Quietmirror/github/README.md

# Quietmirror · Fenrir / MiniSE R3.3（r3_3）

**当前版本：R3.3，版本标识 `r3_3`。** 本版将上一轮 L2 研究成果按 R3 系列目录公开归档，包含共用机械版、H 分体 PAW3950 示意版和 D ATK A1 Pro 供体示意版。

**[R3.3 全部下载与说明](releases/Fenrir-MiniSE-R3.3/README.md)** · [设计与验证报告](reports/rebuild_r3_3/README.md) · [可编辑源码](cad/rebuild_r3_3/README.md) · [本版记录](HISTORY_R3_3.md)

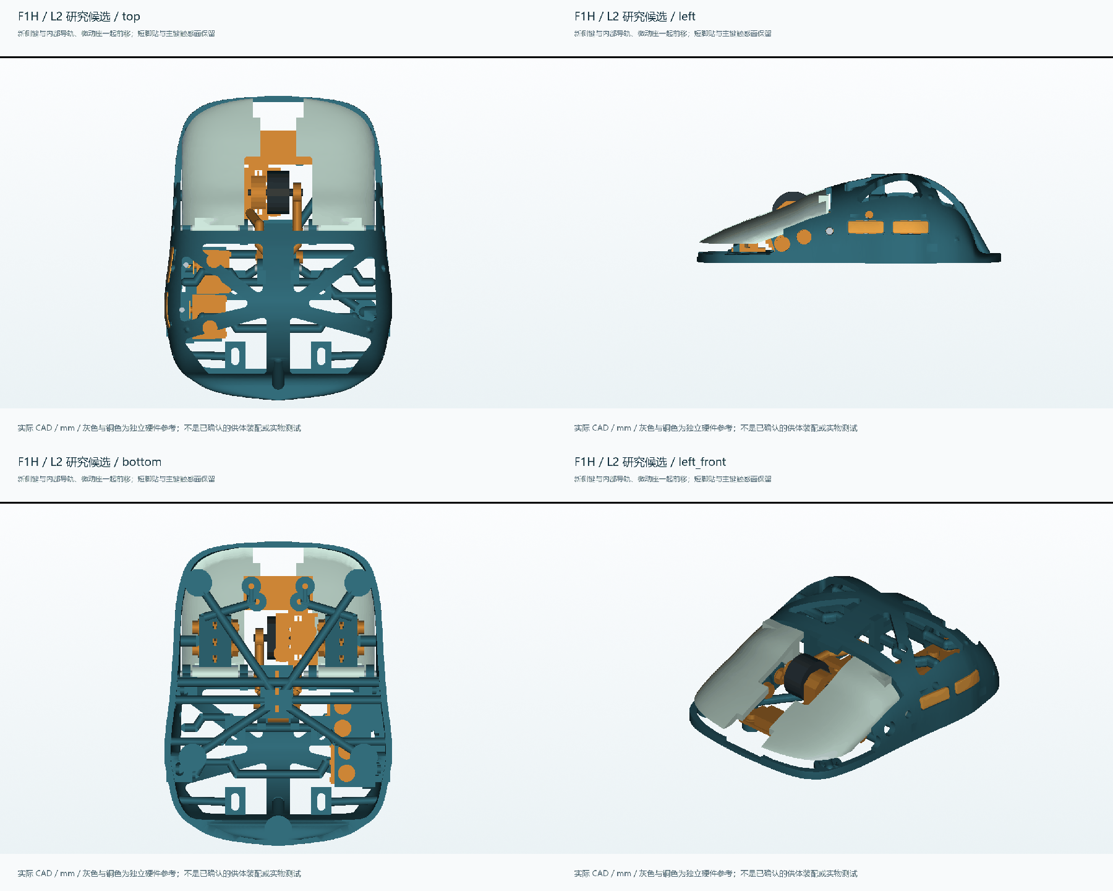
[picture p1: views/rebuild_r3_3/R3_3_FOUR_VIEWS.png]
R3.3 实际 CAD


| 内容 | 共用机械版 | H 示意版 | D 示意版 |
|---|---|---|---|
| 全部打印件 STL | [9 件 STL](releases/Fenrir-MiniSE-R3.3/R3_3_PRINT_STL.zip) | [11 件 STL](releases/Fenrir-MiniSE-R3.3/R3_3_H_EST_PRINT_STL.zip) | [11 件 STL](releases/Fenrir-MiniSE-R3.3/R3_3_D_EST_PRINT_STL.zip) |
| FreeCAD 装配 | [FCStd](releases/Fenrir-MiniSE-R3.3/FENRIR_MINISE_R3_3.FCStd) | [H FCStd](releases/Fenrir-MiniSE-R3.3/FENRIR_MINISE_R3_3_H_EST.FCStd) | [D FCStd](releases/Fenrir-MiniSE-R3.3/FENRIR_MINISE_R3_3_D_EST.FCStd) |
| STEP 零件 | [STEP](releases/Fenrir-MiniSE-R3.3/R3_3_STEP.zip) | [H STEP](releases/Fenrir-MiniSE-R3.3/R3_3_H_EST_STEP.zip) | [D STEP](releases/Fenrir-MiniSE-R3.3/R3_3_D_EST_STEP.zip) |
| 实际切片 3MF | [共用拼版](releases/Fenrir-MiniSE-R3.3/FENRIR_MINISE_R3_3_PLA_PRINT_PLATE.3mf) | [H 拼版](releases/Fenrir-MiniSE-R3.3/FENRIR_MINISE_R3_3_H_EST_PLA_PRINT_PLATE.3mf) | [D 拼版](releases/Fenrir-MiniSE-R3.3/FENRIR_MINISE_R3_3_D_EST_PLA_PRINT_PLATE.3mf) |

[两套转接件合板](releases/Fenrir-MiniSE-R3.3/R3_3_BOTH_ADAPTER_KITS_SINGLE_PLATE.3mf) · [源码 ZIP](releases/Fenrir-MiniSE-R3.3/R3_3_SOURCE.zip) · [验证报告 ZIP](releases/Fenrir-MiniSE-R3.3/R3_3_VALIDATION_REPORTS.zip) · [43 份研究历史和基准恢复包](releases/Quietmirror-L2-Research/history/README.md)

R3.3 沿用已生成的 L2 几何与检查结果，内部 F1H / L2_H_EST / L2_D_EST 编号保留用于追溯。**14.89 g 减重目标未达到，共用塑料理论质量 18.99951 g PA12；H 托架装入路径尚未通过；D 供体板型未知，估计测量板有 17 对干涉。** 真实点击、打印公差、板卡/镜头适配、无线 1K、宏、LOD、充电及续航未完成实测。完整边界见上方报告。

历史版本：[R3.2](README_R3_2.md) · [R3.1](README_R3_1.md) · [R3](README_R3.md) · [R2](README_R2.md) · [更早历史](HISTORY.md)。旧版本、原始 L2 报告与历史候选继续保留。

许可 [CERN-OHL-P-2.0](LICENSE)，保留[原署名](NOTICE.md)与[R3.2 署名](reports/rebuild_r3_2/NOTICE_R3_2.md)。
