Quietmirror/github/reports/V0.1_设计与验证报告.md

# Quietmirror 右手指握鼠标 V0.1 — 设计与验证

日期：2026-10-14。交付范围为可打印的一体式固定试握件及可编辑源文件；电子装配版尚未设计完成。所有图为真实 CAD/STL 或真实切片刀路的可视化。

## 试握假设与形态

用户提供的手部数据来自照片 AR 近似测量：腕到中指尖约230 mm，拇指尖到小指尖张开跨度约190 mm。后者不是掌宽或鼠标握宽。掌宽、指节长、自然握姿仍未知，没有补造数值，也未以手长驱动整体缩放。

| 项目 | V0.1 参数/实现 |
|---|---|
| 总长 × 最大外宽 × 高 | 90 × 62 × 31 mm，不含脚贴 |
| 有效夹持宽度 | 接触区中心目标约54 mm；两侧浅凹边缘更宽 |
| 左右主键 | 各24.4×40 mm连续浅凸面，球面R95；左顶31、右顶29.8 |
| 滚轮触感件 | Ø15×5.2，中心距前端15.5，顶点31；与骨架连接且固定 |
| 拇指区 | 长42×高19，中心距前端46、高13.6；浅凹R95 |
| 无名指/小指区 | 长46×高19，中心距前端46、高12.6；浅凹R110 |
| 两个侧键触感凸台 | 距前端33/47，高21.5，前后长10.5，中心距14 |
| 右侧防拖地托边 | 宽6、长34、厚2.8，外缘到X=31；圆角R1.2 |
| 后段 | 后部没有中央顶掌拱壳，最后约20 mm只保留最高约7.4 mm的低骨架 |
| 普通薄壁/边缘 | 法向壁厚1.8；接触外围加厚至2.4以容纳R1圆角 |
| 承力筋 | 三维筋Ø2.8；底框筋2.6宽×2.6高 |
| 接点局部加强 | 筋端埋入内侧小垫，局部总厚约3.9；不穿出主要指肚接触面 |
| 脚贴平台 | 5个Ø8.8，厚2.4，适配约Ø7–7.5圆点脚贴 |
| 传感器定位区 | 中心(0,-48)，14×18圆角开口及连续定位框；无假定安装孔 |

主键、侧键、滚轮、两侧面、五脚平台和所有骨架已经并成一个实体。主接触面没有减重开孔，开放区在接触面之间和下方。夹持面通过多根承力筋、内垫和连续底框传力；主键有三点支撑与侧向连接，滚轮有固定轴及成对支撑。

这是一体试握结构，固定支柱、轮轴和侧键连接不能作为后续真实开关或转轴机构直接使用。装配版需重新设计这些受力路径，同时保留足够刚度。

## 实际几何与网格检查

检查对象是最终保存后重新读取的 STEP/STL，不只检查建模内存对象。完整数值见 `validation.json`、`cad_metrics.json`。

| 检查 | 结果 |
|---|---|
| STEP / OpenCascade B-rep | 有效，1个实体 |
| STEP 外接尺寸 X/Y/Z | 62.000 / 90.000 / 31.000 mm |
| STL 连通分量 | 1 |
| STL 封闭/法向 | watertight=true，winding consistent=true |
| 自相交 | PyMeshLab 检测0个自相交面 |
| 边界边 / 非流形边 / 非流形顶点 | 0 / 0 / 0 |
| 网格孔洞 | 0；模型的设计开放窗口具有封闭的材料边界，不是网格破洞 |
| 网格面数 / 顶点数 | 179,008 / 89,462 |
| PrusaSlicer 读入尺寸 | X61.999168、Y89.999992、Z31.000000 mm |
| PrusaSlicer 流形 / 部件数 | yes / 1 |
| 主体CAD体积 | 14,704.307 mm³ = **14.704 cm³** |
| STL近似体积 | 14,694.744 mm³，与CAD相差约0.065% |
| 底部开放 | Z=0.2 mm截面，实体面积1007.26 mm²；相对XY外凸包4822.83 mm²，约**79.1%开放** |

STL 使用0.02 mm绝对弦差、0.15弧度角差细分；导出后只焊接约0.00001 mm尺度的数值重合点，移除重复/退化面，没有补网格孔、没有丢弃孤立部件、没有用自动修补掩盖断开结构。

**最薄壁核对：** 普通曲面区域由同心球面构成，设计法向厚度为1.8 mm。左右主键与两侧接触区共60点法向射线测量，最小1.7962、最大3.9090 mm；增加的厚度来自接点内垫等加强结构。最小值与网格细分误差相符。这是解析设计值加接触区抽样检查，**不是对任意圆角、交线和整个实体做连续全域最小厚度证明**。没有进行有限元或破坏载荷试验；正常夹持下的实际挠度仍应在首件记录。

**五脚共面核对：** 每个平台取中心与半径3.7 mm圆周上8点，共45个点，最终STL的安装面读数均为Z=0.000 mm。五个平台的CAD中心如下；底框也有Z=0底面，粘贴脚贴后由五个圆点抬高整件，不能把底框当成额外脚贴平台。

| 平台 | X | Y | 安装面 Z |
|---|---:|---:|---:|
| 1 左前 | -21 | -8 | 0 |
| 2 右前 | 21 | -8 | 0 |
| 3 左后侧 | -23 | -61 | 0 |
| 4 右后侧 | 25 | -63 | 0 |
| 5 尾部 | 0 | -85.6 | 0 |

打印翘曲、首层挤压和脚贴厚度误差不属于CAD共面检查；粘贴后需放平板检查是否摇晃。

## 参数与复现

长度、外宽、握宽、高度、左右键接触区、滚轮、两个侧键和传感器参考位置均由 `cad/parameters.json` 驱动；细节见 `cad/PARAMETERS.md`。参数Y为距前端正距离，导出后转成朝前为正的CAD坐标，避免左右手方向含混。

另做了一次邻近参数组合检查：长94、外宽64、高32、握宽56，同时移动主键、滚轮、侧键；得到有效单一实体及64×94×32外接尺寸。该检查未生成供打印的另一个版本，不代表所有参数组合都有效。当前交付默认值仍是90×62×31、握宽54。

## 打印与材料

打印姿态：**五脚贴安装面向下，100%比例，前端/左右方向不镜像。** 用PLA首轮试握，0.4 mm喷嘴、0.2 mm层高；4道周壁、20%填充、5层顶底。主要薄壁和细筋在该设置下基本由周壁/实心路径构成，降低填充百分比不会等比例减重。

支撑：从热床生成树状支撑，阈值45°，支撑顶部间距0.2 mm、XY间距0.35 mm、3层界面。支撑目标是两个主键底面、固定滚轮/轮轴、侧键凸台与托边下缘；4 mm外裙边帮助低框架贴床。实际支撑刀路见 `../views/09_slice_layers.png`。从大窗口去支撑时，保护本体Ø2.8承力筋，侧键/滚轮不掰动。

PrusaSlicer 2.9.6 的最终实际切片结果如下，PLA密度取1.24 g/cm³、线径1.75 mm；这些不是实物称重。

| 项目 | 估算 |
|---|---:|
| 模型本体刀路 | **18.528 g** |
| 支撑及支撑界面 | **13.476 g** |
| 裙边 | **0.265 g** |
| 切片器总耗材 | **32.27 g**，10.819 m，26.02 cm³ |
| 时间 | **4 h 11 min 19 s**（通用速度/机器约束下） |
| 几何体积×PLA密度 | 约18.23 g，用于与刀路估重交叉比较 |

刀路质量估算与几何体积×密度略有差异，受线宽、搭接和切片流量计算影响。总耗材包括支撑，不包含脚贴、胶、电子件或失败重打。耗时取决于真实打印机的加速度、限速和冷却。交付3MF附完整估算配置，并已在不外加载入INI的情况下重新切片核对；打印前仍应选择实际机型。

## 电子版前置条件

本轮已分别建立主板、传感器/镜头、滚轮/编码器、两侧键板、电池/插头、走线、USB-C、电源开关、天线等16个包络；除引用裸板外框外均为估计，全部位置待实测。主要冲突与后续尺寸表见 [电子包络与装配待测](电子包络与装配待测.md)。

PAW3950仅是传感器型号，不决定统一主板轮廓。2.4 GHz无线1000 Hz由主板、固件和匹配接收器共同实现。候选“ATK 蜻蜓 A1 Plus”的真实型号、传感器与板形尚未确认，没有替换成其他型号或假定其传感器为PAW3950。

首件完成后按 [试握反馈表](试握反馈表.md) 记录握宽、顶掌、手指拖地、滚轮/侧键触达和抬鼠稳定性。先修正握持几何，再获得真实电子尺寸并做装配版，之后逐轮减薄；本轮没有真实点击、回弹、传感器或无线功能验收。
