Quietmirror/github/reports/l2_revision/calculation_audit.md

# L2 基准与计算复核

当前读取 R3.2 的实际 STEP 和 STL，未把任务书数值当作新验证结果。

|零件|CAD 体积 mm³|PA12 理论 g|PLA 实心理论 g|
|---|---:|---:|---:|
|BODY|12801.728064|12.929745|15.874143|
|LEFT_KEY|1780.447791|1.798252|2.207755|
|RIGHT_KEY|1780.448016|1.798252|2.207756|
|SIDE_FRONT_KEY|167.916224|0.169595|0.208216|
|SIDE_FRONT_KEY_SWITCH_CLAMP|192.883541|0.194812|0.239176|
|SIDE_REAR_KEY|176.712184|0.178479|0.219123|
|SIDE_REAR_KEY_SWITCH_CLAMP|192.883541|0.194812|0.239176|
|WHEEL|823.761827|0.831999|1.021465|
|WHEEL_CARRIER|589.894911|0.595794|0.731470|

总计 18506.676100 mm³，PA12 假设密度 1.01 下 18.691743 g；PLA 假设密度 1.24 下 22.948278 g。均非含支撑的切片用量。
L2 目标需净减少 3764.102 mm³ / 3.801743 g (20.34%)。

七根理想圆柱梁毛体积 1544.045 mm³，未扣交叠，不是可删除净体积。

历史二维模拟缺少完整边界与网格定义，无法按任务书唯一复现。旧 6.6%/10.3% 刚度改善仅保留为待复核先导，不作 L2 强度证据。
原 CAD 孔轮廓已有 R0.85 圆角；按源多边形复算尖角联合面积 1301.271 mm²，二维 R0.85 内圆角后 1292.284 mm²。须与任务书的 1301.27 mm² 区别。

实际打印前还需公差小样、按键偏心/回弹、疲劳和真实硬件测量。
