Quietmirror/github/reports/l2_revision/FENRIR_SIDE_KEY_REDESIGN.md

# 顺形双侧键与内部机构

F1H使用F1低突出造型：接触面10.4×3.6mm、中心Y49/62、Z15.5、间隔2.6mm；母壳法向抽样最大突出约0.193mm。相对R3.2，面更低、更贴壳，长度稍增，前后位置各前移0.3mm；与任务书“细长低突出”路线一致。下方连续拇指面保留。F2E为10.4×4.0、约0.31mm突出、3°轮廓斜度的另一真实完整方案，保留研究文件。

微动、导轨、捕获销、夹条一起移动；不是单改键帽。导轨有效长度5.4mm，全行程最小啮合5.1mm，原参考约3.5mm。两键独立滑动0.60mm，接触轴线投影约0.58mm。实际开关自由高、预行程与过行程待测，0.02mm间隙不能作为普通FDM免调整承诺。

每键前/中/后1.5N有限元三网格，最弱位置刚度提高；部分旧后缘支点位置更硬，不能说每一位置均改善。约束为无摩擦双面导轨及刚性微动接触；真实偏心卡滞、回弹、磨耗需要实物。简化两导轨反力模型给摩擦/驱动力比例约2μe/L，取e约3.3mm、L5.1mm，μ0.1/0.2/0.3/0.4时约0.13/0.26/0.39/0.52；只是敏感性示意，μ未测且不覆盖毛刺/收缩/斜插。

两键直线X向装入各101位置通过。侧微动改从底部装入，前微动先、后微动后，然后后夹条先、前夹条后。完整18阶段有限采样通过。螺丝旋入、工具握柄和连续扫掠未完全证明；不能声称不存在任何真实装配冲突。
