Quietmirror/github/reports/l2_revision/HARDWARE_H_D_COMPATIBILITY.md

# H/D电子空间与功能边界

H首先实际试放从badjeff/paw3395-pcb读取外轮廓的15.45×28×1.6板包络，在原壳内失败，完整记录留在L2_H_REFERENCE_BOARD_BLOCKED。当前H改为**18×18×1.6自定义紧凑传感器板的设计需求**，这需要另做电路或找到已核实的板，不是宣称参考板已缩小适配、更不是已采购的半组装模块。RF/电池/天线/线束同样为估计。D仅提供可换载架与36×50×1.2空间测量板，绝不是实测ATK A1 Pro。

| 方案 | 未允许静态冲突数 | 底部直入支架采样通过 | 真实主板适配证明 |
|---|---|---|---|
| L2_H_EST | 0 | False | 否 |
| L2_D_EST | 17 | False | 否 |

完整干涉对与原生交叠体积在各版本static_checks.json，净空和支架路径在module_review.json。H当前最终姿态静态及按键有限运动采样通过；但从底部以及其余五个直线方向插入托架仍失败，须继续把支架拆为可连接小件或验证旋转装入路径。没有证明绝对无法装入，也没有伪称可装配。H天线净空内仍有约74.92mm³塑料托架和4.58mm³馈线；馈线本属必要天线连接，介质影响要按真实天线测试。D的17个未允许交叠全部涉及未知板测量块，其电池服务区也不通过。

旧通用耳的连接臂部分填回了名义槽孔，M2螺钉实放失败。新托架改为非永久的绝缘束带鞍座，不改动common壳；束带、PCB边缘固定和实际元件禁布区尚未验证。当前装配与3MF是研究示意，未知板不放行“已适配打印”。

PAW3950仅是传感器型号。400–6400DPI、2.4GHz1k、宏、LOD、五键、低延迟、无可选同步、充电和12h续航均需PCB/固件/接收器证据。保持原供电保护，不新加外部DPI或独立拨动开关；选定系统必须提供合适电源控制。

电池18×22×6是包络而非容量保证。按可用容量75%情景，300/400/500mAh要持续12h，平均电流上限18.75/25/31.25mA。最大功耗实测、截止电压、容量与温度均未知，不能宣称达标。光轴垂直鼠标垫；Z7.8镜头底、Z5.2脚贴面、0.5脚贴仅给出3.1mm示例光学间距，最终必须按真实镜头尺寸链调整。
