Quietmirror/github/cad/l2_revision/MASTER_SPEC.md

# Quietmirror R3.2 → L2 均衡轻量化版｜Codex 完整工程任务书

**制定日期：2026-10-16（合并本日下午 12:00 后全部讨论、计算、方案与后续约束）**  
**使用对象：已经构建 Quietmirror R3.2 的原 Codex 工作区 / GPT-6 Astra 或 GPT-6.1 Sol**  
**项目仓库：** https://github.com/Quietmirror/github  
**基准提交（截至本次重新读取）：** `f1b1090931d717117287ea2b79c2e14ddc234937`，`main`，R3.2  
**本文件定位：可直接执行的工程规格书 + 全部已知原始数据 + 复核协议，不是已完成的 R4 CAD 或三维有限元认证。**

> **给执行 Codex 的首要指令：** 继续当前本地工作区的项目，不要重新建项目。读取 Git 状态并同步/检查最新版本，保护所有尚未提交修改；如果本地版本已经领先于 R3.2，优先以最新可复现版本施工，同时保留对 R3.2 的独立对照。先独立审计本文件的所有计算、假设和参考资料，再建立/修改真实可编辑 CAD，进行第一次测试与独立第二次复核，修复后冻结通用壳体。随后分别构建 **H：半组装 PAW3950** 与 **D：ATK A1 Pro 供体** 两套内部模块，导出各角度外观、内部剖面/爆炸图、可打开的完整三维装配，以及每套**全部 PLA 塑料件一次打印**的真实 3MF/切片。不得将尚未取得的硬件尺寸与 2D 模拟当作实物适配或 3D FEM 已通过。

---

## 0. 最终统一决策（覆盖此前相互冲突的建议）

| 决策项 | 本次最终要求 | 性质 |
|---|---|---|
| 主要目标 | **L2 均衡版：全部塑料件约 14.89g（假设 PA12 密度 1.01g/cm³）** | 设计目标，不是已经实现 |
| 原版基准 | R3.2 共 9 个打印件、18.692g PA12 理论质量 | 仓库 CAD 体积推导 |
| 主要优先级 | **适配与安全 > 结构可靠 > 实际可打印/可装配 > 减重 > 视觉细节**；侧键自然性为必须改进的体验要求 | 设计规则 |
| 结构路线 | **Fenrir Pro 双侧键设计语言 + Puppy v3Air 开放骨架轻量化 + Quietmirror 现有原创外形**；吸收 Finalmouse、Zaunkoenig、WLmouse 的工程理念 | 参考方向，不复制商业 CAD |
| 顶部孔阵 | 先验证 **P1 原六孔等开孔面积圆角化**，再用真实三维 FEM 尝试混合拓扑与按受力路径扩孔 | 优先候选，不是最终结论 |
| 主体厚度 | 原 1.8mm 标称优先保留；只按 3D 验证结果决定局部 1.7mm 或更薄区 | 不得全壳统一削薄 |
| 按键厚度 | 主键原名义 2.0mm；局部研究 1.2–1.6mm + 合理筋，不保证 FDM 可行 | 要按扭转/偏心按压和疲劳验证 |
| 侧键 | Fenrir 风格上侧壁、细长、低突出、双独立按键；**外观与内部微动/导轨/安装座联合修改** | 强制修改 |
| 电子 H | PAW3950 传感器 + 独立 RF/控制板/按键与电池等半组装结构 | 估计尺寸待实测 |
| 电子 D | 用户指定 **ATK A1 Pro** 供体专用支架与原板装配 | **型号未核实，不可将 A1 Plus/A9 Plus/X1 Pro 当成 A1 Pro** |
| 通用性 | 两种电子路线尽量共用**通过二次验证的主壳、主键及侧键外形**，仅内部可拆卸适配件不同 | 以实际不干涉为前提 |
| 打印 | 每个电子版本的全部塑料件分别能在**一次 PLA 打印任务、一个平台、彼此分离**完成；若平台够大，再提供两套转接件合版 | 必须真实切片验证 |
| 整体模型 | 每版 `.FCStd` + 保留零件身份的完整装配 `.step`（可另给 `.glb`）；独立 STL/STEP、3MF | 禁止活动件整体布尔融合 |
| 参考中的 18g | Puppy v3Air 视频标题“轻至18g”，是否含电池/接收器/具体配置未知 | 不作为已核实的对标实测值 |
| 未来整机质量 | 若仅**假设**非塑料 10g，L2 整机约 24.89g；实际需按 H/D 分别列电子 BOM | 目标情景，不是成品重量 |
| 软件功能 | 2.4GHz 1kHz、宏、可设置 LOD；不添加用户不需要的 Motion Sync/其他可选同步；默认不增加鼠标外部 DPI 按钮，也不无故添加电源拨动开关 | PCB/固件可用性须另证；不得破坏电池保护/充电安全 |
| 保存历史 | 创建新分支/新版本，不覆盖 R3.2 及之前版本，不强推 main | 强制 |

**不要以 L1/L3 取代 L2。** L1（约16.49g）只是风险较低的备用候选；L3（约12.59g）是激进研究上限，只有在 L2 完成后有明显可行性才延展。不能为了接近 18g 整机或 14.89g 塑料的数字虚构强度与硬件适配。

---

## 1. 真实来源、可追溯状态及参考对象

### 1.1 Quietmirror 基准源

- 仓库首页：https://github.com/Quietmirror/github
- R3.2 报告：https://github.com/Quietmirror/github/blob/main/reports/rebuild_r3_2/README.md
- R3.2 参数：https://github.com/Quietmirror/github/blob/main/cad/rebuild_r3_2/parameters.json
- R3.2 设计元数据：https://github.com/Quietmirror/github/blob/main/reports/rebuild_r3_2/design_metadata.json
- R3.2 体积/壁厚审计：https://github.com/Quietmirror/github/blob/main/reports/rebuild_r3_2/thickness_volume_audit.json
- R3.2 原始切片：https://github.com/Quietmirror/github/blob/main/reports/rebuild_r3_2/slice_summary.json
- R3.2 构建复现环境：https://github.com/Quietmirror/github/blob/main/cad/rebuild_r3_2/ENVIRONMENT.md
- R3.2 四视图：https://github.com/Quietmirror/github/blob/main/views/rebuild_r3_2/R3_2_FOUR_VIEWS.png
- R3.1 → R3.2 侧键前后图：https://github.com/Quietmirror/github/blob/main/views/rebuild_r3_2/R3_2_SIDE_COMPARISON.png
- R3 原版硬件兼容性边界：https://github.com/Quietmirror/github/blob/main/reports/rebuild_r3/COMPATIBILITY.md
- R3.2 STL：https://github.com/Quietmirror/github/blob/main/releases/Fenrir-MiniSE-R3.2/R3_2_PRINT_STL.zip
- R3.2 STEP：https://github.com/Quietmirror/github/blob/main/releases/Fenrir-MiniSE-R3.2/R3_2_STEP.zip
- R3.2 FreeCAD：https://github.com/Quietmirror/github/blob/main/releases/Fenrir-MiniSE-R3.2/FENRIR_MINISE_R3_2.FCStd

上面“原版数据”是 **2026-10-16 R3.2 公开仓库中读取的值**。执行时必须校验本地构建值，而不是认为网页永远停留在此 SHA。强制记录当次 `git rev-parse HEAD`。

### 1.2 其他厂商/开源项目借鉴 —— 正确的分工

| 参考项目 | 可靠已知点 | Quietmirror 借鉴 | 不允许的误用 |
|---|---|---|---|
| **G-Wolves Fenrir Pro 8K** | 官方约 18.9g 整机、81.7×61.2×28.3mm、5键、PAW3955、最高8kHz | **首要外形参考：细长低突出双侧键、靠上排列、下方完整拇指夹持面；低前键与开放式受力框架** | 不虚构 Fenrir 原厂 CAD、内部微动坐标、外壳确切树脂牌号；不强行复制 8K 电子要求 |
| **Puppy v3Air** | 用户给的视频标题“轻至 18g 指握套件开源”；真实重量配置和内部组件尚待核验 | **首要减重参考：只保留指握/传力必要表面、开放支架、模块化触点、简化板件固定** | 不能把 v3Air、Puppy v3 与 Puppy V4 混为同一型号；不杜撰尺寸和材料 |
| **Puppy V4** | 公开发布的模块化指握思路 | 可更换拇指/小指接触区、不重新打印主壳也能试握 | 具体质量、主板、开源完整性未完整核实 |
| **Zaunkoenig M3K** | 极简指握、碳纤壳/专用 PCB，约24g有线配置，具体以官方页面核对 | **减电子板尺寸、减少冗余支架** | 有线产品不可直接作为无线整机重量基准 |
| **Finalmouse UltralightX** | 大面积开孔与复合材料/承力框架，型号间有侧壁不同方案 | **上壳局部开孔、夹持侧壁连续、非均匀加强** | 量产复合材料强度不能等同于普通 3D 打印 PA12 |
| **WLmouse Beast X Mini** | 镁合金大开孔轻量结构 | **大开窗 + 连续边框 + 局部加强的布局思想** | 镁合金不能直接代替 FDM/SLS 尼龙参数 |
| **Razer Viper Mini SE** | 长主键和低前键视觉语言 | **保持主键延伸、滚轮周围结构简洁** | 非主板兼容证明；R3.2 不是原厂 Mini SE CAD |

核对/参考链接：
- Fenrir Pro 官方：https://shop.g-wolves.com/products/g-wolves-fenrir-pro-8k-wireless-mouse
- Puppy v3Air 用户指定视频：https://www.bilibili.com/video/BV1BJd1BaExM/
- Puppy V4 视频：https://www.bilibili.com/video/BV1Nhj96zE24
- Puppy v3 模型：https://makerworld.com.cn/zh/models/2312877 （**不是 v3Air 文件已确认可替换**）
- Puppy v3 微动小板：https://oshwhub.com/zhuaobo/lei-bai-wei-dong-xiao-ban （**不是证明 v3Air 必然使用该板**）
- Zaunkoenig：https://zaunkoenig.co/
- Finalmouse：https://finalmouse.com/
- WLmouse：https://www.wlmouse.com/
- ATK 官方：https://www.atk.store/collections/mice

**关于相似度**：旧版 R3.2 与 Fenrir Pro 的长宽高接近度，在一个自定义“长宽高平均相对误差”公式下约 **91.8%**，**不是** 3D 造型或知识产权意义上的相似率；新的形态需有可靠参考图/许可数据才可比较侧视/俯视轮廓 IoU、归一化表面距离等，且应保留原创几何。

---

## 2. R3.2 精确质量/体积基准 —— 所有后续计算的出发点

### 2.1 尺寸、机械、状态

| 项目 | R3.2 值 | 重要限定 |
|---|---:|---|
| 长度 | 88.236mm | 原厂 Fenrir 81.7mm 经项目独立调整，并非原厂 CAD |
| 宽度 | 66.096mm | 最大外宽 |
| BODY 外包 Zmin / Zmax | 5.0 / 30.564mm | BODY 净高度约25.564mm，不要把 Zmax 当作底面起算高度 |
| 相对脚贴**粘贴面**最高点 | 25.364mm | 粘贴面 Z=5.2 |
| 主壳标称 skin | 1.8mm | 仅标称，不是所有位置真正局部壁厚 |
| 左右主键标称 skin | 2.0mm | 不可只按顶面厚度推主键刚度 |
| 脚贴平台 | 5个 × Ø8mm，厚1.6mm | 平台粘贴面共面 Z=5.2 |
| 示例脚贴厚度 | 0.5mm | 示例鼠标垫平面 Z=4.7；最小离地约0.299mm，**只是现有估计模型** |
| 估计镜头最低 Z | 7.8mm | 例子得到镜头距垫面 3.1mm，**不是经过真实 PAW3950 光学验证的可用工作距离** |
| 9件原始 PLA 切片 | 37.69g，4h54m57s | 包含支撑/裙边，PrusaSlicer2.9.6通用配置，不是塑料 CAD 实体质量 |
| R3.2 CAD 仿真 | 98实体/包络，4753对有限静态检查、各5键41位置、滚轮72组合等 | 不等于真实零件可靠、可注塑或稳定 1kHz |

### 2.1.1 现有壁厚审计中容易误判的数值

仓库 R3.2 壁厚审计不是全面实体最小壁厚认证；它通过外表面法向射线/局部弦长采样得到特定统计。原报告的示例数据包括：

| 部件 | 抽样5百分位 | 抽样中位数 | 最短抽样弦长 | 注意 |
|---|---:|---:|---:|---|
| BODY | 约1.542mm | 约2.240mm | 约0.013mm | 极小弦长常出现在曲率/边缘转接，**不代表确有0.013mm连续承力墙** |
| LEFT_KEY | 约1.463mm | 约1.815mm | 约0.759mm | 孔边与边缘小样本，不等于整体按键只有该厚度 |
| RIGHT_KEY | 约1.474mm | 约1.809mm | 约0.724mm | 同上 |

Codex 在动薄壁之前必须在真实 BRep 上完成局部真实壁厚分析、最小筋宽扫描与可打印路径检查；不能因为标称主壳 1.8mm，就假设所有位置都是 1.8mm；也不能把射线抽样最短距离直接当成结构失败。 

### 2.2 九个打印件逐件精确体积与 PA12 理论质量

密度假设：`rho_PA12 = 1.01 g/cm³`；`mass_g = volume_mm3 / 1000 * 1.01`。

| 独立打印件 | CAD 体积 mm³ | PA12 理论质量 g |
|---|---:|---:|
| BODY | 12,801.7281 | 12.9297 |
| LEFT_KEY | 1,780.4478 | 1.7983 |
| RIGHT_KEY | 1,780.4480 | 1.7983 |
| SIDE_FRONT_KEY | 167.9162 | 0.1696 |
| SIDE_FRONT_KEY_SWITCH_CLAMP | 192.8835 | 0.1948 |
| SIDE_REAR_KEY | 176.7122 | 0.1785 |
| SIDE_REAR_KEY_SWITCH_CLAMP | 192.8835 | 0.1948 |
| WHEEL | 823.7618 | 0.8320 |
| WHEEL_CARRIER | 589.8949 | 0.5958 |
| **总计** | **18,506.6761** | **18.6917** |

- 左右主键合计约 **3.597g**，是 BODY 之外第二大减重来源。
- 滚轮 + 载架约 **1.428g**。
- 两个侧键 + 两夹条约 **0.738g**。
- **两个夹条 + 滚轮载架单独为 975.662 mm³、约 0.985g**，不要将它们再计入 BODY 安装座的质量。
- BODY = 外表面 + 中央支撑 + 部分一体式安装结构的混合 BRep，不允许直接称“主壳表皮 12.93g”。

### 2.3 三档质量预算（**只以 L2 为主目标**）

| 方案 | PA12 塑料件目标 | 相对R3.2减重 | 精确等效应净削体积 | 质量下降 |
|---|---:|---:|---:|---:|
| R3.2 基准 | 18.6917g | — | — | — |
| L1 保守备用 | 16.49g | 2.2017g | 2179.94mm³ | 11.78% |
| **L2 均衡主目标** | **14.89g** | **3.8017g** | **3764.10mm³** | **20.34%** |
| L3 激进备选 | 12.59g | 6.1017g | 6041.33mm³ | 32.64% |

`V_L2 = 14.89 / 1.01 * 1000 = 14,742.574 mm³`。

**10g非塑料部件只是展示用占位假设**：R3.2约28.69g整机、L2约24.89g整机、L3约22.59g整机。必须给 H/D 两套电子分别实测或依据真实 BOM 列出主板、传感器、电池、USB、微动、编码器、螺丝、钢轴、脚贴与接收器（若接收器不在鼠标内，不能计入鼠标整机重量）。不能把“整机25g左右”写成已经验证。

### 2.4 L2 预算怎么分——先作为工程目标，不是已发现可删除体积

五个**互不重叠**的优化工作包：

| 工作包 | 相对R3.2目标减重 | 对应PA12净移除体积（约） | 改进策略 |
|---|---:|---:|---|
| A. BODY 外壳/顶壳、夹持侧壁、孔阵 | -1.00g | 990mm³ | 孔阵形态、非承力表面轻量化、保留连续夹持面 |
| B. BODY 中央骨架/横梁/斜撑 | -1.15g | 1,139mm³ | 减重复骨架、优化受力路径和梁截面 |
| C. BODY 内安装座 + 独立安装结构 | -0.55g | 545mm³ | 精简微动座/滚轮载架/PCB固定耳、模块化复用 |
| D. 两个独立主键 | -0.70g | 693mm³ | 主键背面减料、局部筋、保持铰链和按压手感 |
| E. 滚轮、侧键及其他剩余部件 | -0.40g | 396mm³ | 非高载荷冗余体积；不能削弱轮轴和侧键可靠性 |
| **总预算** | **-3.80g** | **约3,762mm³** | 只是预先分配；精确主目标为3,764.10mm³ |

**存在类别交叉风险**：例如滚轮载架属于“安装”而非“滚轮运动件”；真实最终质量账本必须按照下一节的互斥 BRep 分区，消除目标工作包与最终统计类别之间的重叠。若某项无法完成，允许从其他项补足，但不得虚构减重空间。L2 必须遵循刚度/应力/装配要求；不达标时以更重但可靠的模型交付，并解释原因。

### 2.5 材料替代的辅助质量对比（不能替代结构优化）

同一 R3.2 18.506676cm³ 的等实体几何理论换算：

| 材料 | 假设成品密度 g/cm³ | 当前R3.2理论塑料质量 | 注意 |
|---|---:|---:|---|
| PA12 SLS/MJF参考 | 1.01 | 18.69g | 主对照 |
| PA11 SLS参考 | 1.03 | 19.06g | 通常更有韧性，材料参数依品牌工艺 |
| PA12S MJF参考 | 0.98 | 18.14g | 须核实实际供应商材料密度与性能 |
| PP SLS/MJF参考 | 0.89 | 16.47g | 更轻但通常刚性较低，可能需要补厚 |
| PLA实体参考 | 1.24 | 22.95g | 不等于有空腔/填充/支撑的实际 FDM 耗材 |

候选还可研究 PA11-CF 与 LW-PLA；PA11-CF 并不保证同体积更轻，且连接筋、纤维方向和天线附近存在风险；LW-PLA 发泡可能牺牲薄壁和微动座可靠性。最终功能壳优先 PA12 / PA11，**PLA FDM 用于一板功能试装**。颜色优先黑白灰，避免无意义涂层重量。材料价格/可用性必须以具体供应商重新询价，不能引用过去的最低单价当当前订单最终价。

---

## 3. 顶部六孔：原始 CAD 数据、先导模拟和可靠性等级

### 3.1 六个原孔的全部主要坐标与切除体积

**Y 越小越靠前；X轴左右意义以实际 CAD 坐标核实；单位 mm。** 以下 XY 顶点为仓库 metadata 中报告的开孔投影顶点：

| 名称 | XY 多边形顶点 | 仓库记录的布尔去除量 mm³ |
|---|---|---:|
| ROOT_TRI_L | (-4.536,42.984), (-24.516,42.984), (-4.536,58.104) | 289.342 |
| ROOT_TRI_R | (4.536,42.984), (24.516,42.984), (4.536,58.104) | 292.126 |
| SHOULDER_TRI_L | (-27.864,45.360), (-7.344,60.696), (-28.512,65.664) | 476.223 |
| SHOULDER_TRI_R | (27.864,45.360), (7.344,60.696), (28.512,65.664) | 540.192 |
| REAR_TRAP_L | (-3.348,63.936), (-27.756,70.740), (-20.304,80.568), (-3.348,80.568) | 795.726 |
| REAR_TRAP_R | (3.348,63.936), (27.756,70.740), (20.304,80.568), (3.348,80.568) | 813.954 |
| **数值求和** | — | **3,207.563mm³** |

**重要：** 3,207.563mm³ 是源报告各切除操作记录值之和，不直接等于六孔的净减重，也不代表顶部真正实体区域总质量（存在开孔与其他移除空间交叠、曲率和布尔先后影响）。必须在真实 BRep 进行基准与无孔实体的布尔差重新计算。

### 3.2 历史二维有限元代理模型——可供交叉检查，不能直接充当3D强度结论

先前研究的输入：矩形代理面板 **62×41mm = 2542mm²**；真实六孔投影联合面积约 **1301.27mm²**；余下平面面积 **1240.73mm²**；假设统一厚度 **1.8mm**；`E=1700 N/mm²`、`ν=0.37`、`ρ=1.01g/cm³`，约 `0.5mm` 二维 CST 三角单元。研究区质量：

`m = A * t * rho / 1000 = 1240.73 * 1.8 * 1.01 / 1000 ≈ 2.25565g`。

此 **2.256g 只是研究面板的二维面积×厚度，不是曲面顶部真实 CAD 体积或 12.93g BODY 的细分重量**。

求解方法：平面应力 `D=E/(1-ν²)*[[1,ν,0],[ν,1,0],[0,0,(1-ν)/2]]`；常应变三角形刚度 `K_e=t*A*(Bᵀ D B)`，整体 `Ku=f`，在加载边规定方向平均位移下 `k=F/|u_mean|`。分别模拟一个前/后缘约束加载和侧缘约束加载，每种用总载荷1N。**这些简化边界条件不代表真实双侧相向拇指夹紧、顶部竖向弯曲或实际安装点约束**。

| 先导方案 | 孔数 | 后缘代理刚度 N/mm | 相对原版 | 侧缘代理刚度 N/mm | 相对原版 | 面板质量 g | 真实中央预留兼容性 |
|---|---:|---:|---:|---:|---:|---:|---|
| P0 原六孔 | 6 | 67.1588 | 100% | 129.1477 | 100% | 2.25565 | 已有几何基准 |
| **P1 等面积六孔圆角化** | 6 | **71.5698** | **106.57%** | **142.4690** | **110.31%** | 2.25565 | 最有希望继续三维验证 |
| 12孔规则蜂巢 | 12 | 74.9434 | 111.59% | 314.1020 | 243.21% | 约2.256 | 侵占中央潜在保护带、孔筋较细，**不可直接采用** |
| 6个等面积圆孔 | 6 | 100.2442 | 149.27% | 346.3293 | 268.16% | 约2.256 | 侵占中央潜在保护带，**不可直接采用** |
| 纵向圆角槽组 | 代理输出与说明存在“8槽/6孔”不一致，须复核 | 89.2880 | 132.95% | 279.2720 | 216.24% | 约2.256 | 侵占中央潜在保护带、需重建可行布局 |
| 12孔圆角蜂巢 | 12 | 74.9002 | 111.53% | 314.0761 | 243.19% | 约2.256 | 同样存在中央保护带冲突 |

P0/P1 P99 von Mises 应力代理比较：

| 工况 | P0 P99 MPa | P1 P99 MPa | 变化 |
|---|---:|---:|---:|
| 后缘载荷 | 0.35535 | 0.33796 | 约 -4.9% |
| 侧缘载荷 | 0.27820 | 0.25529 | 约 -8.2% |

P1 的两个面内刚度分别上升 **约6.6% / 10.3%**；**同开孔面积、同厚度，本身几乎不减重**。模型中孔型刚度排名若与真实三维结果不一致，优先采用新的可靠三维复算并分析原因。

#### 3.2.1 局部 1.7mm 敏感性测试

P1 后基于“双工况低应力、距孔边>1.5mm、距板缘>2.25mm、避开中央保护带”等条件筛选约 **16.36% 代理板网格**，从 1.8 降至 1.7mm：

- 后缘代理刚度 `71.2006 N/mm`（仍较 P0 高约6.0%）。
- 侧缘代理刚度 `141.4576 N/mm`（仍较 P0 高约9.5%）。
- 代理质量 `2.25565 → 2.23507 g`，**净减约0.02058g**。

这只是局部二维研究，**不足以解释 L2 所需的3.80g 减重**。不要将“局部1.7mm 已经验证可打印”作为结论。

#### 3.2.2 历史“直接扩大原孔”粗筛（保留以防重复失败，不作正式定案）

| 线性扩孔 | 历史估计PA12减重 | 原代理后缘刚度保留 | 侧缘刚度保留 |
|---|---:|---:|---:|
| +3% | 约0.14g | 约66% | 约80% |
| +6% | 约0.29g | 约50% | 约64% |
| +10% | 约0.50g | 约31% | 约43% |

这些旧数值的具体重叠/留筋边界没有作为最终可复核 3D CAD 结论保存。**Codex 必须独立复算；若无法复现，撤回这些数字而不是包装成真实仿真。** 策略含义是不要简单把六孔全部放大来碰重量目标。

### 3.2.3 以前生成过的先导图（非正式 CAD，单个 MD 已包含理解它们所需的数值）

之前的分析产生过 `Quietmirror_R3_2_Hole_Patterns.png`（六孔孔型对比）、`Quietmirror_R3_2_daily_use_optimization.png`（P0/P1/局部厚度二维模拟）、`Quietmirror_R3_2_PLA_180mm_plate_concept.png`（原九件180×180mm矩形占位草图）以及 `quietmirror_panel_study.json`（先导结果）。这些文件如果在当前 Codex 工作区可获得，可以用于对照；**若只复制本 MD，不必依赖这些图也应能够从上文坐标、方法和数值重新创建。** 文件名不代表图中方案已经完成 BRep、3D FEM、打印机实测或 A1 Pro 适配。最终必须使用新的 CAD 渲染覆盖旧概念图。

### 3.3 顶部真实 CAD 候选集合（必须做等体积与等刚度两组）

| 代号 | 真实 CAD 候选 | 优先级 | 几何约束 |
|---|---|---|---|
| P0 | 原三角 + 梯形六孔 | 基准 | 不修改 |
| **P1** | **六孔圆角过渡，R1.0 / R1.3 / R1.5mm 候选** | **首选** | 孔投影等面积或材料等体积、保留关键净筋宽 |
| P2 | 顺受力路径的三角网格 | 研究 | 不伤微动座与主键铰链 |
| P3 | 局部蜂巢，仅非承力/非安装区 | 研究 | 保持中央禁切区及清粉路径 |
| P4 | 大圆角孔或局部短槽组合 | 研究 | 不占用 PCB/天线净空，不产生断筋 |
| P5 | 定向椭圆槽 | 研究 | 注意不同方向刚度与外壳曲率 |
| P6 | 六孔圆角 + 非均匀加强筋/拓扑混合 | **重点次选** | 三维受力路径驱动，不为追逐网孔密度而牺牲安装区域 |

对每种方案：**真实 CAD** → 检查孔洞/薄筋尺寸 → 固定材料体积对比刚度（等质量）→ 固定必要刚度与承载条件优化减重（等强度/等刚度）→ 实物打印可制造性检查。禁止只输出二维示意图。

---

## 4. 正常鼠标使用受力、壁厚、截面与疲劳分析

### 4.1 正常工况起始值（可编辑假设，需真实工程复核）

| 工况编号 | 使用场景 | 初始载荷假设 | 真实施加载荷要求 |
|---|---|---:|---|
| LC1 | 左/右主键单独点击 | 1.5N 每键 | 实际手指触点、键帽全行程及铰链反力 |
| LC2 | 前/后侧键点击 | 1.5N 每键 | 对每键前端、中部、后端分别施力，沿真实手指方向 |
| LC3 | 正常双侧夹持 | 总相向力4N | 真实拇指/无名指或小指接触片，必须是相向力 |
| LC4 | 上背部/上壳压按 | 5N | 一定大小的接触斑块，非单顶点力 |
| LC5 | 手持移动/局部扭转 | 2N + 对应非对称力矩 | 建立抓握、抬起与脚贴接触几种可能状态 |
| LC6 | 滚轮滚动/中键按压 | 从对应点击、轴向载荷另定 | 轮轴、编码器、微动座和载架共同参与 |
| LC7 | 取放/拆装 | 按部件装配需要定 | 螺丝柱、捕获销、PCB支架与电池托拆装局部压力 |
| LC8 | 偶发误压/挤压 | 15N | **单独**做余量研究，非正常日常点击 |

- 所有数值是**前期工程占位假设，不是已测量人类手指力标准**。Codex 应搜索可靠试验或合理建模资料，不能推测为厂商推荐额定值。
- 每组做 `0.5× / 1.0× / 1.5×` 灵敏度；必要时评估 2× 日常峰值。使用不同材料批次与工艺方向的变动分析。
- 约束必须模拟真实抓握点、脚贴、塑料—PCB—钢轴连接、微动安装及接触条件，不能仅把模型某整条边固定而称为日常鼠标测试。

### 4.2 局部梁弯曲示范——完整计算过程

假设简支局部桥梁（**不是从实际 R3.2 抽取的真实梁**）：

- 跨度 `L = 18 mm`，宽 `b = 3 mm`，中心垂直载荷 `F = 3N`，PA12 示意弹性模量 `E=1700MPa`。
- 矩形截面惯性矩 `I = b t³ / 12`。
- 最大弯曲应力 `sigma_max = 3 F L / (2 b t²)`。
- 中点挠度 `delta_mid = F L³ / (4 E b t³)`。
- 同宽同长质量 `m ∝ t`，弯曲刚度 `EI ∝ t³`。

| 厚度t mm | 最大应力 MPa | 中点挠度 mm | 相对1.8mm截面质量 | 相对1.8mm刚度 |
|---|---:|---:|---:|---:|
| 1.5 | 12.000 | 0.2541 | 83.3% | 57.9% |
| 1.6 | 10.547 | 0.2094 | 88.9% | 70.2% |
| 1.7 | 9.343 | 0.1746 | 94.4% | 84.2% |
| **1.8** | **8.333** | **0.1471** | **100%** | **100%** |
| 2.0 | 6.750 | 0.1072 | 111.1% | 137.2% |

`1.8→1.6mm` 的等面积减重仅 **11.1%**，该示意模型应力上升 **约26.6%**、挠度上升 **约42.4%**。因此：**禁止把完整 BODY 统一削薄为1.5/1.6mm**，尤其不可削弱主键转轴、侧键导轨/捕获销、微动座和螺柱周边。

另一个简单的质量估值公式：`Delta_m_g = area_mm2 * thickness_removed_mm * rho_g_cm3 / 1000`。
- 额外真正切除 `500mm² × 1.8mm` 的有效壳面，理论省 **0.909g PA12**，但前提是该壳面真实存在且净体积全被删除。
- `1000mm²` 壳面 `1.8→1.4mm`，理论省 **0.404g PA12**，但不能据此宣称刚度通过。
- 圆截面梁 `d2.6→2.4mm`，面积比 `(2.4/2.6)²≈0.852`，质量约省 **14.8%**；同梁惯性矩比 `(2.4/2.6)^4≈0.726`，弯曲刚度约损失 **27.4%**。

### 4.3 需要搜索的局部壁厚范围（不是审批尺寸）

| 几何区 | 当前/参考 | 新候选范围 | 使用条件 |
|---|---|---|---|
| 主体名义皮厚 | 1.8mm | 默认保留1.8，低应力局部先试1.7；极低应力非结构面可研究1.1–1.4 | 必须经 3D FEM、制造公差、变形和实物验证；FDM版通常单独保持更厚 |
| 指握夹持侧壁 | 1.8mm 标称 | 1.4–1.7mm 仅作候选 | 拇指/右侧夹紧承力，保留连续面、不盲开孔 |
| 开窗边框/筋 | 源CAD提取 | 1.5–2.0mm起始探索 | 结合筋高/截面方向/圆角，不能只看平面宽度 |
| 受力连接节点 | 源CAD提取 | 1.8–2.2mm局部增厚候选 | 允许局部增重换总体更轻，避免尖角应力集中 |
| 主键非承力背部 | 顶皮标称2.0mm | 1.2–1.6mm局部开孔/筋候选 | 重点优化主键约3.60g，检查边缘按压扭转/手感/回弹 |
| 侧键、微动/轴/螺柱座 | 源CAD提取 | 按真实界面与工艺最小尺寸确定 | 不得强行套用1.1/1.4mm或损坏捕获销 |

没有可靠材料许用应力/安全系数或网格收敛时，不宣布减薄已安全。对独立悬臂、卡扣和螺纹柱还需装拆及疲劳/磨损实验，普通线弹性 FEM 不等于循环寿命证明。

### 4.4 真正的3D FEA验收

优先调用现有 FreeCAD FEM / CalculiX / Gmsh / CadQuery 参数构造/适合的 3D 求解工具：

1. 按实际零件/材质与真实接触、约束、载荷点建模；刚度计算 `k = F/δ` 记录观察点定义。
2. 模型至少包含 BODY、与受力相关的主键、侧键、轮轴及**真实有载荷贡献的**支撑/装配件。PCB 被视为承力件时，需要实测板厚/FR-4参数/固定边界/焊点承载，否则不能拿 PCB 当无限刚性梁。
3. 所有候选使用一致的网格策略、材料参数、约束、载荷和接触设置。
4. 关键部位执行不少于 3 级网格细化或报告数值收敛区间；局部约束点高应力不可靠时，报告网格依赖和P95/P99趋势及危险位置。
5. 报告整体质量、各关键观察点位移、等效刚度、峰值/95/99百分位应力、连接孔边缘与卡扣热点、最大薄筋尺寸及破坏/屈曲疑点；对打印各向异性、温湿度、材料公差做敏感性研究。
6. **L2选型门槛**：日常主要工况下刚度目标原则上不劣于可复现R3.2；关键局部应力与变形没有新不可接受热点；所有电子/机械装配和可打印性门槛通过。若无法满足，不能为了数字私自接受不可靠设计。
7. 缺少可用 3D FEM 求解器必须标记 `3D_FEM_BLOCKED`，做梁/壳代理计算及可复现待测脚本，**绝不输出虚假 3D FEM 云图或“已验证安全”**。

---

## 5. 中央骨架、安装结构与准确分区：L2 的主要减重区域

### 5.1 当前骨架精确已知的设计特征

**三根横梁：**

| 中心位置Y,Z | 直径 | 报告跨距 |
|---|---:|---:|
| (54,23) | Ø2.4mm | 54.0903mm |
| (67.5,23) | Ø2.4mm | 51.9717mm |
| (40.8,6.6) | Ø2.6mm | 58.3053mm |

**四根斜撑：**

- `(-23.22,12,6.5) → (0,46,6.5)`, Ø2.6mm
- `(23.22,12,6.5) → (0,46,6.5)`, Ø2.6mm
- `(-24.84,62.64,6.5) → (0,46,6.5)`, Ø2.6mm
- `(24.84,62.64,6.5) → (0,46,6.5)`, Ø2.6mm

按无交叠圆柱的理想公式 `V = Σ π d² L /4`，七根梁毛体积此前估算约 **1544 mm³**，约 **1.56g PA12 毛质量**。**此值尚未扣除与 BODY 外壳、节点及互相之间的交叠，不得作为 B 类净质量，更不可以直接全数删除。** 由源码提取精确实体和布尔归属后重新计算。

**已有四个 PCB 估计固定耳：** `(+/-27.331,43,9.5)`、`(+/-28.604,66,9.5)`；M2 槽宽约2.4mm、长4mm。它们仅是通用安装耳，非供体实际孔位。

### 5.2 骨架候选 B0–B4

- **B0**：原三横梁、四斜撑，保持全部节点。
- **B1**：局部圆截面变径，慎用：质量按 `d²` 降低，但抗弯按 `d⁴` 降低。
- **B2**：定向椭圆/矩形/腹板截面，把更多材料布置在实际主要弯曲方向；同时复核另一方向抗扭/弯曲损失。
- **B3**：三角桁架与壳体边框融合，避免重复承力路径。
- **B4**：按真实3D载荷非均匀混合骨架，减少中央冗余，保留必要节点圆角和 PCB 安装缓冲。

历史截面对照（理想单梁，需二次复算）：Ø2.6mm圆梁为质量/双向刚度100%；Ø2.4圆梁质量约85%、双向弯曲刚度约73%；1.8×2.8mm竖放矩形梁质量约95%、竖向弯曲刚度约147%、横向约61%；1.6×2.8mm竖放质量约84%、竖向约130%、横向约43%。**不是整体鼠标刚度结果**，不能四根梁全换立放矩形而不考虑另一个方向。

### 5.3 安装结构候选

重新检查左右微动座、两个侧键微动与导轨、两枚侧键夹条、主滚轮载架/编码器座、USB口安装板、四个PCB固定耳、传感器板/镜头框、电池托/保护区、天线净空、钢轴/捕获销/螺丝柱。

- 保留微动承压表面、钢轴孔、导轨耐磨面、捕获销端壁、PCB螺钉承压面。
- 不为省 0.1g 牺牲安全可靠，不能靠胶水把电池不可拆地粘在柔性壳体上。
- 审计能否采用**不同电子方案共用的安装基座 + 可拆卸小转接件**，而不是两套重叠大底架。
- 滚轮载架 CAD体积 `589.895 mm³`，约0.596g；两个侧夹条各 `192.884 mm³`，约0.195g；三件独立约0.985g。即使三件净减20%，理论只有约0.197g，不是 L2 3.8g 主来源。
- 考虑让 PCB 适度参与整体约束，但前提是有真实板卡机械性能、孔位、板弯曲/焊点/元件避让、螺丝预紧和可维护性；否则只当安装对象，不视为已验证承力板。

### 5.4 **严格互斥**的质量统计体系（解决今天多次讨论的分类）

对 BODY 内 fused 几何通过 BRep 构造历史、布尔分割或区域功能归属，实现三个互不重叠集合：

- `A_BODY_SKIN`: BODY 顶部、侧壁、周边外壳非专用安装体。
- `B_BODY_SKELETON`: BODY 横梁、斜撑、三角节点及主要结构筋。
- `C_BODY_MOUNTS`: BODY 一体式微动座、固定耳、螺丝柱、接口固定实体。

必须 `A_BODY_SKIN + B_BODY_SKELETON + C_BODY_MOUNTS = 12801.7281mm³`（容差说明明确）；对于优化版，三者也必须合计等于该版实际 BODY体积。不能有交叠或体积凭空缺失。

其余分件另计：
- `C_SEPARATE_MOUNTS`: 两个侧夹条 + WHEEL_CARRIER + 未来真实可打印内部安装件；R3.2基准=**975.662mm³**。
- `D_MOVING_OTHER`: LEFT_KEY、RIGHT_KEY、SIDE_FRONT_KEY、SIDE_REAR_KEY、WHEEL；R3.2基准为其他件剩余体积。

于是整套打印件 `A+B+C_BODY+C_SEPARATE+D = 18506.6761mm³`；报告总类别 **A、B、C（合并 C_BODY+C_SEPARATE）、D**；所有类别报告体积、PA12理论质量、PLA理论实体质量和净减重；电子/电池/螺钉则另列非塑料 BOM。这样既满足“外壳、中央骨架、安装结构分别衡量”，又不重复计算滚轮载架和侧键夹条。

---

## 6. Fenrir Pro 风格双侧键：必须与此次轻量化同时完成

### 6.1 R3.2 旧侧键实际状态

| 项目 | R3.1旧版 | R3.2当前版 |
|---|---:|---:|
| 前侧键触感中心 Y | 50.0 | **49.3mm** |
| 后侧键触感中心 Y | 65.0 | **62.3mm** |
| 触感面长度 | 10.0 | **9.4mm** |
| 触感面高度 | 5.0 | **4.6mm** |
| 两键中心距 | 15.0 | **13.0mm** |
| 可见间隙 | 5.0 | **3.6mm** |
| 触感面外侧 X 向偏置 | — | **+0.45mm** 相对母壳 |
| 名义滑动行程 | 0.60 | **0.60mm** |
| 原内部微动中心Y | 前50/后65 | **仍前50/后65** |
| 标称开口间隙 | — | 0.30mm |

历史 R3.2 通过有限几何装配模拟，但**后侧键必须先Y -0.30mm偏移插入、再回到设计位置、最后装捕获销**，说明结构较敏感；真实打印回弹、偏心卡滞和使用寿命均未验证。

### 6.2 明确的设计目标

以 Fenrir Pro **上侧壁、细长、紧凑、低突出度、与侧壳上缘趋势协调**的侧键为主要视觉参考：

1. 保持侧键下方**连续拇指夹持面**，抬手、夹紧和快速甩动不轻易误触。
2. 外触感面沿**局部曲面法线**拟合原壳，突出度初步探索 0–0.35mm；不要只测全局 X 向偏置。
3. 两键适当倾斜、轻微曲率变化、圆角轮廓，在侧视、俯视、斜视都自然融入外壳。
4. 两个按键依然为**独立运动的五键系统中的两颗侧键**，绝不能为了“视觉统一”把两键做成相连不可按或相互驱动。
5. 设计**F1 Fenrir Flush**（外观接近齐平）及**F2 Fenrir Ergonomic**（在相同工业设计语言下改善自然触达、防误触），必要时研究视觉一体、内部独立的连续双键操作区。
6. 不再将 R3.2 微动中心Y50/65视为锁死。允许一起改变微动位置/朝向、短传力臂、滑舌、导轨、止挡、捕获销、局部加强筋/开窗、侧键 PCB 安装。
7. 仔细核对触感面相对于微动的偏心力矩，前端、中段、后端按压是否卡滞、侧键行程/空隙/过压及回弹；不能用 0.02–0.03mm 的名义触点间隙宣称普通 FDM 可直接制造。
8. 不复制 Fenrir Pro 未公开的原厂微动几何或商业 CAD，仅从公开图片学习外部设计语言。

F1/F2 各输出完整键帽+微动+导向的可编辑三维结构，并以外观/防误触/真实按压/可打印/安装空间/重量择优。**侧键不能只修改一张效果图而不更新导轨和内部安装座。**

### 6.3 左右主键、滚轮与 MiniSE 风格约束

- 保留长主键延伸、滚轮后方相对自然的主键过渡、低前键/低背指握设计；不要回退到主键明显过短的历史版本。
- 允许对主键底面大面积非承力实心料重新开窗、作不等厚和筋，前提是两键端部偏心点击、轴孔、铰链与微动触发稳定性均通过。
- 滚轮保持滚动与中键点击两项独立功能，保留编码器/轴/微动安装路径，不能为了减重做只有外观不能滚动的假轮子。
- 五个脚贴座、光学通道、USB/电池可拆装仍需正常保留。

---

## 7. 两套内部电子内容组件：共用壳与可替换转接件

**实施顺序是先执行第一轮CAD优化与独立第二轮校验，再冻结通用壳体，最后开展两套内部适配。** 切勿为适配一个未经测量的主板提前削弱已验证的骨架。

### 7.1 H：HALF_ASSEMBLED_PAW3950（半组装分体方案）

以原历史仓库“估计包络”初始化，但**所有尺寸都是机械空间假设，不代表市场上已有按此尺寸销售的完整模块**：

| 子组件 | R3仓库初始估计/预留（mm） | 必须实测/验证 |
|---|---|---|
| PAW3950 传感器板 | 18×18×1.2 | PCB真实长宽厚、孔位、元件凸起、引脚 |
| RF/MCU 控制板 | 18×18×1.2 | 实际无线方案、USB/电源线路、接收器兼容 |
| 传感器封装参考 | 8×8×2.4 | 选定具体 PixArt 料号资料 |
| 传感器镜头参考 | 12×14×4 | 镜头型号、光学工作距离与 Z 基准 |
| 传感器空间 | 中心约(0,66,9.7)，盒18×18×9 | 真实传感器板需重新定位 |
| 电池 | 18×22×6 | 实际容量/质量/保护电路/线束方向 |
| 电池服务净空 | 19×23×7 | 并非 LiPo 安全膨胀认证，不能挤压 |
| 电池插头 | 5×6×3 | 类型、极性、拆装可达 |
| 侧键板 | 1×30×4 | 按真实微动更换孔/焊盘与接线 |
| 编码器参考板 | ≤12.2×15.1×1.2 | 实物轴高/六角尺寸/脚距/供电 |
| USB-C 参考板 | 20×10×1 | 充电管理、安装孔/线缆、插拔力 |
| 无线天线 PCB | 8×4×0.8 | 真实布局、馈电、天线匹配 |
| 天线局部净空 | 12×8×5 | 受金属、PCB、电池影响需 RF 测试 |
| 历史电源拨动开关占位 | 8×4×3 | 用户当前不要求单独外部开关；不可破坏电池保护或供体系统电源控制 |

软件功能：**2.4GHz 1kHz**（不要求8k）、左右键/中键/两侧键、宏、LOD设置、低延迟、可有线充电/连接；尽量关闭/不采用不需要的 Motion Sync 或其他可选同步策略；不要求独立物理 DPI 切换键。注意 PAW3950 只是传感器，**不自动提供无线接收器/宏/充电/固件**。必须给具体供应商/PCB/固件依据，不得“模型放得进”就写“1k功能验证通过”。

参考开源硬件：
- PAW3395/3950 模块：https://github.com/badjeff/paw3395-pcb
- PAW3950 ZMK 驱动：https://github.com/badjeff/zmk-paw3950-driver （含非完全开源二进制驱动依赖风险）
- ESB无线 ZMK：https://github.com/badjeff/zmk-feature-split-esb
- Olliebella指握参考：https://github.com/badjeff/olliebella （其基础版键数不一定满足双侧键要求，不可视为即插即用方案）

务必独立验证传感器+镜头到鼠标垫的真实**机械工作距离**。对于 R3.2 实际基准：示例脚贴0.5mm、粘贴面Z5.2，鼠标垫在Z4.7，估计镜头底Z7.8，距离3.1mm仅是初始示例，不能直接判断可正常寻迹。镜头/板高度需按实际推荐的传感器基准重做。

### 7.2 D：ATK_A1_PRO_DONOR（供体模块方案）

**重要阻塞：用户提出“a1pro”；旧仓库只有 `ATK A1 Plus` 的不可装入估计矩形板诊断，不能无提示换成 A1 Pro，也不能替换成 A9 Plus、X1 Pro、R1 Pro。**

先确定：产品官方完整型号/购买页面或鼠标底部铭牌、板卡拆解照片、PCB 尺寸、固定孔、传感器中心、真实镜头高度、左右/侧键和编码器位置、USB/电池/天线位置。若信息不足：

- 生成 `ATK_A1_PRO_UNVERIFIED.json` 占位和待实测清单；设计共用底座上**参数化可替换的供体支架和定位槽**，不能拿未经测量的 PCB 装上去声称适配成功。
- 明确标记 `DONOR_ID_UNVERIFIED`、`PCB_GEOMETRY_UNVERIFIED`、`FIT_NOT_CERTIFIED`；缺少真实尺寸时不放行打印为“已适配 A1 Pro”。
- 如供体含独有的光学微动、固定侧键板或 USB 接口，不能擅自删掉器件，也不能未经授权切断 PCB、取消电池保护、剪断天线或破坏可逆性。
- 真正供体若比可用空间大，输出干涉体积/受限位置/代价清单，优先维护共用外壳的受力路径；不能虚报适配。

### 7.3 H/D 结构共享策略

- 共用：经过第二次复核的 `COMMON_SHELL`、主键/外形、Fenrir 双侧键基本造型、五个脚贴平台、必要承力框架。
- 可换：传感器/无线板支架、供体PCB托、微动高度转换件、侧键电路适配、USB座、编码器/电池/天线固定件。
- 共用结构不要求两个模块所有板位都相同；**若极端情况下供体实测真实外廓无法与通用壳兼容，明确报告并请求是否允许独立外壳分叉**，不得悄悄牺牲安全与力学结论。
- 两版电子装配分别列 **每个打印件与每个购买件的 BOM**（体积、理论重、实测重状态、是否可逆拆卸、供应商型号、固定件和公差）。
- 不要默认把裸PCB作为有充分刚度的全局支撑梁；除非有实际板材数据、焊点/固定孔可靠性和验证结果。

---

## 8. 单次 PLA 打印 + 整体三维装配的强制交付

### 8.1 具体要求

**“一次打印”定义：一个打印机工作台、一次切片/一次打印 G-code，所有需打印的塑料零件各自独立摆放（可以放旁边），打印后无需切开工作机构，能够按照说明组装。** 不等于把整只鼠标所有活动零件融合成一个不可运动的 STL。

分别需要：

1. `HALF_ASSEMBLED_PAW3950_ALL_PARTS_SINGLE_PLATE.3mf`：共用零件 + H 专用转接件，**真正切片**。
2. `ATK_A1_PRO_ALL_PARTS_SINGLE_PLATE.3mf`：共用零件 + D 适配件，**真正切片**；缺供体实测时清楚标注“只是占位/样机拼版”。
3. `BOTH_ADAPTER_KITS_SINGLE_PLATE.3mf`（**仅当真实床面允许**）：共用零件 + H/D 两套转接件同板，分别独立打印。
4. 所有零件独立 STEP、STL，每个模型带明确部件名、装配方向/材料标识、必要的支撑清理区域。
5. `FULL_ASSEMBLY_H.FCStd`、`FULL_ASSEMBLY_D.FCStd`，以及各自完整 `.step`（组件保留，不熔合）；可选单一 `.glb` 或可视化 `.3mf` 用于旋转查看。

**平台关键事实：** R3.2 原版仓库 PrusaSlicer 排布的最大 X 坐标约206.84mm、Y约142.84mm，并未证明原来的排布适用于180×180mm。今天做过另一张“180×180mm 重新拼版占位草图”，它不是可打印的 G-code，也没包含两套新支架。Codex 需用最新 STL 实测包围盒+支撑/裙边后，针对真正的打印机平台重新自动排布。

如果学校机器是 Dremel 3D45 或其他 Prusa/Bambu 设备，应使用实际确认的设备型号、有效床面、喷嘴、材料/温度、风扇、支撑生成方式。**不得把180×180草图当作实际设备已通过验收。** 若平台容不下单套所有件，则必须报告事实、尝试合理旋转/排布/支持策略，在不偷偷缩放模型的前提下提出需要多大打印床，不能虚称“一板通过”。

### 8.2 FDM PLA 切片基础

- 先沿用历史 `0.4mm 喷嘴 / 0.2mm 层高 / 4道外壁 / 20%填充 / 适当支撑` 作为**可更改基线**，绝不是对每个细小零件的唯一正确配置。
- 各零件寻找兼顾强度与支撑量的方向；主壳及弯曲筋的打印方向对层间强度影响必须记录。
- 检查首层、薄壁刀路、滑舌、轴孔、螺丝孔、微动接触面、滚轮六角孔是否真实产生合理挤出路径。
- 明确算出 **净塑料件 PLA 质量、支撑质量、裙边/边框质量、总耗材、单次时长和各层清空空间**。PA12 理论质量不等于 PLA G-code 用量。
- 记录每个 `.3mf` 对应切片器版本/打印机/材料配置，并保存可复现结果；允许可选生成 `gcode`，但只有选定/核对实际打印机后才能认为可直接上机。
- 小样优先试打印：侧键行程/导轨间隙、轴孔、微动座、薄筋、五个脚贴平面，若某一打印工艺不满足公差，必须设计调整公差或修孔说明。

### 8.3 CAD 图像与工程装配展示

对 H、D 两个方案分别从实际 CAD 渲染以下图：

- **六面正交视图**：前、后、上、下、左、右。
- **四个斜轴测角度**：左前、右前、左后、右后。
- **拆去顶壳内部图**：传感器/镜头、PCB、主/侧微动、编码器、USB、电池、天线和线束；用颜色图例区分区域，但不代表实际打印颜色。
- **重要剖面**：Fenrir侧键及微动/导轨剖视；主键轴/触点；滚轮载架；传感器至脚贴/鼠标垫光路高度；电池容纳与维护取出路径。
- **爆炸图与编号 BOM**：零件装配顺序、紧固件/钢轴/电子件位置、必要的修孔/后处理说明。
- **对比图**：R3.2 vs L2 顶视/左右侧视/底视，P0–P6孔型同尺度对比，F1/F2侧键对比，B0–B4骨架对比，首次与二次核验后的 CAD 差异。
- **打印工作台布局图**：H 单版、D 单版、如可行两套合版，图上注明实际打印平台、支撑区边界和每件标签。

**图必须来自真实 CAD 文件，而不是 AI 概念图。** D 型号缺少真实主板时，图中应醒目标注 `PCB PLACEHOLDER / DIMENSIONS UNVERIFIED`，不得展示为“已验证原装 PCB 安装”。

---

## 9. 具体执行顺序：必须二次核对数据真实性后才继续建模

### Gate 0：工作区与基准保护

1. 读取 `git status`、最新提交、当前历史构建脚本、版本目录、真实打印文件；保存/隔离本地脏修改，创建 feature 分支。
2. 复现 R3.2 并比较 BRep/STL/STEP、九件体积、主壳外包尺寸、脚贴点、原有按键机构与切片信息；生成 `BASELINE_R3_2_AUDIT.md/json`。
3. 记录所有材料常数和载荷的可靠来源，区分 **CAD精确值、按密度推导、2D代理结果、工程目标、公开厂商声称、实测、未核实**。

### Gate 1：先行数据审计（不要直接接受本文件的模拟结论）

1. **独立重算**九件质量之和、L2目标体积、工作包预算、六孔布尔净移除量、2D孔投影面积和局部面板质量。
2. 重新实现或独立校核二维代理；复算 P0/P1 的两个载荷刚度、P99 应力、P1局部1.7mm变化。说明网格离散、边界条件、实体/二维模型差异。
3. 原则上用第二套独立脚本/方法交叉验证；如果与旧值不一致，调查网格离散、圆角“等面积”的实施方式、薄壁裁剪误差、重复扣料等并修正。
4. 对之前标称“提高6.6%/10.3%”作出证据等级结论：如果只能复现2D，报告“2D代理改善”，不得宣称 3D 成品改善。
5. 核实 Fenrir/Puppy/Finalmouse/M3K/WLmouse 公共资料真实性、称重口径、材料；不能将厂家标称重量等同于本鼠标可达到的整机重量。

### Gate 2：多个 CAD 真实候选与 L2 结构优化

1. 将 A/B/C/D 结构严格分区并建立体积账本。
2. 在固定主体关键尺寸与电子禁切区的条件下，建立 P0–P6孔型、B0–B4骨架、局部厚度区与左右主键背面方案。
3. 对每一种候选进行**等体积刚度比较**和**满足刚度/强度约束时减重比较**；不要一开始同时全组合爆炸，而是先筛选单变量，再组合优势候选。
4. 同时生成 Fenrir F1/F2 **含真实内部机构** 的两个侧键候选，联合验证新的母壳镂空与微动座。
5. 对重量接近14.89g的候选进行真实3D FEM/可打印/安装验证；选 Pareto 最优（轻、强、可用、可维护）。
6. 目标没有可靠达到时给出最接近且过门槛的实际版本，保留失败候选与其真实原因。

### Gate 3：独立二次工程审核、修正与冻结

**这是用户明确要求的第二次审计，必须区别于第一次测试。**

- 使用不同分析脚本/不同验证方法，再计算体积、相交/接触、网格封闭、自相交、BRep有效性、薄筋最小尺寸、孔边局部强度。
- 侧键分别检测前/中/后偏心按压力、按键沿真实微动轴线的动作位置和过行程；滚轮转动与中键、左右键完整运动范围；真实可行装入/拆卸路径，特别检查 R3.2旧后侧键需 Y-0.30mm 偏置的机械问题是否改善。
- 进行真实3D刚度/位移/应力第二轮校核，网格收敛与约束变动灵敏度，检查 0.5×、1.0×、1.5× 工况。
- 检查脚贴 Z=5.2/Ø8mm、底面最低 Z、裸壳是否触垫、USB开口、镜头/传感器估计光路、电池和天线禁切区。
- 审核最终材料和打印方向的薄壁风险、卡扣/螺柱/轴孔可靠性与疲劳试验需求；所有 FEM 不足以替代打样。
- 审核所有关于性能、相似度、重量的语句；没有实测的数据一律标记假设/目标。
- 若复核失败必须**修改真实 CAD、重新构建、重新检查、重新出图**，不能只改文档声明“已修复”。
- 只有所有**可测的关键门槛**通过后才记录 `COMMON_SHELL_REVIEWED`（附 commit/SHA/完整报告）。不能把待实测电子接口写成该门槛已通过的内容。

### Gate 4：冻结通用外壳后的两种内部模块

- H 分体PAW3950：真实或参数化布局传感器板、RF控制板、USB、双侧键微动/主键、编码器、天线、电池/保护与线束；完整装配/布线/拆装；供体不存在时用明确标注的估计占位并列实物待测。
- D ATK A1 Pro：先核实完整型号和板型；有实测才锁定孔位/接口并发布 fit-verified。无实测就提供可替换支架、占位演示、`missing_dimensions.md`/`donor_template.json` 和干涉矩阵，不得声称已适配。
- 对两种内部模块都重新跑安装与电子包络干涉。若必须改变 common shell 的载荷路径，撤销冻结状态，返回 Gate 2/3 重审。

### Gate 5：打印、全角度视图、BOM、交付

- H 一板全部塑料件、D 一板全部塑料件，若可行两组专用配件合一板；真实切片/支撑/净距/零件打印顺序；不缩尺。
- 导出完整可编辑工程、装配 STEP、逐件 STEP/STL、3MF、全部指定视图、内部结构图、剖面/爆炸图、装配顺序与可复现运行命令。
- 完整对比 R3.2 vs L2 common vs H/D 最终塑料总质量 + 非塑料估计质量 + 实测状态，不混淆树脂和 PLA 材料质量，不混淆鼠标内件和独立接收器。
- 保留 R3.2 不覆盖，提交独立分支/本地提交；未经授权不强推 main、不删除历史参考文件/署名。

---

## 10. 预期文件目录（可按现有仓库习惯调整，但功能必须完整）

```text
releases/Quietmirror-L2-<revision>/
  COMMON_SHELL_REVIEWED.FCStd
  FULL_ASSEMBLY_H.FCStd
  FULL_ASSEMBLY_D.FCStd
  FULL_ASSEMBLY_H.step
  FULL_ASSEMBLY_D.step
  ALL_PARTS_H_STL.zip
  ALL_PARTS_D_STL.zip
  ALL_PARTS_H_STEP.zip
  ALL_PARTS_D_STEP.zip
  HALF_ASSEMBLED_PAW3950_ALL_PARTS_SINGLE_PLATE.3mf
  ATK_A1_PRO_ALL_PARTS_SINGLE_PLATE.3mf
  BOTH_ADAPTER_KITS_SINGLE_PLATE.3mf   # 仅实际切片通过时
cad/l2_<revision>/
  parameters.json
  build.py
  topology_candidates/
  side_key_candidates/
  donor_h.json
  donor_a1pro.json                     # 缺尺寸须带UNVERIFIED标记
  cad_partition.py
  fem/
  print_layout/
reports/l2_<revision>/
  BASELINE_R3_2_AUDIT.md
  ORIGINAL_CALCULATION_SECOND_REVIEW.md
  MATERIALS_AND_LOAD_CASES.md
  A_B_C_D_VOLUME_BUDGET.csv
  TOPOLOGY_WALL_THICKNESS_STUDY.md
  FEM_CONVERGENCE_AND_FAILURES.md
  FENRIR_SIDE_KEY_REDESIGN.md
  SECOND_PASS_REVIEW.md
  HARDWARE_H_D_COMPATIBILITY.md
  DONOR_A1PRO_MISSING_MEASUREMENTS.md
  PRINT_SLICING_VALIDATION.md
  BOM_AND_ASSEMBLY_INSTRUCTIONS.md
  FINAL_COMPARISON_R3_2_L2_H_D.md
views/l2_<revision>/
  R3_2_VS_L2_TOP_LEFT_BOTTOM.png
  P0_P1_P2_P3_P4_P5_P6.png
  FENRIR_SIDEKEY_F1_F2_INTERNAL_SECTION.png
  SKELETON_B0_B1_B2_B3_B4.png
  A_B_C_D_EXPLAINED.png
  H_six_orthographic_and_four_isometric/
  D_six_orthographic_and_four_isometric/
  H_INTERNAL_SECTION_EXPLODED.png
  D_INTERNAL_SECTION_EXPLODED_UNVERIFIED_IF_NEEDED.png
  H_SINGLE_PLATE_LAYOUT.png
  D_SINGLE_PLATE_LAYOUT.png
```

**完整装配 `.step` 必须包含独立标识的活动零件、PCB占位、微动、传感器、电池、金属件；不能通过把所有东西融合成一个静止多边形网格来蒙混。** 供体缺少实物几何时，完整装配仅能作为明确标记的机械演示/占位装配，不能冒充已发布的可制造电子配件。

---

## 11. 最终结果必须输出的表格和验收问答

### 11.1 质量/强度对照模板

| 版本 | A壳体 g | B骨架 g | C安装 g | D活动打印件 g | PA12总塑料 g | 相比R3.2净减 g | 关键工况位移/刚度 | 状态 |
|---|---:|---:|---:|---:|---:|---:|---|---|
| R3.2 精确审计 | 待互斥分割 | 待互斥分割 | 待互斥分割 | 待按定义归属 | **18.6917** | 0 | 必须重跑 | CAD基准 |
| P1等面积圆角版 | 实际CAD | 实际CAD | 实际CAD | 实际CAD | 实际CAD | 实际CAD | 3D测试值 | 候选 |
| 最优L2 common shell | 实际CAD | 实际CAD | 实际CAD | 实际CAD | **目标≈14.89** | 目标≈3.80 | 3D测试值 | 审查后方能冻结 |
| H PAW3950含转接件 | 实际CAD | 实际CAD | 实际CAD | 实际CAD | 实际CAD | 净改动 | 重新检查 | 实测/未验证分开 |
| D A1 Pro含转接件 | 实际CAD | 实际CAD | 实际CAD | 实际CAD | 实际CAD | 净改动 | 重新检查 | 供体尺寸待核验 |

另列每件非塑料 BOM：板、镜头、电芯、微动、编码器、接收器（若外置标注）、电池连接线、充电口、螺丝、钢轴、脚贴、实际重量/估计范围/来源；分别计算两种变体整机重量范围。

### 11.2 验收的强制问题

1. 当前 R3.2 九件体积与18.6917g基准能否独立复现？版本 SHA 是多少？
2. 本文 2D 刚度改善6.6%/10.3%能否复现？如果不同，具体误差来自哪里？不能算作3D刚度。
3. 哪一种**真实可制造**孔型在等质量下最强？在约束下最轻？
4. A 外壳、B中央骨架、C安装、D其他打印件分别多少 mm³/g，净减多少？加总是否严格闭合？
5. 哪些区域最终允许小于1.8mm？是否分别通过实际FEM和PLA刀路/尼龙制造公差？
6. R3.2主键约3.60g能优化多少？边缘点击、行程与回弹是否受影响？
7. Fenrir风格两侧键外观是否自然、拇指夹持面是否完整、偏心按压是否不卡滞、装入路径是否简化？
8. H PAW3950半组装各板的真实尺寸是否找到？镜头工作高度、充电、无线1k、宏和LOD哪些只是目标？
9. D ATK A1 Pro 的**确切供体型号**是否核实？若没有，哪些数字不能宣称通过？
10. 二次独立审查发现了什么问题？实际修复了什么CAD几何？哪些失败或未验证残留？
11. H 和 D 每套全部塑料件是否**真正**在一个 PLA G-code/3MF平台通过切片？平台尺寸、支撑、耗材、用时是多少？两套配件合板是否可行？
12. 交付的 FCStd、STEP、STL、3MF 能否打开，按键是否保留独立活动件？全部工程图是否直接来源于该CAD？
13. 最终 L2 是否达到约14.89g塑料件？若没达到，真实可信、满足强度的最优重量是多少？
14. 说明实际整机重量计算方法以及为何不能把竞品标称18.9g当本机实测目标。

### 11.3 禁止的“伪完成”

- 只输出好看的图片，不改可编辑 CAD。
- 用以前 R3.2 的静态通过报告替代新几何的重复测试。
- 把二维平面代理刚度当作完整3D实际鼠标强度。
- 把原始切除操作体积求和直接当作净减重。
- 把BODY全部当作外壳表皮，或把骨架/安装座质量重复计入。
- 在没有实测 PCB 时把 A1 Plus / A9 Plus / X1 Pro 改名为 A1 Pro 并声称兼容。
- 为通过碰撞检查，隐藏真实元件、缩小电子占位或删除必要微动。
- 为减重，破坏电池保护、天线、镜头光路、滚轮、侧键或可拆卸性。
- 用平台概念排布图冒充已实际切片的 PLA 单板。
- 为强行达到14.89g 而无视结构强度、FDM薄壁路径或相互干涉。
- 擅自覆盖旧版本、无保护地重写 main 或掩盖失败记录。

---

## 12. 一键给 Codex 的最终行动摘要（本文件正文就是完整要求）

**现在立即执行，而不仅是回复计划：**

1. 在现有项目中确认代码/模型版本、保留旧版、读取并复现 R3.2。
2. 独立复核本文件全部计算和证据等级，把有误或不可靠的历史先导结果剔除。
3. 按日常鼠标载荷分别优化原顶部六孔、变壁厚、中央骨架、BODY内安装座、左右主键和其他分件；以 **L2约14.89g PA12塑料件**为研究目标而非强制假结果。
4. 将侧键**真正改为 Fenrir Pro 风格**，参考 Puppy v3Air 的开放骨架和模块化理念，同时参考 Finalmouse、Zaunkoenig、WLmouse，避免复制任何未公开原厂 CAD。
5. 完成真实CAD候选、有限元/简化模型和制造可行性测试；对选定综合最优版执行**独立二次核对并实际修复 CAD**，完成通用壳体审查。
6. 在已审核壳体上分别建造 **H PAW3950 半组装** 与 **D ATK A1 Pro 供体** 两套内部电子安装结构；缺供体数据要清晰标记，不准虚报真实兼容。
7. 为 H 和 D 分别生成**全部PLA打印零件一次性同板、彼此独立排列**的真实 `.3mf` 和切片报告；平台容积允许时再提供两组转接件的合版。
8. 两个版本分别生成带完整零件身份的**整体 `.FCStd`、STEP 装配模型**、逐件STL/STEP、所有六面/斜角/内部/剖面/爆炸图、实际可核对的 BOM 和装配步骤。
9. 输出 R3.2→L2 的质量、刚度、实际错误修复、两套电子装配进展、PLA拼版和所有未解决阻塞项；创建新版本/分支，保留整个历史，不未经确认强推 main。

**验收标准：真实减重、真实受力路径、自然可操作的 Fenrir 双侧键、两套明确区分且不伪造兼容的内部配件、完整装配模型、经过实际切片的单板 PLA 可打印工程。**
