Quietmirror/github/reports/rebuild_r2/DESIGN.md

# R2 设计思路与后续接口

本轮从分享记录中的 `rebuild/fenrir-minise-r1` 未验收快照继续。它是一次新的 Fenrir 参考重建，不是把旧 V0.9 改名。旧版本完整保留；本轮不沿用旧模型的通过结果。

## 外形与结构

独立 BSpline 母面按名义 81.7 × 61.2 × 28.3 mm 的比例放大 8%，主壳目标长宽高为 88.236 × 66.096 × 30.564 mm。此尺寸来自分享记录的布局选择，不是从近似 AR 手部数据推导的最优人体尺寸。模型没有使用原厂 CAD、受限扫描或商标装饰。

MiniSE 方向体现在实心独立主键、中央滚轮通道、后部大尺度三角/梯形窗口。上下曲面同源，侧面保留连续接触带。外围窗口、左右主键和五脚位置按中线组织；侧键和内部编码器/开关/连接器安装是有意不对称，不能将完整硬件装配宣称为严格轴对称。

主键宽度参数为 23.8 mm；当前实体经边界与轮槽裁切后的实际横向包络为 22.700 mm，完整纵向包络为 40.465 mm（包含后端铰链）。参数值和裁切后的实体尺寸不能混用，详见 `cad_metrics.json`。本轮继承的是新 R1 的按键分区，不再以旧 V0.9 的 23 × 27 mm 键面作为锁定接口。

五个 Ø8 mm 平台底面均为 Z=0。整段 Z=0–5 mm 除五脚允许圆柱外不放打印材料。Z>5 mm 的横筋、斜筋和局部中键座组成连续受力路线，没有新增低位底板。内部斜筋是实际侧载计算暴露过软问题后补入的结构；它们按编码器引脚的下压轨迹绕行，不能在以后的减重中随意删除。

## 与早期 R1 相比

| 问题 | 本轮处理 |
|---|---|
| 主键/托架/微动包络互穿 | 按 D2F 真正的偏置作动点重排，主微动倾斜安装并下移，键背加局部作动凸台 |
| 固定支座与滚轮组相撞 | 重新搭建载架、轮轴、编码器座、中键微动座和真实引脚通道 |
| 侧微动能放在最终位置却难以装入 | 固定下座 + 可拆上压条，定义有顺序的分步装入路径 |
| 侧键捕获销周边过薄 | 扩大舌部和导框，销孔端部保留约 1.6 mm 材料；背面止挡凸台限定名义行程 |
| 主键缺口后方 0.6 mm 残片 | 缺口延伸穿过键尾，去掉残片，不改变主键外侧最大宽度 |
| 前侧框架形成刀刃薄边 | 去掉主键开口前段的上部残边，保留低位前框 |
| USB / 传感器槽被后续布尔合并回填 | 调整接口位置并在最终合并后再次切通真实孔槽 |
| 仅有合法 STEP、STL 缝边不明确 | STEP 重导入后按绝对 0.025 mm 弦差网格化，单独检查 STL；不补洞、不丢弃离散实体 |
| 仅静态位置验证 | 增加带硬件的点击、滚轮、USB 插入和分步安装检查；给出离散证据的边界 |

## 壁厚如何解释

普通母壳名义壁厚 1.8 mm，主键采用 2.0 mm 的竖向内移表面，主要圆筋直径约 2.4–3.2 mm，脚柱直径 5.2 mm。圆曲面竖向厚度并不等于所有位置的法向厚度。孔边、圆角、止挡、小轴和交界处也不适用“整件最薄 1.8 mm”的说法。

`thickness_volume_audit.json` 对每个实际 STL 使用固定种子的面积采样、向内法线射线及相对表面法向筛选，保留最短样本的位置。它包含边缘渐薄和小接口，不是全局最小壁厚证明。小六角 1.67 mm、钢轴承孔附近和轮架连接仍需优先试印。强度计算只覆盖 BODY 主壳，不会自动证明全部活动件、螺钉承压、PLA 六角或层间疲劳通过。

## 电子版的边界

分享记录将本轮电子板适配放在机械样机之后。因此新 R2 提供五枚微动、编码器、USB-C 参考、四个通用 M2 长槽支耳和传感器/光路量规；没有伪造 ATK A1 Plus PCB、PAW3950 主板、电池或 RF 的实测数据。旧 V0.9 的 ATK 与自主板两个估计场景继续保留在历史目录，不能直接继承为 R2 装配。

| 后续需测 | 要取得的数据 / 原因 |
|---|---|
| 用户称为 ATK 蜻蜓 A1 Plus 的供体 | 确切型号、传感器版本、PCB 外轮廓/厚度、正反面高度、定位孔与原接收器；不能预设它就是 PAW3950 |
| PAW3950 半组装方案 | 实际板型、传感器/镜头基准、固件和匹配接收器；传感器名称不规定板子尺寸 |
| 传感器/镜头 | 板到镜头、镜头到鼠标垫的完整尺寸链，工作高度与真实 LOD 范围；当前 18 × 18 × 9 mm 只是预留量规 |
| 滚轮/编码器与微动 | 供货图、端子形态、板安装方式、实际 PT/OP/OT 和轮轴配合 |
| 电池/插头/走线 | 电芯实际外形、保护板、膨胀/装配余量、插头插拔方向、线径与弯曲半径；还没有建已验证的电池架 |
| USB-C/电源开关 | 实际连接器、充电板孔位、螺钉头/压持结构、开关行程与拨钮位置；当前开口不代表充电电路已实现 |
| 天线净空 | 主板厂商要求的无金属区域、方向、接地/电池距离，以及握持后的实际 RF 测试 |

光轴应垂直鼠标垫。平台底面为 CAD 的 Z=0；如果贴上厚度 t 的脚贴，镜头对鼠标垫的实际高度会多出 t，还必须加入板、镜头及安装件的基准偏移，按真实镜头规格确定，不能照一个通用数字固定。

400–6400 DPI、2.4 GHz / 1000 Hz、宏、LOD、五键与滚轮、低延迟、无可选 Sync 增强、开关、充电和至少 12 h 满性能续航仍是电子版目标。无线 1 kHz 依赖主板、固件和匹配接收器。电池容量应按实测满性能平均电流与可用容量比例计算：`容量 mAh ≥ 平均电流 mA × 12 h / 可用比例`；没有电流测量就不宣布续航达标。

## 外部建模软件

推荐继续用 FreeCAD 做实测硬件的装配约束和局部细化。本轮已经实际生成并重开核对 `.FCStd`。它保存命名实体和硬件参考，可编辑 BRep；参数化历史在 Python/JSON 源码里，不是假称导入 STEP 后自动恢复草图特征树或已求解的装配关节。

现在所有新工程、工具、缓存和求解证据保存在 `D:\Projects\Quietmirror`。无需在游戏过程中前置 FreeCAD GUI；本轮生成、渲染、切片和求解均使用后台程序及受限线程。
