Quietmirror/github/reports/v09/ELECTRONICS.md

# V0.9 电子配置、检查与待完成接口

两种方案仍是估计包络，未取得供体 PCB 实测数据，不是假定 ATK A1 Plus 使用 PAW3950。

## 与机械试按配置的区别

电子场景明确省略 5 个 TRAY、5 个 RETAINER、1 个 DETENT_LEAF，共 11 个试验夹具。留下9个塑料外形/活动件、5个示例开关位置和13个电子实体包络。省略件完整列在 layout.json；完整20件机械套件仍保留。**最终PCB/开关固定、轮轴与编码器耦合、中键下压兼容接口均待设计，电子场景没有可用的最终安装结构。**

## 本轮布局调整

滚轮轴由Z15.5降到13.0 mm；ATK估计主板的轮体让位改为贯穿厚度的概念切口，这不是实测供体轮廓。真实供体没有相应避让时必须换布局或板型，不能据此切割已装配主板。电池20×24×6 mm尺寸不变，中心D55前移至D53.5避开降矮的后壳。ATK主板估计36×50×1.2 mm尺寸不变，中心Z降至5.4 mm，并调整传感器/镜头示意高度；不意味着供体可以任意移动元件或切板。传感器光学尺寸链尚未成立。编码器4×6×7 mm包络降至X=-10.9、D=14、Z=9.5 mm，轮轴耦合未完成；侧键板移至X=-20、D=61.5、Z=10.3 mm。自制板方案保留分板概念。电源拨杆从示意壳体让位孔伸出，二者没有实体体积重叠。

## ATK_A1_PLUS

静态实体相交：0；电子实体对保留机械件的静态和8个非零行程位置检查通过（阈值0.01 mm³）。这只说明本组估计包络的排布，不保证实际零件能装入。

天线预留区与电子实体的相交：未发现超过阈值的相交。预留区不能替代真实天线厂商净空要求或射频测试。

其他净空是用途包络：电池维护区包含电池和插头，USB插头区包含接口；ATK光学区目前也包含估计主板与传感器的一部分，不能据此认定光路已畅通。线束盒未布真实导线、未求弯曲半径或拆装轨迹。

[布局检查](ATK_A1_PLUS_layout.json) · [六类参考净空](ATK_A1_PLUS_clearances.json)

## PAW3950_CUSTOM

静态实体相交：0；电子实体对保留机械件的静态和8个非零行程位置检查通过（阈值0.01 mm³）。这只说明本组估计包络的排布，不保证实际零件能装入。

天线预留区与电子实体的相交：未发现超过阈值的相交。预留区不能替代真实天线厂商净空要求或射频测试。

其他净空是用途包络：电池维护区包含电池和插头，USB插头区包含接口；光学区包含镜头包络，但仍未完成真实镜头到鼠标垫的尺寸链。线束盒未布真实导线、未求弯曲半径或拆装轨迹。

[布局检查](PAW3950_CUSTOM_layout.json) · [六类参考净空](PAW3950_CUSTOM_clearances.json)

## 包络与功能目标

主板、传感器和镜头、编码器、侧键板、电池和插头、USB-C、充电区、电源开关分别建模。六个独立净空块覆盖电池拆装、天线、光路、USB 插头与左右线束走廊，保存在各自 CLEARANCES STEP。线束走廊只是预留空间，不是布线结果；与端点部件相交需要结合用途解释。主键和侧键的活动空间另用实际活动 CAD 检查。

| 功能 | 目标 / 当前状态 |
|---|---|
| 分辨率 | 400–6400 DPI；待主板与固件实现和实测 |
| 可选同步增强 | 不使用 MotionSync 等可选 Sync 跟踪增强；必要的 USB/无线通信时序不在此排除范围 |
| 无线报告率 | 2.4 GHz、1000 Hz；需主板、固件、匹配接收器共同实现 |
| 宏、LOD、五键和滚轮 | 作为电子验收目标保留；机械模型没有实现宏、LOD 或 HID 输入 |
| 低延迟 | 待端到端测试，不能根据 1 kHz 或传感器名称直接给出延迟数值 |
| 供电与充电 | 保留底部开关口和前部充电孔；充电保护、电池温升和实际充电电流未验证 |
| 满性能持续运行 | 目标至少 12 h；未做续航测试 |

PAW3950 只是传感器型号，不代表统一主板外形、孔位或 1 kHz 无线能力。ATK 方案没有被替换为 F1、A9、Z1 等其他型号，也没有被假定使用 PAW3950。

## 续航仍是预算，不是结果

暂用 500 mAh 容量目标、75% 可用容量系数和 30 mA 连续工作电流预算：500×0.75÷30 = **12.5 h**。要达到 12 h，平均电流应不超过 **31.25 mA**；如果达到 40 mA，同一电池只有 **9.375 h**，至少约 **640 mAh** 才满足相同预算。

本版继续保留电池空间目标 **20×24×6 mm**。**没有确认此包络内可以买到合适的 500 mAh 电池**；容量与外形是两项待验证条件。真实电池放不下、连续电流过高、保护板/插头额外占位时，需要改布局或壳体，不能继续声称满足 12 h。

## 电子装配前必须量到的数据

1. 供体完整型号和 PCB 正反面尺寸、厚度、孔坐标、元件最高点；确认传感器版本。
2. 传感器中心、安装面、镜头型号及其光学参考面；从鼠标垫、脚贴、五脚平台、底筋、镜头到 PCB 的完整 Z 尺寸链。
3. 主键/侧键/中键开关外形、自由高度、触发与释放行程、极限行程；不能把本轮轻触开关参数沿用于供体微动。
4. 编码器高度、轴孔或插槽形状、轴长、固定耳和电气引脚；重新设计轮轴与中键动作配合。
5. 电池实物容量与外形、保护板、插头、引线弯曲和拆装空间；连续工作电流与充电温升。
6. USB-C 接口和线缆插头尺寸、电源开关拨杆、天线位置及厂商净空要求。
7. 宏、LOD、DPI、1 kHz 和接收器配对的固件能力与实际延迟、续航测试。

传感器轴线仍垂直鼠标垫。镜头的示意高度没有完成真实尺寸链；本版不能据此确定传感器光学工作高度。
