Quietmirror/github/L2_START_HERE.md

# Quietmirror 新版 L2 研究工程

本轮遵循新的R3.2→L2任务书。**14.89g未达到，当前共用塑料18.99951g；H/D装配仍有明确限制。**

- [下载入口与各文件用途](releases/Quietmirror-L2-Research/README.md)
- [全部实际文件](releases/Quietmirror-L2-Research)
- [最终尺寸/质量/切片对比](reports/l2_revision/FINAL_COMPARISON_R3_2_L2_H_D.md)
- [二次工程审核](reports/l2_revision/SECOND_PASS_REVIEW.md)
- [实际 CAD 质量分区图](views/l2_revision/studies/A_B_C_D_EXPLAINED.png)
- [H/D空间、冲突及功能边界](reports/l2_revision/HARDWARE_H_D_COMPATIBILITY.md)
- [完整建模源码与复现](cad/l2_revision/README.md)
- [历史CAD索引](releases/Quietmirror-L2-Research/history/INDEX.json)

H为需定制紧凑板的示意：97实体静态及有限运动无未允许干涉，托架直线装入仍失败。D的A1 Pro板型未知，红色测量块存在17对冲突。当前不是已适配供体或可直接生产整机。

实际四视图

原研究成果现以 [R3.3 / r3_3](releases/Fenrir-MiniSE-R3.3/README.md) 发布到 main；R3.2及此前版本、原始研究分支继续保留。
