Quietmirror/github/references/GWOLVES_REFERENCE.md

# 游狼视觉参考记录

日期：2026-10-14。用户要求在V0.1基础上更接近游狼、不要过分镂空。本轮按G-Wolves HSK / HTR短机身方向设计V0.2；没有指定必须复刻的型号。

## 实际查看的来源

1. [G-Wolves官方商店HTR Pro产品页](https://shop.g-wolves.com/products/g-wolves-htr-pro-8k-wireless-mouse)：型号与产品结构说明。
2. [G-Wolves亚太区总代HTR Pro产品页](https://www.g-wolves.cn/products/g-wolves-htr-pro-8k-wireless-mouse)：实际下载并查看草莓红上方产品图，[原图链接](https://www.g-wolves.cn/cdn/shop/files/001-01_9aa35495-c3e4-4f28-bfa6-588d3773a395.png?v=1730722825)。
3. [亚太区总代HSK Pro产品页](https://www.g-wolves.cn/products/g-wolves-hsk-pro-8k)：实际下载并查看黑色HSK Pro上方产品图，[原图链接](https://www.g-wolves.cn/cdn/shop/files/02.webp?v=1770684586)。
4. [亚太区总代尺寸对比页](https://www.g-wolves.cn/pages/mouse-comparison)：列HSK Pro v2.0约73.7×56×29 mm、HTR Pro约91×57×33 mm。仅用于理解尺度差异，不是本项目的人体工学验证。

未取得或打开HSK / HTR原厂CAD，没有逆向商业固件。照片不能证明内部板型、螺孔、镜头高度或供体兼容。

## 采用的方向

- 紧凑短机身，把前部双主键、中央滚轮与后部收束成完整鼠标轮廓。
- 主键占前段大面积接触区；侧壁连续、便于夹持；尾部缩短并逐渐降低。
- 以HSK的紧凑感、HTR的连续轮廓作为视觉方向，用独立曲线构建模型。

## 主动改变的部分

- 参考产品有蜂窝孔，本项目根据用户偏好省略；顶部仅保留滚轮开口和窄主键边界缝，底部集中留空。
- 保持90×62×31 mm试握假设，中部夹持约54 mm，不直接照搬商业尺寸。
- 增加右手使用的两个左侧固定侧键凸台，以及右侧低位无名指/小指托边。
- 使用重新设计的五个圆形脚贴平台，不从图片推算安装孔或脚贴厚度。
- 普通壁厚1.8 mm，以0.4 mm喷嘴FDM首轮试握为目标，不照搬商业工艺和整机重量。

## 权利说明

G-Wolves / 游狼及产品名归各权利人。商业产品图仅在本机参考缓存查看，通过链接指向来源，不放入本项目CERN-OHL-P许可范围。仓库V0.2视图来自本项目实际STL，可按本项目许可使用。

本项目与G-Wolves无关联，不表示其背书；未复制商业模型数据、装饰标志或蜂窝布局。
