Quietmirror/github/reports/试握反馈表.md

# V0.1 试握反馈

打印日期：____　耗材/层高：____　打印机：____　去支撑后重量：____ g

五脚贴直径/实测厚度：____ / ____ mm　实际长×宽×高：____ × ____ × ____ mm

先轻修毛刺、确认五脚同厚且不摇晃，再以自然握姿试用。固定滚轮和按键只用于触达，不要用力掰动或以它们评价真实点击力。

| 项目 | 操作 | 记录 | 对应下一轮参数 |
|---|---|---|---|
| 握宽 | 自然夹持，轻微前后推拉，不刻意张大手 | 偏窄/合适/偏宽；拇指和无名指压点；期望增减__mm | grip_width，侧凹曲率/高度 |
| 顶掌 | 小范围前后推移，再做大幅回拉 | 后段是否碰掌；发生位置和握姿；是否被迫改变手腕 | length、后部站位；必要时降低后段 |
| 拖地 | 无名指/小指自然放置，沿垫缓慢滑动 | 哪根手指、何处碰垫；托边是否有压迫感 | right_contact、托边宽/高 |
| 左右主键触达 | 食指/中指自然落下，移到常用点击点 | 接触点距前缘__mm；面是否过高/过宽；左右高度差是否舒服 | 两个key的x/y/宽/长/height_offset |
| 滚轮触达 | 不改变夹持点，尝试把指肚放到固定轮顶 | 前后位置是否够到；是否要抬手或扭指；是否偏高 | wheel的y、直径、height_offset |
| 两个侧键触达 | 保持拇指夹持，分别触碰前后凸台 | 哪个难够到；是否误碰；高度/前后改量__mm | side_buttons的y/z/length |
| 抬鼠稳定性 | 在垫上方轻抬5–10 mm并放下，重复几次 | 前后俯仰、旋转、滑脱；是否需要明显加大夹力 | 两侧接触位置/凹度、重心（装配版） |
| 局部舒适 | 短时间试握后记录集中压点 | 哪处硌手/边缘明显；是否是毛刺或几何造成 | 接触曲面/圆角；先排除打印缺陷 |
| 刚度 | 只用正常夹持力，不做破坏测试 | 侧壁、主键平台是否明显晃动；哪条筋变形 | 保留或调整承力筋/内垫，之后再逐轮减薄 |

补拍：自然握姿俯视、拇指侧、无名指侧各一张，镜头尽量正对该面，旁放尺子；无需用照片推算伪精确指节长度。若需要更贴合，下一轮再量实际握宽、掌宽、指节长度及自然点击点，优先用试握件反馈修正单一变量。

本轮评价不了：真实点击力度/回弹、滚轮阻尼/中键手感、真实电子件重心、传感器性能、无线1000 Hz稳定性。它们属于装配版验证。
