Quietmirror/github/reports/l2_revision/BASELINE_R3_2_AUDIT.md

# R3.2 独立基准审计

基准提交 `f1b1090931d717117287ea2b79c2e14ddc234937`；保留整个历史，工作位于 `codex/l2-balanced`。当前工程在 D 盘，依赖和计算缓存也在 D 盘。

实际读取九件 STEP 与 STL；采用 OCP 自适应原生体积积分容差 1e-7。原始总实体 18506.6760995 mm³，按 PA12 1.01 g/cm³ 得 18.69174286 g；按 PLA 1.24 得 22.94827836 g，后者不含切片支撑。默认 OCC 对裁剪 NURBS 的简化 Volume 会偏大，不能用于本项目 BODY 的质量计算。详见 `baseline_audit.json` 与 `calculation_audit.md`。

五个脚贴平台 Ø8、厚1.6、粘贴面 Z5.2；壳体最低约 Z5.0。示例0.5脚贴使鼠标垫为 Z4.7，约0.299离地；估计镜头最低 Z7.8，3.1光学距离只是尺寸链示例。

真实孔型有 R0.85 圆角；尖角多边形面积1301.271 mm² 与圆角后约1292.284 mm²不同。七根理想梁的1544.045 mm³是未扣交叠毛体积，不能当净骨架质量或全删预算。
