Quietmirror/github/reports/l2_revision/FINAL_COMPARISON_R3_2_L2_H_D.md

# R3.2至本轮L2研究交付

**14.89g目标未达到。** 选择F1H的九件共用塑料为18.99951g（PA12假设1.01），比R3.2增加0.30777g，超目标4.10951g。必要横梁加强与侧键机构修正占用了减重空间；所有减薄候选的收益与失败如实保留。不能称为成功减重20%或25g整机。

F1H是本轮完整几何检查、主要工况基本保持及低突出侧键的研究候选，不是数学全局最轻解，也不代表所有二次夹具、实际材料、硬件和疲劳完全通过。H/D再加实际可拆支架，质量另列，不能把共用19g当含适配件总重。

| 方案 | 件数 | PA12理论g | 净PLA g | 支撑g | 边框g | 总PLA g | 估时 |
|---|---|---|---|---|---|---|---|
| F1H | 9 | 18.99951 | 23.69 | 13.70 | 0.61 | 37.99 | 4h 57m 55s |
| L2_H_EST | 11 | 19.74929 | 24.65 | 15.25 | 0.65 | 40.55 | 5h 17m 32s |
| L2_D_EST | 11 | 19.49544 | 24.32 | 14.26 | 0.65 | 39.24 | 5h 7m 29s |
| L2_BOTH_EST | 13 | 20.24522 | 25.28 | 15.84 | 0.70 | 41.82 | 5h 27m 56s |

实际交付：参数化Python、历史候选差异包、独立STL/STEP、具名完整STEP与FreeCAD原生文档、真正切片3MF、实际CAD渲染、BOM、装入路径及数值审计。FreeCAD是具名可编辑BRep组件，随附参数化源码；不是伪称原生草图历史或已求解运动副。原R3.2及main保持。

建议继续使用FreeCAD/CadQuery/Gmsh/CalculiX完成实测板型导入、装配约束和局部修正；本轮已经实际调用这些外部工具。缺的关键是板卡实物、打印公差和功能测试，换一个建模软件不会自动补齐它们。
