Quietmirror/github/reports/l2_revision/ORIGINAL_CALCULATION_SECOND_REVIEW.md

# 原始计算二次复核

L2目标14.89g相对18.69174286g需要净移除3764.101842mm³，即20.34%。工作包预算只是目标分配，并非已找到的可删材料。

原二维6.6%/10.3%改进无法唯一复现：缺少精确边界、载荷分配、圆角及网格实现。新的独立 Gmsh/CST 面板62×41、三个网格0.75/0.5/0.35完成，P0/P1末档后缘刚度504.196/518.586、侧缘271.566/282.609 N/mm，新定义下约+2.85%/+4.07%，最后网格变化小于1%。这些是面内代理，不是鼠标整体刚度。见 `conforming_2d_proxy.json`。

三维采用实际 STEP 体网格C3D10。曾发现顶部选面误选内部横梁顶面，已改为只在解析母壳外表面0.15mm范围内加载，全部当前对比重新计算；97/45等早期数值不可和当前120左右的结果混用。独立积分复核曾发现 CalculiX 积分点排列差异，已修正为L1/L2/L3/L4顺序，重新校核力、力矩与应变能。失败记录保留，不把修正后的检查伪称为第二个硬件试验。

互斥体积分类使用同一内腔分类法同时重做R32/F1H；避免与外壳母曲面重合的布尔交导致无效分区。未经容差复核的 ShapeFix 被拒绝；没有修补或改变交付 BODY 来凑质量。
