Quietmirror/github/reports/l2_revision/SECOND_PASS_REVIEW.md

# 独立第二轮审核

状态：**COMMON_SHELL_REVIEWED_FOR_LAYOUT_RESEARCH**。只冻结本次几何用于估计布局和原型交付；`full_master_spec_acceptance=false`。14.89g目标没有达到，实际材料/硬件/疲劳验证仍缺失，因此不发布“全面通过”“可直接生产”结论。

九个打印件各为一个有效原生实体；交付STL封闭、统一方向、单连通、零自交。72零件2556静态对零未允许干涉；仅明确的螺纹啮合区允许局部相交。五个运动机构各41位置，滚轮转动与中键72组合；18装入阶段；五脚原生共面；FreeCAD72个具名BRep保存重开通过。

主要BODY工况比较与三档收敛通过；主键、侧键、滚轮、载架均另作三维夹具筛选。未测试实际接触非线性、摩擦、层间方向和疲劳。次要夹具结果如下，下降项保留为开放问题：

| 次要工况 | R32 k | F1H k | 比值 |
|---|---|---|---|
| LC4_sensitivity_anchor_swap | 120.42231 | 121.57804 | 1.00960 |
| LC4_sensitivity_low_poisson | 119.69908 | 120.74655 | 1.00875 |
| LC5_rear_corner_lift_2N_rigid_grip_fixture | 82.62404 | 79.94117 | 0.96753 |
| LC7_one_PCB_ear_service_2N | 79.18159 | 76.96975 | 0.97207 |

F1H体积分类闭合误差-0.18557mm³，R32为-0.00907mm³，容差0.25mm³；整件独立积分是质量权威值，未把积分差记为减重。外皮/骨架/安装分区不是商业原厂结构解析。每个脚贴圆盘的共面与实体包含关系另以原生布尔验证；最小弦长只作抽样风险提示。
