Quietmirror/github/reports/l2_revision/TOPOLOGY_WALL_THICKNESS_STUDY.md

# 实际孔型、骨架、壁厚与主键研究

真实单变量候选P1 R1.0/1.3/1.5、P2三角网格、P3蜂巢、P4圆角槽、P5椭圆、P6混合圆角均留存源码和几何。P1维持圆角后投影面积，曲面体积并不完全相同；不能称严格等质量。P3受限于保护带不能保持等面积且有240个自交面，拒绝。P4原生实体可求解但输出STL不闭合，拒绝打印。P5/P6夹持或顶部刚度下降。P6是非均匀几何候选，不冒称已经完成自动拓扑优化。

B1圆梁变细仅省约0.067g且夹持变弱；B2定向椭圆的体网格两次因重合面失败，无强度通过；B3桁架两种路径产生分离实体，保留失败支撑模型，不能悄悄删除小块；B4混合加强更重。C1耳角削料仅省0.04960g，网格和夹持筛选不通过；S17局部侧壁1.7mm仅省0.01538g且两项刚度下降。无全壳统一减薄。

主键K16/K14/K12每对分别省0.21139/0.31794/0.42491g；三个网格与四处偏心按压都显示刚度损失。K14R加深背筋只改善前端，其他方向仍较弱。选择保留原主键。原滚轮和载架保留，三档独立有限元完成；末档刚度分别132.687和5.268N/mm，夹具含刚性参考接触，未测滚动阻力。

F1H组合P1 R1.3、前移低突出侧键、绕开工具的对称横梁、局部横梁竖向加强及0.817mm³螺栓尖端避空。它是本轮完整检查的较保守组合，并非全设计空间的最轻解。侧键以外维持对称视觉，功能机构保留左右差异。底部与五脚基准保留。

下表均为同一修正外皮载荷定义；单档候选只作筛选：

| 候选 | 最细网格mm | 上背N/mm | 夹持N/mm |
|---|---|---|---|
| B1 | 2.4 | 121.091 | 511.189 |
| B4 | 2.4 | 123.264 | 528.965 |
| C1 | 2.4 | 121.078 | 504.620 |
| F1E | 1.8 | 113.449 | 538.283 |
| F1G | 1.8 | 120.412 | 549.223 |
| F1H | 1.8 | 121.578 | 551.268 |
| P1_R10 | 2.4 | 121.492 | 526.350 |
| P1_R13 | 2.4 | 122.054 | 518.716 |
| P1_R15 | 2.4 | 121.519 | 516.349 |
| P2 | 2.4 | 124.058 | 515.505 |
| P4 | 2.4 | 123.513 | 520.078 |
| P5 | 2.4 | 117.551 | 503.697 |
| P6 | 2.4 | 121.470 | 506.551 |
| R32 | 1.8 | 120.422 | 515.982 |
| S17 | 2.4 | 120.038 | 510.075 |

壁厚采用原生BRep线段交和法向弦长抽样，详见F1H/geometry_second_review.json。最短边缘弦长不能直接解释成连续薄墙。保留1.8mm主体标称、主键2mm、实际圆梁/加强节点；这不是全表面最小厚度证明。实际刀路核对局部零件与五脚支撑，未完成每条孔边逐层手工测量，不能声称所有细小配合可直接FDM到尺寸。
