Quietmirror/github/reports/rebuild_r2/FEM_REPORT.md

# R2 实际有限元计算记录

本报告由实际 Gmsh 网格和 CalculiX 求解生成。它验证给定边界条件下的线弹性响应；没有把估算公式当成模型求解，也不把计算称为实物强度认证。

- BODY STEP SHA256：`1ab20963dbc05caa215cd35b05348cfc8dfb6b30d8821812fb484bccb251f5bc`
- 单位：mm、N、MPa。直边二次四面体 C3D10（曲面由边界三角形逼近）；PLA 假设 E=1500 / 2300 MPa，ν=0.35。
- 五脚底面只固定 Z；前左脚一个节点固定 X/Y、前右脚一个节点固定 Y，共三个面内刚体约束。
- 载荷按选定曲面面积进行二次三角形形函数积分，归一化到指定总力；报告实际面积、合力和载荷位置。
- RF 输出是节点总外力；计算反力时已扣除约束节点上可能存在的外加集中力。

## 解析梁验证

40×4×4 mm 固支悬臂梁，E=1500 MPa、ν=0.35；独立求解端面均布 1 N 横向剪力和 10 N 轴向拉力。轴向解析式 FL/EA；横弯采用 FL³/(3EI) 加 FL/((5/6)GA) 剪切项。

| 网格 (mm) | 工况 | 解析位移 (mm) | 计算端面位移 (mm) | 误差 |
|---:|---|---:|---:|---:|
| 2 | cantilever_bending | 0.672067 | 0.663201 | 1.32% |
| 2 | axial_tension | 0.0166667 | 0.0165834 | 0.50% |
| 1.25 | cantilever_bending | 0.672067 | 0.66454 | 1.12% |
| 1.25 | axial_tension | 0.0166667 | 0.0165895 | 0.46% |

解析梁验收：**True**；细网格解析误差及两档位移变化均要求 <5%。

## 主壳结果

| 网格 | E (MPa) | 工况 | 节点/单元 | 最大位移 mm | 最大 von Mises MPa | 积分点 P95 MPa | 平衡相对误差 | 脚点需拉住 |
|---:|---:|---|---|---:|---:|---:|---:|---|
| 2.4 | 1500 | palm_down_20N | 144544/73908 | 0.939243 | 57.7796 | 1.49525 | 5.94e-09 | False |
| 2.4 | 1500 | left_main_root_down_5N | 144544/73908 | 0.348857 | 13.2262 | 0.720091 | 3.54e-08 | True |
| 2.4 | 1500 | side_1_switch_fence_inward_5N | 144544/73908 | 0.216227 | 14.8766 | 0.659832 | 3.32e-08 | True |
| 2.4 | 1500 | side_2_switch_fence_inward_5N | 144544/73908 | 0.236719 | 17.5815 | 0.771776 | 2.86e-08 | True |
| 2.4 | 2300 | palm_down_20N | 144544/73908 | 0.61255 | 57.7796 | 1.49525 | 5.93e-09 | False |
| 2.4 | 2300 | left_main_root_down_5N | 144544/73908 | 0.227515 | 13.2262 | 0.720091 | 3.54e-08 | True |
| 2.4 | 2300 | side_1_switch_fence_inward_5N | 144544/73908 | 0.141018 | 14.8766 | 0.659832 | 3.32e-08 | True |
| 2.4 | 2300 | side_2_switch_fence_inward_5N | 144544/73908 | 0.154382 | 17.5815 | 0.771776 | 2.86e-08 | True |
| 2 | 1500 | palm_down_20N | 205011/108941 | 0.977083 | 57.1272 | 1.50598 | 5.67e-09 | False |
| 2 | 1500 | left_main_root_down_5N | 205011/108941 | 0.351772 | 15.5479 | 0.723447 | 3.19e-08 | True |
| 2 | 1500 | side_1_switch_fence_inward_5N | 205011/108941 | 0.216689 | 15.0062 | 0.657106 | 2.89e-08 | True |
| 2 | 1500 | side_2_switch_fence_inward_5N | 205011/108941 | 0.233783 | 17.9479 | 0.768495 | 1.8e-07 | True |
| 2 | 2300 | palm_down_20N | 205011/108941 | 0.637228 | 57.1272 | 1.50598 | 5.67e-09 | False |
| 2 | 2300 | left_main_root_down_5N | 205011/108941 | 0.229417 | 15.5479 | 0.723447 | 3.19e-08 | True |
| 2 | 2300 | side_1_switch_fence_inward_5N | 205011/108941 | 0.141319 | 15.0062 | 0.657106 | 2.69e-08 | True |
| 2 | 2300 | side_2_switch_fence_inward_5N | 205011/108941 | 0.152467 | 17.9479 | 0.768495 | 1.8e-07 | True |
| 1.6 | 1500 | palm_down_20N | 307759/169033 | 0.965703 | 61.2868 | 1.5068 | 1.05e-08 | False |
| 1.6 | 1500 | left_main_root_down_5N | 307759/169033 | 0.356952 | 17.0814 | 0.731009 | 1.71e-08 | True |
| 1.6 | 1500 | side_1_switch_fence_inward_5N | 307759/169033 | 0.216385 | 15.1497 | 0.657055 | 2.29e-09 | True |
| 1.6 | 1500 | side_2_switch_fence_inward_5N | 307759/169033 | 0.233698 | 18.0827 | 0.766195 | 5.98e-08 | True |
| 1.6 | 2300 | palm_down_20N | 307759/169033 | 0.629806 | 61.2868 | 1.5068 | 1.05e-08 | False |
| 1.6 | 2300 | left_main_root_down_5N | 307759/169033 | 0.232795 | 17.0814 | 0.731009 | 1.71e-08 | True |
| 1.6 | 2300 | side_1_switch_fence_inward_5N | 307759/169033 | 0.14112 | 15.1497 | 0.657055 | 2.29e-09 | True |
| 1.6 | 2300 | side_2_switch_fence_inward_5N | 307759/169033 | 0.152412 | 18.0827 | 0.766195 | 5.98e-08 | True |
| 1.6 | 1500 | side_1_with_5N_palm_preload（补充） | 307759/169033 | 0.288621 | 15.1536 | 0.702535 | 1.27e-07 | False |
| 1.6 | 1500 | side_1_held_pinch_with_5N_palm（补充） | 307759/169033 | 0.19263 | 14.0296 | 0.482701 | 1.37e-09 | True |
| 1.6 | 1500 | side_2_with_5N_palm_preload（补充） | 307759/169033 | 0.304411 | 18.0869 | 0.805369 | 5.76e-09 | True |
| 1.6 | 1500 | side_2_held_pinch_with_5N_palm（补充） | 307759/169033 | 0.221788 | 14.4787 | 0.476126 | 1.32e-08 | True |

合力与力矩平衡验收：**True**。
三档网格及最终两档收敛验收：**True**（至少三档，位移变化 <5%，积分点 P95 应力变化 <5%）。
全局峰值应力的最终两档变化 <5%：**False**；此项单独报告，不能用 P95 掩盖未收敛峰值。

| 工况 / E | 网格变化 (mm) | 位移变化 | P95 应力变化 | 峰值应力变化 |
|---|---|---:|---:|---:|
| palm_down_20N / 1500 | 2.4→2 | 3.87% | 0.71% | 1.14% |
| left_main_root_down_5N / 1500 | 2.4→2 | 0.83% | 0.46% | 14.93% |
| side_1_switch_fence_inward_5N / 1500 | 2.4→2 | 0.21% | 0.41% | 0.86% |
| side_2_switch_fence_inward_5N / 1500 | 2.4→2 | 1.26% | 0.43% | 2.04% |
| palm_down_20N / 2300 | 2.4→2 | 3.87% | 0.71% | 1.14% |
| left_main_root_down_5N / 2300 | 2.4→2 | 0.83% | 0.46% | 14.93% |
| side_1_switch_fence_inward_5N / 2300 | 2.4→2 | 0.21% | 0.41% | 0.86% |
| side_2_switch_fence_inward_5N / 2300 | 2.4→2 | 1.26% | 0.43% | 2.04% |
| palm_down_20N / 1500 | 2→1.6 | 1.18% | 0.05% | 6.79% |
| left_main_root_down_5N / 1500 | 2→1.6 | 1.45% | 1.03% | 8.98% |
| side_1_switch_fence_inward_5N / 1500 | 2→1.6 | 0.14% | 0.01% | 0.95% |
| side_2_switch_fence_inward_5N / 1500 | 2→1.6 | 0.04% | 0.30% | 0.75% |
| palm_down_20N / 2300 | 2→1.6 | 1.18% | 0.05% | 6.79% |
| left_main_root_down_5N / 2300 | 2→1.6 | 1.45% | 1.03% | 8.98% |
| side_1_switch_fence_inward_5N / 2300 | 2→1.6 | 0.14% | 0.01% | 0.95% |
| side_2_switch_fence_inward_5N / 2300 | 2→1.6 | 0.04% | 0.30% | 0.75% |

## 载荷位置及脚点反力

以下是最终细网格、E=1500 MPa。负 Z 反力表示该脚需要拉住；正值为桌面向上支承。补充工况另外明确给定 5 N 掌压；手持工况再在右侧真实握持面施加相反 5 N 夹持力。附加预载及夹持是定义的试验条件，不是从模型推得的实际人手力量。

| 工况 | 脚1 Fz N | 脚2 Fz N | 脚3 Fz N | 脚4 Fz N | 脚5 Fz N |
|---|---:|---:|---:|---:|---:|
| palm_down_20N | 1.1272 | 0.83806 | 8.6428 | 8.644 | 0.74797 |
| left_main_root_down_5N | 0.31326 | 1.4173 | 1.1905 | 3.479 | -1.4 |
| side_1_switch_fence_inward_5N | 0.0070146 | -0.18941 | 0.48128 | -0.20884 | -0.090038 |
| side_2_switch_fence_inward_5N | 0.18519 | -0.33873 | 0.20662 | -0.049704 | -0.0033841 |
| side_1_with_5N_palm_preload | 0.28882 | 0.020103 | 2.642 | 1.9522 | 0.096956 |
| side_1_held_pinch_with_5N_palm | 0.28577 | 0.060315 | 2.1846 | 2.5241 | -0.054786 |
| side_2_with_5N_palm_preload | 0.467 | -0.12921 | 2.3673 | 2.1113 | 0.18361 |
| side_2_held_pinch_with_5N_palm | 0.20049 | 0.096746 | 2.2955 | 2.5051 | -0.097878 |

| 基本载荷 | 实际加载曲面面积 mm² | 面积中心 XYZ mm |
|---|---:|---|
| palm_down_20N | 860.44 | -0.758, 59.04, 27.59 |
| left_main_root_down_5N | 101.05 | 15.01, 38.8, 20.65 |
| side_1_switch_fence_inward_5N | 21.702 | 17.01, 51.37, 13.03 |
| side_2_switch_fence_inward_5N | 21.702 | 17.73, 66.37, 13.02 |

## 接触、强度与解释边界

所有脚面 Z 约束采用双向支承。某脚反力为负表示该脚必须被拉住才能保持该计算姿态；真实未粘接鼠标会出现脚点离地和支承重分配。因此负反力工况只代表被支承夹具托住的壳体测试，不能声称自然放在桌上仍五脚接触。侧载的水平反力经两个最小定位点闭合，实际桌面摩擦分布未建模。

最大应力与峰值位置保存在 JSON。约束边缘、载荷边缘和理想尖角可产生局部应力奇异性；P95 只用作网格收敛诊断，不能替代峰值强度验收。没有提供实际打印方向、层间强度、材料批次、螺钉承压或蠕变/疲劳允许值，因此不能由 E 值假设推导出打印成品的安全系数。

本次只分析 BODY 主壳。主键根部 5 N 是传递到固定根座区域的等效载荷；两个侧载分别施加到真实开关背挡板的内壁，以检查悬吊开关座及其连接。没有在该模型中加入转轴/开关接触、主键弹性或所有螺钉预紧。那些部件仍需独立公差、运动、安装及实物验证。

每档网格及每次求解的输入、求解器日志、DAT/FRD 和数组均保存在 D 盘支持目录；摘要绑定 STEP、网格、求解输入和 DAT 哈希。

## 软件说明

- [Gmsh 官方手册](https://gmsh.info/doc/texinfo/gmsh.html)
- [CalculiX 官方手册](https://www.dhondt.de/ccx_2.22.pdf)
- [CalculiX NODE PRINT / RF 说明](https://feacluster.com/CalculiX/ccx_2.18/doc/ccx/node307.html)
