Quietmirror/github/references/V0.9_REFERENCE_NOTES.md

# V0.9 实际参考与边界

本轮阅读并实际查看了以下官方产品图（2026-10-15）。只借鉴造型处理，没有复制商业产品的 CAD、商标或图片进发布包。

| 参考 | 实际查看 | 本轮采用 |
|---|---|---|
| [Razer Viper V3 Pro](https://cn.razerzone.com/gaming-mice/razer-viper-v3-pro) | [官方侧视图](https://assets2.razerzone.com/images/pnx.assets/474a68bae599387eb85e884c484e9ce3/angle_1.webp) | 主键是前端外壳的一部分，键尾与背壳衔接，前缘释放而不把整个键帽抬高 |
| [Razer Viper V4 Pro](https://www.razer.com/gaming-mice/razer-viper-v4-pro) | [官方斜视与底视图](https://assets2.razerzone.com/images/pnx.assets/eb5fbd749917af6235780a1bdba7bdac/razer-viper-v4-pro-pointers-760.webp) | 连续母曲面上的分件缝、前端键区与侧壁共同构成外轮廓；不借用其电子技术 |
| [Razer Viper Mini Signature Edition](https://www.razer.com/gaming-mice/razer-viper-mini-signature-edition) | [官方侧斜视图](https://assets2.razerzone.com/images/pnx.assets/5d3ca584c6fc5b521ff215071336973a/razer-viper-mini-signature-edition-1300x600-top-2.webp) | 三角开口、斜向承力分格、连续握持侧面；本项目中的 minise 按此产品理解 |

本模型为原创 CadQuery 几何：主键通过母壳差集分割，三角网格由本项目控制点重新生成。商品图不提供本设计的尺寸、FDM 强度或手感证据。镁合金商品的细筋不能原样当成塑料打印件的安全下限。

本轮继续使用项目既有的 Fenrir 方向细长双侧键、原五脚底框、可动试按机构。早期实际查看的 olliebella、Kotinos、paw3395-pcb 和 Fenrir 源文件记录、作者及许可证继续保留在 references 和 NOTICE.md。本轮没有声称重新测量供体，也没有沿用 HSK Pro 或参考 PCB 孔位。

“所有三角镂空”的执行范围为外观上壳新增/改造的减重孔。按此前保留底部的要求，底部承力核心与五脚保持 V0.8；低处侧壁随新母曲面重建；滚轮安装口、按键接缝、USB-C、开关和传感器孔为功能开口，不改成三角形。三角尖角使用小圆角，仍只有三条主要直边。
