Quietmirror/github/reports/v06/slicer_model_info.txt

[quietmirror_fingertip_V0.6_FIT.stl]
size_x = 61.968830
size_y = 90.312477
size_z = 27.999525
min_x = -30.984415
min_y = -90.312477
min_z = 0.000000
max_x = 30.984415
max_y = 0.000000
max_z = 27.999525
number_of_facets = 121690
manifold = yes
number_of_parts =  1
volume = 17002.310547
