Quietmirror/github/reports/v05/DESIGN.md

# V0.5 设计思路、孔形和证据

## 设计目标

用户要求孔间平面筋更窄，孔大小大致保留、数量增加，各孔随外壳裁形、筋宽更均匀，并保持布局对称。本版保留 Fenrir 方向的 V0.4 上壳轮廓、主键与滚轮位置、侧键接口及 Z≤6 mm 冻结底部，只修改后壳开孔。

“对称”按主壳、主键和孔阵的左右镜像实现；先前要求的右手拇指键、右托边继续保留。它们使完整 FIT 实体有功能性不对称，本项目不把整件冒称为全镜像设计。若需要所有附件也镜像，应另开底部版本，因为右托边属于冻结区域。

## 为什么采用 3—4—3 和不同孔形

旧版 6 个等形孔之间存在较宽的实面，简单等比放大孔容易先碰到肩部或尾部。本版采用三个交错分区：前排 3、中排 4、后排 3。中央孔较完整，中排最外两个孔顺着肩部拉长，尾部两个外侧孔斜收，顶部外侧孔为侧键座留出边缘空间。单孔面积 80.679–99.283 mm²，对比原来 85.342；平均增大约 5.5%，没有靠把孔缩成密集小蜂窝增加数量。

步骤：对镜像的种子点做 Voronoi 半平面分区；裁入沿肩部和尾部设置的边界；每个分区向内退让 1.1 mm；生成真实 R1.0 CAD 圆弧；右侧孔成形后精确镜像到左侧；最后沿 Z 切穿上壳。孔角圆弧降低尖角，三向交汇节点自然较宽。外围边框承担夹持与侧键传力，保留比孔间筋更宽的余量。

孔阵边界由可编辑的六个右侧站位定义，前端位于距前 48 mm，尾端 79.5 mm，经过内缩后孔口约在距前 49.1–78.4 mm。它是为本版外壳和侧键避让设置的设计边界，不是用照片反推的精确模具尺寸。

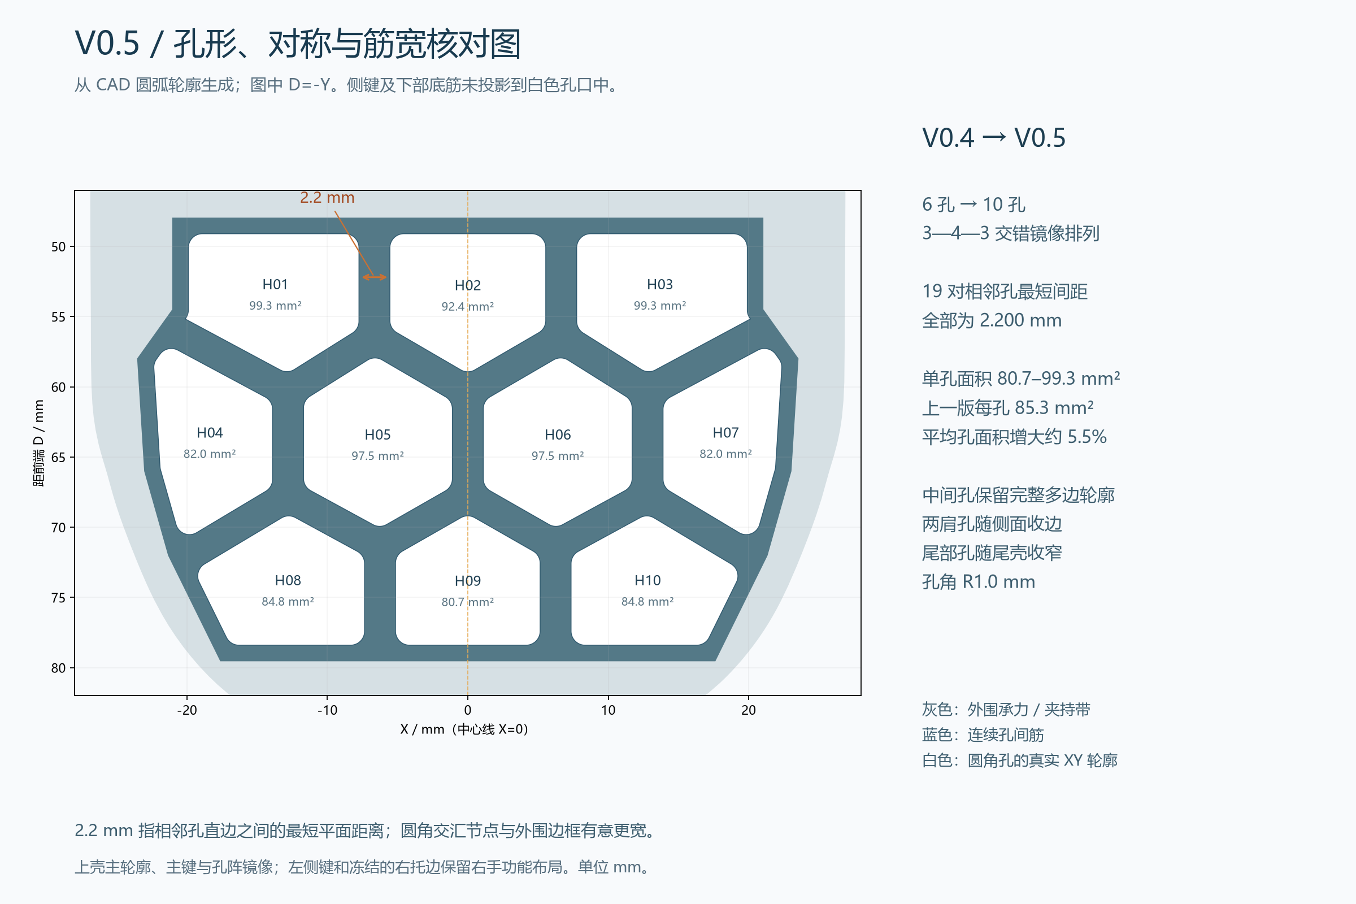
[picture p23: views/v05/14_vent_layout.png]
CAD 孔形与筋宽


| 孔编号 | 种子 X,D /mm | 圆角孔外接宽×长 /mm | XY 面积 /mm² |
|---|---|---|---:|
| H01 | -13.3, 53 | 12.378×9.823 | 99.283 |
| H02 | 0, 53 | 11.100×9.832 | 92.368 |
| H03 | 13.3, 53 | 12.378×9.823 | 99.283 |
| H04 | -19.2, 64 | 8.457×13.253 | 82.046 |
| H05 | -6.4, 64 | 10.600×11.992 | 97.490 |
| H06 | 6.4, 64 | 10.600×11.992 | 97.490 |
| H07 | 19.2, 64 | 8.457×13.253 | 82.046 |
| H08 | -12.5, 75.2 | 11.882×9.206 | 84.825 |
| H09 | 0, 75.2 | 10.300×9.210 | 80.679 |
| H10 | 12.5, 75.2 | 11.882×9.206 | 84.825 |

编号从前排左到右、再向后。D 是距前端正距离，实际模型 Y=-D。宽长是实际圆角轮廓包围框，不是统一标称圆直径。所有原始轮廓点和邻接关系见 [vent_layout.json](vent_layout.json)。

## 筋宽与对称怎么核对

19 对真正相邻的分区逐对计算圆角孔轮廓间距离，范围 2.200000–2.200000 mm。V0.4 旧报告的 3.0 mm 是尖角基形最小距；重新测量实际圆角切刀后最小为 3.400 mm。新版本的 2.2 mm 使用实际圆角轮廓，避免混用口径。

孔阵与镜像的平面差面积 1.461e-13 mm²，属于数值误差。保存后上壳 STEP 转网格，5,000 点镜像后的最近曲面距离最大 0.02008 mm，99分位 0.01057 mm；这是有限网格采样，不是解析曲面重合定理。10 孔共 837 条内部垂直射线均穿过上壳孔口，未检测到未切穿点。

开孔与两个侧键加固座相交体积为 0，最近距离约 8.339 /0.889 mm。该距离是切刀到座体的空间距离，不能当作该处壁厚或强度；常规壳厚和孔间细筋厚度另行采样。

## 几何、最薄特征与底部

| 检查 | 保存后实际结果 |
|---|---|
| FIT 外接尺寸 XYZ /mm | 61.987465×90.002465×28.002514 |
| FIT STEP | 有效，单实体；体积 17778.074 mm³ |
| FIT STL | 111,548 面；封闭、单连通、法线一致、自相交 0；体积 17696.431 mm³ |
| CAD /网格体积差 | 0.4592%；保留测量差异 |
| 常规壳面法向厚度 | 869 点，最小 1.69541，中位 1.87938 mm |
| 孔间细筋法向厚度 | 57 点，最小 1.73379，中位 1.89687 mm |
| 两组中小于 1.6 mm 的样本 | 0 |
| 局部固定小桥 | FIT 侧键固定桥名义 1.2 mm，保持原版；不是活铰链 |
| 侧键内限位边 | 名义厚 1.6 mm；键面边缘 R1.1 |
| 五脚平面 | 45 个检查点均为 Z=0，平台 Ø8.8 mm |
| SHELL 和两个键帽 | 各自 CAD 单实体有效、STL 单连通封闭、自相交 0 |

常规壁厚采样避开开孔边缘；另在 19 条孔间共享边界的 1/4、1/2、3/4 处检查 57 个法向弦厚度，专门覆盖细筋。两者都是有限点采样，不能声称连续全局最薄处全部大于 1.6 mm；边缘圆角和原有 1.2 mm 固定桥单列。没有做有限元、疲劳、跌落、实物夹持或扭转试验。

底部继续直接取 V0.3 STEP 的 Z≤6 mm 完整区域，包含五脚、外围与斜筋、传感器框、右托边、滚轮根部及下壳带。冻结区域检查：**FIT：旧减新 0.000000 / 新减旧 0.000000 mm³；SHELL：旧减新 0.000000 / 新减旧 0.000000 mm³**。Z=6 上下 0.01 mm，39 个站位外边变化最大 0.002267 mm。既有 0.6 mm 高过渡边及其顶部小台阶保留。

STL 线性偏差设置 0.02 mm、角度 0.15 rad。仅焊接近重复顶点和清除退化/重复面，没有补洞或丢弃组件来通过验证。所有验证针对导出的文件。[几何原始数据](validation.json) · [底部原始数据](bottom_preservation.json) · [孔与细筋原始数据](vent_verification.json)

## 侧键与电子空间

沿用窗口 12×6.6 mm、键面 10.8×5.4、限位边 13.2×6.2×1.6；前/后侧键中心距前 33/47，Z16.5/18.8。独立件与壳体静态相交为 0，最近间隙约 0.300 /0.217 mm。两条从底部送入、内向外就位的离散路径分别 48/57 个采样位置，相交为 0；没有连续扫掠或实物装配验收。FIT 把两键固定成同一个实体。

开孔变化不解决电子尺寸缺失。16 个估计包络重新与新壳求交，仍需实测“ATK 蜻蜓 A1 Plus”的供体身份、PCB、镜头、滚轮/编码器、侧键板、电池/插头、USB-C、电源开关与天线规范。主键和滚轮固定占位不能当作可动机构。[电子尺寸和干涉](ELECTRONICS.md) · [侧键路径](side_button_insertion.json)

## 切片与试握

同一最终 V0.5 配置重切 V0.4 与 V0.5，本体估重 23.345 →22.190 g，减重 1.155 g /4.95%。本轮初始树状支撑报告了分支生成警告，因此交付配置改为贴合支撑（snug）；最终 FIT、SHELL、键帽和 3MF 重切片日志未再出现该警告。

本体 22.190 g，支撑 15.198 g，裙边 0.173 g，总 37.56 g /4h 12m 7s。3MF 单独重切为 37.57 g /4h 12m 3s，保留实际差异。[打印说明](../../slicing/V0.5_PRINTING.md) · [同配置对比](comparison_slice.json)

重点试握：握宽、顶掌、无名指/小指拖地、滚轮/侧键触达、抬鼠稳定性；本轮另观察细筋是否发软、扭转、硌指和孔口去支撑是否容易。减薄后刚度必须由实物反馈验证。[反馈表](FIT_FEEDBACK.md)

## 版本和来源

本轮改动的几何参数只有 ventilation；version /notes 为记录字段。V0.1–V0.4 专用文件保持原内容，V0.4 README 归档，原 V0.4 切片结果不覆盖。原创代码和几何采用 CERN-OHL-P-2.0，沿用 [开源审阅记录](../../references/REFERENCE_REVIEW.md)、[Fenrir 图片参考说明](../../references/FENRIR_REFERENCE.md) 与 [NOTICE](../../NOTICE.md)。
