Quietmirror/github/reports/v04/DESIGN.md

# V0.4 设计思路与验证

## 1. 目标与保留项

用户要求“参照fenrir-wireless-mouse改进模型，底部不变，并把所有历史版本一并上传”。本轮以 [Fenrir Pro / Asym 的六张实际查看图片](../../references/FENRIR_REFERENCE.md) 为视觉依据，调整上部轮廓。保留主要指肚接触面、平顺侧面、右侧低托边和独立侧键原型；没有对商用品按比例描摹或假设其结构能用同样厚度FDM打印。

前端降低让主键成为向后缓升的触面，壳背最高位置后移约14 mm。保留90 mm底部长度，因此不能同时照搬Fenrir 75/81.7 mm的整机长度。后壳采用更少但更大的六边窗口；孔间、外围和主键后端仍有连续传力材料。主键与侧握区不布密孔。

前/后侧键纵向仍为距前33/47 mm，但中心高度分别从19.2改到16.5/18.8，以避开降低后的上壳内侧。键帽尺寸不变。滚轮顶从31降到25，轮轴与上部斜撑也重新布置；轮架根部保留。

## 2. 底部如何保证不变

源：`exports/v03/quietmirror_fingertip_V0.3_SHELL.step`。冻结整个 **Z≤6 mm** 区域，包含五脚、外围底筋、四条斜筋、传感器框、右托边、轮架根部和下壳带。V0.4仅在冻结平面上方增加0.6 mm过渡边并连接新上壳。底部并非重画的近似件。

对最终保存STEP分别截取同一区域，做旧减新、新减旧、交集体积和范围核对：

- FIT：旧减新 0.000000 / 新减旧 0.000000 mm³；SHELL：旧减新 0.000000 / 新减旧 0.000000 mm³。
- 接口Z=6上下0.01 mm处，39个纵向站位外边变化最大0.002267 mm；这不是整个曲面的光顺连续性证明。
- 过渡边顶Z=6.6附近保留小台阶，来自底部冻结与上壳略收窄的取舍；试握须检查是否硌指，轻修毛刺不应磨五脚面。
- 五个平台Ø8.8，中心与周边8点共45点均在Z0。贴上脚贴后需检查首层误差和脚贴厚度，数字共面不替代实物共面。

详细机器记录：[bottom_preservation.json](bottom_preservation.json)。底视图能穿过孔看到上壳变化，因而整张底视图不是逐像素相同；冻结部分的实体几何才是比较对象。

## 3. CAD、网格和壁厚

CadQuery源码及JSON均可编辑；STEP是有效B-rep，STL为0.02 mm线性偏差、0.15 rad角度设置导出的毫米网格。焊接容差0.000001 mm，移除退化/重复三角面；没有补洞、丢弃零散实体或通过切片器自动修复掩盖问题。

| 检查 | 结果 |
|---|---|
| FIT尺寸，XYZ | 61.987465 × 90.002465 × 28.002483 mm |
| FIT三角面 | 112,162 |
| FIT/SHELL/两个键帽 | 每件STEP有效、一个实体；STL封闭、一个连通分量、法线一致、自相交0 |
| CAD体积 | 18.653928 cm³，积分容差参数1e-9 |
| STL体积 | 18.577487 cm³ |
| 两种体积差异 | 0.4098%，保留实际差异 |
| 常规壳面壁厚 | 523点；最小1.71710，中位1.88055 mm |
| 小于1.6 mm的常规壳面样本 | 0 |
| 独立侧键内限位边 | 名义1.6 mm |
| FIT侧键固定小桥 | **局部1.2 mm**，仅固定触感位置 |
| 孔间平面筋距 | 3.000 mm；曲面上实际路径更长，不等于任意方向截面强度 |

壁厚采样沿原始外表面法线，避开底部、端缘、开孔、主键窄缝及侧键过渡附近。边缘附近的斜向短弦不当作法向壁厚。它是有限采样，不是连续全表面最小壁厚证明。没有做有限元、跌落、疲劳或真实夹持刚度测试。

原始记录：[validation.json](validation.json)、[cad_metrics.json](cad_metrics.json)、[切片器尺寸](slicer_model_info.txt)。

## 4. 侧键部件与装入路径

窗口12×6.6；键面10.8×5.4；导向段8.6×3.8；内限位边13.2×6.2×1.6。前/后键与壳体的静态最小间隙分别0.30000/0.21742 mm，布尔相交体积为0。打印误差会改变实际间隙；不得凭这个结果保证直接装入无需修整。

从底部中前开口送入，留在内部空间，先前后定位，再抬至侧键窗口高度，最后向外就位。建议路径按≤1.5 mm间隔做CAD离散相交检查，包含另一键已就位的情况。检查通过也不等于连续扫掠、手指工具可达或实物装配验收。[路径原始结果](side_button_insertion.json)

SHELL+独立键帽是接口原型，内侧可移除胶带临时防掉。没有设计真实弹簧、开关行程、预压或回弹。FIT版仍是一个实体，全部触感部位固定。

## 5. 打印和材料

使用PrusaSlicer 2.9.6实际切片。0.4 mm喷嘴 /0.2 mm层高 /4周壁 /20% gyroid /5层顶底。脚面朝下，仅热床有机支撑，4 mm裙边。FIT本体23.345 g，支撑14.934 g，裙边0.173 g，总计38.45 g，4h 50m 41s。比V0.3本体减少2.241 g（8.8%）。

3MF内嵌完整估算配置，导出后不另加载INI重新切片，关键设置16项一致。重量差-0.02 g、时间差46秒，保留实际差异。[打印说明](../../slicing/V0.4_PRINTING.md)、[刀路图](../../views/v04/09_slice_layers.png)、[3MF核对](3mf_roundtrip.json)

## 6. 试握与下一轮

优先比较握宽、低前端是否自然、壳背是否顶掌、右手指是否拖地、降低后的滚轮/侧键触达，以及抬鼠稳定性。[反馈表](FIT_FEEDBACK.md)

主板、镜头、编码器、侧键板、电池/插头、线束、USB-C、电源开关和天线均有独立估计包络。低前端增加了对主键开关和编码器布局的限制。当前无装配孔、镜头止口或真实光学高度，候选供体“ATK 蜻蜓 A1 Plus”的实际型号和PAW3950身份未确认。[具体干涉与待测尺寸](ELECTRONICS.md)

## 7. 历史版本

V0.1、V0.2、V0.3的模型、版本专用源码、参数、切片报告和图未被覆盖；V0.3原README另存为README_V0.3.md。共享帮助脚本只增加0.4入口，保留旧版本入口。[全部版本与整包下载](../../HISTORY.md)
