Quietmirror/github/reports/v02/DESIGN.md

# V0.2 设计思路与验证报告

日期：2026-10-14。状态：已生成STL、STEP和可编辑源码，完成软件几何检查和真实切片；尚未打印、试握或装电子件。

## 1. 这一轮解决的问题

V0.1采用独立接触片与外露支柱，适合检查手指落点，却不像完整鼠标。用户进一步提出“更接近游狼，不要过分镂空”。因此V0.2把主要结构改为连续薄壳，保留五脚、传感器定位区和可独立调整的接触区，优先让试握时的侧面、顶面和尾部都接近完整产品。

视觉参考选HSK / HTR短机身方向，来源与实际查看的产品图见[参考记录](../../references/GWOLVES_REFERENCE.md)。两款参考都存在蜂窝孔，本项目没有复制这些孔，而是把大窗口留在底部。模型也不是G-Wolves原厂CAD、扫描数据或某个供体的兼容外壳。

## 2. 外形如何形成

横截面采用超椭圆的上半部，经10个前后站位样条放样。与普通椭圆相比，顶部更平展，食指和中指有较完整的接触区域；侧面连续下落，夹持时不直接接触细杆。由外曲面向内偏移1.8 mm得到常规壁厚，避免把内外截面简单缩小导致斜面变薄。

前部有两个独立设置x/y/宽/长的主键区域，0.65 mm窄缝只用于识别边界。每侧保留5 mm宽的未切断桥，主键无法正常运动。曲面本身保持连续，主要指肚接触区没有孔阵。窄缝出口可能需要去毛刺；不能以这件模型测试主键行程或点击力。

中部腰线浅收，距前端46 mm、Z=13 mm的横向实测宽度约54.043 mm。相邻40/52 mm截面分别约55.641/54.654 mm，因此“54 mm握宽”对应特定夹持位置，不代表整个鼠标都等宽。拇指凸台位于左侧，右側低位托边为无名指、小指提供防拖地参考。主体XZ截面未做大角度倾斜，右手属性集中于触达件、托边及五脚的不对称布局。

后段从主要接触区向低尾部逐渐下降。与V0.1开放尾架相比，新版后部存在真实壳面，所以顶掌风险必须重新试握，不能从“短尾”直接推导舒适。90 mm长度、62 mm外宽、31 mm高度都是试验起点。

## 3. 承力、留空与五脚

夹持载荷由两侧连续壳面分散到低位周向框架，再传向前、中后、尾部五脚。底筋2.6×2.6 mm，斜筋和固定滚轮支撑Ø2.8 mm。滚轮轴有两侧落地支撑与连接顶壳的短筋，避免滚轮试触达只靠一根悬臂。

五个脚贴平台直径8.8 mm、厚2.4 mm，适配Ø7–7.5 mm圆点脚贴，粘贴面均为Z=0。平台间通过连续筋条连成实体。壳体下缘Z=1，低位底筋下缘Z=0.6，实际支承基准由五脚决定。脚贴本身另贴，不包含在导出几何里。

在Z=1.2 mm水平截面，材料面积1339.68 mm²、投影凸包5025.64 mm²，留空比例约73.34%。这是指定截面的面积比，并非整机体积减重率，也不是看穿顶部的面积。底面视图能看到上方壳面属于正常现象。

传感器区域保留14×18 mm开口及周边框、四向斜筋。该开口只给后续定位与空间检查使用，不包含真实镜头卡扣、光学止口或安装孔。

## 4. 原始验证数据

| 检查 | 结果 |
|---|---|
| CAD单位/坐标 | mm；X右、Y前、Z上，鼻端Y=0 |
| 保存STEP的实体数/有效性 | 1个，OpenCascade判定有效 |
| STEP外接尺寸，X/Y/Z | 61.989 × 90.000 × 31.000 mm |
| STEP实体体积 | 20556.808 mm³ = 20.557 cm³ |
| STL尺寸，X/Y/Z | 61.984 × 90.000 × 31.000 mm |
| STL体积 | 20582.777 mm³，三角化近似与CAD相差约0.13% |
| STL三角面/顶点 | 95,936 / 47,922 |
| 连通实体/封闭/法线一致 | 1 / 是 / 是 |
| 自相交面 | 0，PyMeshLab检测 |
| 边界边/非流形边/非流形点/网格孔洞 | 全部0 |
| 五脚共面 | 5脚×9点=45点，粘贴区采样Z全为0 |
| 常规曲面壁厚采样 | 867点，最小1.77474 mm，中位1.80249 mm |
| 切片器导入 | manifold=yes，parts=1，尺寸无单位放大 |

完整数据见[validation.json](validation.json)、[CAD记录](cad_metrics.json)、[切片器导入原文](slicer_model_info.txt)。网格导出仅合并0.00001 mm级重复顶点并去除25个退化面；没有补洞、删除连通块或靠网格修复掩盖断裂。

壁厚检查使用原始曲面局部法向发射射线。端缘、Z<5区域、距离窄缝2.4 mm以内及侧键圆角过渡被排除，因为射线会从边缘提前出界，此时弦长不是壳壁法向厚度。该检查支持普通面约1.8 mm，**不构成连续全局最薄壁证明**。底筋、侧键圆角、固定桥等由生成尺寸控制，仍需在实物中检查欠挤出、层间结合与毛刺。

## 5. 重量与打印取舍

V0.1本体切片约18.528 g，V0.2约25.851 g，增加7.323 g（约39.5%）。新增连续外壳提高了触感连续性和承力覆盖；这不是以克数为唯一目标的终版。后续应先确定舒适位置，再有针对性地减薄内部低应力区。

PrusaSlicer2.9.6、PLA密度1.24 g/cm³、1.75 mm丝材、0.4 mm喷嘴、0.2 mm层高、4道周壁、20%gyroid、5层顶底。树状支撑仅热床、45°阈值，Z接触距离0.2、XY距离0.35、3层支撑界面，4 mm外裙边。

- STL+INI实际切片：本体25.851 g，支撑18.383 g，裙边0.173 g，总量44.41 g，14.889 m丝材，155层，5小时18分06秒。
- 最终3MF直接重切片：44.63 g，5小时20分19秒，16项关键设置一致。差0.22 g / 133秒，保留独立估算，不宣称刀路逐字节相同。
- 已提供实际刀路截面图；没有向任何打印机发送G-code。自己的机型、耗材温度和速度需在切片器确认。

五脚朝下打印，保护手指接触面；内顶壳、滚轮/轴、侧键和托边下方需要支撑。底部大窗口提供拆支撑入口，但尚未实物确认拆除难度。若单一耗材支撑难拆，优先调整支撑界面或使用可溶支撑；不要为了拆除而剪断承力筋。前部壳边、窄缝出口轻修毛刺；主接触面不做大幅磨削。

## 6. 当前局限与下一轮

低尾部与估计电池包络产生567.55 mm³相交；主板后部、编码器、侧键板等也需要重新布局，详见[电子报告](ELECTRONICS.md)。这不阻止试握件打印，但阻止把当前模型当作装配外壳。

手部数据只有AR估计手长230、张开跨度190；未将跨度当成掌宽，未使用Kotinos作者的指节尺寸。下一轮依据试握反馈分别调整握宽、侧壁腰线、尾高、指托、滚轮和两个侧键位置，一次优先改变一个主要变量。反馈表见[FIT_FEEDBACK.md](FIT_FEEDBACK.md)。

参数化不等于任意参数组合都能生成有效实体。邻近组合检查结果和实际失败也记录在[参数检查](parameter_smoke_check.json)；调整后必须重新检查布尔实体、网格和切片，不能沿用本报告数字。
