Quietmirror/github/reports/v02/slicer_model_info.txt

[quietmirror_fingertip_V0.2.stl]
size_x = 61.984272
size_y = 90.000000
size_z = 31.000000
min_x = -30.984272
min_y = -90.000000
min_z = 0.000000
max_x = 31.000000
max_y = 0.000000
max_z = 31.000000
number_of_facets = 95936
manifold = yes
number_of_parts =  1
volume = 20582.800781
