Quietmirror/github/references/V0.8_REFERENCE_NOTES.md

# V0.8 实际查看与采用的结构

本轮读取了已有的 `FENRIR_REFERENCE.md`，并实际查看先前保存的官方 Fenrir Pro/Asymmetric 产品图：`.reference/v04/fenrir_pro_1.png`、`.reference/v04/fenrir_asym_1.png`；同时访问了 [G-Wolves Fenrir Pro 官方页面](https://shop.g-wolves.com/products/g-wolves-fenrir-pro-8k-wireless-mouse)。原图只在本地作为造型参考，不作为开源项目素材重新授权或分发。

采用的是细长双侧键贴随侧壳、外端圆润、中央分隔清楚、外凸量小的外形方向。V0.8 的尺寸不是从照片反推的产品实测值；本项目独立生成组合带和曲面差集，没有复制商业 CAD。

主键恢复项目 V0.6 的 23 mm 宽度，保留 V0.7 的 27 mm 短长度，改用独立的连续放样触感面。框架前沿退开，避免框住键帽前端。后壳 12 个对称孔沿用项目 V0.6 的参数化孔形，前部开孔按恢复宽度后的可用面积重新生成。

既有开源调查、实际读过的 CAD/STL/SCAD 路径与署名见 [原参考记录](REFERENCE_REVIEW.md)、[Fenrir 参考记录](FENRIR_REFERENCE.md) 和 [NOTICE](../NOTICE.md)。所有旧版本保留。本轮原创修改继续采用仓库 CERN-OHL-P-2.0 许可证。
