Quietmirror/github/references/V0.7_REFERENCE_NOTES.md

# V0.7 参考与来源边界

本轮参考图实际查看日期：2026-10-15。原始人体尺寸仍为近似值；没有新增掌宽、指节长度或真实握姿测量。

| 资料 | 本轮实际查看 | 采用内容 | 未采用、未证实内容 |
|---|---|---|---|
| [Razer Viper V3 Pro 中文官网](https://cn.razerzone.com/gaming-mice/razer-viper-v3-pro) | 产品说明与[官方侧视图 angle_1.webp](https://assets2.razerzone.com/images/pnx.assets/474a68bae599387eb85e884c484e9ce3/angle_1.webp) | 两个相邻、细长、端部收窄的侧键轮廓，接近同一高度，适度凸起以便拇指辨认 | 没有从照片反推精确尺寸；没有复用商业 CAD 或开关结构；参考其侧键外形不代表采用 Razer Sync 或电子方案 |
| [ALPS SKHHAKA010](https://tech.alpsalpine.com/e/products/detail/SKHHAKA010/) | 厂家公开产品页：6×6×5 mm、0.25 mm 行程、0.98 N 操作力 | 机械试按套件的开关空间示例；打印托架、导向、挡片为原创 | 没有选定最终鼠标主板 BOM；没有证明此轻触开关等同于游戏鼠标主键手感；没有使用需要账户的厂家 CAD |
| [Omron D2F 官方资料](https://omronfs.omron.com/en_US/ecb/products/pdf/en-d2f.pdf) | 下载并查看第 4 页柱塞开关尺寸图 | 用于比较传统鼠标微动的机械接口 | 未纳入本版默认托架；不可将 D2F 装进 6×6×5 mm 的轻触开关托架 |
| [FreeCAD Assembly 官方文档](https://github.com/FreeCAD/FreeCAD-documentation/blob/main/wiki/Assembly_Workbench.md) | 内置装配工作台、固定/滑动/转动关节说明 | 推荐后续以真实零件建立装配关系、调整轴线和行程 | 本轮未运行 FreeCAD GUI、没有生成或验证 FreeCAD 装配求解结果 |

`v3p` 本轮按 **Viper V3 Pro / 毒蝰 V3 专业版**理解。侧键尺寸和位置属于本项目针对短指握外壳的设计选择，不是雷蛇侧键的实测复制。

本轮直接阅读和复用本仓库 `build_v06.py`、`build_v05.py`、`build_v03.py`、`vent_layout_v06.py`、`electronics_v06.py` 以及对应参数、验证和渲染工具。底部直接取自已发布的 V0.6 SHELL STEP；外形放样沿用 V0.6 的毫米参数。

olliebella、Kotinos、paw3395-pcb 与 Fenrir 的早期查看记录、来源、署名和许可证继续保留在历史版本及本目录原有资料中。本轮没有宣称重新验证这些上游 CAD 的每个尺寸；也没有将 Kotinos 的 HSK Pro 孔位或 PAW3395 板直接当作 PAW3950 装配尺寸。

雷蛇及开关厂家的参考照片/PDF没有作为本仓库开源资产重新分发。仓库预览是本项目实际 STL 渲染。新 CadQuery 几何、参数与机械结构沿用仓库的 CERN-OHL-P-2.0 许可，既有许可证和署名保持不变。
