Quietmirror/github/reports/v06/FIT_FEEDBACK.md

# V0.6 试握记录

手部数据仍是230 mm腕到中指尖、190 mm张开跨度的照片近似值；不是掌宽。先记录打印机、材料、方向、缩放、去支撑与脚贴厚度。

| 项目 | 记录 |
|---|---|
| 有效握宽 | 夹持点距前端位置、偏宽/偏窄、拇指及无名指压力点 |
| 顶掌 | 静止/移动/抬鼠时尾部是否碰掌；是否希望缩短或降低 |
| 手指拖地 | 取消托边后，无名指/小指是否拖垫，哪个位置最明显 |
| 滚轮触达 | 中指/食指滚动是否需改变握姿；本版轴降低1.2 mm后的感觉 |
| 双侧键 | 前后键触达、误碰、需移动拇指的距离 |
| 抬鼠稳定 | 低速、快速转向和反复抬鼠是否打滑；是否夹得更用力 |
| 窄筋与边缘 | 是否压手、毛刺、明显弹性或裂纹；去支撑是否困难 |
| 充电口/开关 | 插头胶壳触达、底部操作空间；示意接口不能代替实测插拔 |

本轮主键/侧键/滚轮固定，不评价真实点击力度、回弹和编码器手感。发现裂纹或强烈局部压痛后停止用力试握，记录照片与位置再改模型。没有以 AR 近似值伪造掌宽或指节数据。
