Quietmirror/github/reports/v05/ELECTRONICS.md

# V0.5 电子参考包络、干涉与待测尺寸

本轮完成外形试握模型和独立侧键接口原型。目标为PAW3950、2.4 GHz无线1000 Hz、五按键与滚轮。候选供体仍按用户称呼记作“ATK 蜻蜓 A1 Plus”，具体型号、传感器版本、PCB轮廓和孔位未确认；自主主板也没有定版。

PAW3950只说明传感器型号，不规定主板尺寸。无线1K由主板、固件和匹配接收器共同实现。本轮没有验证射频、固件、接收器配对或供体传感器。没有设置估计螺孔、镜头止口或卡扣。

## 1. 分开的16个参考包络

单位mm。X向右，Y向前，Z向上；前端Y=0，后端Y=-90，脚贴粘贴基面Z=0。每个包络是轴对齐的长方体，位置全部为估计。

只有badjeff/paw3395-pcb裸板外框来自源文件：KiCad为15.45×28，README为15.5×28、厚1.6；这里使用15.5×28×1.6参考框。它不是完整无线主板，也不是用户供体实测值。其余尺寸均为预留假设。

| # | 包络 | XYZ尺寸 | XYZ中心 | 依据 |
|---|---|---|---|---|
| 01 | 主板及元件 | 38 × 46 × 6 | 2, -49, 13 | 估计包络 |
| 02 | 参考传感器裸板 | 15.5 × 28 × 1.6 | 0, -48, 7.5 | 参考裸板外形；摆放估计 |
| 03 | 传感器封装 | 12 × 12 × 4 | 0, -48, 5.5 | 估计包络 |
| 04 | 镜头 | 12 × 14 × 3.2 | 0, -48, 2.6 | 估计包络 |
| 05 | 滚轮旋转范围 | 6.4 × 16.4 × 16.4 | 0, -17, 17.5 | 估计包络 |
| 06 | 编码器 | 5 × 12 × 12 | -8, -17, 15 | 估计包络 |
| 07 | 中键机构 | 6 × 6 × 6 | 7, -17, 12.5 | 估计包络 |
| 08 | 左主键开关 | 6 × 13 × 7 | -16, -22, 23 | 估计包络 |
| 09 | 右主键开关 | 6 × 13 × 7 | 16, -22, 22 | 估计包络 |
| 10 | 两侧键板 | 3 × 27 × 9 | -22.5, -40, 19 | 估计包络 |
| 11 | 电池 | 24 × 18 × 6 | 2, -63, 22 | 估计包络 |
| 12 | 电池插头 | 8 × 6 × 4 | 14, -61, 19 | 估计包络 |
| 13 | 线束通道 | 4 × 34 × 5 | -15, -43, 18 | 估计包络 |
| 14 | USB-C及插头 | 12 × 16 × 6 | 0, -5, 8 | 估计包络 |
| 15 | 电源开关 | 8 × 5 × 5 | 10, -68, 6 | 估计包络 |
| 16 | 天线净空 | 18 × 15 × 12 | 4, -76, 16 | 估计包络 |

[包络STEP](../../exports/v05/electronic_envelopes_V0.5_ESTIMATES.step) · [内部斜视](../../views/v05/06_envelopes.png) · [带尺寸的俯视/侧视布局](../../views/v05/08_envelope_layout.png)

## 2. 与当前打印件的实际几何相交

以下数字是用估计包络与CAD部件做布尔交集得到的体积，不能当作实测器件的碰撞量。无相交也不证明已获得安装、公差或拆装空间。

| 包络 | 当前相交部位 / mm³ |
|---|---|
| 主板及元件 | final_shell_without_side_caps：18.644 |
| 参考传感器裸板 | 该简化包络未检测到壳/筋相交 |
| 传感器封装 | 该简化包络未检测到壳/筋相交 |
| 镜头 | 该简化包络未检测到壳/筋相交 |
| 滚轮旋转范围 | final_shell_without_side_caps：906.682 |
| 编码器 | final_shell_without_side_caps：177.516 |
| 中键机构 | final_shell_without_side_caps：31.323 |
| 左主键开关 | final_shell_without_side_caps：112.539 |
| 右主键开关 | final_shell_without_side_caps：140.731 |
| 两侧键板 | final_shell_without_side_caps：236.251；fixed_side_cap_1：96.778；fixed_side_cap_2：96.778；fit_only_cap_tack_1：3.840；fit_only_cap_tack_2：1.200；fit_only_cap_tack_3：1.200；fit_only_cap_tack_4：3.840 |
| 电池 | final_shell_without_side_caps：153.686 |
| 电池插头 | 该简化包络未检测到壳/筋相交 |
| 线束通道 | 该简化包络未检测到壳/筋相交 |
| USB-C及插头 | final_shell_without_side_caps：130.137 |
| 电源开关 | 该简化包络未检测到壳/筋相交 |
| 天线净空 | final_shell_without_side_caps：170.357 |

必须处理的布局问题：

1. **电池**：当前放在后部较高的位置，明显穿入下降的尾壳。需要换薄电池、向前/向下移动、改变主板布局，或局部增加壳高；后者可能重新造成顶掌。建议先实测电池、保护板、导线焊点和胶垫总尺寸，再评估放在前中部、主板上方的方案，当前没有批准该方案为可装。
2. **主板后端**：估计38×46×6框需按本版报告核对；简化包络无相交不证明板上器件可装。需缩短板型、前移或降低；板上最高器件应单独分层建模，不能只用PCB板厚。
3. **编码器、中键和主键**：现有固定滚轮支撑与轮轴属于试握占位。装配版删除占位件，按真实编码器、轴位、中键机构、开关顶高重建支座；不能把固定件相交简单误判成电子件永远装不进。
4. **侧键板**：估计板框与侧壳、导向台或键帽限位边相交。需要更薄或更靠内的板型、独立支座与真实按键行程空间，当前独立键帽也不是开关机构；装配版要按实际板位重新设计键帽受力点、行程、回弹及限位。
5. **USB-C**：当前鼻部封闭，相交属预期。实际端口和插头插入余量确认后开孔并补边框；本轮没有假开一个装配孔。
6. **天线**：红框是保守的预留区域，穿过塑料壳并不等价于射频失败；真实天线需按PCB/模块规范检查附近铜、金属、电池与介质影响。当前电池、主板和该框存在重叠，不能认为RF净空已落实。

## 3. 包络之间的相交

| 包络A | 包络B | AABB重叠体积 mm³ |
|---|---|---|
| 主板及元件 | 线束通道 | 68.000 |
| 主板及元件 | 天线净空 | 378.000 |
| 参考传感器裸板 | 传感器封装 | 115.200 |
| 传感器封装 | 镜头 | 100.800 |
| 滚轮旋转范围 | USB-C及插头 | 45.696 |
| 编码器 | USB-C及插头 | 2.000 |
| 左主键开关 | 线束通道 | 10.000 |
| 电池 | 电池插头 | 48.000 |
| 电池 | 天线净空 | 189.000 |

传感器、镜头和参考裸板框可能因定义包含基座或封装区域而重叠；这些粗框不是精细实体，必须用真实尺寸替换再判断。电池、线束、插头与天线的冲突则提示当前布局需要重排。

## 4. 光学高度尺寸链

传感器轴线沿Z，必须垂直鼠标垫。设五个塑料脚贴粘贴面为Z=0，脚贴及胶层压缩后的总厚度为`t_skate`，则垫面为Z=`-t_skate`。

```text
z_optical_datum = h_PCB_bottom - d_PCB_to_optical_datum
H_datum_to_pad  = h_PCB_bottom - d_PCB_to_optical_datum + t_skate
```

`h_PCB_bottom`是PCB下基准相对粘贴面的高度，`d_PCB_to_optical_datum`按真实镜头/主板组合确认。光学基准不是随便取镜头最低角点；目标高度、公差和垂直度应使用真实镜头/传感器资料或实测供体尺寸链。olliebella中约2.4±0.2 mm是其项目尺寸，不能直接套作PAW3950统一要求。

## 5. 装配版必须补测

| 部位 | 需要的实测信息 |
|---|---|
| 供体身份 | 底部标签/准确商品型号、PCB丝印、传感器标记、主板正反面 |
| 主板 | 外轮廓、厚度、上下最高器件、每个孔中心坐标/孔径、定位基准、接口方向 |
| 传感器与镜头 | 型号、真实光轴位置、镜头止口/卡位、PCB至镜头光学基准高度、供体垫面尺寸链 |
| 主键 | 开关外形、柱塞顶高、行程、预压、受力点和螺柱避让 |
| 滚轮/编码器/中键 | 轮径/宽、轴长/直径、编码器高/厚/轴位、中键机构位移及旋转间隙 |
| 侧键板 | 板形/厚度、两开关中心、开关高与行程、排线出口、可拆装方向 |
| 电池与插头 | 电芯+保护板尺寸、胶垫、线束弯曲半径、插头规格/极性/拔插余量 |
| USB-C | 端口壳尺寸、PCB偏移、插头外壳插入空间及壳边厚度 |
| 电源开关 | 本体、拨杆行程、可触达位置、安装和操作余量 |
| 天线 | 主板/模块参考净空、天线方向、周边铜/金属限制、匹配接收器 |
| 五脚与打印 | 脚贴实际压缩厚度、打印XY/Z偏差、五脚贴上后的实际共面 |

半组装自主板也需要上述机械、射频和固件数据。确认后再设计拆分上下壳、螺柱/卡扣、电池固定、线束应力释放、可动按键和可拆装路径，并检查变形与装配顺序。
