Quietmirror/github/reports/v03/DESIGN.md

# V0.3 设计思路与验证报告

状态：已生成STL、STEP、3MF、源码和参数，完成几何检查及PrusaSlicer切片；尚未实物打印、试握、装配电子件或测量强度。单位mm。最新文件入口见[项目首页](../../README.md)。

## 1. 本轮需求如何落到几何

### 侧面更平顺

V0.2在中部明显内收，后部再外鼓，容易把手指限制在一个特定腰点。V0.3将距前端约30–60的左右半宽改为接近平直的控制段，用PCHIP插值辅助构造放样，减少宽度来回变化，保留前部过渡和短低尾部。它仍是有圆滑横截面的鼠标壳，未将接触面改成生硬锐角方盒。

在Z13、距前端32–60每2 mm采样，V0.2宽度范围差4.879 mm，V0.3为0.963 mm。距前端46的夹持外跨从54.043变为53.606 mm。该数字只描述几何，不证明更适合用户；首轮应检查平侧面是否更易移动手指，以及抬鼠时是否需要过度用力。

最大外宽仍约62，前端较宽、夹持带约54，保持初版试握假设。右侧低位托边和无名指、小指支撑保留。没有用230 mm手长放大整壳；190 mm张开跨度没有被当作掌宽。

### 预留侧键并交付独立部件

两个窗口中心距前端33 /47，高度Z19.2，窗口12.0 ×6.6、圆角R1.7。键面10.8 ×5.4、接触边R1.1；单边间隙0.6。内导向台与壳体相连，键帽内侧有13.2 ×6.2 ×1.6限位边，沿前后方向大于窗口，防止向外脱出。导向段8.6 ×3.8。

默认静态最小壳—键间隙：前键0.30、后键0.20；最近位置不一定在窗口平直边，因此不能只用0.6名义边隙代表全局间隙。两键最近间距0.80。三个实体相互无体积相交。

保留两种用途：

- **FIT**：同样外形的键帽通过内侧四处短连接固定到壳体，整件单一实体，直接测试侧键触达。
- **SHELL + 两键帽**：去掉固定连接和键帽，仅保留窗口和导向台，三个单件分别打印，测试拆分接口。

还没有微动开关、回弹机构、预压或受力柱。限位边轴向0.3间隙不是开关行程；不能凭它推导点击力。临时固定可使用内侧可移除胶带，不将摩擦或胶带模拟成真正回弹。

### 镂空集中在后壳

按键和主要指肚接触面继续保持连续。距前端54、66、78布置4+4+2个圆角六边孔；每孔由宽9、构造长度9的六边形生成，顶点角度每60°，轮廓内角R0.9。构造长度不是开口最终外接高：竖向尖角坐标乘sin60°，并有圆角收缩，具体轮廓以CAD为准。

未倒圆六边轮廓之间的最短平面距离为3.0，实际倒圆会增大部分局部距离。外围壳圈、左右中段夹持带、主键连接桥、轮架和底筋保留。镂空只切壳皮，再与内部结构组合，所以从孔里看到筋条是保留的传力结构。

孔阵取Finalmouse规则孔列的方向；Mini SE用于“完整前键和侧握区、后部多边形骨架”的分区参考。没有照搬镁合金大窗口比例或商品薄壁数值。[实际查看资料](../../references/FINALMOUSE_MINISE_REFERENCE.md)

## 2. 壳体构造与承力

新的平顺轮廓直接调用CAD内核厚壳偏置时，曾静默返回近似实心体。该结果未采用。最终用外壳放样减去独立内腔放样，内截面按曲面纵向斜率补偿，并在1.8目标壁厚上留0.08计算余量；这是数值近似法向偏置，必须检查导出网格的真实壁厚。

尾部内腔止于距前端81，末端低尾根加实。这样避免内腔与底筋相切生成细碎薄片，也保留后脚承力连接。五个脚贴平台Ø8.8、厚2.4，粘贴面统一Z0；底框宽/高2.6，斜筋和轮架直径2.8，右侧托边名义厚2.8。轮和主键仍固定。

夹持力通过连续侧壁、侧壁到底框的连接、周框和五脚传递。轮架有下部斜撑和上部连接，后孔不切断这些支架。没有做有限元分析或实物扭转测试，不能把承力路径设计称为强度已验证。

## 3. 最终实体和网格检查

| 检查 | 结果 |
|---|---|
| FIT实际STEP尺寸XYZ | 61.98858 ×90.00000 ×31.00000 |
| FIT实际STL尺寸XYZ | 61.98746 ×90.00000 ×31.00000 |
| FIT CAD体积，高精度积分容差1e-7 | 20,422.160 mm³ |
| FIT STL体积 | 20,409.338 mm³；与CAD差0.063% |
| SHELL CAD体积 | 19,497.049 mm³ |
| 每个键帽CAD体积 | 457.754 mm³ |
| FIT网格 | 109,408面、54,632点 |
| 四个单件STEP | 全部有效、各1实体 |
| 四个单件STL | 全部封闭、法线一致、各1连通部分、自相交0 |
| FIT非流形/边界 | 非流形边0、非流形点0、边界边0 |
| 五脚共面 | 5 ×9=45个射线样本，首个底面交点全部Z0 |
| 底部开放率 | Z1.2截面相对XY凸包约71.276%；不是整个壳的表面积开孔率 |

CAD默认快速积分对这一类复杂放样的体积曾与网格差较大，最终统一使用`Volume(tol=1e-7)`复核。切片重量使用实际STL刀路计算，不由CAD体积简单换算替代。

STL仅进行了1e-6 mm量级坐标合并、去除退化/重复三角形，没有补洞，也没有丢弃不连通碎片。`isValid()`单独不能证明可打印，因此另做网格和切片检查。[完整原始数据](validation.json) · [CAD参数和接口](cad_metrics.json)

## 4. 壁厚、边缘和侧键装入

在原外表面按面积定种子采样，再沿局部法向穿过实际最终STL。排除端缘、Z低于5、主键/滚轮/孔边2.4 mm范围和侧键过渡，以避免把边缘擦过的短弦当作普通壳壁厚度。

- 有效常规壳壁样本620个；最小1.657，中位1.879，最大4.881（局部结构重叠）；没有样本低于1.6。
- 独立键帽限位边名义厚1.6；导向段最小名义高3.8；接触面边R1.1。
- FIT专用固定连接为1.2 ×1.6 ×4的短块。**1.2 mm是本轮明确存在的较薄局部尺寸**，约3条0.4喷嘴路径宽；这些连接固定键帽，不能反复当可动按钮压弯。
- 六边孔内角R0.9；普通接触面连续光顺。前缘、主键窄缝和孔口没有全部做R1–2的三维滚边，需去支撑后轻修毛刺。

采样结果不能当作全表面连续最薄壁证明，也不能证明层间强度。首印检查侧键小连接、尾根、孔边、轮架、侧壁—底框连接的缺料和裂纹。

侧键建议由开放底部中前部送入，先进入内腔，再移动到各自前后位置，在离侧壁更远的位置抬高到窗口高度，最后向外推入。贴着侧壁直接向上抬会撞到导向台，不能硬推。源码记录了一条名义装入路径，两键分别48 /57个CAD位置样本，均与壳体及已就位的另一个键无体积相交；相邻样本位移不超过1.5 mm。[路径数据](side_button_insertion.json)

这是离散位置验证，不是连续扫掠体检查；未包含打印误差、支撑残留或电子元件。实际装配如果发涩，先去毛刺和检查窗口，勿强压。

## 5. 减重和切片结果

本轮同形未开孔壳与开孔壳的高精度体积差为1,182.549 mm³，约1.183 cm³；按PLA密度1.24折算1.47 g。这是孔阵移除量，不能直接从V0.2总重量扣除：侧键接口、尾根和曲面构造同时变化。

PrusaSlicer2.9.6：0.4喷嘴、0.2层高、4周壁、20% gyroid、5顶底层、PLA1.24、有机支撑仅从热床、4 mm裙边。FIT本体25.586 g，支撑16.116 g，裙边0.173 g，切片器总量41.87 g，预计5h13m20s。相同主要设置的V0.2本体25.851 g，本轮减少0.265 g。

SHELL本体24.415 g、含支撑40.65 g；键帽各本体0.579 g、总量0.91 g。分开打印三件的总耗材估算42.47 g（时间约5h25m01s，为三个独立任务相加，不是同盘任务的准确估计）。

最终3MF重切片未加载外部INI，16个关键配置一致；得到41.83 g /5h13m07s，和STL+INI差-0.04 g /-13s。小差异如实保留，不称逐字节一致。[详细打印朝向、支撑和复现命令](../../slicing/V0.3_PRINTING.md)

## 6. 电子装配仍需哪些决策

目标仍为PAW3950、2.4 GHz无线1000 Hz、五按键与滚轮。候选“ATK 蜻蜓 A1 Plus”的准确型号、传感器版本及PCB未确认。三个开源参考的原生PCB孔位均没有被当成供体孔位；PAW3950没有统一主板尺寸。

当前估计侧键板与加强导向台和键帽内侧结构明显相交。独立键帽解决了拆分接口，并未解决电子件安装：要确认板型、开关方向、柱塞顶高、受力点、行程和回弹，再减少内侧体积或调整侧键板。电池估计框与尾壳相交约375 mm³，仍需要更薄、更低或更靠前的布局；不能因后壳开了孔就认为电池可装。

主板、传感器/镜头、轮/编码器、侧键板、电池/插头、线束、USB-C、电源开关和天线共16个独立参考框继续保留。光轴沿Z垂直鼠标垫，真实光学高度必须建立PCB、镜头光学基准、塑料粘贴面和脚贴压缩厚度尺寸链。完整清单和每项相交结果见[ELECTRONICS.md](ELECTRONICS.md)。

## 7. 下一轮以实物反馈推进

先打印FIT，评价平侧面是否舒适、是否顶掌、手指是否拖地、侧键/滚轮触达、抬鼠稳定性、孔边是否接触手指。需要单独评估键帽形状和装入时，再打印SHELL与两个键帽。按[反馈表](FIT_FEEDBACK.md)一次只调整一两项参数，不同时改握宽、侧键高度和壳高，以免无法判断改动效果。
