Quietmirror/github/views/02_top.png

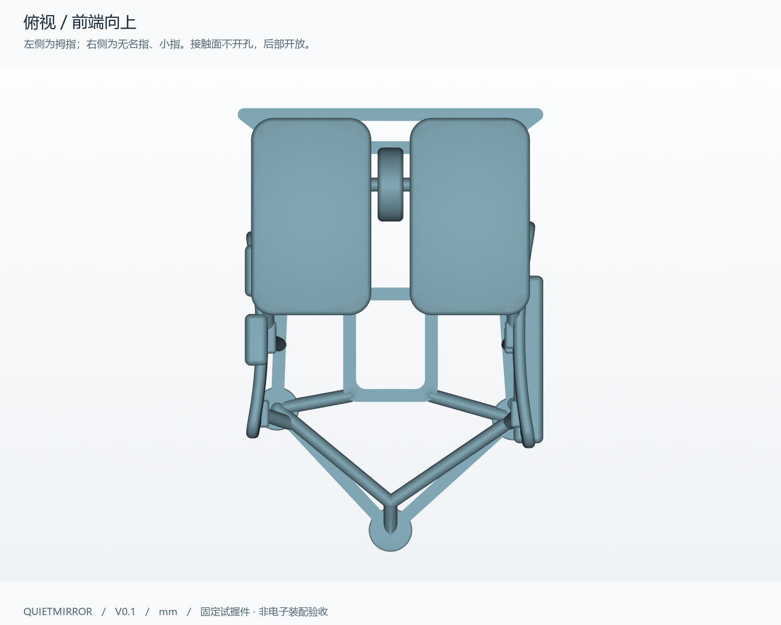
views/02_top.png
