Quietmirror/github/views/03_left_side.png

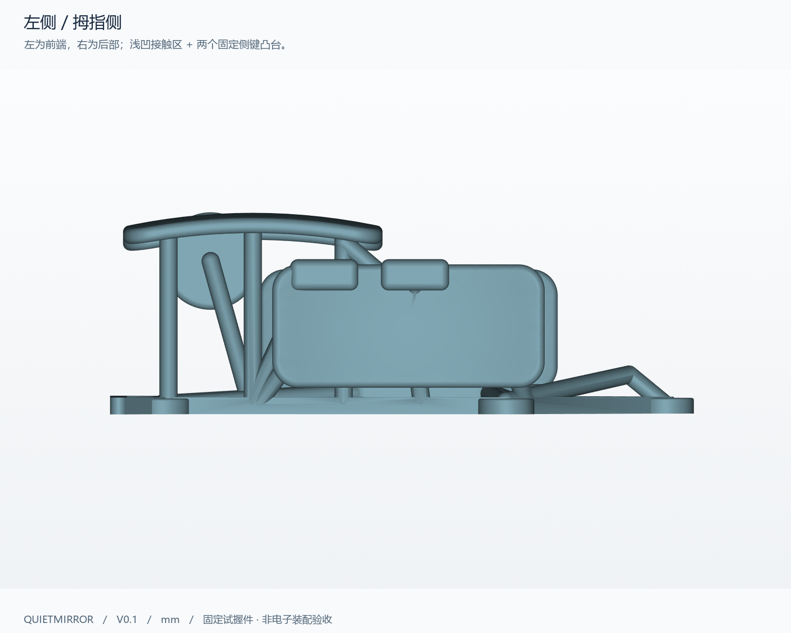
views/03_left_side.png
