Quietmirror/github/views/05_right_side.png

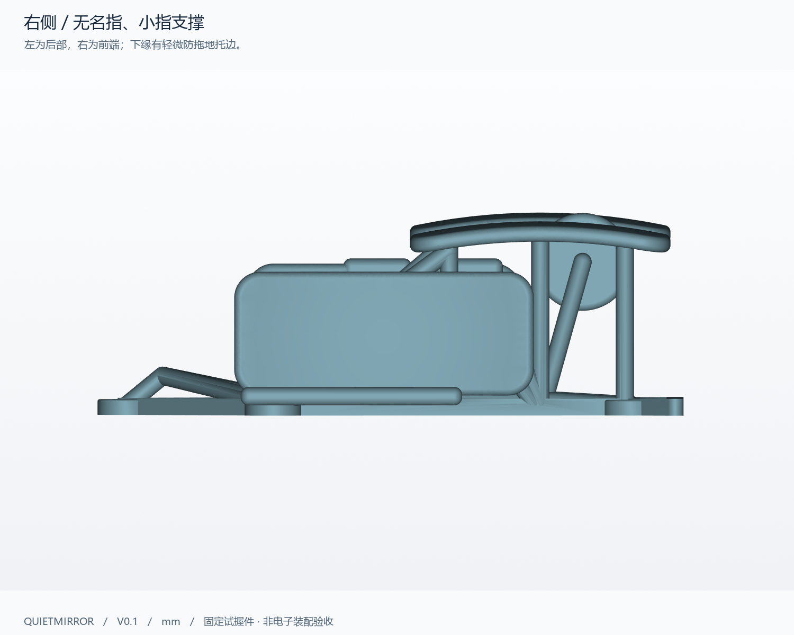
views/05_right_side.png
