Quietmirror/github/views/06_envelopes.png

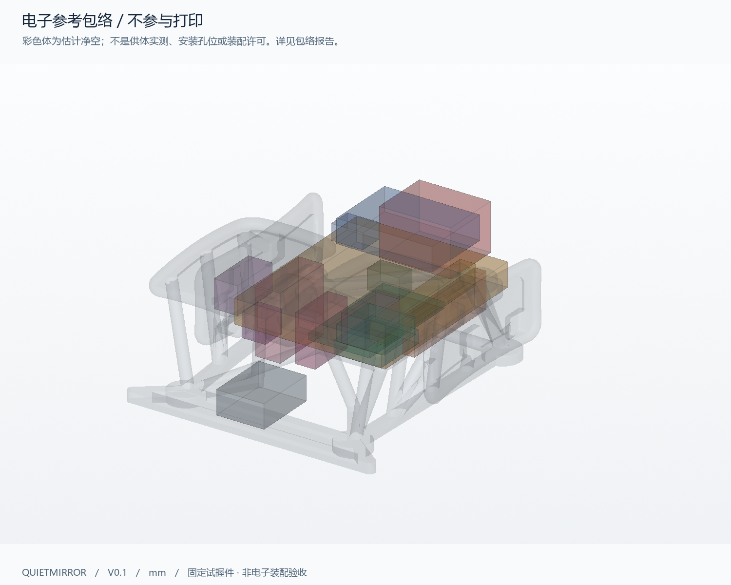
views/06_envelopes.png
