Quietmirror/github/views/07_dimensions.png

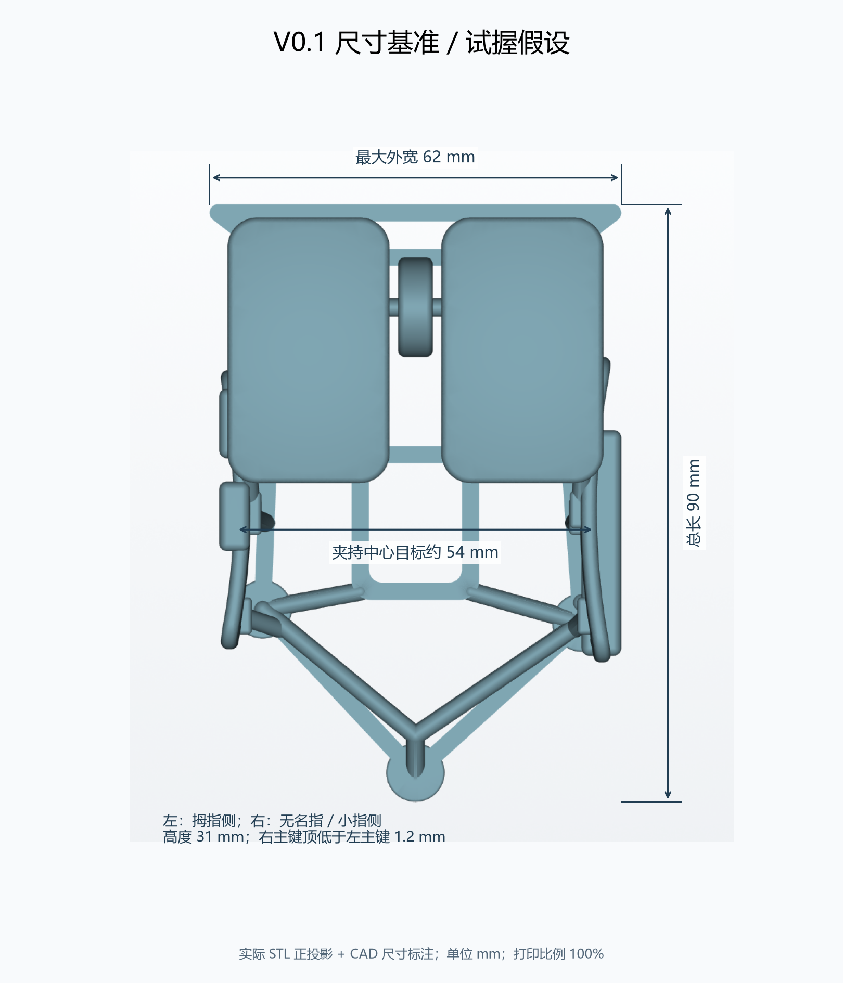
views/07_dimensions.png
