Quietmirror/github/views/08_envelope_layout.png

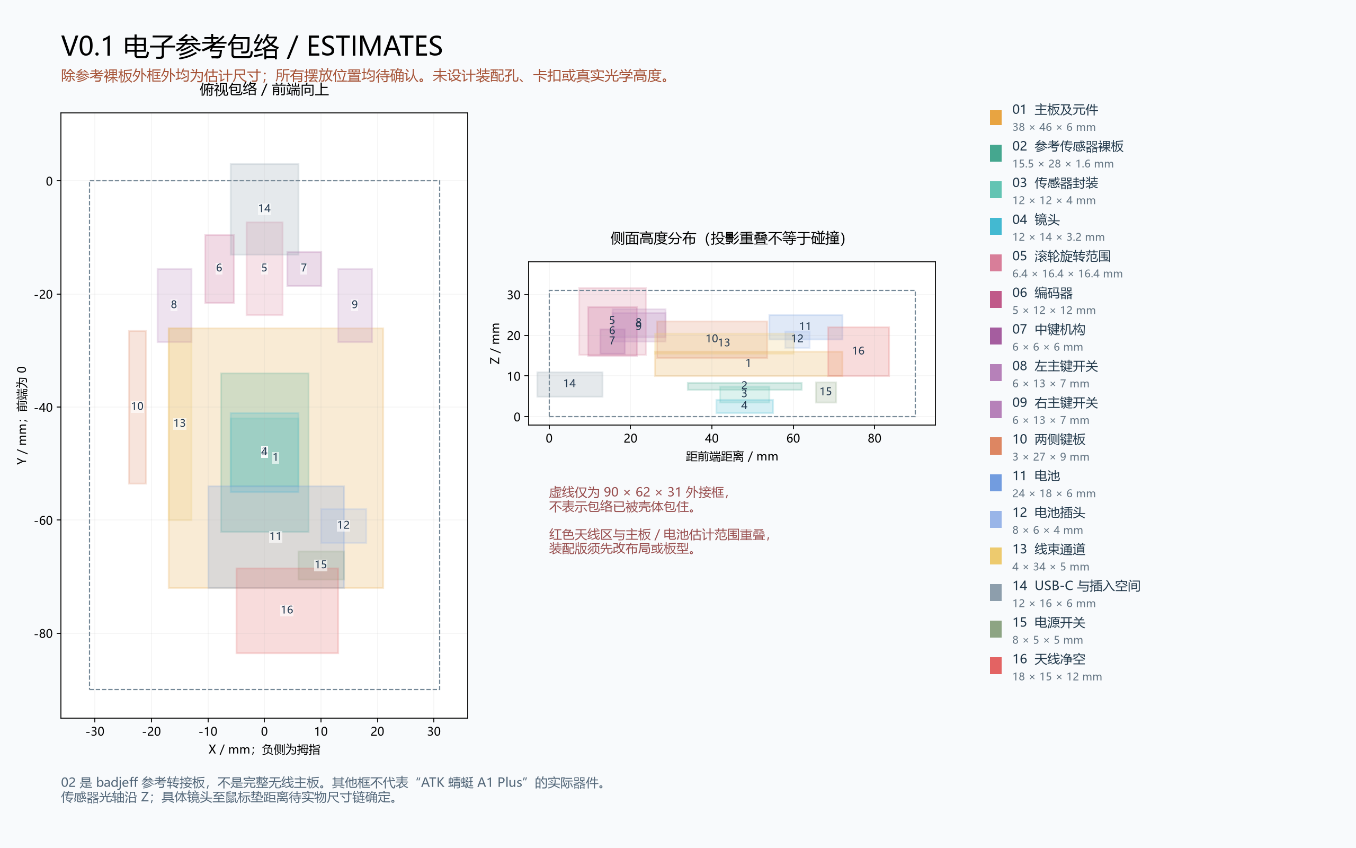
views/08_envelope_layout.png
