Quietmirror/github/views/09_slice_layers.png

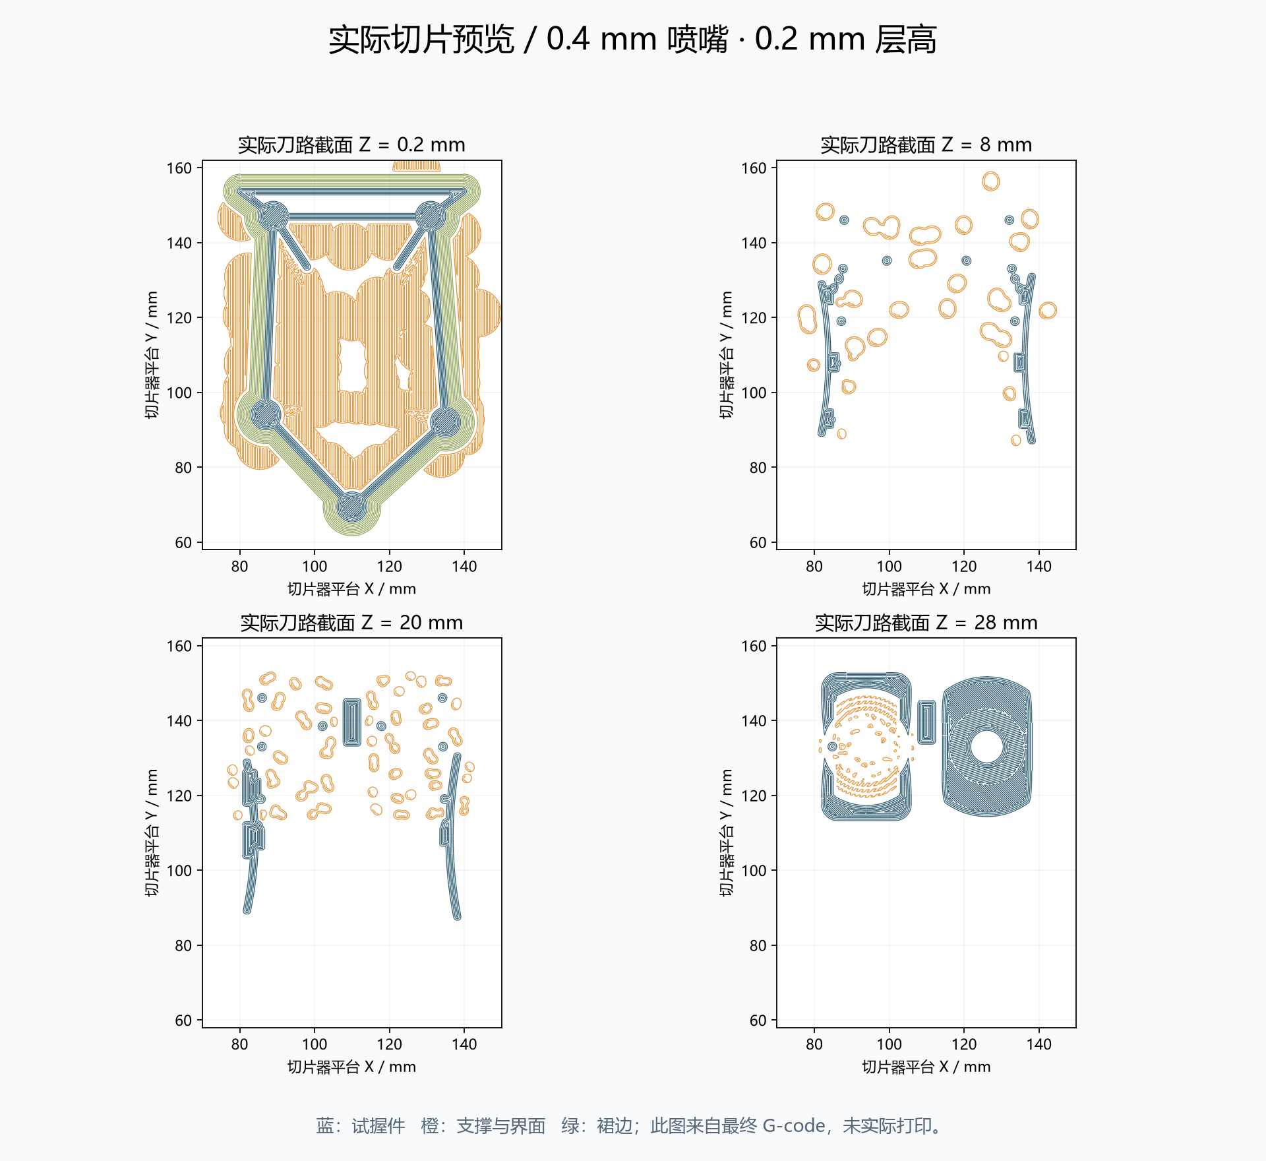
views/09_slice_layers.png
