Quietmirror/github/views/l2_revision/F1H/LC4_stress.png

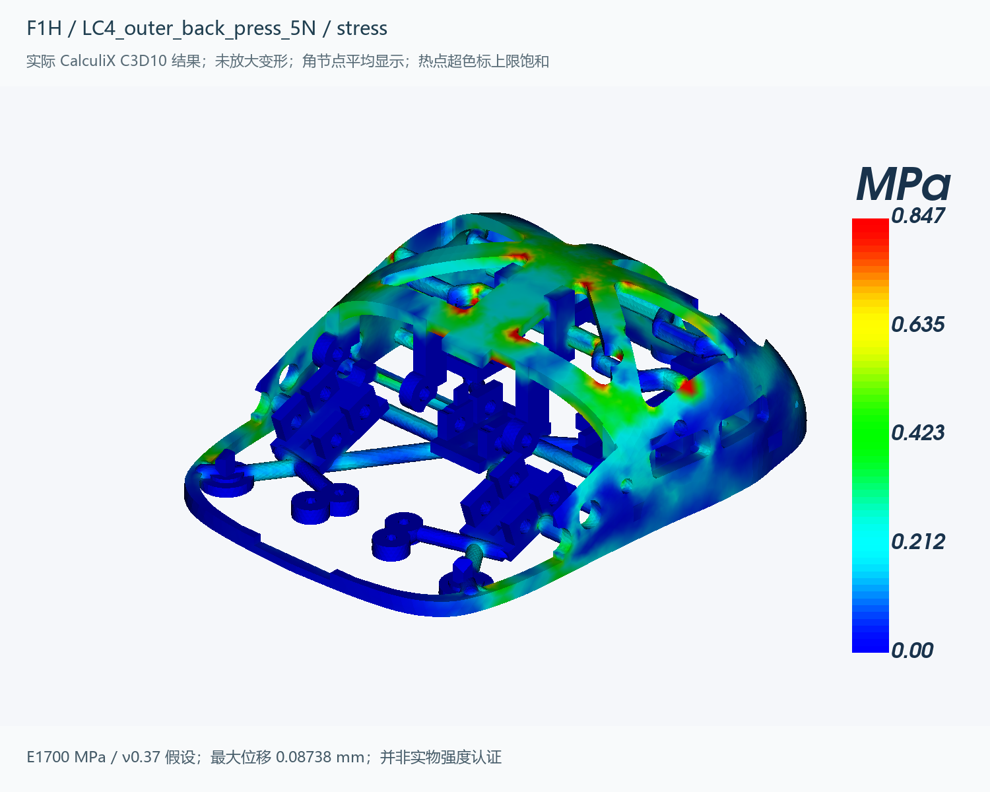
views/l2_revision/F1H/LC4_stress.png
