Quietmirror/github/views/l2_revision/F1H/side_detail.png

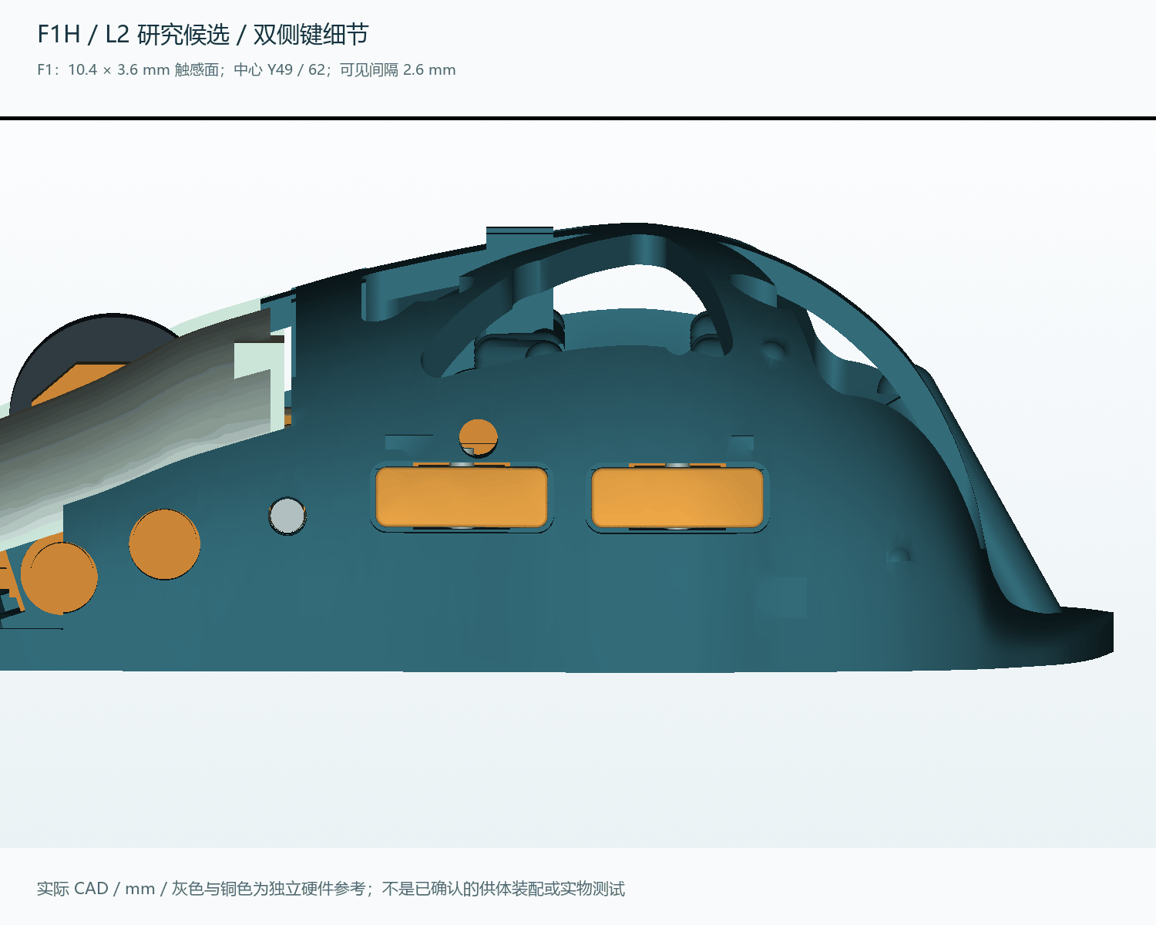
views/l2_revision/F1H/side_detail.png
