Quietmirror/github/views/l2_revision/L2_D_EST/FOUR_VIEWS.png

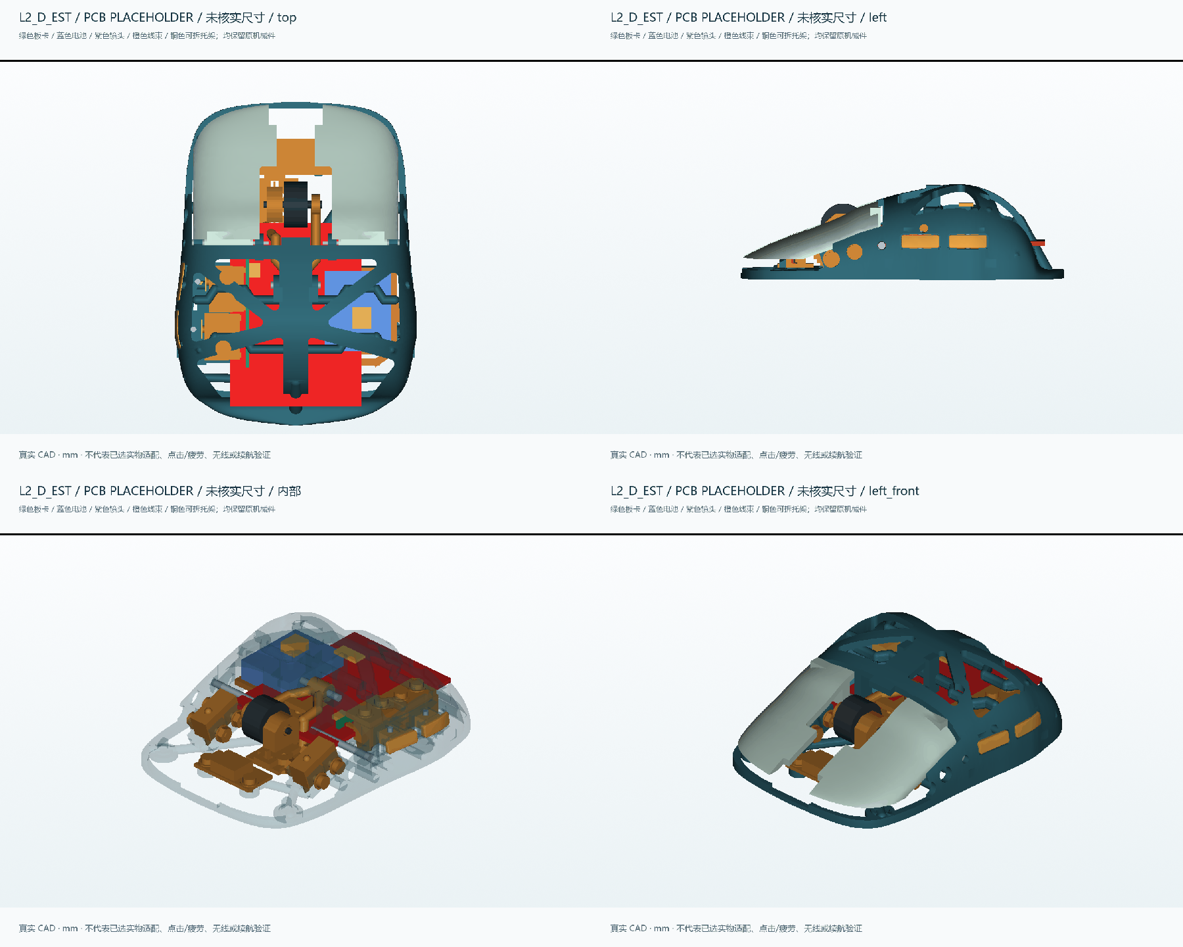
views/l2_revision/L2_D_EST/FOUR_VIEWS.png
