Quietmirror/github/views/l2_revision/L2_D_EST/internal.png

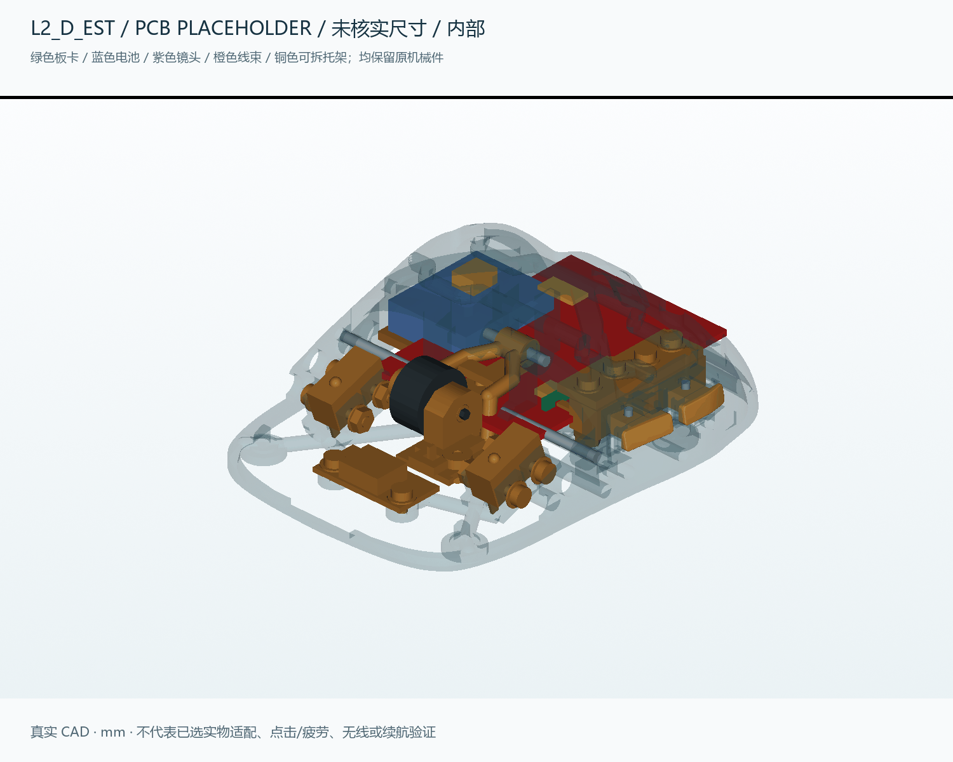
views/l2_revision/L2_D_EST/internal.png
