Quietmirror/github/views/l2_revision/studies/A_B_C_D_EXPLAINED.png

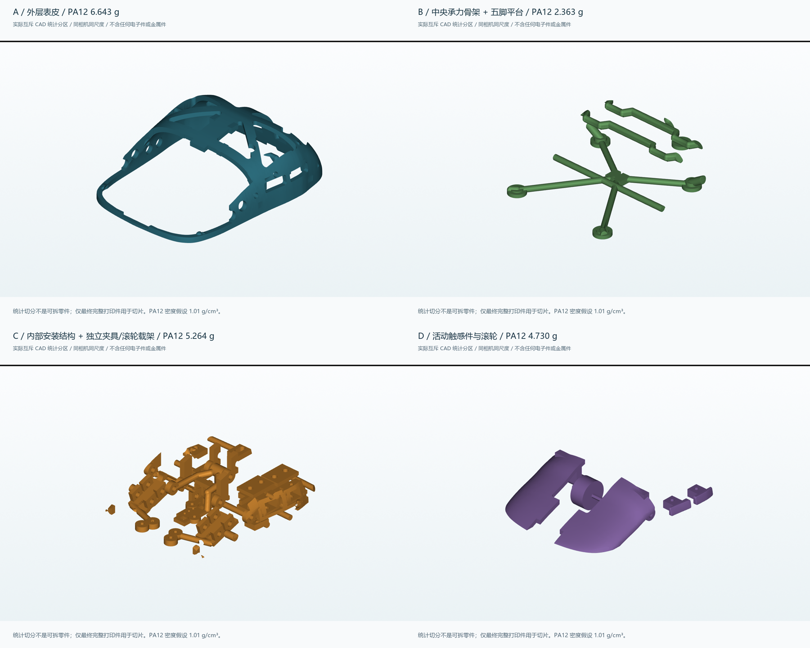
views/l2_revision/studies/A_B_C_D_EXPLAINED.png
