Quietmirror/github/views/l2_revision/studies/B0_B1_B2_B3_B4.png

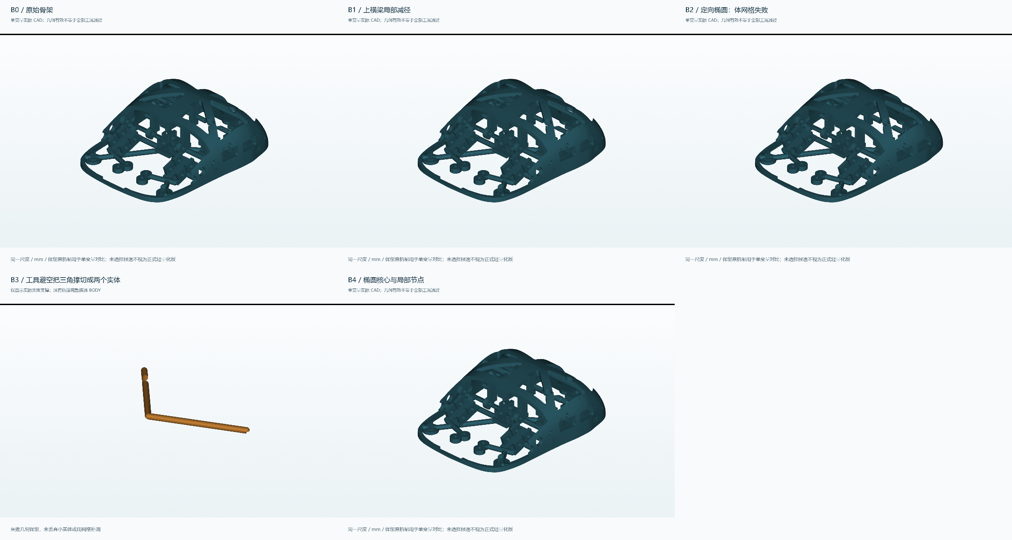
views/l2_revision/studies/B0_B1_B2_B3_B4.png
