Quietmirror/github/views/l2_revision/studies/F1_F2_INTERNAL_COMPARISON.png

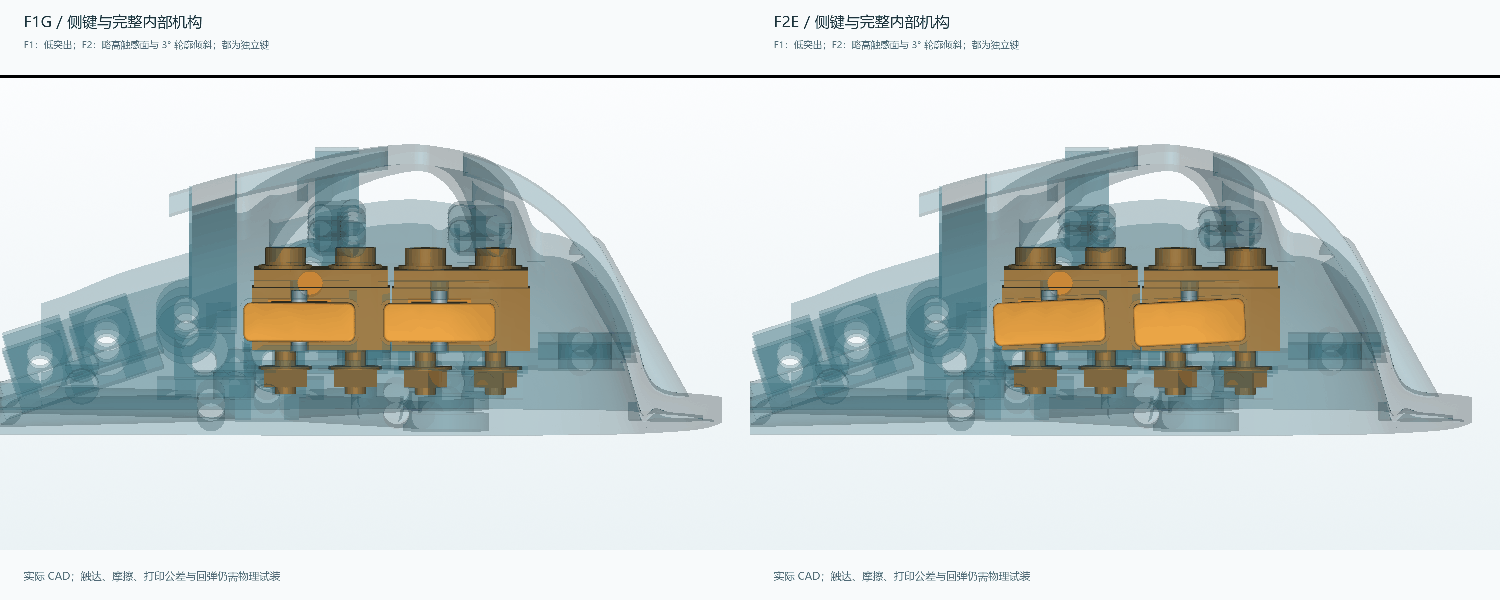
views/l2_revision/studies/F1_F2_INTERNAL_COMPARISON.png
