Quietmirror/github/views/l2_revision/studies/P0_P1_P2_P3_P4_P5_P6.png

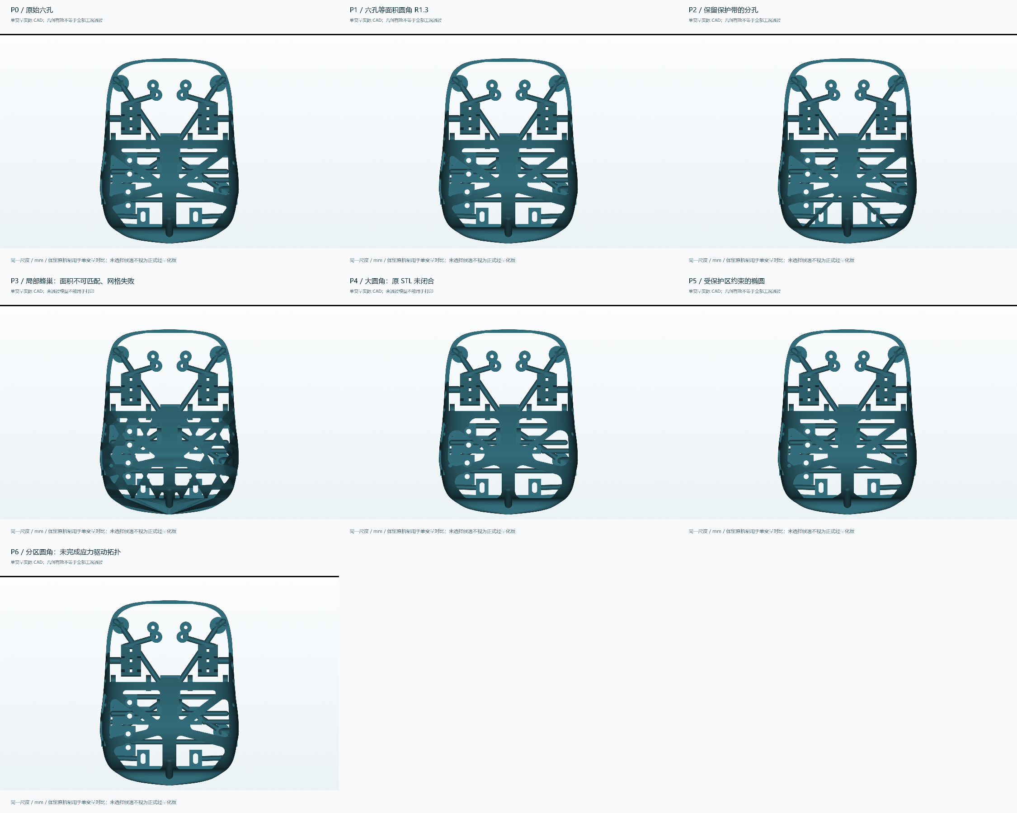
views/l2_revision/studies/P0_P1_P2_P3_P4_P5_P6.png
