Quietmirror/github/views/rebuild_r3_2/01_overview.png

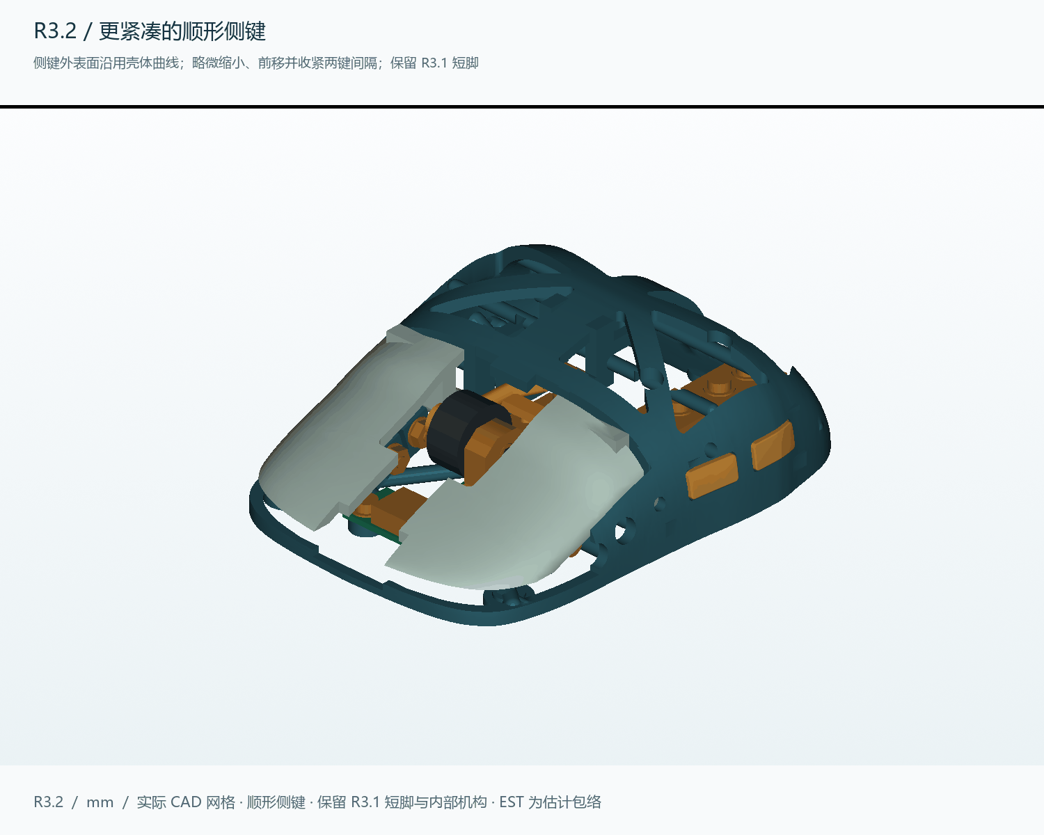
views/rebuild_r3_2/01_overview.png
