Quietmirror/github/views/v09/02_top.png

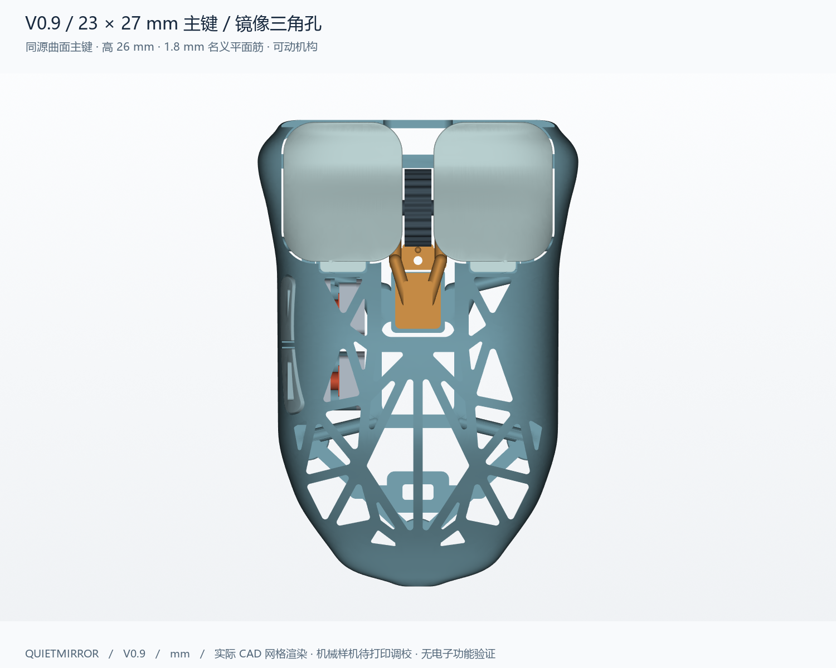
views/v09/02_top.png
