Quietmirror/github/views/v09/06_front.png

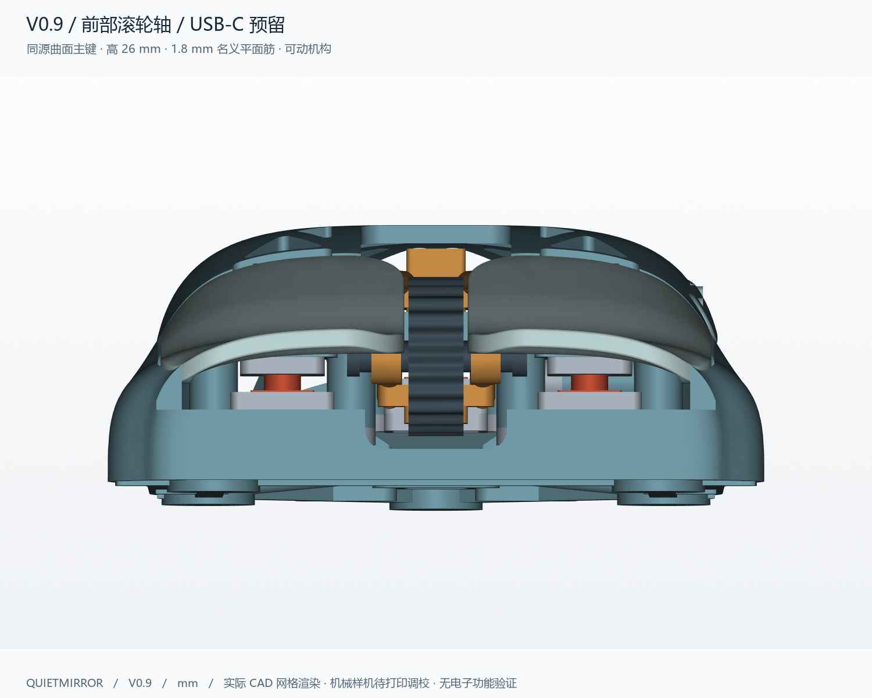
views/v09/06_front.png
