Quietmirror/github/views/v09/07_exploded.png

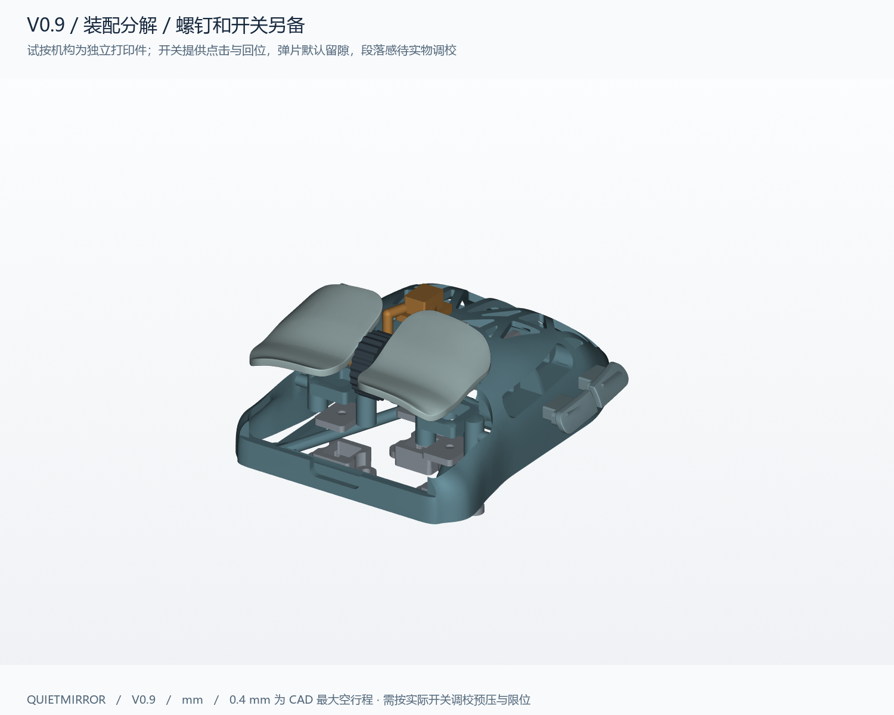
views/v09/07_exploded.png
