Quietmirror/github/views/v09/08_internal.png

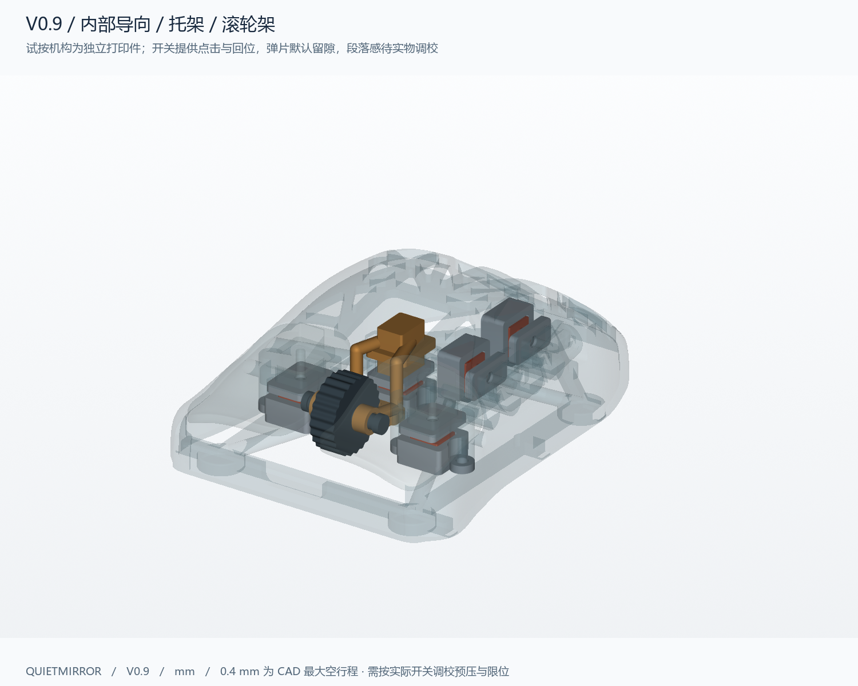
views/v09/08_internal.png
