Quietmirror/github/views/v09/10_isometric.png

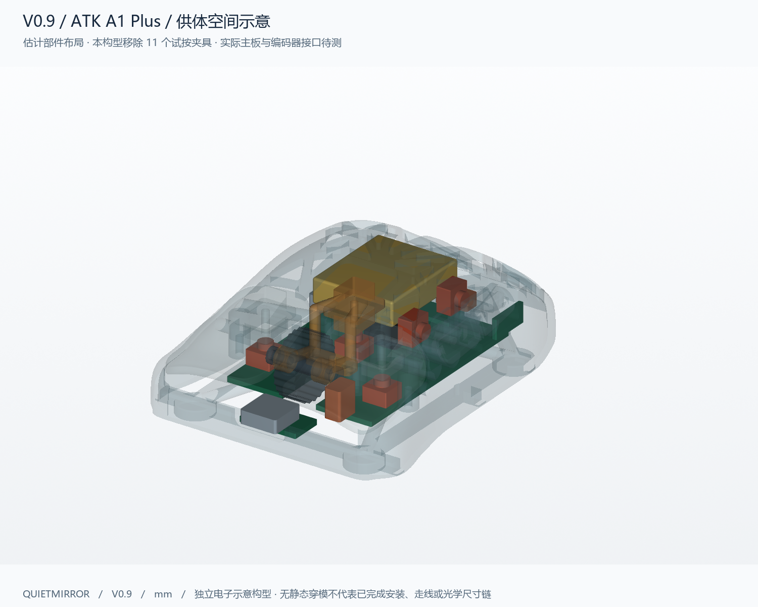
views/v09/10_isometric.png
