Quietmirror/github/views/v09/10_top.png

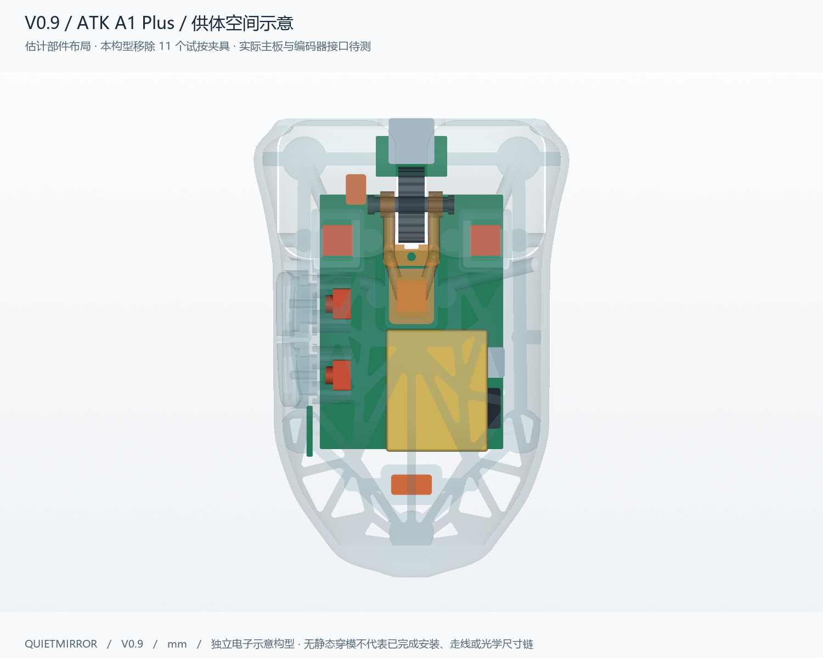
views/v09/10_top.png
