Quietmirror/github/reports/l2_revision/F1H/BOM.csv

id | name | quantity | printable | CAD_mm3 | PA12_theory_g | measured_mass_g | supplier_identity | evidence
1 | BODY | 1 | True | 13210.394857094087 | 13.342498805665029 | UNMEASURED | REFERENCE_GEOMETRY_ONLY | No purchased assembly or electrical test
2 | LEFT_KEY | 1 | True | 1780.447791178631 | 1.7982522690904172 | UNMEASURED | REFERENCE_GEOMETRY_ONLY | No purchased assembly or electrical test
3 | RIGHT_KEY | 1 | True | 1780.4480159352977 | 1.7982524960946507 | UNMEASURED | REFERENCE_GEOMETRY_ONLY | No purchased assembly or electrical test
4 | SIDE_FRONT_KEY | 1 | True | 152.4384043123658 | 0.15396278835548946 | UNMEASURED | REFERENCE_GEOMETRY_ONLY | No purchased assembly or electrical test
5 | SIDE_FRONT_KEY_SWITCH_CLAMP | 1 | True | 164.0835410522589 | 0.16572437646278151 | UNMEASURED | REFERENCE_GEOMETRY_ONLY | No purchased assembly or electrical test
6 | SIDE_REAR_KEY | 1 | True | 145.84646688108242 | 0.14730493154989324 | UNMEASURED | REFERENCE_GEOMETRY_ONLY | No purchased assembly or electrical test
7 | SIDE_REAR_KEY_SWITCH_CLAMP | 1 | True | 164.0835410522589 | 0.16572437646278151 | UNMEASURED | REFERENCE_GEOMETRY_ONLY | No purchased assembly or electrical test
8 | WHEEL | 1 | True | 823.761826507103 | 0.8319994447721741 | UNMEASURED | REFERENCE_GEOMETRY_ONLY | No purchased assembly or electrical test
9 | WHEEL_CARRIER | 1 | True | 589.8949111950266 | 0.5957938603069769 | UNMEASURED | REFERENCE_GEOMETRY_ONLY | No purchased assembly or electrical test
10 | LEFT_KEY_STEEL_PIN | 1 | False |  |  | UNMEASURED | REFERENCE_GEOMETRY_ONLY | No purchased assembly or electrical test
11 | LEFT_KEY_M2_SWITCH_1_BOLT | 1 | False |  |  | UNMEASURED | REFERENCE_GEOMETRY_ONLY | No purchased assembly or electrical test
12 | LEFT_KEY_M2_SWITCH_1_WASHER_NUT | 1 | False |  |  | UNMEASURED | REFERENCE_GEOMETRY_ONLY | No purchased assembly or electrical test
13 | LEFT_KEY_M2_SWITCH_1_WASHER_HEAD | 1 | False |  |  | UNMEASURED | REFERENCE_GEOMETRY_ONLY | No purchased assembly or electrical test
14 | LEFT_KEY_M2_SWITCH_1_NUT | 1 | False |  |  | UNMEASURED | REFERENCE_GEOMETRY_ONLY | No purchased assembly or electrical test
15 | LEFT_KEY_M2_SWITCH_2_BOLT | 1 | False |  |  | UNMEASURED | REFERENCE_GEOMETRY_ONLY | No purchased assembly or electrical test
16 | LEFT_KEY_M2_SWITCH_2_WASHER_NUT | 1 | False |  |  | UNMEASURED | REFERENCE_GEOMETRY_ONLY | No purchased assembly or electrical test
17 | LEFT_KEY_M2_SWITCH_2_WASHER_HEAD | 1 | False |  |  | UNMEASURED | REFERENCE_GEOMETRY_ONLY | No purchased assembly or electrical test
18 | LEFT_KEY_M2_SWITCH_2_NUT | 1 | False |  |  | UNMEASURED | REFERENCE_GEOMETRY_ONLY | No purchased assembly or electrical test
19 | SWITCH_LEFT | 1 | False |  |  | UNMEASURED | REFERENCE_GEOMETRY_ONLY | No purchased assembly or electrical test
20 | RIGHT_KEY_STEEL_PIN | 1 | False |  |  | UNMEASURED | REFERENCE_GEOMETRY_ONLY | No purchased assembly or electrical test
21 | RIGHT_KEY_M2_SWITCH_1_BOLT | 1 | False |  |  | UNMEASURED | REFERENCE_GEOMETRY_ONLY | No purchased assembly or electrical test
22 | RIGHT_KEY_M2_SWITCH_1_WASHER_NUT | 1 | False |  |  | UNMEASURED | REFERENCE_GEOMETRY_ONLY | No purchased assembly or electrical test
23 | RIGHT_KEY_M2_SWITCH_1_WASHER_HEAD | 1 | False |  |  | UNMEASURED | REFERENCE_GEOMETRY_ONLY | No purchased assembly or electrical test
24 | RIGHT_KEY_M2_SWITCH_1_NUT | 1 | False |  |  | UNMEASURED | REFERENCE_GEOMETRY_ONLY | No purchased assembly or electrical test
25 | RIGHT_KEY_M2_SWITCH_2_BOLT | 1 | False |  |  | UNMEASURED | REFERENCE_GEOMETRY_ONLY | No purchased assembly or electrical test
26 | RIGHT_KEY_M2_SWITCH_2_WASHER_NUT | 1 | False |  |  | UNMEASURED | REFERENCE_GEOMETRY_ONLY | No purchased assembly or electrical test
27 | RIGHT_KEY_M2_SWITCH_2_WASHER_HEAD | 1 | False |  |  | UNMEASURED | REFERENCE_GEOMETRY_ONLY | No purchased assembly or electrical test
28 | RIGHT_KEY_M2_SWITCH_2_NUT | 1 | False |  |  | UNMEASURED | REFERENCE_GEOMETRY_ONLY | No purchased assembly or electrical test
29 | SWITCH_RIGHT | 1 | False |  |  | UNMEASURED | REFERENCE_GEOMETRY_ONLY | No purchased assembly or electrical test
30 | SIDE_FRONT_KEY_CAPTURE_PIN | 1 | False |  |  | UNMEASURED | REFERENCE_GEOMETRY_ONLY | No purchased assembly or electrical test
31 | SIDE_FRONT_KEY_M2_SWITCH_1_BOLT | 1 | False |  |  | UNMEASURED | REFERENCE_GEOMETRY_ONLY | No purchased assembly or electrical test
32 | SIDE_FRONT_KEY_M2_SWITCH_1_WASHER_NUT | 1 | False |  |  | UNMEASURED | REFERENCE_GEOMETRY_ONLY | No purchased assembly or electrical test
33 | SIDE_FRONT_KEY_M2_SWITCH_1_WASHER_HEAD | 1 | False |  |  | UNMEASURED | REFERENCE_GEOMETRY_ONLY | No purchased assembly or electrical test
34 | SIDE_FRONT_KEY_M2_SWITCH_1_NUT | 1 | False |  |  | UNMEASURED | REFERENCE_GEOMETRY_ONLY | No purchased assembly or electrical test
35 | SIDE_FRONT_KEY_M2_SWITCH_2_BOLT | 1 | False |  |  | UNMEASURED | REFERENCE_GEOMETRY_ONLY | No purchased assembly or electrical test
36 | SIDE_FRONT_KEY_M2_SWITCH_2_WASHER_NUT | 1 | False |  |  | UNMEASURED | REFERENCE_GEOMETRY_ONLY | No purchased assembly or electrical test
37 | SIDE_FRONT_KEY_M2_SWITCH_2_WASHER_HEAD | 1 | False |  |  | UNMEASURED | REFERENCE_GEOMETRY_ONLY | No purchased assembly or electrical test
38 | SIDE_FRONT_KEY_M2_SWITCH_2_NUT | 1 | False |  |  | UNMEASURED | REFERENCE_GEOMETRY_ONLY | No purchased assembly or electrical test
39 | SWITCH_SIDE_FRONT | 1 | False |  |  | UNMEASURED | REFERENCE_GEOMETRY_ONLY | No purchased assembly or electrical test
40 | SIDE_REAR_KEY_CAPTURE_PIN | 1 | False |  |  | UNMEASURED | REFERENCE_GEOMETRY_ONLY | No purchased assembly or electrical test
41 | SIDE_REAR_KEY_M2_SWITCH_1_BOLT | 1 | False |  |  | UNMEASURED | REFERENCE_GEOMETRY_ONLY | No purchased assembly or electrical test
42 | SIDE_REAR_KEY_M2_SWITCH_1_WASHER_NUT | 1 | False |  |  | UNMEASURED | REFERENCE_GEOMETRY_ONLY | No purchased assembly or electrical test
43 | SIDE_REAR_KEY_M2_SWITCH_1_WASHER_HEAD | 1 | False |  |  | UNMEASURED | REFERENCE_GEOMETRY_ONLY | No purchased assembly or electrical test
44 | SIDE_REAR_KEY_M2_SWITCH_1_NUT | 1 | False |  |  | UNMEASURED | REFERENCE_GEOMETRY_ONLY | No purchased assembly or electrical test
45 | SIDE_REAR_KEY_M2_SWITCH_2_BOLT | 1 | False |  |  | UNMEASURED | REFERENCE_GEOMETRY_ONLY | No purchased assembly or electrical test
46 | SIDE_REAR_KEY_M2_SWITCH_2_WASHER_NUT | 1 | False |  |  | UNMEASURED | REFERENCE_GEOMETRY_ONLY | No purchased assembly or electrical test
47 | SIDE_REAR_KEY_M2_SWITCH_2_WASHER_HEAD | 1 | False |  |  | UNMEASURED | REFERENCE_GEOMETRY_ONLY | No purchased assembly or electrical test
48 | SIDE_REAR_KEY_M2_SWITCH_2_NUT | 1 | False |  |  | UNMEASURED | REFERENCE_GEOMETRY_ONLY | No purchased assembly or electrical test
49 | SWITCH_SIDE_REAR | 1 | False |  |  | UNMEASURED | REFERENCE_GEOMETRY_ONLY | No purchased assembly or electrical test
50 | ENCODER_EC10E_HOUSING | 1 | False |  |  | UNMEASURED | REFERENCE_GEOMETRY_ONLY | No purchased assembly or electrical test
51 | ENCODER_EC10E_ROTOR | 1 | False |  |  | UNMEASURED | REFERENCE_GEOMETRY_ONLY | No purchased assembly or electrical test
52 | WHEEL_CARRIER_STEEL_PIN | 1 | False |  |  | UNMEASURED | REFERENCE_GEOMETRY_ONLY | No purchased assembly or electrical test
53 | SWITCH_MIDDLE | 1 | False |  |  | UNMEASURED | REFERENCE_GEOMETRY_ONLY | No purchased assembly or electrical test
54 | WHEEL_M2_SWITCH_1_BOLT | 1 | False |  |  | UNMEASURED | REFERENCE_GEOMETRY_ONLY | No purchased assembly or electrical test
55 | WHEEL_M2_SWITCH_1_WASHER_NUT | 1 | False |  |  | UNMEASURED | REFERENCE_GEOMETRY_ONLY | No purchased assembly or electrical test
56 | WHEEL_M2_SWITCH_1_WASHER_HEAD | 1 | False |  |  | UNMEASURED | REFERENCE_GEOMETRY_ONLY | No purchased assembly or electrical test
57 | WHEEL_M2_SWITCH_1_NUT | 1 | False |  |  | UNMEASURED | REFERENCE_GEOMETRY_ONLY | No purchased assembly or electrical test
58 | WHEEL_M2_SWITCH_2_BOLT | 1 | False |  |  | UNMEASURED | REFERENCE_GEOMETRY_ONLY | No purchased assembly or electrical test
59 | WHEEL_M2_SWITCH_2_WASHER_NUT | 1 | False |  |  | UNMEASURED | REFERENCE_GEOMETRY_ONLY | No purchased assembly or electrical test
60 | WHEEL_M2_SWITCH_2_WASHER_HEAD | 1 | False |  |  | UNMEASURED | REFERENCE_GEOMETRY_ONLY | No purchased assembly or electrical test
61 | WHEEL_M2_SWITCH_2_NUT | 1 | False |  |  | UNMEASURED | REFERENCE_GEOMETRY_ONLY | No purchased assembly or electrical test
62 | USB_C_REFERENCE | 1 | False |  |  | UNMEASURED | REFERENCE_GEOMETRY_ONLY | No purchased assembly or electrical test
63 | USB_ADAPTER_PCB_REFERENCE | 1 | False |  |  | UNMEASURED | REFERENCE_GEOMETRY_ONLY | No purchased assembly or electrical test
64 | USB_M2x3_L | 1 | False |  |  | UNMEASURED | REFERENCE_GEOMETRY_ONLY | No purchased assembly or electrical test
65 | USB_WASHER_L | 1 | False |  |  | UNMEASURED | REFERENCE_GEOMETRY_ONLY | No purchased assembly or electrical test
66 | USB_M2x3_R | 1 | False |  |  | UNMEASURED | REFERENCE_GEOMETRY_ONLY | No purchased assembly or electrical test
67 | USB_WASHER_R | 1 | False |  |  | UNMEASURED | REFERENCE_GEOMETRY_ONLY | No purchased assembly or electrical test
68 | ENCODER_M2x3_FRONT | 1 | False |  |  | UNMEASURED | REFERENCE_GEOMETRY_ONLY | No purchased assembly or electrical test
69 | ENCODER_WASHER_FRONT | 1 | False |  |  | UNMEASURED | REFERENCE_GEOMETRY_ONLY | No purchased assembly or electrical test
70 | ENCODER_M2x3_REAR | 1 | False |  |  | UNMEASURED | REFERENCE_GEOMETRY_ONLY | No purchased assembly or electrical test
71 | ENCODER_WASHER_REAR | 1 | False |  |  | UNMEASURED | REFERENCE_GEOMETRY_ONLY | No purchased assembly or electrical test
72 | ENCODER_ADAPTER_PCB_EST | 1 | False |  |  | UNMEASURED | UNSELECTED | No purchased assembly or electrical test
