Quietmirror/github/reports/l2_revision/BOM_AND_ASSEMBLY_INSTRUCTIONS.md

# BOM与装配顺序

各版本BOM.csv按实际装配组件编号，qty=1代表文件中的一个实体；不把估计电子盒当作已采购物料。所有购买件质量为UNMEASURED，供体及电池容量未确定，无法给真实整机克重。理论塑料质量不包含螺钉、钢轴、开关、板卡、电池、脚贴；接收器不装在鼠标里，不计鼠标质量。

1. 先打印公差小样；清支撑、去毛刺，测五脚共面与轴/螺丝孔，不能磨穿承力筋。
2. 从开放底部按路径先装前侧微动，再后侧微动；后夹条先于前夹条，随后螺钉/垫片/螺母。不得采用旧版从前端穿过横梁的路径。
3. 装左右主微动、USB参考座；两侧键从外侧直入后装捕获销。实测按钮自由高，调整触点与止挡，确保释放和最大行程，不把厂家PT+OT直接当安全总行程。
4. 组装滚轮、编码器参考板、载架、钢轴与中键机构；检验旋转和点击分别独立。最后装左右主键与铰链轴。
5. 电子转接件仅按module_review的可达路径装入；载架与PCB的真实固定方式未测时不能宣称功能装配完成。H/D示意中的支架先试装，存在冲突的D测量板不要强塞。
6. 电池使用可拆束带和绝缘缓冲，避免挤压/螺钉尖端/导线拉扯；天线按实物RF要求留空；校验极性、保护及充电后才通电。没有通过实际电气测试。

试握记录：有效夹持宽度、顶掌、无名指/小指拖地、滚轮与侧键触达、误触、抬鼠稳定性、前/中/后偏心按压卡滞和回弹。实际500/1000次初期循环后再测间隙；这只是建议的验证步骤，不是已有寿命数据。
