Quietmirror/github/reports/l2_revision/MATERIALS_AND_LOAD_CASES.md

# 材料、载荷与适用范围

PA12 rho1.01 g/cm³、E1700 MPa、ν0.37都是本轮统一比较假设；不是已测打印件。PLA切片rho1.24独立计算。EOS不同工艺材料数据不能自动覆盖学校机器、层间方向、温湿度、疲劳或蠕变。

LC1左右主键各1.5N，中心/内缘/外缘/前端四个面斑；钢轴径向支承和微动接触岛为明确简化夹具。LC2两侧键各1.5N，前/中/后三处，导向面与接触岛支承，不求解摩擦与开合接触。LC3两侧外皮相向各2N，合力和合矩为零，3-2-1仅去刚体模态，不把鼠标固定在桌上。LC4上背外皮5N，五脚竖向支承并检查负反力。LC5后角向上2N、两个刚性手指接触区，是局部扭转夹具。LC6载架两轴承及编码器区域共1.5N，独立滚轮轴端参考支承。LC7真实PCB耳维护下压力2N；没有用FR4当无限刚性梁。

线弹性范围内0.5/1/1.5倍载荷的位移与应力严格线性缩放、刚度不变；R32 LC4已经实际重跑三档以检查实现。所有其他工况的倍载结果是方程推导，不能标为另一次求解。LC8 15N可由LC4乘3作线弹性情景，不代表误压损伤/屈曲/接触已计算。E1200/1700/2200的同质敏感性已在R32实跑，选定模型按k比例E、位移反比E估算；ν0.30与锚点交换另行实跑。打印各向异性、温湿度和寿命缺少试样参数，保持未验证。

梁基准完成两档，弯曲误差约1.12%、轴向约0.463%；见FEM_BEAM_BENCHMARK.md。许用应力和安全系数没有被虚构；有限元结果不是产品安全或疲劳认证。
