Quietmirror/github/reports/l2_revision/A_B_C_D_VOLUME_BUDGET.csv

variant | category | volume_mm3 | PA12_g | PLA_solid_g
R32 | A_BODY_SKIN | 6544.125149390715 | 6.609566400884622 | 8.114715185244487
R32 | B_BODY_SKELETON | 2047.8101048686492 | 2.068288205917336 | 2.539284530037125
R32 | C_BODY_MOUNTS | 4209.783739761356 | 4.2518815771589695 | 5.2201318373040815
R32 | C_SEPARATE_MOUNTS | 975.6619932995445 | 0.98541861323254 | 1.2098208716914352
R32 | D_MOVING_OTHER | 4729.28604242605 | 4.776578902850311 | 5.864314692608302
F1H | A_BODY_SKIN | 6577.543074631123 | 6.643318505377435 | 8.156153412542592
F1H | B_BODY_SKELETON | 2339.188742790642 | 2.362580630218549 | 2.9005940410603963
F1H | C_BODY_MOUNTS | 4293.477468125329 | 4.336412242806583 | 5.323912060475409
F1H | C_SEPARATE_MOUNTS | 918.0619932995444 | 0.9272426132325399 | 1.138396871691435
F1H | D_MOVING_OTHER | 4682.94250481448 | 4.7297719298626255 | 5.806848705969956
