Quietmirror/github/releases/Quietmirror-L2-Research/FULL_ASSEMBLY_D.FCStd

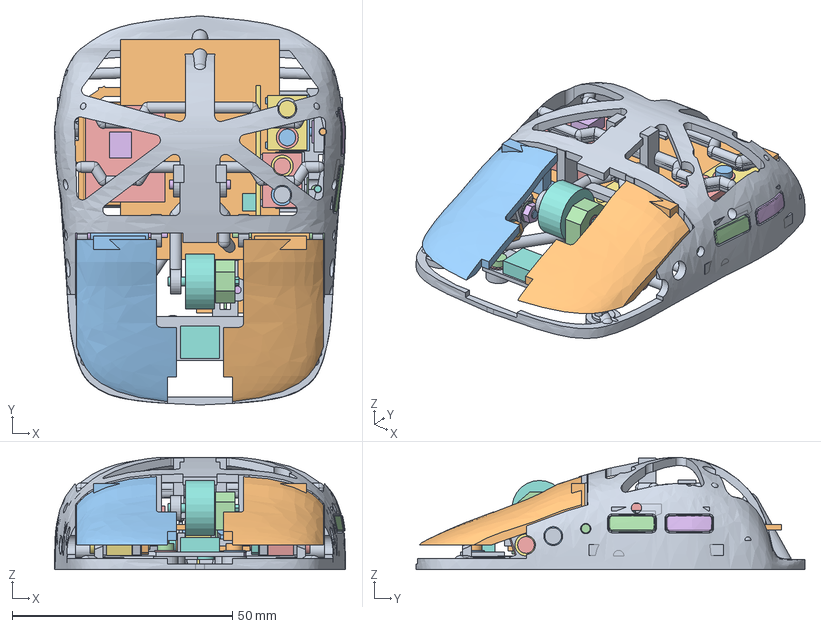
[picture p59: CAD file, 2026-10-17]
releases/Quietmirror-L2-Research/FULL_ASSEMBLY_D.FCStd
66.1 x 88.2 x 25.5 mm
LEFT_KEY
RIGHT_KEY
SIDE_FRONT_KEY
SIDE_FRONT_KEY_SWITCH_CLAMP
SIDE_REAR_KEY
SIDE_REAR_KEY_SWITCH_CLAMP
WHEEL
WHEEL_CARRIER
D_REMOVABLE_CARRIER_EST
D_SENSOR_SEAT_EST
LEFT_KEY_STEEL_PIN
LEFT_KEY_M2_SWITCH_1_BOLT
LEFT_KEY_M2_SWITCH_1_WASHER_NUT
LEFT_KEY_M2_SWITCH_1_WASHER_HEAD
LEFT_KEY_M2_SWITCH_1_NUT
LEFT_KEY_M2_SWITCH_2_BOLT
LEFT_KEY_M2_SWITCH_2_WASHER_NUT
LEFT_KEY_M2_SWITCH_2_WASHER_HEAD
LEFT_KEY_M2_SWITCH_2_NUT
SWITCH_LEFT
RIGHT_KEY_STEEL_PIN
RIGHT_KEY_M2_SWITCH_1_BOLT
RIGHT_KEY_M2_SWITCH_1_WASHER_NUT
RIGHT_KEY_M2_SWITCH_1_WASHER_HEAD
RIGHT_KEY_M2_SWITCH_1_NUT
RIGHT_KEY_M2_SWITCH_2_BOLT
RIGHT_KEY_M2_SWITCH_2_WASHER_NUT
RIGHT_KEY_M2_SWITCH_2_WASHER_HEAD
RIGHT_KEY_M2_SWITCH_2_NUT
SWITCH_RIGHT
SIDE_FRONT_KEY_CAPTURE_PIN
SIDE_FRONT_KEY_M2_SWITCH_1_BOLT
SIDE_FRONT_KEY_M2_SWITCH_1_WASHER_NUT
SIDE_FRONT_KEY_M2_SWITCH_1_WASHER_HEAD
SIDE_FRONT_KEY_M2_SWITCH_1_NUT
SIDE_FRONT_KEY_M2_SWITCH_2_BOLT
SIDE_FRONT_KEY_M2_SWITCH_2_WASHER_NUT
SIDE_FRONT_KEY_M2_SWITCH_2_WASHER_HEAD
SIDE_FRONT_KEY_M2_SWITCH_2_NUT
SWITCH_SIDE_FRONT
SIDE_REAR_KEY_CAPTURE_PIN
SIDE_REAR_KEY_M2_SWITCH_1_BOLT
SIDE_REAR_KEY_M2_SWITCH_1_WASHER_NUT
SIDE_REAR_KEY_M2_SWITCH_1_WASHER_HEAD
SIDE_REAR_KEY_M2_SWITCH_1_NUT
SIDE_REAR_KEY_M2_SWITCH_2_BOLT
SIDE_REAR_KEY_M2_SWITCH_2_WASHER_NUT
SIDE_REAR_KEY_M2_SWITCH_2_WASHER_HEAD
SIDE_REAR_KEY_M2_SWITCH_2_NUT
SWITCH_SIDE_REAR
ENCODER_EC10E_HOUSING
ENCODER_EC10E_ROTOR
WHEEL_CARRIER_STEEL_PIN
SWITCH_MIDDLE
WHEEL_M2_SWITCH_1_BOLT
WHEEL_M2_SWITCH_1_WASHER_NUT
WHEEL_M2_SWITCH_1_WASHER_HEAD
WHEEL_M2_SWITCH_1_NUT
WHEEL_M2_SWITCH_2_BOLT
WHEEL_M2_SWITCH_2_WASHER_NUT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
