Quietmirror/github/exports/v09/ATK_A1_PLUS/donor_mainboard_EST.step

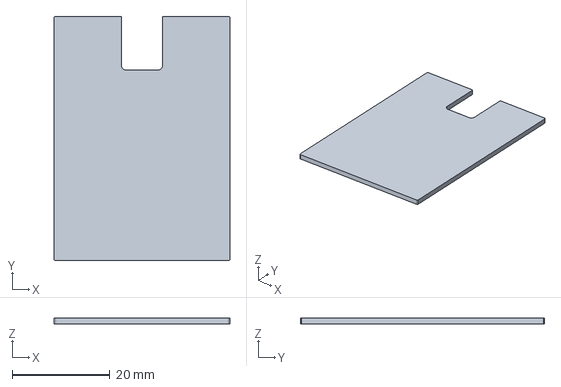
[picture p61: CAD file, 2026-10-15]
exports/v09/ATK_A1_PLUS/donor_mainboard_EST.step
36.0 x 50.0 x 1.20 mm
