Quietmirror/github/exports/v09/PAW3950_CUSTOM/custom_mainboard_EST.step

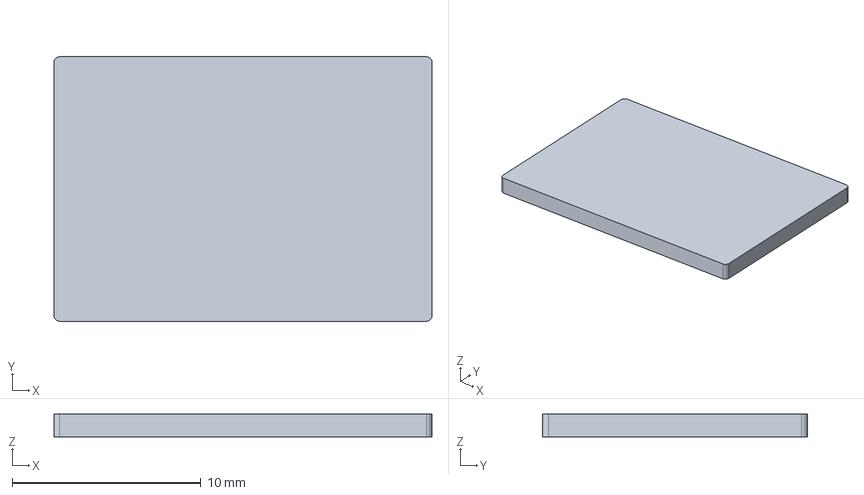
[picture p63: CAD file, 2026-10-15]
exports/v09/PAW3950_CUSTOM/custom_mainboard_EST.step
20.0 x 14.0 x 1.20 mm
