Quietmirror/github/exports/quietmirror_fingertip_V0.1.step

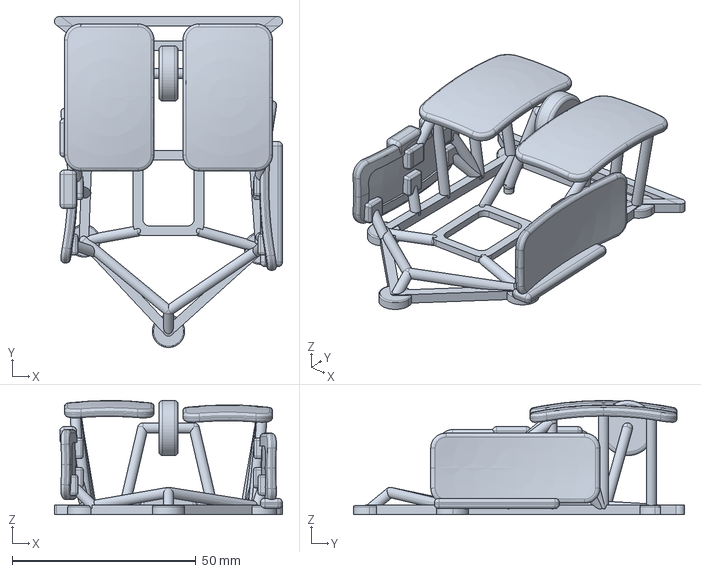
[picture p64: CAD file, 2026-10-14]
exports/quietmirror_fingertip_V0.1.step
62.0 x 90.0 x 31.0 mm
