Quietmirror/github/exports/rebuild_r3_3/d/print/D_REMOVABLE_CARRIER_EST.stl

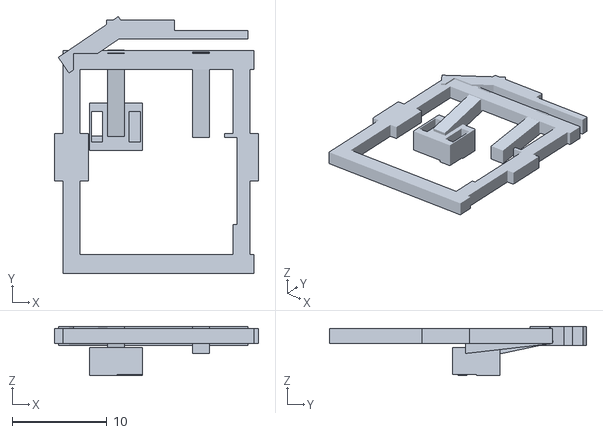
[picture p65: CAD file, 2026-10-17]
exports/rebuild_r3_3/d/print/D_REMOVABLE_CARRIER_EST.stl
21.6 x 27.2 x 5.24
