Quietmirror/github/exports/rebuild_r3_3/h/print/SIDE_REAR_KEY.stl

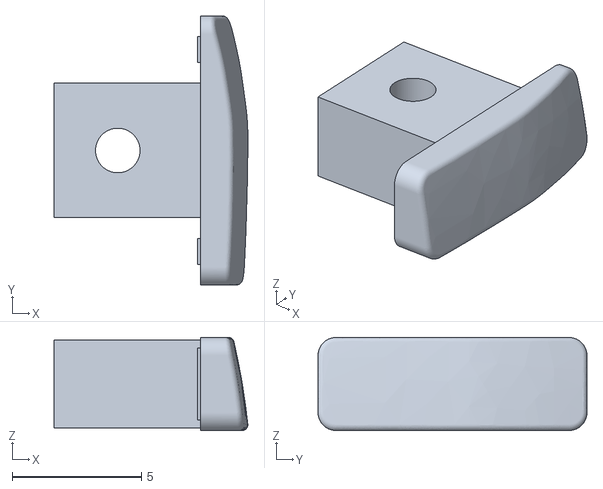
[picture p66: CAD file, 2026-10-17]
exports/rebuild_r3_3/h/print/SIDE_REAR_KEY.stl
7.49 x 10.4 x 3.60
