Quietmirror/github/exports/rebuild_r3_3/print/BODY.stl

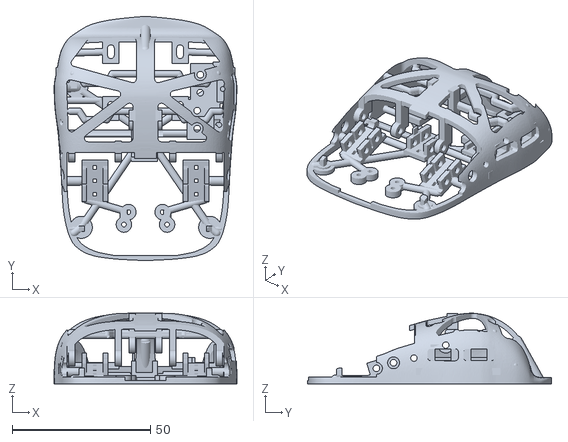
[picture p67: CAD file, 2026-10-17]
exports/rebuild_r3_3/print/BODY.stl
66.1 x 88.2 x 25.6
