Quietmirror/github/exports/v09/ATK_A1_PLUS/donor_MCU_RF_EST.step

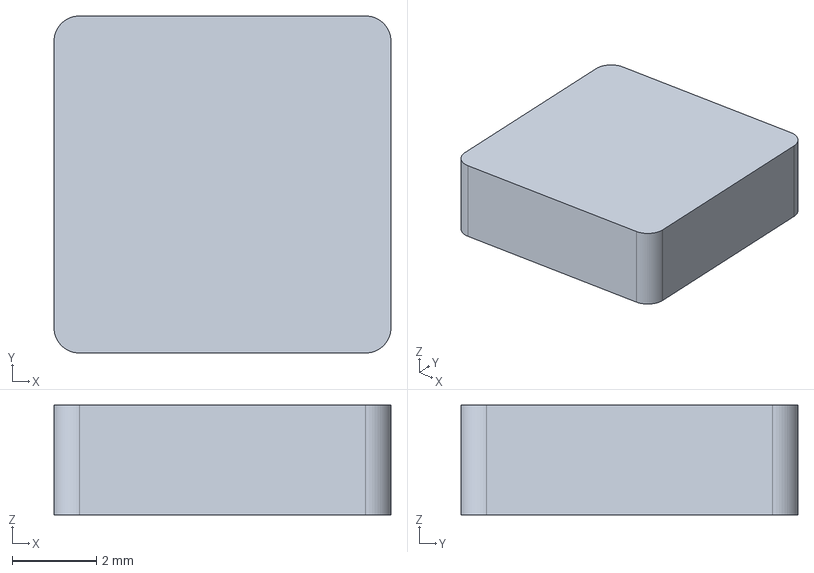
[picture p68: CAD file, 2026-10-15]
exports/v09/ATK_A1_PLUS/donor_MCU_RF_EST.step
8.00 x 8.00 x 2.60 mm
