Quietmirror/github/exports/v09/calibration/STEM_TEST.step

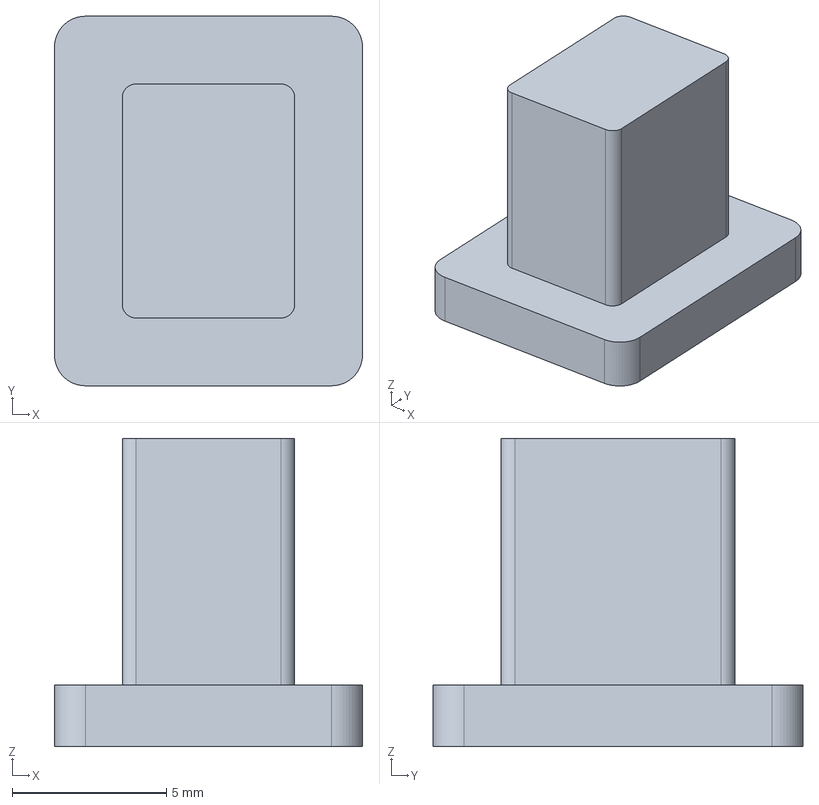
[picture p69: CAD file, 2026-10-15]
exports/v09/calibration/STEM_TEST.step
10.0 x 12.0 x 10.0 mm
