Quietmirror/github/exports/v09/PAW3950_CUSTOM/RF_board_EST.step

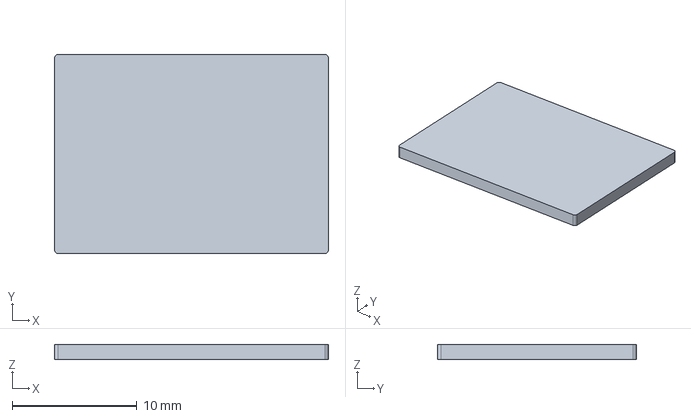
[picture p70: CAD file, 2026-10-15]
exports/v09/PAW3950_CUSTOM/RF_board_EST.step
22.0 x 16.0 x 1.20 mm
