Quietmirror/github/exports/v09/quietmirror_V0.9_PAW3950_CUSTOM_CLEARANCES.step

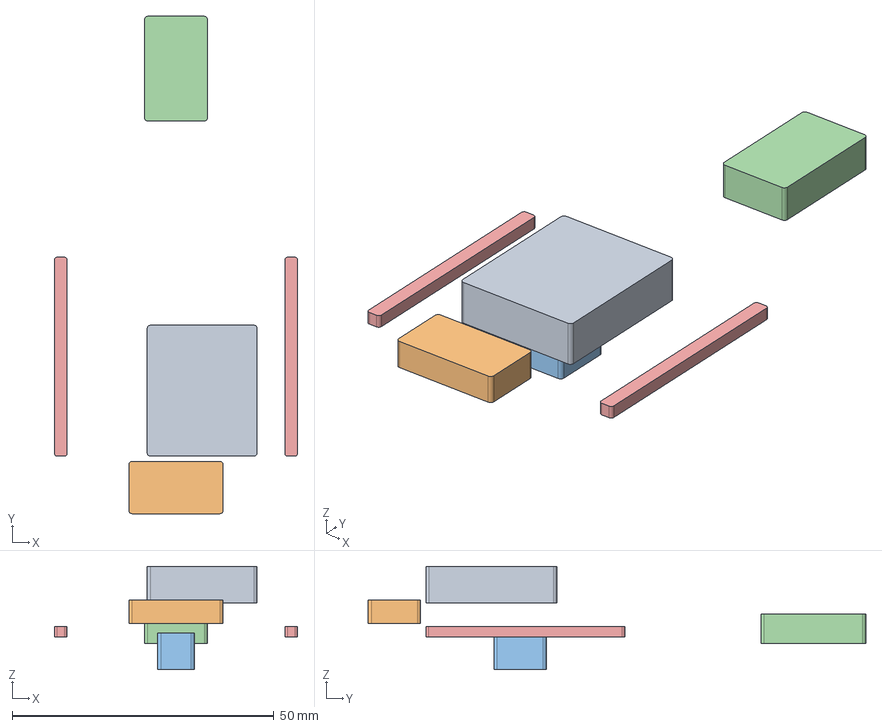
[picture p72: CAD file, 2026-10-15]
exports/v09/quietmirror_V0.9_PAW3950_CUSTOM_CLEARANCES.step
46.4 x 95.0 x 19.7 mm
battery_service_EST
antenna_clearance_EST
optical_path_EST
USB_plug_EST
left_wire_corridor_EST
right_wire_corridor_EST
