Quietmirror/github/releases/Fenrir-MiniSE-R2/FENRIR_MINISE_R2_PLA_PRINT_PLATE.3mf

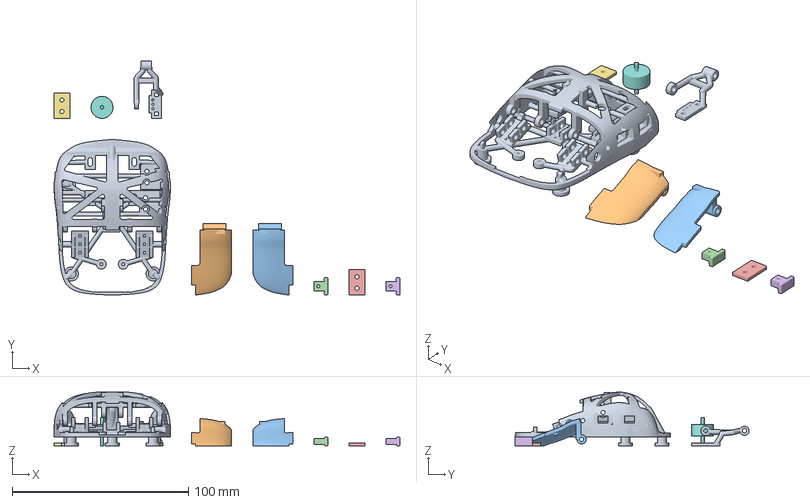
[picture p73: CAD file, 2026-10-16]
releases/Fenrir-MiniSE-R2/FENRIR_MINISE_R2_PLA_PRINT_PLATE.3mf
196.3 x 132.8 x 30.6 mm
BODY.stl
LEFT_KEY.stl
RIGHT_KEY.stl
SIDE_FRONT_KEY.stl
SIDE_FRONT_KEY_SWITCH_CLAMP.stl
SIDE_REAR_KEY.stl
SIDE_REAR_KEY_SWITCH_CLAMP.stl
WHEEL.stl
WHEEL_CARRIER.stl
