Quietmirror/github/releases/Fenrir-MiniSE-R3.1/FENRIR_MINISE_R3_1_PLA_PRINT_PLATE.3mf

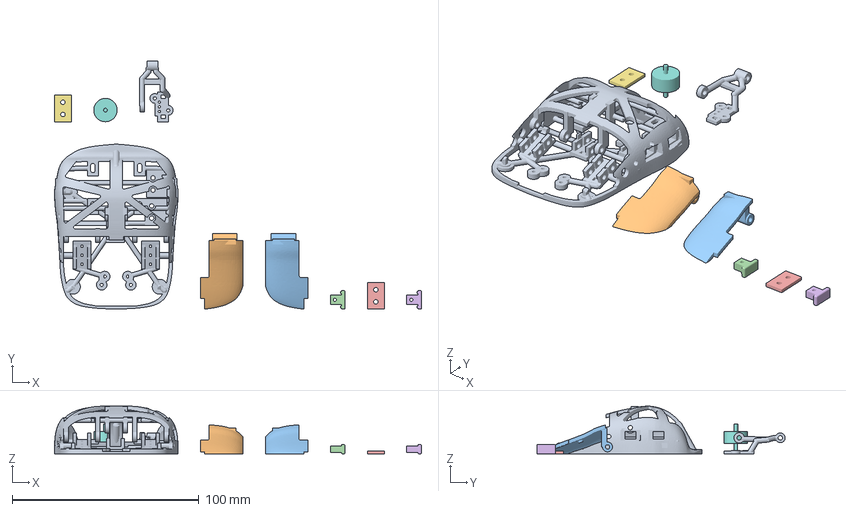
[picture p74: CAD file, 2026-10-16]
releases/Fenrir-MiniSE-R3.1/FENRIR_MINISE_R3_1_PLA_PRINT_PLATE.3mf
196.3 x 132.8 x 25.6 mm
BODY.stl
LEFT_KEY.stl
RIGHT_KEY.stl
SIDE_FRONT_KEY.stl
SIDE_FRONT_KEY_SWITCH_CLAMP.stl
SIDE_REAR_KEY.stl
SIDE_REAR_KEY_SWITCH_CLAMP.stl
WHEEL.stl
WHEEL_CARRIER.stl
