Quietmirror/github/releases/Fenrir-MiniSE-R3.3/FENRIR_MINISE_R3_3_PLA_PRINT_PLATE.3mf

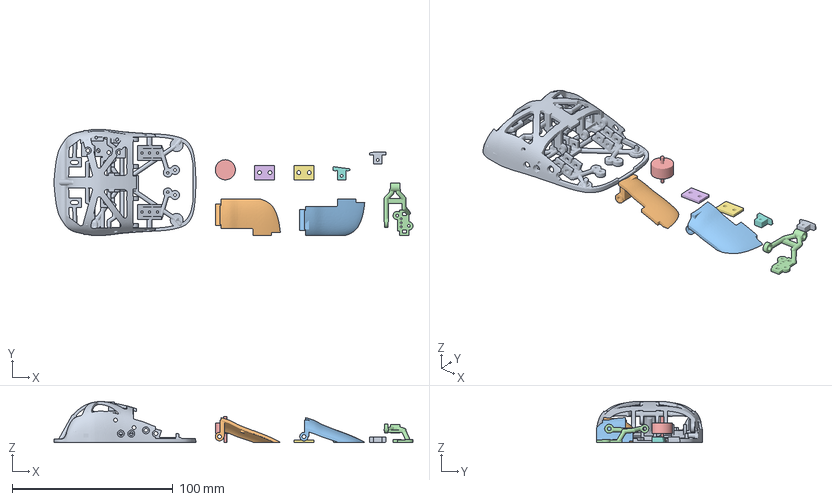
[picture p75: CAD file, 2026-10-17]
releases/Fenrir-MiniSE-R3.3/FENRIR_MINISE_R3_3_PLA_PRINT_PLATE.3mf
223.1 x 66.1 x 25.6 mm
LEFT_KEY
RIGHT_KEY
WHEEL_CARRIER
WHEEL
SIDE_FRONT_KEY_SWITCH_CLAMP
SIDE_REAR_KEY_SWITCH_CLAMP
SIDE_FRONT_KEY
SIDE_REAR_KEY
