Quietmirror/github/releases/Quietmirror-L2-Research/H_ALL_PARTS_SINGLE_PLATE.3mf

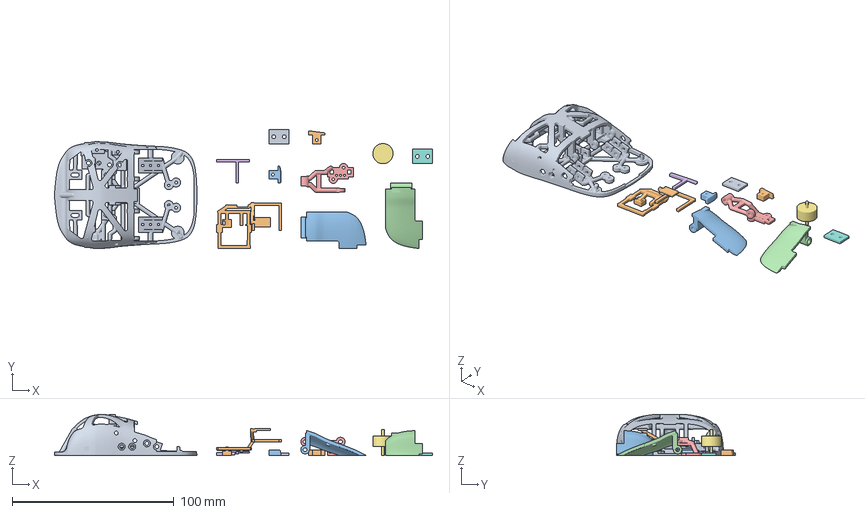
[picture p77: CAD file, 2026-10-17]
releases/Quietmirror-L2-Research/H_ALL_PARTS_SINGLE_PLATE.3mf
233.8 x 73.7 x 25.6 mm
H_REMOVABLE_CARRIER_EST
LEFT_KEY
RIGHT_KEY
WHEEL_CARRIER
H_SENSOR_SEAT_EST
WHEEL
SIDE_FRONT_KEY_SWITCH_CLAMP
SIDE_REAR_KEY_SWITCH_CLAMP
SIDE_FRONT_KEY
SIDE_REAR_KEY
