Quietmirror/github/exports/quietmirror_fingertip_V0.1_PRINT.3mf

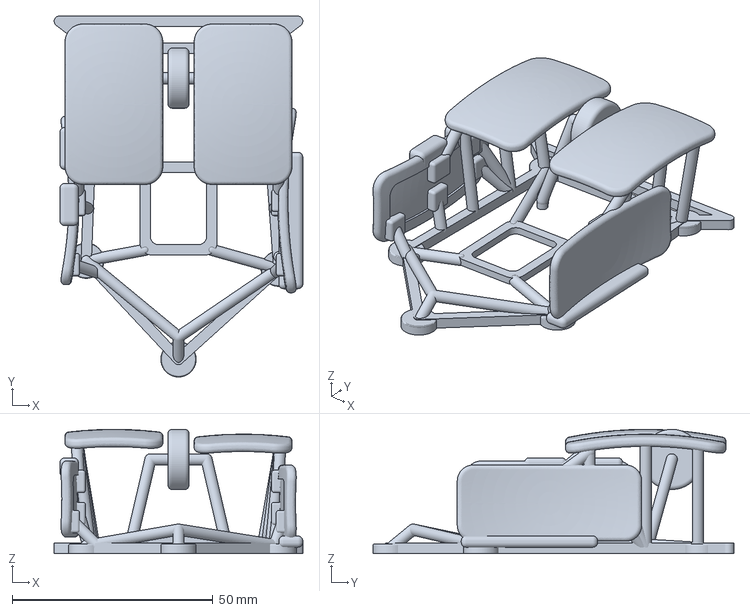
[picture p78: CAD file, 2026-10-14]
exports/quietmirror_fingertip_V0.1_PRINT.3mf
62.0 x 90.0 x 31.0 mm
