Quietmirror/github/exports/rebuild_r3_3/h/print/SIDE_FRONT_KEY_SWITCH_CLAMP.stl

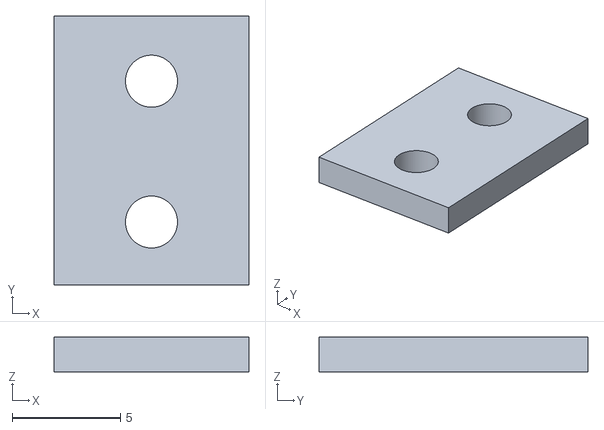
[picture p79: CAD file, 2026-10-17]
exports/rebuild_r3_3/h/print/SIDE_FRONT_KEY_SWITCH_CLAMP.stl
9.00 x 12.4 x 1.60
