Quietmirror/github/exports/v09/ATK_A1_PLUS/lens_EST.step

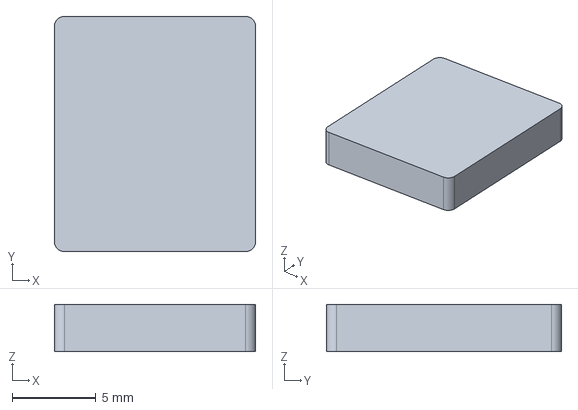
[picture p80: CAD file, 2026-10-15]
exports/v09/ATK_A1_PLUS/lens_EST.step
12.0 x 14.0 x 2.80 mm
