Quietmirror/github/exports/v09/calibration/AXLE_TEST.step

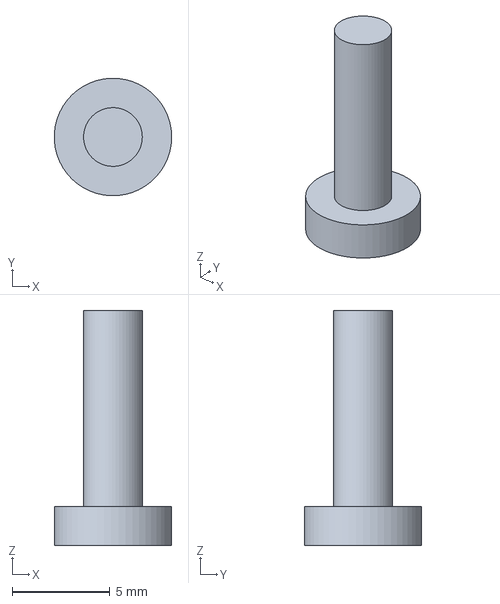
[picture p81: CAD file, 2026-10-15]
exports/v09/calibration/AXLE_TEST.step
5.99 x 6.00 x 12.0 mm
