Quietmirror/github/exports/v09/PAW3950_CUSTOM/side_board_EST.step

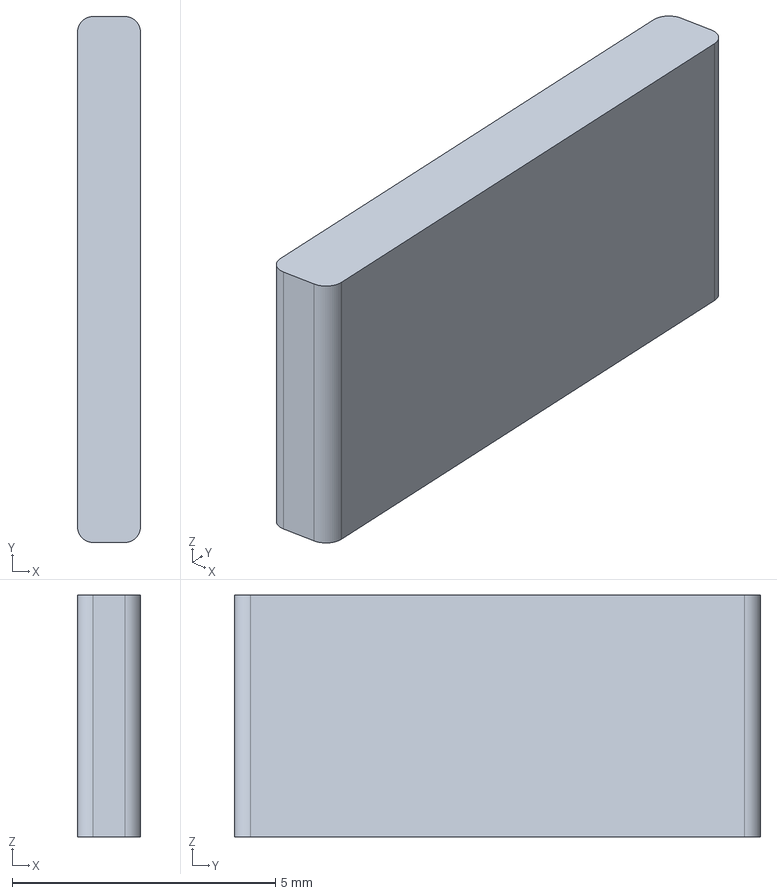
[picture p82: CAD file, 2026-10-15]
exports/v09/PAW3950_CUSTOM/side_board_EST.step
1.20 x 10.0 x 4.60 mm
