Quietmirror/github/exports/v09/placed/DETENT_LEAF.step

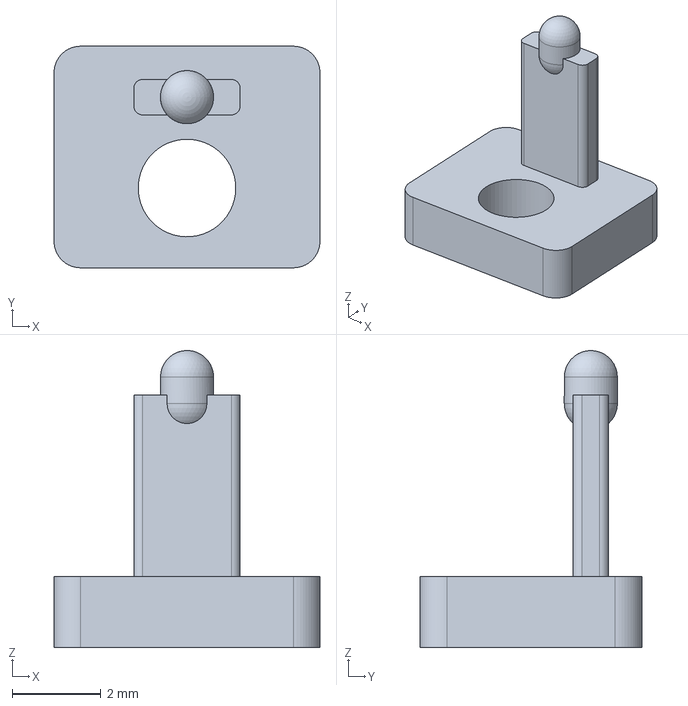
[picture p83: CAD file, 2026-10-15]
exports/v09/placed/DETENT_LEAF.step
6.00 x 5.00 x 6.70 mm
