Quietmirror/github/exports/v09/print/thumb_front_KEY.step

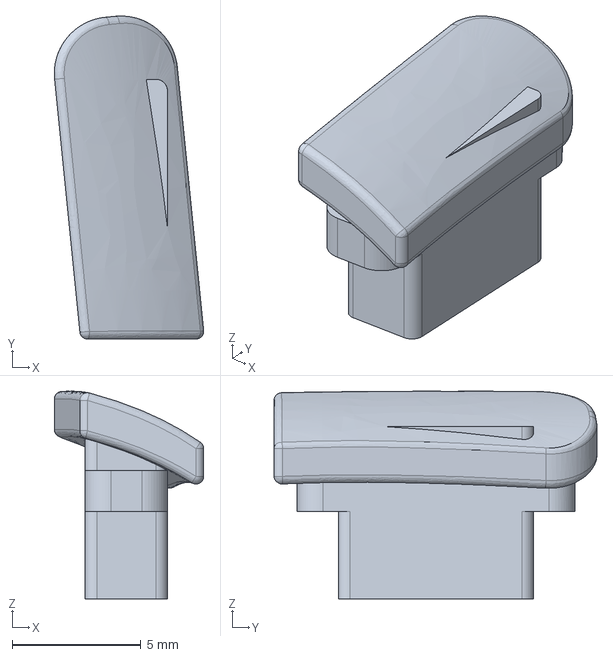
[picture p84: CAD file, 2026-10-15]
exports/v09/print/thumb_front_KEY.step
5.81 x 12.6 x 8.08 mm
