Quietmirror/github/exports/v09/quietmirror_V0.9_PAW3950_CUSTOM_VIEW_ONLY.3mf

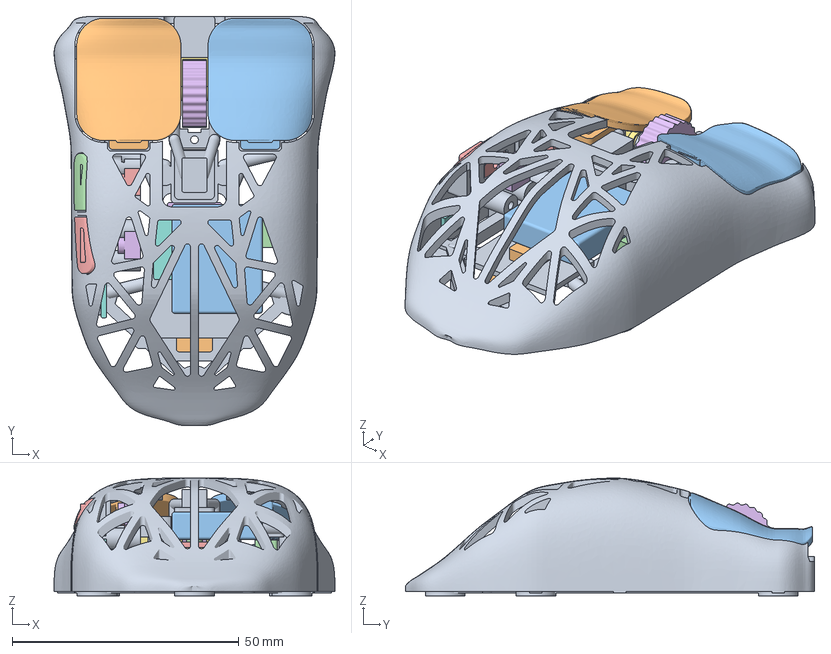
[picture p85: CAD file, 2026-10-15]
exports/v09/quietmirror_V0.9_PAW3950_CUSTOM_VIEW_ONLY.3mf
62.0 x 90.3 x 26.0 mm
BODY.stl
left_KEY.stl
right_KEY.stl
thumb_front_KEY.stl
thumb_rear_KEY.stl
WHEEL.stl
AXLE.stl
AXLE_WASHER.stl
WHEEL_CARRIER.stl
left_SWITCH_EXAMPLE.stl
right_SWITCH_EXAMPLE.stl
middle_SWITCH_EXAMPLE.stl
thumb_front_SWITCH_EXAMPLE.stl
thumb_rear_SWITCH_EXAMPLE.stl
custom_mainboard_EST.stl
sensor_board_EST.stl
RF_board_EST.stl
MCU_RF_EST.stl
battery_500mAh_TARGET.stl
battery_plug_EST.stl
sensor_package_EST.stl
lens_EST.stl
encoder_EST.stl
side_board_EST.stl
USB_C_EST.stl
power_switch_body_EST.stl
power_switch_tab_EST.stl
