Quietmirror/github/exports/electronic_envelopes_ESTIMATES.step

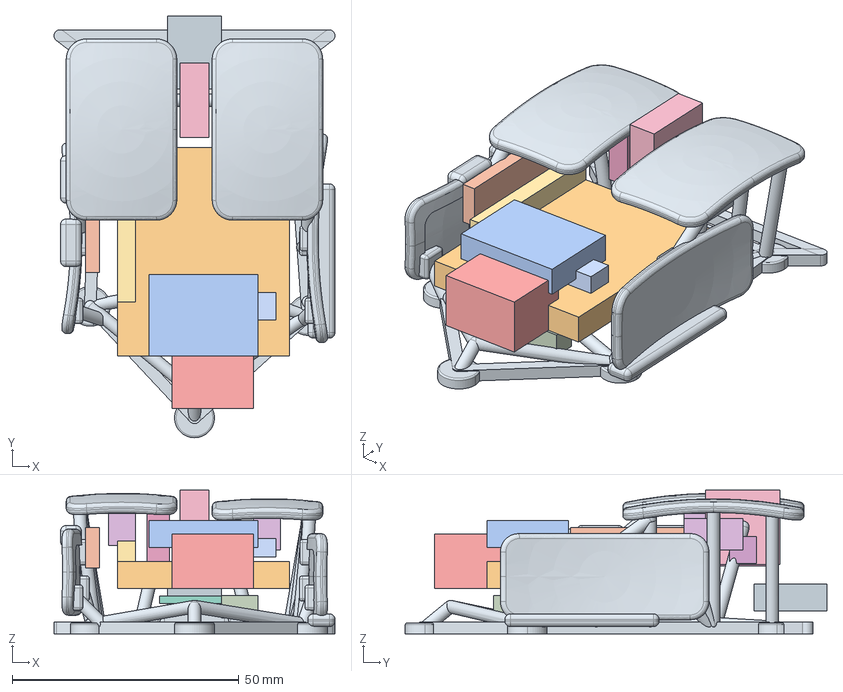
[picture p87: CAD file, 2026-10-14]
exports/electronic_envelopes_ESTIMATES.step
62.0 x 93.0 x 31.7 mm
V0_1_fixed_print_model_part
main_pcb_and_components_EST
reference_breakout_pcb
sensor_package_EST
lens_EST
wheel_rotation_EST
encoder_EST
middle_switch_EST
left_switch_EST
right_switch_EST
side_pcb_EST
battery_EST
battery_connector_EST
wiring_channel_EST
usb_c_and_plug_EST
power_switch_EST
antenna_keepout_EST
