Quietmirror/github/exports/rebuild_r3_3/d/print/D_SENSOR_SEAT_EST.stl

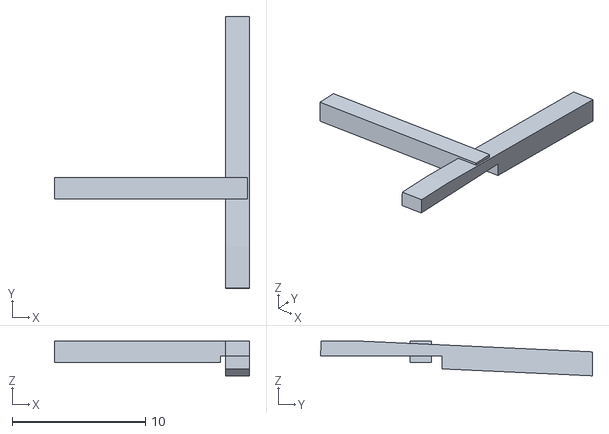
[picture p88: CAD file, 2026-10-17]
exports/rebuild_r3_3/d/print/D_SENSOR_SEAT_EST.stl
14.6 x 20.4 x 2.60
