Quietmirror/github/exports/rebuild_r3_3/h/print/H_REMOVABLE_CARRIER_EST.stl

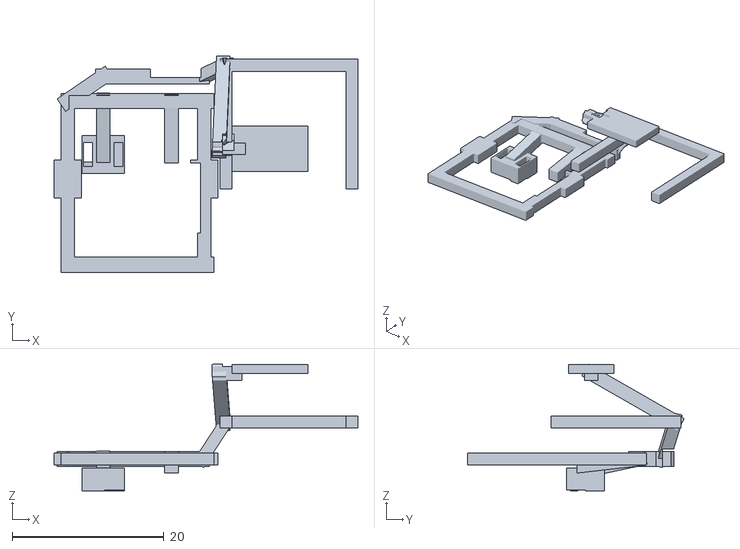
[picture p89: CAD file, 2026-10-17]
exports/rebuild_r3_3/h/print/H_REMOVABLE_CARRIER_EST.stl
40.1 x 28.6 x 16.7
