Quietmirror/github/exports/rebuild_r3_3/print/SIDE_FRONT_KEY.stl

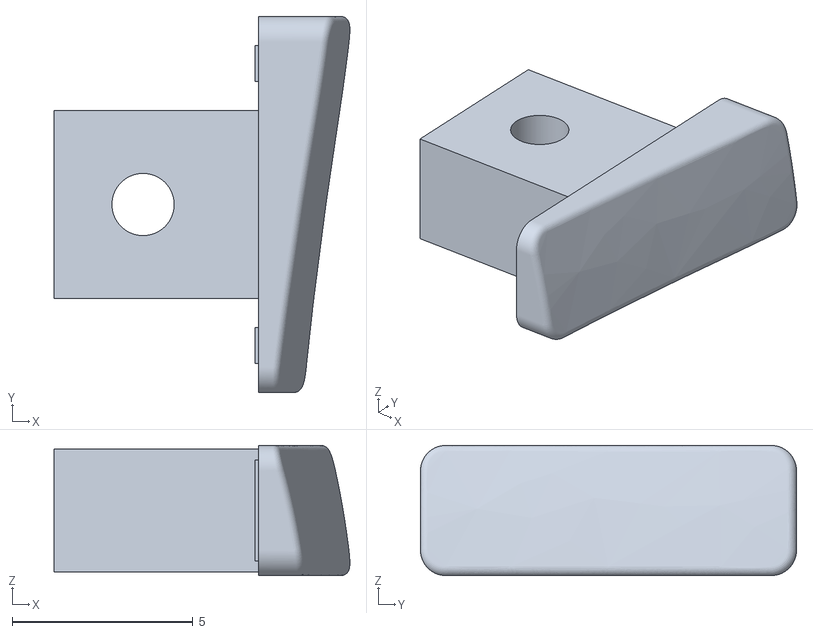
[picture p90: CAD file, 2026-10-17]
exports/rebuild_r3_3/print/SIDE_FRONT_KEY.stl
8.18 x 10.4 x 3.60
