Quietmirror/github/exports/v09/ATK_A1_PLUS/charge_powerpath_EST.step

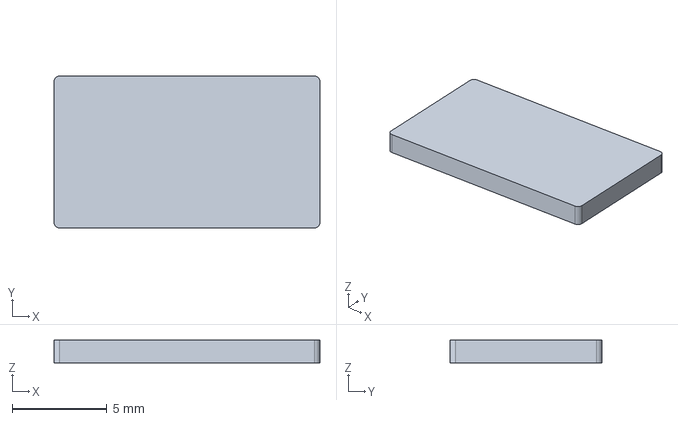
[picture p91: CAD file, 2026-10-15]
exports/v09/ATK_A1_PLUS/charge_powerpath_EST.step
14.0 x 8.00 x 1.20 mm
