Quietmirror/github/exports/v09/PAW3950_CUSTOM/right_wire_corridor_EST.stl

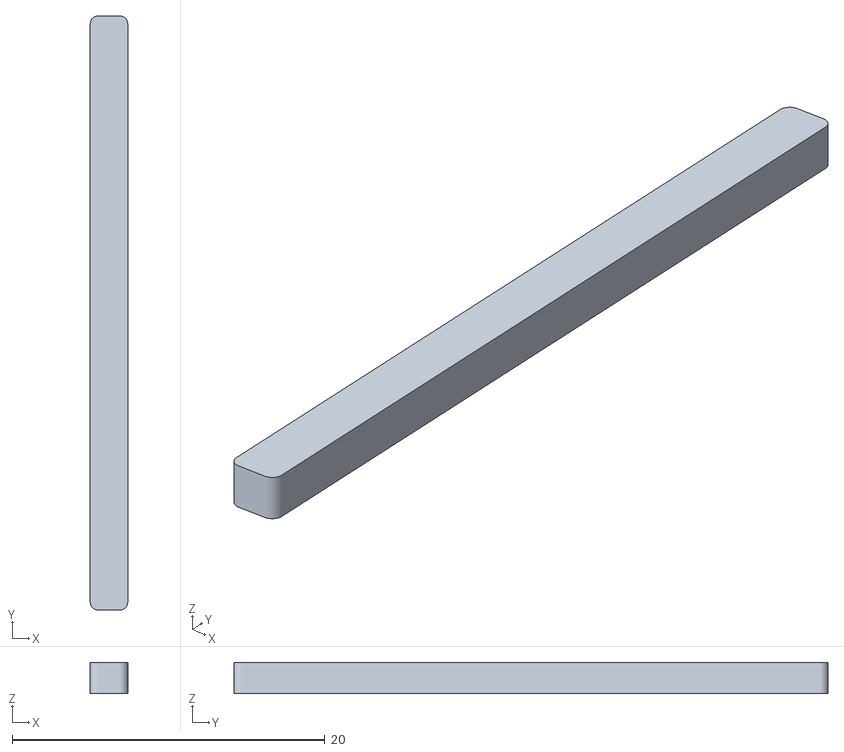
[picture p93: CAD file, 2026-10-15]
exports/v09/PAW3950_CUSTOM/right_wire_corridor_EST.stl
2.40 x 38.0 x 2.00
