Quietmirror/github/exports/v09/placed/BODY.stl

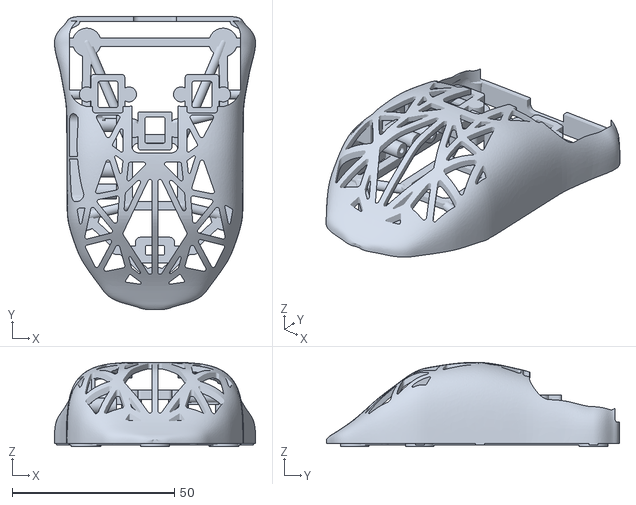
[picture p94: CAD file, 2026-10-15]
exports/v09/placed/BODY.stl
62.0 x 90.3 x 26.0
