Quietmirror/github/exports/v09/print/middle_TRAY.step

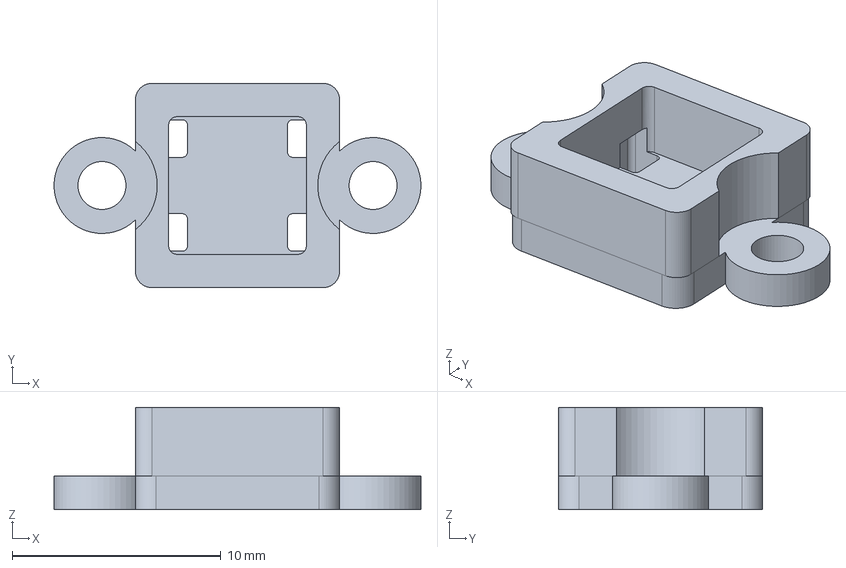
[picture p95: CAD file, 2026-10-15]
exports/v09/print/middle_TRAY.step
17.6 x 9.80 x 4.90 mm
