Quietmirror/github/exports/v09/ATK_A1_PLUS/donor_antenna_region_EST.step

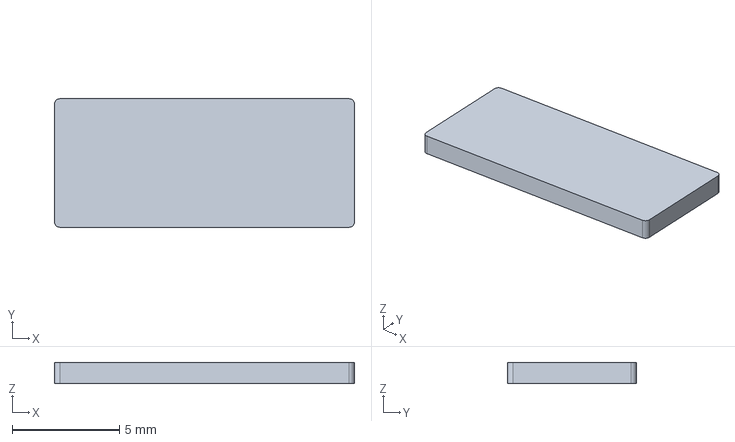
[picture p97: CAD file, 2026-10-15]
exports/v09/ATK_A1_PLUS/donor_antenna_region_EST.step
14.0 x 6.00 x 1.00 mm
