Quietmirror/github/exports/v09/PAW3950_CUSTOM/battery_plug_EST.step

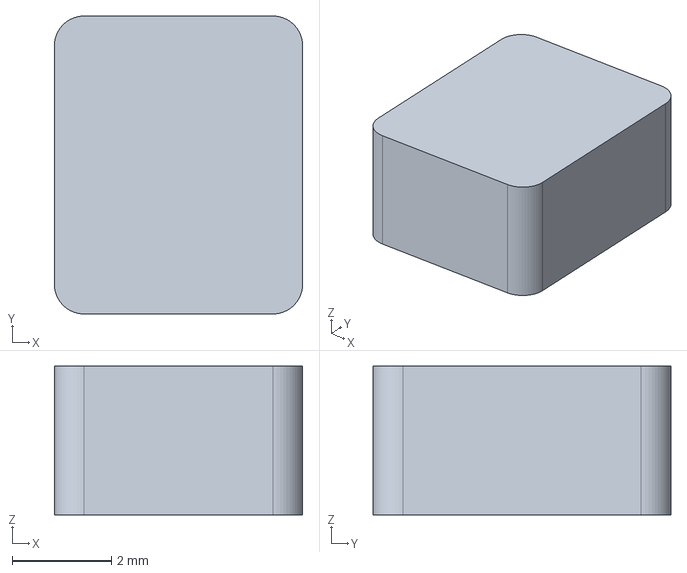
[picture p98: CAD file, 2026-10-15]
exports/v09/PAW3950_CUSTOM/battery_plug_EST.step
5.00 x 6.00 x 3.00 mm
