Quietmirror/github/exports/v09/placed/thumb_front_TRAY.step

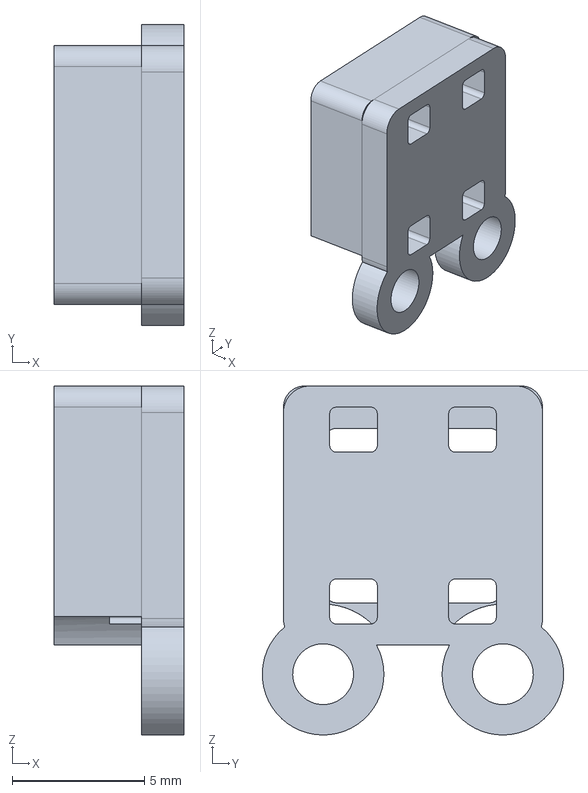
[picture p99: CAD file, 2026-10-15]
exports/v09/placed/thumb_front_TRAY.step
4.90 x 11.4 x 13.2 mm
