Quietmirror/github/exports/v09/quietmirror_V0.9_MECHANICAL_VIEW_ONLY.3mf

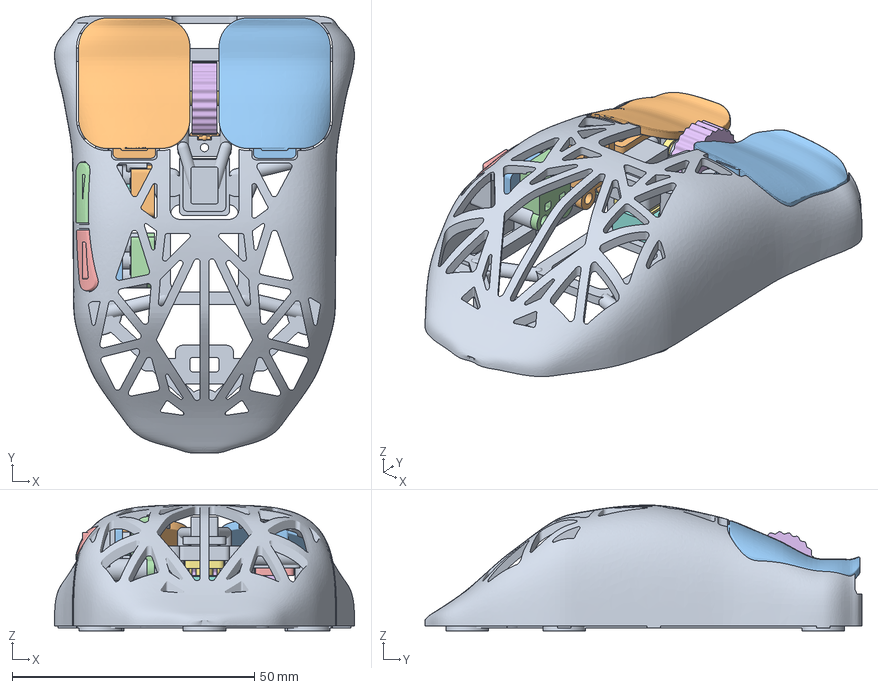
[picture p100: CAD file, 2026-10-15]
exports/v09/quietmirror_V0.9_MECHANICAL_VIEW_ONLY.3mf
62.0 x 90.3 x 26.0 mm
BODY.stl
left_KEY.stl
right_KEY.stl
thumb_front_KEY.stl
thumb_rear_KEY.stl
WHEEL.stl
AXLE.stl
AXLE_WASHER.stl
WHEEL_CARRIER.stl
DETENT_LEAF.stl
left_RETAINER.stl
left_TRAY.stl
right_RETAINER.stl
right_TRAY.stl
middle_RETAINER.stl
middle_TRAY.stl
thumb_front_RETAINER.stl
thumb_front_TRAY.stl
thumb_rear_RETAINER.stl
thumb_rear_TRAY.stl
left_SWITCH_EXAMPLE.stl
right_SWITCH_EXAMPLE.stl
middle_SWITCH_EXAMPLE.stl
thumb_front_SWITCH_EXAMPLE.stl
thumb_rear_SWITCH_EXAMPLE.stl
