Quietmirror/github/releases/Quietmirror-L2-Research/BOTH_ADAPTER_KITS_SINGLE_PLATE.3mf

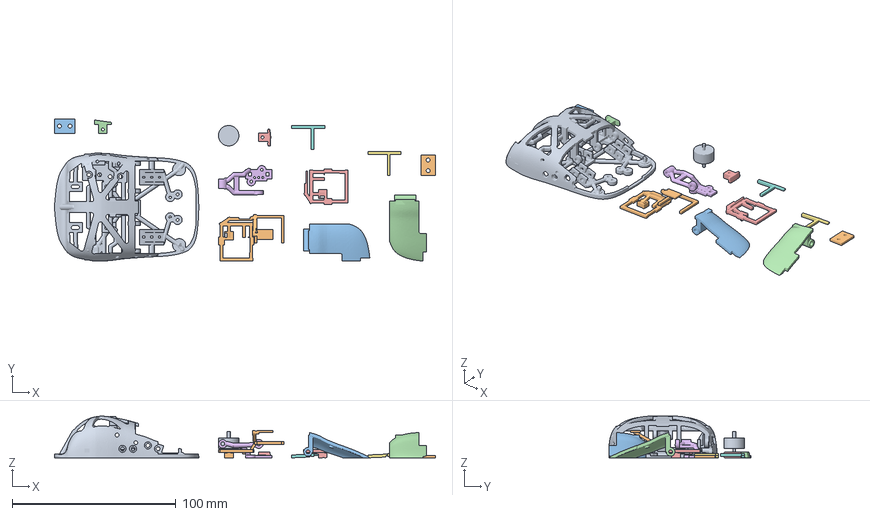
[picture p101: CAD file, 2026-10-17]
releases/Quietmirror-L2-Research/BOTH_ADAPTER_KITS_SINGLE_PLATE.3mf
232.9 x 87.1 x 25.6 mm
H_REMOVABLE_CARRIER_EST
LEFT_KEY
RIGHT_KEY
D_REMOVABLE_CARRIER_EST
WHEEL_CARRIER
H_SENSOR_SEAT_EST
D_SENSOR_SEAT_EST
WHEEL
SIDE_FRONT_KEY_SWITCH_CLAMP
SIDE_REAR_KEY_SWITCH_CLAMP
SIDE_FRONT_KEY
SIDE_REAR_KEY
