Quietmirror/github/exports/v09/ATK_A1_PLUS/encoder_EST.step

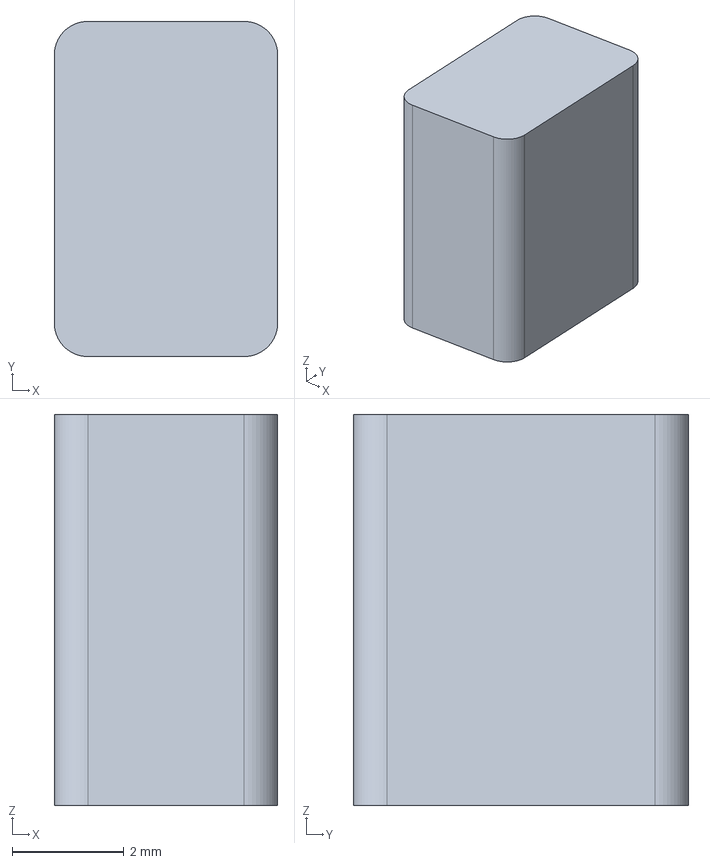
[picture p102: CAD file, 2026-10-15]
exports/v09/ATK_A1_PLUS/encoder_EST.step
4.00 x 6.00 x 7.00 mm
