Quietmirror/github/exports/rebuild_r3_3/print/WHEEL_CARRIER.stl

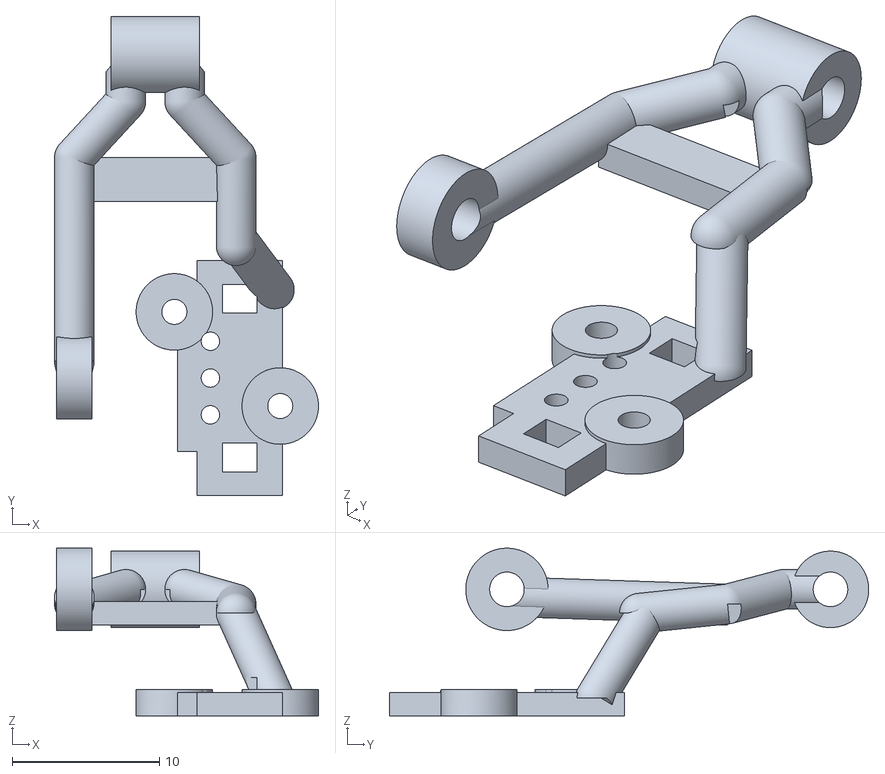
[picture p104: CAD file, 2026-10-16]
exports/rebuild_r3_3/print/WHEEL_CARRIER.stl
17.9 x 32.6 x 11.4
