Quietmirror/github/exports/v09/placed/thumb_rear_SWITCH_EXAMPLE.step

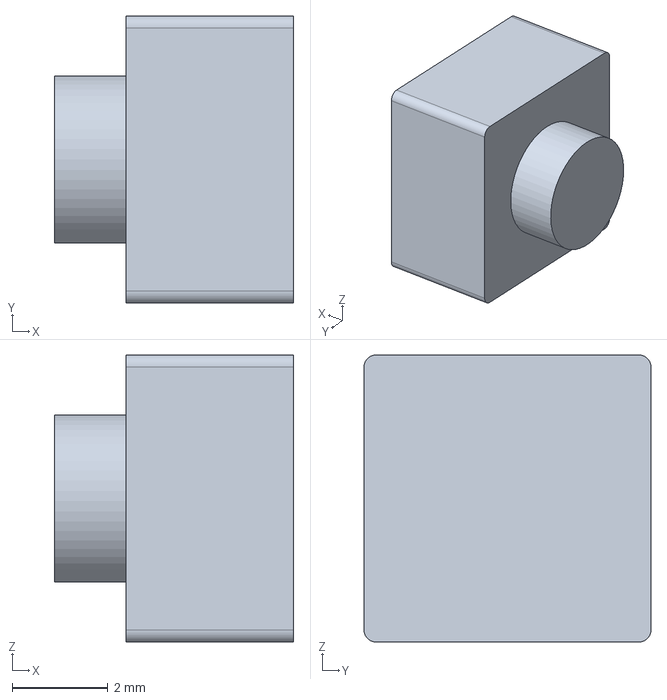
[picture p105: CAD file, 2026-10-15]
exports/v09/placed/thumb_rear_SWITCH_EXAMPLE.step
5.00 x 6.00 x 6.00 mm
