Quietmirror/github/exports/v09/print/thumb_rear_RETAINER.step

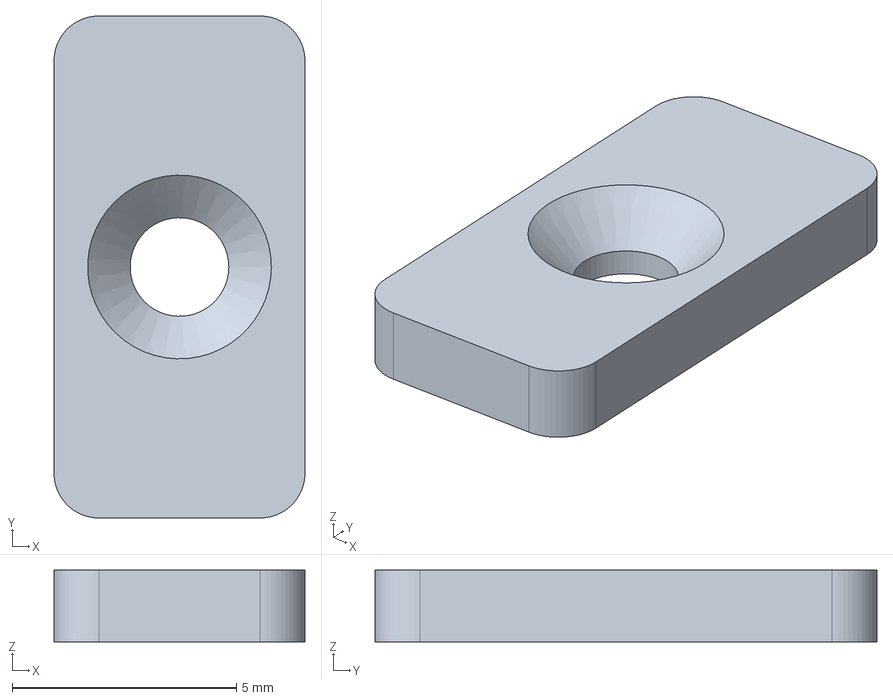
[picture p106: CAD file, 2026-10-15]
exports/v09/print/thumb_rear_RETAINER.step
5.60 x 11.2 x 1.60 mm
