Quietmirror/github/releases/Quietmirror-L2-Research/D_ALL_PARTS_SINGLE_PLATE.3mf

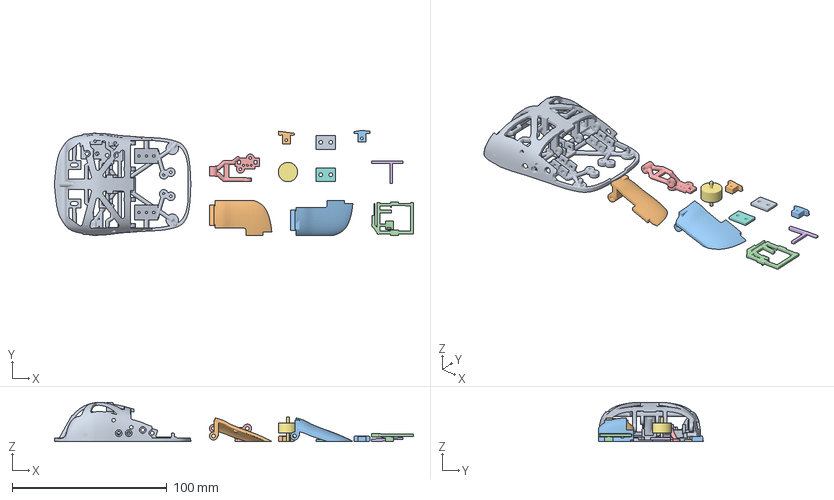
[picture p108: CAD file, 2026-10-17]
releases/Quietmirror-L2-Research/D_ALL_PARTS_SINGLE_PLATE.3mf
232.4 x 67.7 x 25.6 mm
LEFT_KEY
RIGHT_KEY
D_REMOVABLE_CARRIER_EST
WHEEL_CARRIER
D_SENSOR_SEAT_EST
WHEEL
SIDE_FRONT_KEY_SWITCH_CLAMP
SIDE_REAR_KEY_SWITCH_CLAMP
SIDE_FRONT_KEY
SIDE_REAR_KEY
