Quietmirror/github/exports/rebuild_r3_3/print/RIGHT_KEY.stl

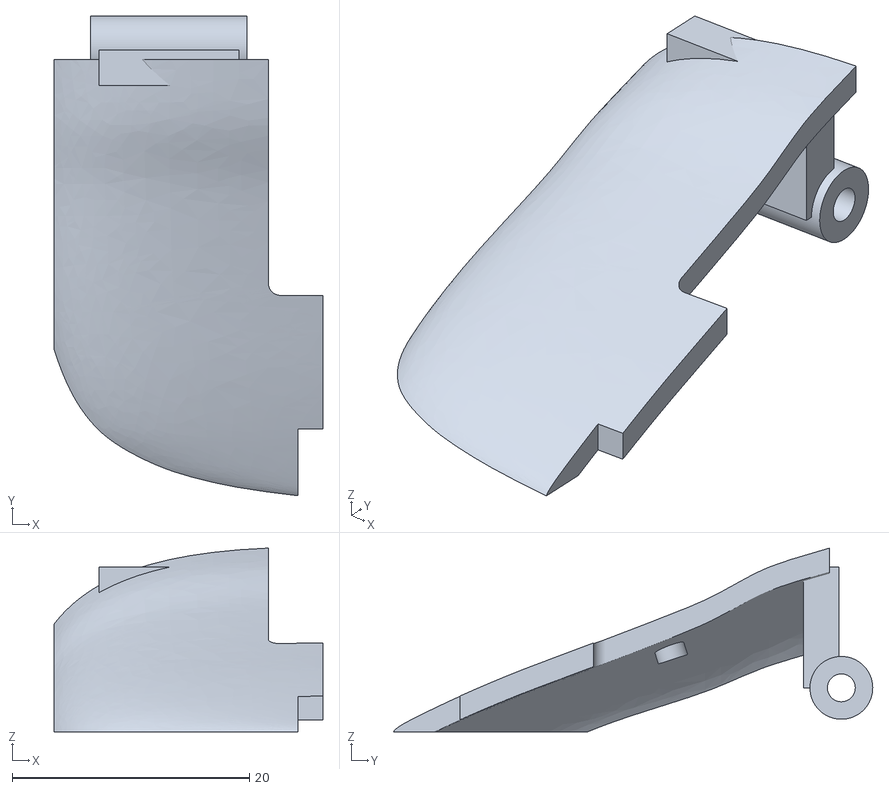
[picture p109: CAD file, 2026-10-16]
exports/rebuild_r3_3/print/RIGHT_KEY.stl
22.7 x 40.5 x 15.5
