Quietmirror/github/exports/v09/print/WHEEL_CARRIER.step

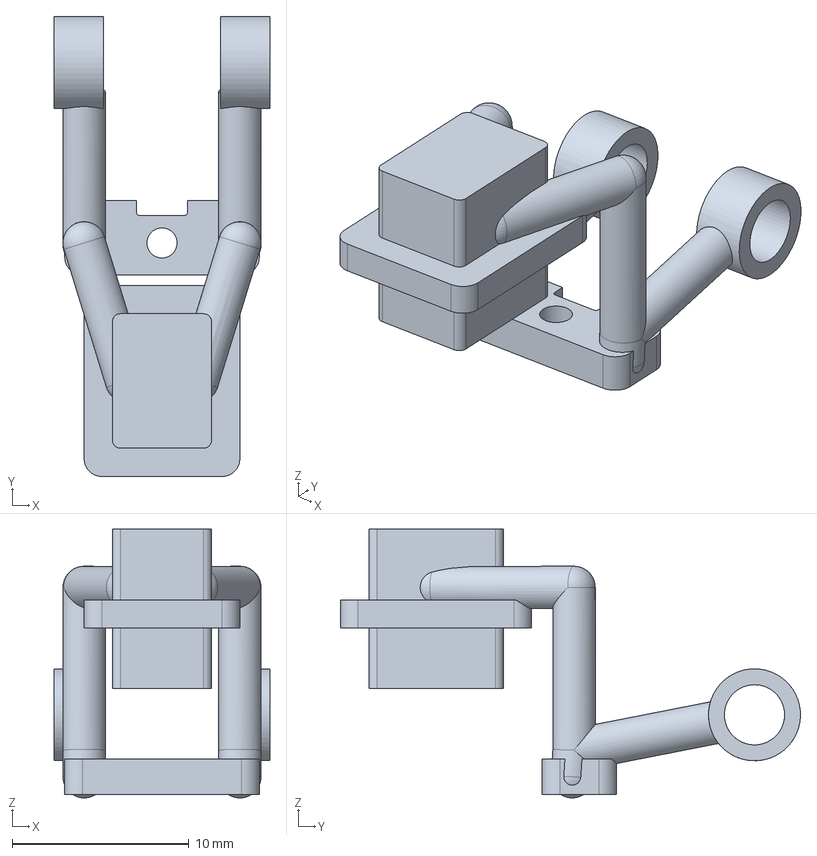
[picture p112: CAD file, 2026-10-15]
exports/v09/print/WHEEL_CARRIER.step
12.2 x 26.0 x 15.2 mm
