Quietmirror/github/exports/rebuild_r3_3/h/print/WHEEL.stl

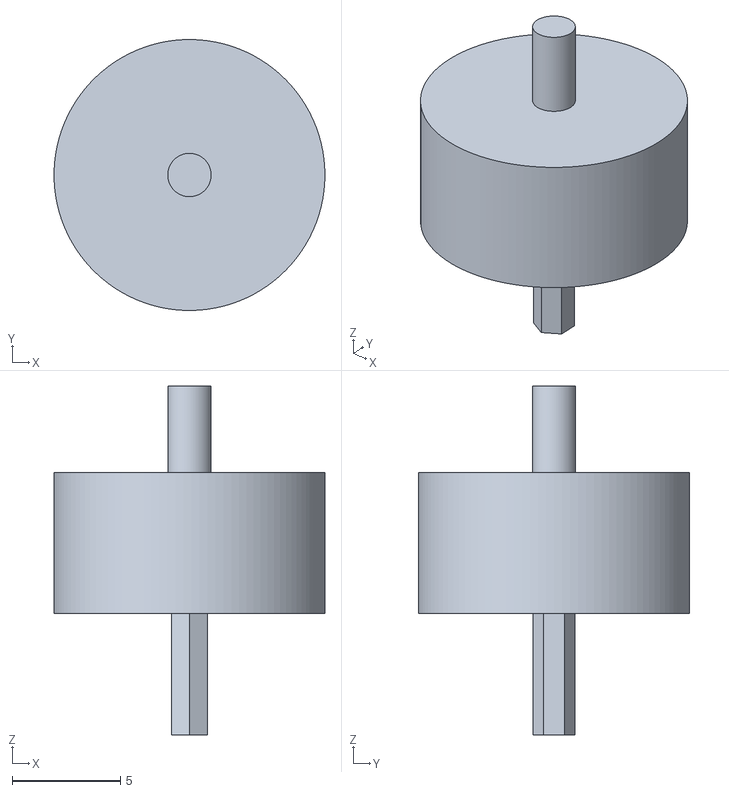
[picture p113: CAD file, 2026-10-16]
exports/rebuild_r3_3/h/print/WHEEL.stl
12.5 x 12.5 x 16.1
