Quietmirror/github/exports/v09/ATK_A1_PLUS/power_switch_tab_EST.step

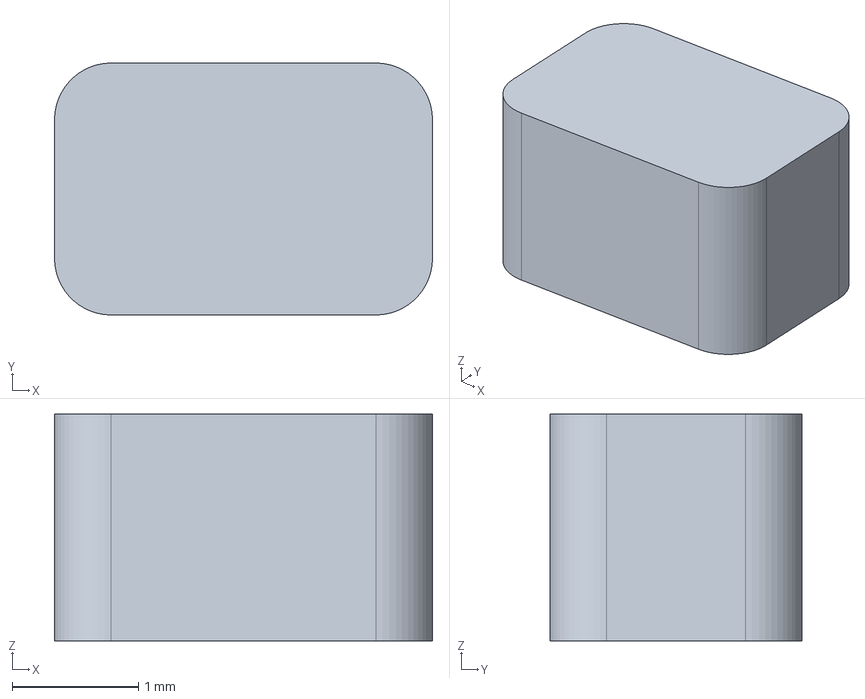
[picture p114: CAD file, 2026-10-15]
exports/v09/ATK_A1_PLUS/power_switch_tab_EST.step
3.00 x 2.00 x 1.80 mm
