Quietmirror/github/exports/v09/placed/middle_RETAINER.step

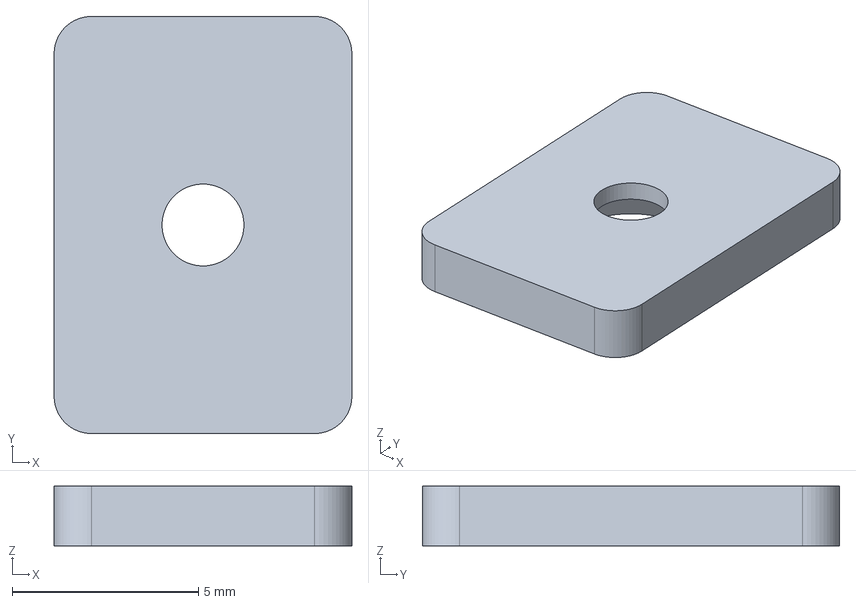
[picture p115: CAD file, 2026-10-15]
exports/v09/placed/middle_RETAINER.step
8.00 x 11.2 x 1.60 mm
