Quietmirror/github/exports/v09/PAW3950_CUSTOM/sensor_package_EST.step

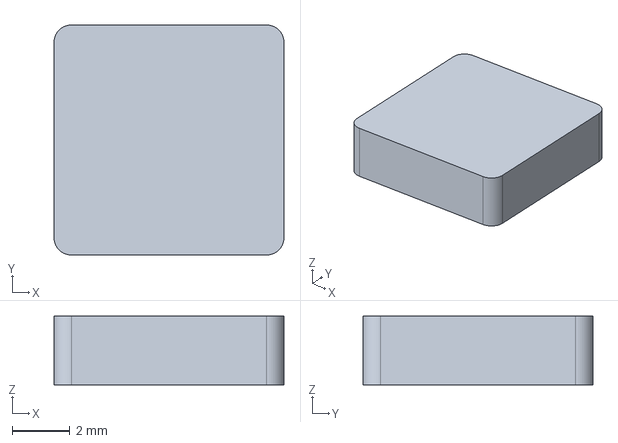
[picture p116: CAD file, 2026-10-15]
exports/v09/PAW3950_CUSTOM/sensor_package_EST.step
8.00 x 8.00 x 2.40 mm
