Quietmirror/github/exports/v09/PAW3950_CUSTOM/MCU_RF_EST.step

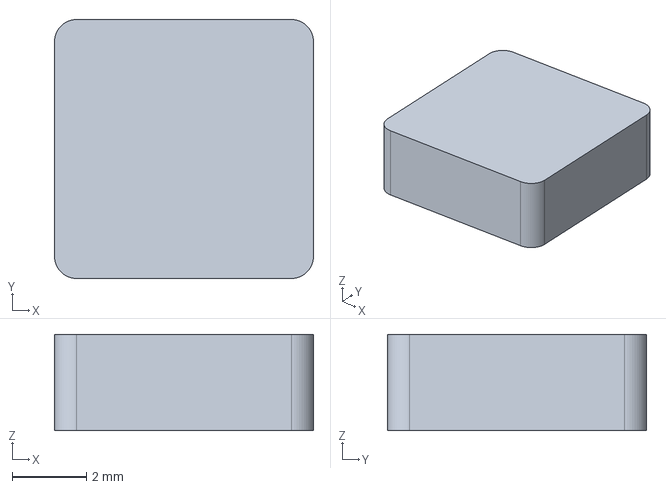
[picture p117: CAD file, 2026-10-15]
exports/v09/PAW3950_CUSTOM/MCU_RF_EST.step
7.00 x 7.00 x 2.60 mm
