Quietmirror/github/exports/v09/ATK_A1_PLUS/USB_C_EST.step

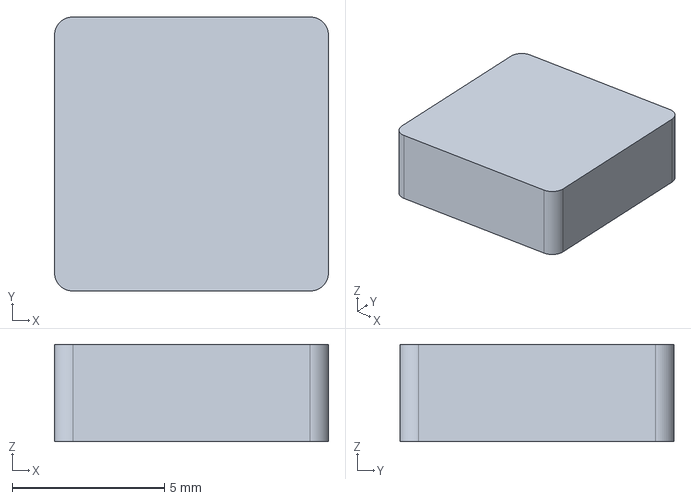
[picture p118: CAD file, 2026-10-15]
exports/v09/ATK_A1_PLUS/USB_C_EST.step
9.00 x 9.00 x 3.20 mm
