Quietmirror/github/exports/v09/PAW3950_CUSTOM/power_switch_body_EST.step

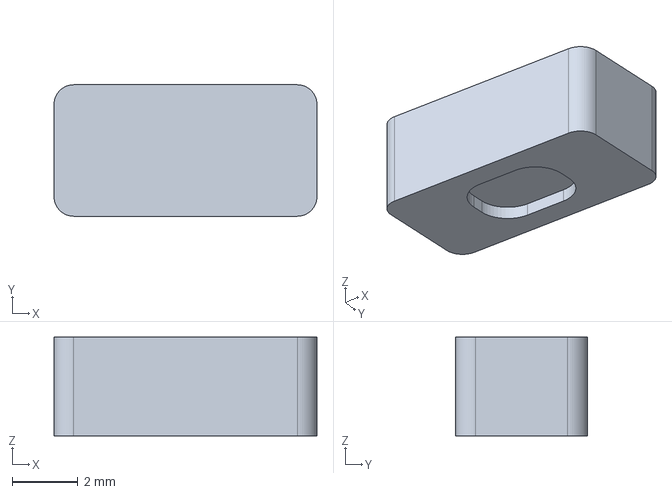
[picture p119: CAD file, 2026-10-15]
exports/v09/PAW3950_CUSTOM/power_switch_body_EST.step
8.00 x 4.00 x 3.00 mm
