Quietmirror/github/exports/v09/ATK_A1_PLUS/battery_500mAh_TARGET.step

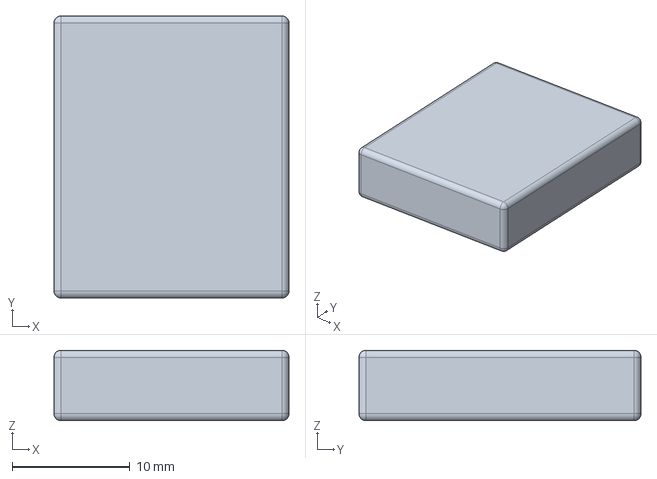
[picture p120: CAD file, 2026-10-15]
exports/v09/ATK_A1_PLUS/battery_500mAh_TARGET.step
20.0 x 24.0 x 6.00 mm
