Quietmirror/github/exports/v09/PAW3950_CUSTOM/battery_service_EST.stl

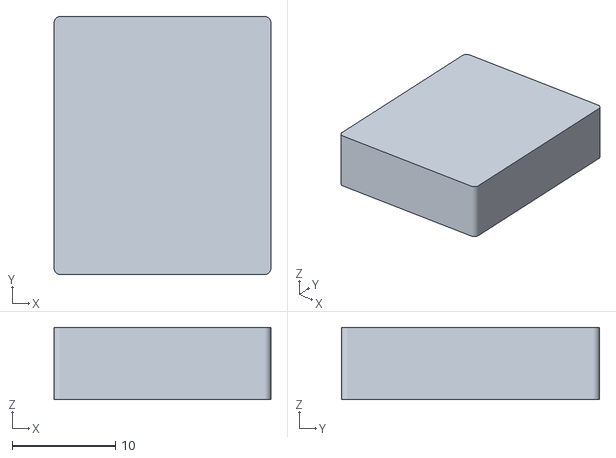
[picture p121: CAD file, 2026-10-15]
exports/v09/PAW3950_CUSTOM/battery_service_EST.stl
21.0 x 25.0 x 7.00
