Quietmirror/github/exports/v09/placed/thumb_rear_KEY.step

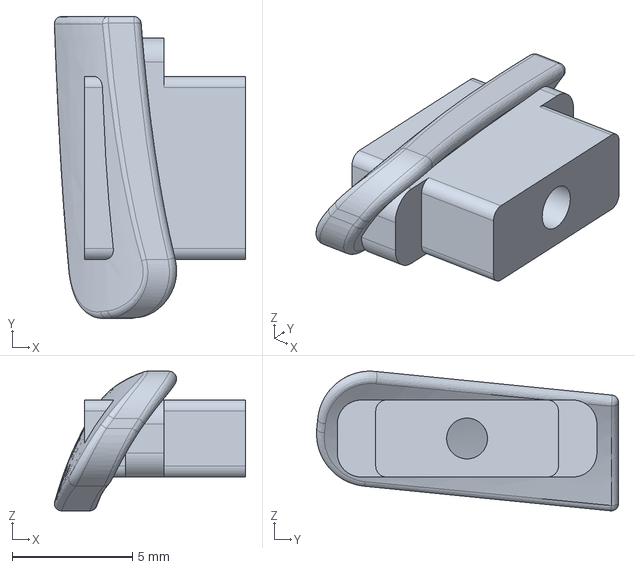
[picture p122: CAD file, 2026-10-15]
exports/v09/placed/thumb_rear_KEY.step
7.96 x 12.6 x 5.81 mm
