Quietmirror/github/exports/v09/ATK_A1_PLUS/antenna_clearance_EST.stl

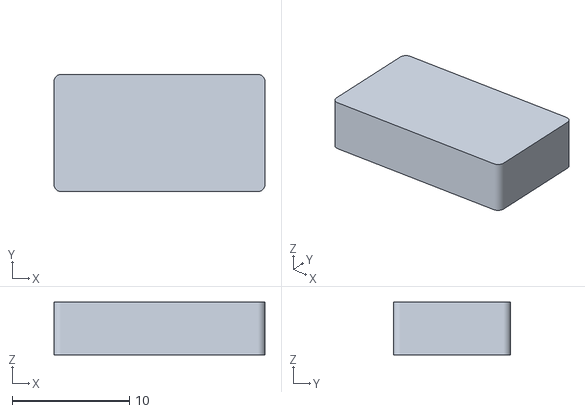
[picture p123: CAD file, 2026-10-15]
exports/v09/ATK_A1_PLUS/antenna_clearance_EST.stl
18.0 x 10.0 x 4.50
