Quietmirror/github/exports/v09/ATK_A1_PLUS/optical_path_EST.stl

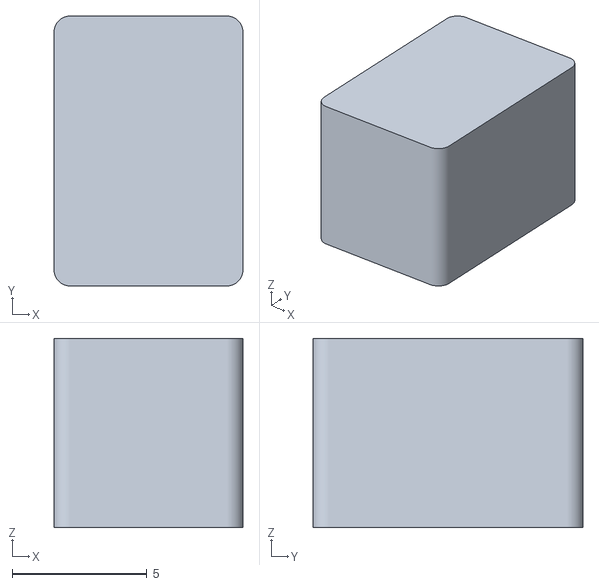
[picture p125: CAD file, 2026-10-15]
exports/v09/ATK_A1_PLUS/optical_path_EST.stl
7.00 x 10.0 x 7.00
