Quietmirror/github/exports/v09/PAW3950_CUSTOM/USB_plug_EST.stl

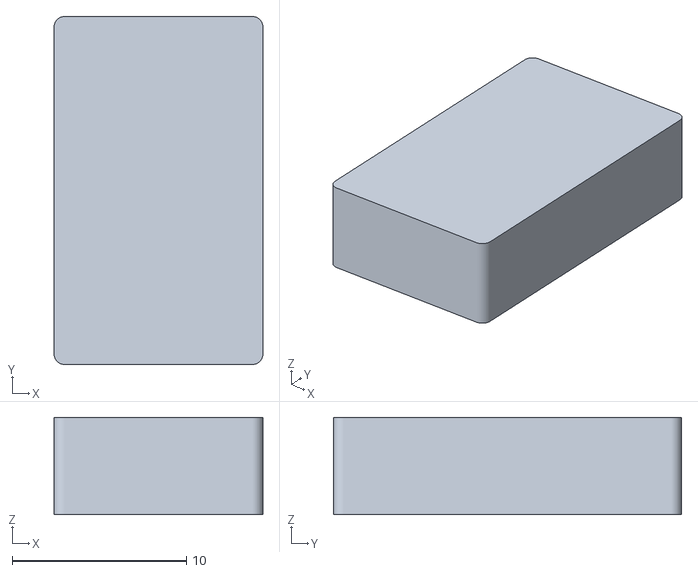
[picture p126: CAD file, 2026-10-15]
exports/v09/PAW3950_CUSTOM/USB_plug_EST.stl
12.0 x 20.0 x 5.60
