Quietmirror/github/(list of files, cad)

Other CAD files:
releases/Fenrir-MiniSE-R3.2/FENRIR_MINISE_R3_2.FCStd
releases/Fenrir-MiniSE-R3.1/FENRIR_MINISE_R3_1.FCStd
releases/Fenrir-MiniSE-R3.2/FENRIR_MINISE_R3_2_PLA_PRINT_PLATE.3mf
releases/Fenrir-MiniSE-R3/FENRIR_MINISE_R3_PLA_PRINT_PLATE.3mf
exports/rebuild_r3_3/h/print/SIDE_REAR_KEY_SWITCH_CLAMP.stl
exports/v09/print/thumb_front_TRAY.step
exports/rebuild_r3_3/d/print/SIDE_REAR_KEY_SWITCH_CLAMP.stl
exports/rebuild_r3_3/print/SIDE_REAR_KEY_SWITCH_CLAMP.stl
exports/v09/PAW3950_CUSTOM/lens_EST.step
exports/v09/placed/right_TRAY.step
exports/v09/print/left_TRAY.step
exports/v09/ATK_A1_PLUS/left_wire_corridor_EST.stl
exports/v09/PAW3950_CUSTOM/encoder_EST.step
exports/v09/PAW3950_CUSTOM/power_switch_tab_EST.step
exports/v09/print/AXLE.step
exports/rebuild_r3_3/print/LEFT_KEY.stl
exports/v09/placed/thumb_front_SWITCH_EXAMPLE.step
exports/v09/print/middle_RETAINER.step
exports/v09/ATK_A1_PLUS/battery_plug_EST.step
exports/v09/print/left_KEY.step
exports/rebuild_r3_3/d/print/LEFT_KEY.stl
exports/rebuild_r3_3/h/print/LEFT_KEY.stl
exports/v09/placed/left_SWITCH_EXAMPLE.step
exports/v09/print/right_RETAINER.step
exports/v09/ATK_A1_PLUS/sensor_package_EST.step
exports/v09/placed/left_TRAY.step
exports/v09/print/right_TRAY.step
exports/v09/placed/thumb_front_RETAINER.step
exports/v09/print/left_RETAINER.step
exports/v09/ATK_A1_PLUS/power_switch_body_EST.step
exports/v09/PAW3950_CUSTOM/left_wire_corridor_EST.stl
exports/v09/print/thumb_rear_KEY.step
exports/v09/PAW3950_CUSTOM/USB_C_EST.step
exports/v09/placed/thumb_rear_RETAINER.step
exports/v09/ATK_A1_PLUS/side_board_EST.step
exports/v09/PAW3950_CUSTOM/battery_500mAh_TARGET.step
exports/v09/placed/thumb_front_KEY.step
exports/v09/print/DETENT_LEAF.step
exports/v09/PAW3950_CUSTOM/antenna_clearance_EST.stl
exports/v09/print/WHEEL.step
exports/v09/placed/thumb_rear_TRAY.step
exports/v09/print/thumb_front_RETAINER.step
exports/v09/placed/left_RETAINER.step
exports/v09/print/right_KEY.step
exports/v09/placed/right_RETAINER.step
exports/v09/print/thumb_rear_TRAY.step
exports/v09/placed/middle_TRAY.step
exports/v09/placed/right_KEY.step
exports/v09/placed/WHEEL_CARRIER.step
exports/v09/placed/middle_SWITCH_EXAMPLE.step
exports/v09/placed/right_SWITCH_EXAMPLE.step
exports/quietmirror_fingertip_V0.1.stl
exports/rebuild_r3_2/print/BODY.stl
exports/rebuild_r3_2/print/SIDE_FRONT_KEY.stl
exports/rebuild_r3_2/print/SIDE_FRONT_KEY_SWITCH_CLAMP.stl
exports/rebuild_r3_2/print/SIDE_REAR_KEY.stl
exports/rebuild_r3_2/print/SIDE_REAR_KEY_SWITCH_CLAMP.stl
exports/v02/electronic_envelopes_V0.2_ESTIMATES.step
exports/v02/quietmirror_fingertip_V0.2.step
exports/v02/quietmirror_fingertip_V0.2.stl
exports/v02/quietmirror_fingertip_V0.2_PRINT.3mf
exports/v03/electronic_envelopes_V0.3_ESTIMATES.step
exports/v03/quietmirror_fingertip_V0.3_FIT.step
exports/v03/quietmirror_fingertip_V0.3_FIT.stl
exports/v03/quietmirror_fingertip_V0.3_PRINT.3mf
exports/v03/quietmirror_fingertip_V0.3_SHELL.step
exports/v03/quietmirror_fingertip_V0.3_SHELL.stl
exports/v03/side_button_1_V0.3_PRINT.step
exports/v03/side_button_1_V0.3_PRINT.stl
exports/v03/side_button_2_V0.3_PRINT.step
exports/v03/side_button_2_V0.3_PRINT.stl
exports/v03/side_button_assembly_V0.3.step
exports/v04/electronic_envelopes_V0.4_ESTIMATES.step
exports/v04/quietmirror_fingertip_V0.4_FIT.step
exports/v04/quietmirror_fingertip_V0.4_FIT.stl
exports/v04/quietmirror_fingertip_V0.4_PRINT.3mf
exports/v04/quietmirror_fingertip_V0.4_SHELL.step
exports/v04/quietmirror_fingertip_V0.4_SHELL.stl
exports/v04/side_button_1_V0.4_PRINT.step
exports/v04/side_button_2_V0.4_PRINT.step
exports/v04/side_button_assembly_V0.4.step
exports/v05/electronic_envelopes_V0.5_ESTIMATES.step
exports/v05/quietmirror_fingertip_V0.5_FIT.step
exports/v05/quietmirror_fingertip_V0.5_FIT.stl
exports/v05/quietmirror_fingertip_V0.5_PRINT.3mf
exports/v05/quietmirror_fingertip_V0.5_SHELL.step
exports/v05/quietmirror_fingertip_V0.5_SHELL.stl
exports/v05/side_button_1_V0.5_PRINT.step
exports/v05/side_button_2_V0.5_PRINT.step
exports/v05/side_button_assembly_V0.5.step
exports/v06/ATK_A1_PLUS/USB_harness_EST.stl
exports/v06/ATK_A1_PLUS/battery_500mAh_TARGET.stl
exports/v06/ATK_A1_PLUS/battery_harness_EST.stl
exports/v06/ATK_A1_PLUS/battery_plug_EST.stl
exports/v06/ATK_A1_PLUS/battery_swell_service_EST.stl
exports/v06/ATK_A1_PLUS/encoder_EST.stl
exports/v06/ATK_A1_PLUS/front_side_switch_EST.stl
exports/v06/ATK_A1_PLUS/left_key_travel_EST.stl
exports/v06/ATK_A1_PLUS/left_switch_EST.stl
exports/v06/ATK_A1_PLUS/middle_switch_EST.stl
exports/v06/ATK_A1_PLUS/rear_side_switch_EST.stl
exports/v06/ATK_A1_PLUS/right_key_travel_EST.stl
exports/v06/ATK_A1_PLUS/right_switch_EST.stl
exports/v06/ATK_A1_PLUS/side_board_EST.stl
exports/v06/ATK_A1_PLUS/side_harness_EST.stl
exports/v06/ATK_A1_PLUS/wheel_EST.stl
exports/v06/ATK_A1_PLUS/wheel_axle_EST.stl
exports/v06/PAW3950_CUSTOM/MCU_RF_EST.stl
exports/v06/PAW3950_CUSTOM/RF_board_EST.stl
exports/v06/PAW3950_CUSTOM/RF_harness_EST.stl
exports/v06/PAW3950_CUSTOM/USB_harness_EST.stl
exports/v06/PAW3950_CUSTOM/battery_500mAh_TARGET.stl
exports/v06/PAW3950_CUSTOM/battery_harness_EST.stl
exports/v06/PAW3950_CUSTOM/battery_plug_EST.stl
exports/v06/PAW3950_CUSTOM/battery_swell_service_EST.stl
exports/v06/PAW3950_CUSTOM/custom_mainboard_EST.stl
exports/v06/PAW3950_CUSTOM/encoder_EST.stl
exports/v06/PAW3950_CUSTOM/front_side_switch_EST.stl
exports/v06/PAW3950_CUSTOM/left_key_travel_EST.stl
exports/v06/PAW3950_CUSTOM/left_switch_EST.stl
exports/v06/PAW3950_CUSTOM/middle_switch_EST.stl
exports/v06/PAW3950_CUSTOM/rear_side_switch_EST.stl
exports/v06/PAW3950_CUSTOM/right_key_travel_EST.stl
exports/v06/PAW3950_CUSTOM/right_switch_EST.stl
exports/v06/PAW3950_CUSTOM/sensor_board_EST.stl
exports/v06/PAW3950_CUSTOM/side_board_EST.stl
exports/v06/PAW3950_CUSTOM/side_harness_EST.stl
exports/v06/PAW3950_CUSTOM/wheel_EST.stl
exports/v06/PAW3950_CUSTOM/wheel_axle_EST.stl
exports/v06/quietmirror_V0.6_ATK_A1_PLUS_ESTIMATED.step
exports/v06/quietmirror_V0.6_ATK_A1_PLUS_ESTIMATED_CLEARANCES.step
exports/v06/quietmirror_V0.6_ATK_A1_PLUS_ESTIMATED_VIEW_ONLY.3mf
exports/v06/quietmirror_V0.6_PAW3950_CUSTOM_ESTIMATED.step
exports/v06/quietmirror_V0.6_PAW3950_CUSTOM_ESTIMATED_CLEARANCES.step
exports/v06/quietmirror_V0.6_PAW3950_CUSTOM_ESTIMATED_VIEW_ONLY.3mf
exports/v06/quietmirror_fingertip_V0.6_FIT.step
exports/v06/quietmirror_fingertip_V0.6_FIT.stl
exports/v06/quietmirror_fingertip_V0.6_PRINT.3mf
exports/v06/quietmirror_fingertip_V0.6_SHELL.step
exports/v06/quietmirror_fingertip_V0.6_SHELL.stl
exports/v06/side_button_1_V0.6_PRINT.step
exports/v06/side_button_1_V0.6_PRINT.stl
exports/v06/side_button_2_V0.6_PRINT.step
exports/v06/side_button_2_V0.6_PRINT.stl
exports/v07/ATK_A1_PLUS/USB_C_EST.step
exports/v07/ATK_A1_PLUS/antenna_clearance_EST.stl
exports/v07/ATK_A1_PLUS/battery_500mAh_TARGET.step
exports/v07/ATK_A1_PLUS/battery_plug_EST.step
exports/v07/ATK_A1_PLUS/charge_powerpath_EST.step
exports/v07/ATK_A1_PLUS/donor_MCU_RF_EST.step
exports/v07/ATK_A1_PLUS/donor_MCU_RF_EST.stl
exports/v07/ATK_A1_PLUS/donor_antenna_region_EST.step
exports/v07/ATK_A1_PLUS/donor_antenna_region_EST.stl
exports/v07/ATK_A1_PLUS/donor_mainboard_EST.step
exports/v07/ATK_A1_PLUS/donor_mainboard_EST.stl
exports/v07/ATK_A1_PLUS/encoder_EST.step
exports/v07/ATK_A1_PLUS/encoder_EST.stl
exports/v07/ATK_A1_PLUS/left_wire_corridor_EST.stl
exports/v07/ATK_A1_PLUS/lens_EST.step
exports/v07/ATK_A1_PLUS/power_switch_body_EST.step
exports/v07/ATK_A1_PLUS/power_switch_body_EST.stl
exports/v07/ATK_A1_PLUS/power_switch_tab_EST.step
exports/v07/ATK_A1_PLUS/right_wire_corridor_EST.stl
exports/v07/ATK_A1_PLUS/sensor_package_EST.step
exports/v07/ATK_A1_PLUS/side_board_EST.step
exports/v07/ATK_A1_PLUS/side_board_EST.stl
exports/v07/PAW3950_CUSTOM/MCU_RF_EST.step
exports/v07/PAW3950_CUSTOM/RF_board_EST.step
exports/v07/PAW3950_CUSTOM/USB_C_EST.step
exports/v07/PAW3950_CUSTOM/battery_500mAh_TARGET.step
exports/v07/PAW3950_CUSTOM/battery_plug_EST.step
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
