Quietmirror/github/reports/l2_revision/CONSTRUCTION_FAILURES.md

# 保留的真实构建失败

这些失败没有作为通过结果。修订源码另行生成候选；原始构造可从 Git 历史复现。

- F1B：侧键及整套内部机构 Z15.5、Y49/62。`FIXED_SUPPORT_23` 在真实螺丝刀入口圆柱切除后变为两个有效实体，构建检查主动终止。原因是新侧键第二颗 M2 的工具通路正对原 Y54/Y67.5 横梁。F1C 将上部横梁改到 Y58/Y71 后重新构建。未改五脚或底部横梁。
- B3 首轮：空间 V 形骨架共用顶点 (0,60.75,24.5)。前横梁在螺丝刀入口处被割断；`FIXED_SUPPORT_23: valid=True, solids=2`。第二轮改用前置顶点 (0,47.25,24.5)，质量与刚度须重算。
- B4 首轮：椭圆半径 Y=0.864、Z=1.6667 mm，端部局部加厚。横向变窄导致前工具圆柱完全切断横梁，报同一双实体错误。第二轮仅在工具通路附近恢复 Ø3.2 局部节点，保留完整工具通路，须重新筛查质量与薄筋。
- F1/F2/F1S/F1_P0/F2_P0：OCC 输出 BODY STL 出现四个局部相交面。换更小弦差或保留 Boolean 分面均未解决。F1_P0 通过独立 Gmsh CAD 表面离散取得闭合网格，无补洞/删料；随后仍查出真实装配干涉，未获放行。

F1_P0 的旧高侧键虽然能够直线装入，但上夹条及螺栓与横梁干涉，上背刚度下降，因此不是最终选择。

- F1C：整段上横梁移至 Y58/Y71 后，BODY 有两个有效实体，最终连通性检查拒绝导出。新的后横梁端点落入上壳窗口，不能用丢弃孤立横梁的方式“修复”。F1D 恢复原横梁端点，仅在每组两颗侧键螺丝的工具通路之间走局部折线；中间细段 Ø2.1，节点 Ø2.4；滑动导向从3.8延长至5.4 mm。该修正仍须新一轮检查。

## 上压载荷选面复核

首轮 `LC4_back_press_5N` 以高度及法向选面，包含部分内部横梁上表面，不能当作仅施加于外壳的手指压力。第二轮使用 `LC4_outer_back_press_5N`，增加距外部冠面参考0.15 mm的选面条件。两组原始作业目录分别保留，禁止混合两种工况比较。自由相向夹持工况不受此次上压修正影响。
