Quietmirror/github/reports/rebuild_r3_2/NOTICE_R3_2.md

# R3.2 attribution and license

2026 Quietmirror contributors. Original contoured side-key revision of the retained R3.1 reconstruction. No new external CAD, meshes or source incorporated. Existing CERN-OHL-P-2.0 terms and attribution retained. Views are renders of the actual generated CAD.

# R3.1 attribution and license

2026 Quietmirror contributors. Local short-foot revision of R3, retaining all earlier source attribution and CERN-OHL-P-2.0 terms. No new third-party CAD, mesh or source was incorporated. The diagrams are rendered from the actual generated project geometry.

# R3 attribution and license

2026 Quietmirror contributors. R3 makes local corrections to the R2 mechanical reconstruction and adds explicitly estimated electronic layouts. All older source attribution and CERN-OHL-P-2.0 terms are retained. R3 did not import manufacturer CAD, third-party scan geometry, or new external GPL source. Datasheets are linked, not relicensed or republished. R3 preview images are renders of this project's actual generated CAD.

The exact R2 base and source dependencies are included in R3_SOURCE_AND_BASE.zip. Native FCStd consists of named imported BRep features; edit the delivered Python/JSON to regenerate parameters. Estimated PCB outlines are original proposed interfaces, not measured supplier boards.

## Retained R2 attribution

# R2 attribution and license

2026 Quietmirror project contributors. This revision continues the independent parametric reconstruction in **ht1580/Quietmirror-mouse**, branch `rebuild/fenrir-minise-r1`, commit `07fcd46dc8b719804473313ddc0c5f36acd422a9`.

The original project license, **CERN-OHL-P-2.0**, is retained for the project's CAD, source and generated geometry. See the root `LICENSE` and `NOTICE.md`. Earlier reference projects retain their own licenses. No Kotinos GPL source or third-party mesh was newly incorporated into R2.

G-Wolves Fenrir Pro and Razer Viper Mini Signature Edition are commercial visual references. This is an independent reconstruction, not manufacturer CAD, a licensed replacement product or an endorsed design. Product names and marks belong to their owners. Manufacturer images and complete component manuals are linked in `PROVENANCE.md`, not redistributed under the project license. R2 previews are renders of the project's actual generated geometry.

Omron D2F, Alps Alpine EC10E and GCT USB4105 public drawings informed reference envelopes. The engineering assumptions and measured-versus-estimated boundary are documented; a reference envelope is not a supply specification or a verified electronic design.
