Quietmirror/github/reports/rebuild_r3/COMPATIBILITY.md

# R3 主板、配件与按键兼容性

## 判定范围

本轮没有实际主板，用户确认按估计包络继续。以下“通过”只针对所列坐标、尺寸和有限运动采样；不是供体替换件认证。ATK 方案是明确不通过的诊断模型，PAW3950 方案是尚未释放制造的分体布局。机械样机是第三种独立交付。

## 按键对应关系

| 操作 | 模型零件 → 对应参考件 | 几何结果 | 尚需实测 |
|---|---|---|---|
| 左键 | LEFT_KEY → SWITCH_LEFT / D2F | 2.8°，沿柱轴约 0.586 mm；全范围采样无刚性外壳穿透 | 自由／动作／总行程、回位、预压、摩擦 |
| 右键 | RIGHT_KEY → SWITCH_RIGHT / D2F | 与左键镜像，约 0.586 mm | 同上 |
| 侧前／侧后 | 两个 SIDE_*_KEY → 两枚 D2F | 滑移 0.60 mm，扣除假设 0.02 mm 间隙后约 0.580 mm | 捕获销防脱、导轨摩擦、真实开关柱高度 |
| 中键 | WHEEL_CARRIER → SWITCH_MIDDLE / D2F | 4.1°，沿柱轴约 0.585 mm；滚轮、小板、编码器与螺钉共同运动 | 编码器电缆柔性余量、微动回位力矩 |
| 滚动 | WHEEL → EC10E1220505 轮廓参考 | 同轴；六角对边 1.67 mm，参考孔下限 1.73 mm；圆轴 Ø2 对 Ø2.35 支撑孔 | 打印六角实际尺寸、配合扭矩、轴向保持与耐磨 |
| 充电口 | USB_C_REFERENCE → 新 USB 适配板 | 接口位置不变，板孔 X±7.8/Y13，螺钉头与垫圈纳入检查 | 具体连接器焊盘、外壳落位、线缆护套尺寸 |

主键与中键钢轴 Ø2 / 孔 Ø2.35，名义径向间隙 0.175 mm；侧捕获销 Ø1.5 / 孔 Ø1.72，名义径向间隙 0.11 mm。这些数字是设计值。0.4 mm 喷嘴不保证能稳定实现 0.06 mm 的六角对边差或 0.02–0.03 mm 的初始触点间隙，应先试印并修孔、校准作动面和止挡。

Omron D2F 公开图给出针柱型 PT 最大 0.5 mm、OT 最小 0.25 mm，OP 从安装孔基准计算。R3 采用移动作动平面与固定柱轴线的交点计算行程；没有把 Z 位移直接当作行程，也没有把 PT 最大值加 OT 最小值当成每个开关都安全的总行程。真实自由高度和实际 PT/OT 未测，约 0.58 mm 的模型压入量仍须按实购开关校准。[Omron 原图](https://omronfs.omron.com/en_US/ecb/products/pdf/en-d2f.pdf)

编码器图检查了 7 mm 安装高度、9.8 mm 本体宽、4.4 mm 厚、2.5 mm 信号脚间距及 1.73 mm 六角孔下限。本版打印载架的顶面为支承基准；小板在载架下方，Z=9.2–10.4，端子末端 Z=8.5，留约 0.7 mm 板下端子。两螺钉中心为 (8.5,26.1) 与 (1.3,32.5)。这是新设计的机械适配板轮廓，未交付电路或 Gerber。[Alps Alpine 原图](https://tech.alpsalpine.com/cms.media/product_catalog_ec_03_ec10e_en_a9ede251c7.pdf)

ATK 原板若固定了另一种微动、光学开关或不同轴高编码器，不能从以上表格推导它能匹配。是否允许外接独立五键、编码器与传感器，取决于真实接口和固件，当前未确认。

## 分体电子空间

| 元件／净空 | 本次假设尺寸（mm） | 状态 |
|---|---|---|
| 传感器板 | 18×18×1.2 | 估计，偏置布板以避开右侧电池；不是 PAW3950 标准板型 |
| 控制／无线板 | 18×18×1.2 | 从先验布局重新分区的目标面积，尚无原理图／布线 |
| PAW3950 封装 | 8×8×2.4 | 仅占位，实际封装与引脚须由供货资料确认 |
| 匹配镜头 | 12×14×4 | 仅占位，光学高度没有验收 |
| 电池 | 18×22×6 | 比旧 20×24×6 假设更小；实际容量未知 |
| 电池周围预留 | 19×23×7 | 每侧增加 0.5 mm，检查中未占用；不等于电芯膨胀安全认证 |
| 电池插头 | 5×6×3 | 仅包络，针数、极性、插拔方向未定 |
| 侧键板 | 1×30×4 | 估计竖板，六处端子槽按当前 D2F 模型避让；真实焊盘未设计 |
| 编码器板 | 最大 12.2×15.1×1.2，有边缘退让 | 按现有编码器／螺钉位置创建的自定义机械外形 |
| USB 板 | 20×10×1 | 自定义孔位，不能直接套用任意成品充电板 |
| 电源开关 | 本体 8×4×3、拨片 3×2×1.8 | 假设，底部开敞区触达需实物确认 |
| 远置天线 | 板 8×4×0.8，净空 12×8×5 | 假设分体天线，需要匹配网络和整机射频测试 |
| 走线 | USB、电池、侧键板、传感器板、天线五条通道 | 部分线束占位；不是全部端子、线径、弯曲半径及焊接工艺验证 |

以上实体和五条通道与完整机械机构共同检查了静态和按压运动。预留孔位只是项目自定接口，实际板未测前不制作供应商适配孔板。电池托架、主板支架和天线支架还需要按实购件设计；最终位置通过不等于已找到所有电子元件的安装路径。

## 光学高度与功能

传感器轴线沿 Z 垂直于鼠标垫。当前镜头占位最低点 Z=7.8 mm，并非 PAW3950 的正确工作距离。脚贴装在 Z=0 平台下面，故“镜头底面到鼠标垫 = 镜头底面 Z + 实际脚贴厚度”。应根据真实传感器板、封装、镜头卡扣与推荐工作高度重算板高／镜头高度，让光路穿过开放底部；不能用调 LOD 掩盖错误的光学距离。

400–6400 DPI、2.4 GHz 1 kHz、宏、LOD、左右／中键／双侧键、低延迟无线、电源开关和充电都是功能目标。未设计或烧录固件，也未验证接收器、RF、延迟、充电或续航。PAW3950 是传感器型号；无线 1 kHz 要由主板、固件和匹配接收器共同实现。没有引入用户不需要的可选 Sync 技术。

12 小时的电流预算应由实购电芯决定。按可用容量系数 0.75：300 mAh 对应平均电流 ≤18.75 mA；400 mAh ≤25 mA；500 mAh ≤31.25 mA。这是计算例，不说明 18×22×6 mm 一定能容纳任何一个容量。持续满性能耗电、电池实际容量、转换损耗和充电能力必须实测。

## 真实主板到手后必须量的尺寸

测量 PCB 完整外轮廓、厚度、双面最高元件及焊点；固定孔直径／坐标；传感器中心和 PCB 基准、镜头型号／安装堆叠／工作距离；五个开关的型号、位置、自由／动作／总行程；编码器轴高／孔形／脚距；USB 相对 PCB 的位置和插头护套；电池长宽厚、线头保护、插头与拔出方向；电源开关位置；天线区域、金属／电池距离；以及接收器型号、接口针序、电压与固件能力。

ATK 若保持原板原元件，须用实测 STEP 重新检查，不能偷偷删掉当前机构或裁板来宣称通过。半组装 PAW3950 板也须重新检查；本图只是一个分体架构的空间建议。
