Quietmirror/github/reports/rebuild_r3/INSTALLATION.md

# R3 打印、装配与校准

只打印 PRINT STL 或 3MF 内的 9 个塑料件。硬件、PCB、镜头、电池和线束包络不打印；ATK 红色板是失败诊断。

## 打印

0.4 mm 喷嘴、0.20 mm 层高、4 壁、20% 填充，普通 PLA，支撑允许覆盖所有区域。实际切片 44.29 g / 5h 35m 21s，包括支撑与裙边；按自己的打印机重新切片。BODY 五脚朝下，主键触感面朝上，侧键／压条按 PRINT 包朝向，滚轮圆轴端朝下、轴竖直；载架平置。清理悬空安装座、轴孔和小板支柱下方的支撑。

9 件塑料总体积 19.178 cm³，实体 PLA 约 23.78 g。壳体与键边的短弦不是普通壁厚承诺，新增支柱孔与端子孔之间最紧的设计平面筋约 1.69 mm；载架旧过渡区域仍有约 1.26 mm 的抽样弦。不要未经试印就整体减薄。

## 机械辅料与适配板

- D2F 针柱式参考微动 5 枚；用实购子型号核对自由高度、动作点和超行程。
- EC10E1220505 轮廓参考编码器 1 枚；核对 7 mm 支承高度和六角孔。
- 原 R2 微动固定：M2×12 10 枚、AF4×1.6 螺母 10 枚、OD5/ID2.2/厚0.3 垫圈 20 枚。
- R3 增加 M2×3 4 枚；USB 用 OD5/ID2.2/厚0.3 垫圈 2 枚，编码器板用 OD4.2/ID2.2/厚0.3 垫圈 2 枚。参考圆头包络 Ø3.8×1.6。导孔 Ø1.7 是试制方案，需校准螺纹和夹紧力，不是反复拆装寿命保证。
- 主键钢轴 Ø2×21.8 两根、载架钢轴 Ø2×13.8 一根、侧键捕获销 Ø1.5×5.6 两根；轴端采取可拆的防脱措施，不让胶进入活动孔。
- USB 自定义适配板 20×10×1 mm；编码器自定义适配板厚 1.2 mm、最大边界 12.2×15.1 mm，按 STEP 的缺口和孔位制作。它们不是随便购买同尺寸矩形板即可替换的成品，也没有电路／Gerber 生产文件。
- 约 Ø7–7.5 mm 圆点脚贴 5 枚，实际厚度记入光学尺寸链。

## 已检查的机械安装顺序

1. 清理主壳，检查五脚、导向、轴孔、端子孔和两处新支柱。
2. 先后侧、再前侧微动；从前端抬高、偏置进入，落到下座，再滑入可拆压条。路径坐标见 `insertion_checks.json`，不是把微动直接从上方硬压。
3. 装中键微动，再沿 18° 座面法线放入两个主键微动；使用原 M2 紧固组件。完整螺钉／工具插入路径未逐一证明，先留足工具空间。
4. 在壳外配合滚轮、编码器、载架与编码器小板，焊脚穿过通道；本次无电路板制造和焊接实测。**编码器小板与轮组一同从前端进入，M2×3 固定螺钉在轮组就位后由下方安装**，不要带着突出螺钉头一起穿过前方 USB 支柱。金属固定脚和端子与板的机械保持依赖实际 PCB／焊接，不可把空孔占位当成已固定。
5. USB 板和连接器从前端水平进入，落在两个支柱上，再装垫圈／M2×3。端口本身的位置沿用 R2。
6. 主键从上方稍向前放入，再后下落到铰链；外侧穿主键钢轴。侧键从左侧插入，再装上方捕获销。载架钢轴从右侧穿入。
7. 冷态检查五键、轮转、中键回位和轴向松动。按实购微动校准触点间隙和止挡，不能因模型可到 2.8°／4.1° 就强压实际开关到底。
8. 先完成机械试装再装电池和电子件；电子全安装顺序与支架尚未定型。贴五脚，实测共面与镜头到垫高度。

本轮机械装入为 18 阶段、930 个有限网格采样。它不包含手指、工具柄、全部紧固件插入、焊接与摩擦。对当前未选定主板，不宣称整体电子样机已经可以按图装成。

试握记录：夹持宽度、顶掌、无名指／小指拖地、指肚碰孔边、滚轮与侧键触达、抬鼠稳定。试按记录：卡滞、回弹、空行程、误触、侧键过早触底、六角松紧和滚轮轴向晃动。尺寸来源仍是近似手部测量，190 mm 张开跨度不是掌宽。
