Quietmirror/github/reports/rebuild_r2/INSTALLATION.md

# R2 机械装配与打印

这是装真实微动和编码器的机械样机。先用它确认握持、触达和机械配合，再根据实测 PCB 设计电子版。没有实物打印、点击力度或寿命测试；有限采样不代替手工试装。只打印 PRINT 包里的 STL / 3MF，硬件参考实体不打印。

## 打印件与辅料

| 项目 | 数量 | 本版接口 / 用途 |
|---|---:|---|
| BODY | 1 | 一体主壳、上方承力筋、五脚、固定安装座 |
| LEFT_KEY / RIGHT_KEY | 各 1 | 独立主键、铰链和作动凸台 |
| SIDE_FRONT_KEY / SIDE_REAR_KEY | 各 1 | 10 × 5 mm 触感面、滑动导向、机械止挡 |
| SIDE_FRONT_KEY_SWITCH_CLAMP / SIDE_REAR_KEY_SWITCH_CLAMP | 各 1 | 可拆微动压条，先装微动再装压条 |
| WHEEL / WHEEL_CARRIER | 各 1 | 滚轮和可下压载架 |
| Omron D2F 针柱式微动 | 5 | 左、右、中、两个侧键；以实购子型号的自由高度和 PT/OP/OT 校准 |
| Alps EC10E1220505 轮廓参考编码器 | 1 | 7 mm 安装高度参考；具体供货图和样品仍须核对 |
| M2 × 12 螺钉 | 10 | 参考圆头 Ø3.8 × 1.6 mm，螺纹未逐牙建模 |
| M2 螺母 | 10 | 参考对边 4 mm、厚 1.6 mm |
| M2 垫圈 | 20 | 参考外径 5、内径 2.2、厚 0.3 mm |
| Ø2 × 21.8 mm 钢轴 | 2 | 左右主键转轴 |
| Ø2 × 13.8 mm 钢轴 | 1 | 滚轮载架转轴 |
| Ø1.5 × 5.6 mm 钢销 | 2 | 两个侧键的捕获销 |
| 约 Ø7–7.5 mm 圆点脚贴 | 5 | 粘于 Ø8 mm 平台，厚度须进入传感器尺寸链 |

微动、编码器、轴销和螺钉的形状是采购包络。没有把通用硬件示意变成某个供应商的完整供货保证。不要把所有 CAD 零件一起切片。

## 打印朝向

采用 0.4 mm 喷嘴、0.20 mm 层高、4 壁、20% 填充的通用 PLA 配置。支持所有区域生成支撑，并非仅平台支撑。3MF 已嵌入配置，实际切片后回读核对；交付的不是可以直接发送给任意打印机的 G-code。

- BODY 五脚向下、Z=0 落床。壳内横筋、悬吊微动座、轴孔和曲面下方需要支撑，从开放底部及大窗口清理。
- 主键触感面向上，支撑曲面背面和铰链。不要把支撑残根留在作动点、轴孔或止挡面。
- 侧键按 `print/` 里的朝向打印，清理捕获销孔、导轨和背面的两个浅止挡凸台。两片压条平放。
- 滚轮轴竖直，圆轴端向下、小六角端向上，轮盘下面需要支撑。1.67 mm 对边的 PLA 六角是本版最需试配的小接口之一，不是长期扭转寿命保证。
- 载架按打印包中的朝向打印，清理轴承孔和编码器引脚通道。小件可增加合适的裙边/附着边，但必须在自己的打印机配置中重切。

名义间隙不等于打印机的实际间隙。Ø2 轴孔名义 2.35 mm、Ø1.5 捕获销孔名义 1.72 mm；实测后逐步铰孔。不要一次按名义补偿量扩大所有孔。若表面毛刺导致卡滞，先清理再改参数。

## 安装顺序

以下顺序来自 `insertion_checks.json` 中对实际网格的分步路径检查。每段采样 31 个位置；它没有穷尽所有连续位置，也没有模拟手指、钳子、螺丝刀柄或摩擦。螺钉、螺母和垫圈另有最终静态与工具通道检查，未宣称其每条完整装入路径均已求解。

1. 清理 BODY，先检查五脚是否共面、各座是否裂开、引脚槽是否通畅。所有主键、侧键、载架、压条和 USB 小板暂不装入。
2. **先后侧微动，再前侧微动。** 微动从前端开口进入，暂时向内侧偏置并抬高；到主键后方后降低，再移到侧键座，最后下落就位。不同微动的偏置量来自实际 CAD，完整毫米路径见 JSON。不能把最终位置的“无相交”理解为能从顶部直接压进封闭座。
3. 每枚侧微动就位后，将对应压条从前方向后滑入。它是可拆件。用两枚 M2 螺钉、每枚两片垫圈和一枚螺母固定，逐渐拧紧，避免压裂开关和 PLA。参考硬件没有求螺纹预紧力。
4. 中键微动从前端抬高 4 mm 进入，移到座上后再下降，使引脚穿过托架。两个主键微动沿倾斜安装座的法线放入，座相对水平倾斜 18°，再安装 M2 固定件。
5. 在壳外预装滚轮、编码器和载架。编码器的端子/金属脚穿过载架开口；连接小板或绝缘机械固定方式需要按实购件确认，当前未交付带电编码器板。将整组从前端、比最终位置高 0.4 mm 的路线滑入，再下降就位。载架钢轴从**右侧**穿入；左侧已装的压条会影响反方向的长轴插入。
6. 左右主键分别从上方、相对最终位置向前 3 mm 放入；降到比最终位置高 5 mm，再沿后下方向落入铰链。各自主轴从外侧穿入。该路径避免让主键铰链横穿已装微动。
7. 两个侧键从左侧外部插入，然后从上方穿入 Ø1.5 mm 捕获销。轴销端部可用少量可移除胶点防脱，胶只能留在轴端，不能进入轴承/导向。当前没有永久卡簧槽。
8. 先在不通电状态下检查五键、滚轮转动、中键回位和抬鼠稳定。主键角度范围 0–2.3°，中键载架 0–3.8°，侧键 0–0.60 mm 是模型检查范围，不是厂商的按键力度或真实可用行程承诺。
9. 核对实购微动的自由位置、动作位置及剩余超行程后，调作动高度、预压与止挡。模型中的 0.02–0.03 mm 初始间隙非常小，打印公差可能明显大于它；需要垫片/打磨/参数迭代，不能照尺寸强压到底。
10. 最后贴五脚。装电子元件、接电和调传感器高度属于下一阶段。

## 当前仍要实物确认的点

导向摩擦、螺钉拧紧后变形、五脚平面、微动预压、侧键止挡、编码器保持方式、六角配合、钢轴防脱及支撑可清理性都需要实际打印验证。USB-C 小板仅有机械包络、预留通道和两个安装孔；没有完整验证它的螺钉头/夹持结构或实际线缆固定，不能把它当作已完成的充电板安装方案。

试握记录至少包含：实际夹持宽度、顶掌、无名指/小指拖地、指肚碰孔边、主键前端触感、滚轮和两个侧键触达、抬鼠稳定。试按另记录卡滞、回位、误触、轮轴晃动、侧键是否过早触底。没有掌宽和指节数据，不用 190 mm 张开跨度替代握宽，也不按 230 mm 手长整体缩放。
