Quietmirror/github/reports/v09/ASSEMBLY.md

# V0.9 可按、可滚动的试握套件

这是供打印、装配和调校的机械样机设计。五个输入位置都有独立活动件、导向、挡片和开关托架；轮体可绕轴转动，整个滚轮架可下压。**未进行实物打印、装配或手感测试。** CAD 行程验证不能代替打印公差、摩擦、开关预压和寿命验证。

## 这次怎样获得点击和回位

默认方案是打印结构件，另装五枚 **6 × 6 × 5 mm 的轻触开关**，用开关本身的弹性机构提供点击及回位。它们不需要通电就可以试按。示例外形采用 ALPS SKHHAKA010 的公开外廓尺寸；厂家标称行程 0.25 mm、操作力 0.98 N。该开关用于本轮机械试验，不能据此推定 ATK A1 Plus 的开关类型，也不代表最终电竞鼠标的点击力度。[厂家外形及规格](https://tech.alpsalpine.com/e/products/detail/SKHHAKA010/)

仅打印塑料件，可以检查装配、活动范围和轮体转动；**五个键的明确点击与自动回位需要装入开关**。可选的打印棘齿弹片只用于滚轮段落感，不会生成滚动信号。正式电气版需要编码器、对应轴端和主板固件。

## 零件与辅料

| 类别 | 数量 | 用途 |
|---|---:|---|
| BODY | 1 | 底部与外壳、固定导向和托架安装柱 |
| left_KEY / right_KEY | 各 1 | 23 × 27 mm 的连续曲面触感面及内侧柱塞 |
| thumb_front_KEY / thumb_rear_KEY | 各 1 | 沿侧壳曲面的细长双键；组合带长 26.6 mm、高 4.8 mm、中央间隔 1.4 mm |
| WHEEL_CARRIER | 1 | 滚轮支架和中键柱塞 |
| WHEEL / AXLE / AXLE_WASHER | 各 1 | 轮体、打印轴及轴端垫片 |
| DETENT_LEAF | 1，可选 | 可拆换滚轮弹片；拆下后为顺滑转动试验 |
| 五组 RETAINER / TRAY | 各 5 | 柱塞挡片和轻触开关托架；有两种挡片宽度 |
| 6 × 6 × 5 mm 轻触开关 | 5，另备 | 左、右、中、前侧、后侧五个输入位置 |
| M2 × 6 小螺钉 | 10，另备 | 每个开关托架两枚；1.7 mm 塑料导孔，需试拧确认 |
| M2 × 5 沉头小螺钉 | 5，另备 | 五枚挡片；头部必须与压触面齐平或略低 |
| M2 × 5 轴端螺钉 | 1，另备 | 配合 AXLE_WASHER 保留轴端，不可拧紧夹死支架 |
| M2 × 4 小螺钉 | 1，另备 | 安装可选滚轮弹片 |
| 薄片、细砂纸、小钻头 | 适量 | 打印间隙、开关高度和限位调校；不靠强压磨合 |

打印目录中的每个 STL 各打一件即为 20 个塑料件。开关图形、电子包络和装配 STEP 中的硬件示意不是打印零件。主板的孔位没有借用这些 M2 安装孔。

## 先打印校准件

`exports/v09/calibration/` 提供一块校准板、一根柱塞样件和一根轴样件。校准板的左、中、右矩形孔分别对应 **单边 0.2 / 0.3 / 0.4 mm** 间隙；三圆孔直径分别是 **3.2 / 3.4 / 3.6 mm**，与 3 mm 轴样件配合。中间一排小孔（Y=3 mm）从左到右为 **1.6 / 1.7 / 1.8 mm** 螺钉导孔，用于先试拧实际 M2 螺钉，避免直接损坏壳内安装柱。

装配件默认单边滑动间隙 0.3 mm，轮孔 3.5 mm，支架轴孔 3.4 mm。它们是打印初值，不是某台打印机已验证的配合等级。柱塞应当能靠开关回位，不能靠手强推。如果明显卡滞，先清除支撑、象脚及毛边，再调间隙参数重新导出；如果晃动过大，再根据校准结果减小间隙。

## 装配次序

1. 清理 BODY 的导孔和开关托架安装面。确认五个脚贴台仍处于同一平面；导孔内不能残留支撑。
2. 在壳外预装滚轮组：将轮体放入 WHEEL_CARRIER 两耳之间，穿入 AXLE，在轴端装垫片和螺钉并保留轴向游隙。可选弹片先保持默认无预压位置。整个预装组先从上方装入 BODY。
3. 依次从上方装入左主键、右主键，再从左外侧装入前侧键、后侧键。此顺序已按 31 个位置/路径与前面已经装好的零件一起检查；不要先装挡片和开关托架。侧键不是从上方硬压进去。
4. 利用开放底部，从内侧装五个 RETAINER，用沉头螺钉固定在活动柱塞上；它们随键帽/滚轮架运动，不要把挡片锁在壳体上。螺钉头必须齐平或略低。
5. 本版 DETENT_LEAF 在齿峰连续外包络以外留 0.05 mm 名义间隙，默认状态无几何穿插。打印误差可能吃掉这个间隙；先不装弹片检查完整一圈，再单独调弹片固定位置/弯曲预压，使其轻触齿峰。默认文件不保证有段落感；需要段落试验时必须实物调校，不能把卡死当成段落感。弹片随滚轮支架下压，不作为最终编码器。
6. 将五枚轻触开关放入各自 TRAY，端子穿过底部让位槽；把托架从内侧装上，每个托架用两枚 M2 × 6 螺钉连接固定柱。端子槽是机械让位，不能作为 PCB 钻孔模板。
7. 逐键调整开关高度与按键限位，再装脚贴。最后复核任意一个键按下时不会带动相邻键，滚轮转动不会触发中键，中键释放后轮体不会持续刮壳。

## 必须区分空行程和开关行程

CAD 的 **0.4 mm 是塑料结构的最大空行程**，并非许可轻触开关压入 0.4 mm。示例开关标称行程只有 0.25 mm，打印层纹、收缩和开关高度误差还会改变触发点。

每一组都先不装开关，检查柱塞可顺滑移动；再装开关，轻按找到实际触发点。用薄片调整开关托架高度、键帽肩部与导向上沿的限位间隙，或在参数中改小 `mechanism.travel`。目标是静止不预压、松手可靠释放，按到实际触发点后很快由塑料限位承担额外指力。不要把开关内部止挡当作整只鼠标的承力止挡。此调校尚未在实物上验证。

## 打印摆放及材料

优先使用 `quietmirror_V0.9_PRINT_PLATE.3mf`，或分别导入 `print/` 的 STL；这些文件已经按打印朝向变换。`placed/`、`MECHANICAL_VIEW_ONLY.3mf` 和电子示意 3MF 保留装配位置，不能当打印托盘使用。

- BODY：五脚朝下。导向顶面、横向支撑和曲面下方需要支撑；本版切片允许支撑从模型上生成。打印后从开放底面清理。
- 主键：柱塞朝下、触感面朝上，使用键帽底部支撑，避免在指肚接触面堆支撑痕。
- 侧键、挡片、托架：按提供的平放方向打印；托架开口朝上，挡片沉头窝朝上。
- WHEEL：侧面平放，轴孔垂直。AXLE：大端在下。必要时轻修孔，避免挤压薄轴。
- DETENT_LEAF：按提供方向单独打印，建议用 0.1 mm 层高先试。弹性段名义厚 0.8 mm，是可替换弹性件的有意薄壁例外；全套 PLA 切片仅供用料估算，不证明 PLA 弹片的寿命。可以先不装弹片试滚轮。

小零件另有薄壁例外：AXLE 末端 1.7 mm 导孔旁的名义径向壁厚为 **0.65 mm**，轴端垫片孔边为 **0.8 mm**，挡片沉头窝附近的最小名义余厚约 **0.55 mm**。这些不属于普通 1.6 mm 壳面；0.4 mm 喷嘴下应先单独打印实际轮轴、挡片和垫片，试拧并检查层间开裂。校准孔合适不代表这些薄件已通过强度验证，螺钉配合与反复拆装寿命尚未实测。

底部、导向和受力筋是这一阶段的承力结构，不建议根据总体克重直接全局缩放或减薄。手部 230 / 190 mm 仍只是原始近似数据；没有据此伪造掌宽或按手长等比放大鼠标。

## 实物反馈记录

记录握宽、主键接触面是否过小、指腹是否碰孔边、是否顶掌、无名指和小指是否拖地、两个侧键是否误触、滚轮触达、中键下压时手指是否滑动、抬鼠稳定性。另记录每个键的卡滞、回位、空行程、左右摇摆，滚轮轴向晃动、持续刮擦与弹片段落是否过重。

机械手感通过后，再围绕真实 PCB、开关、编码器、接收器和电池建立电子装配版。400–6400 DPI、1 kHz、宏、LOD、无可选 Sync 增强、低延迟无线、充电和至少 12 小时续航仍是电子系统验收目标，不能由这些打印件证明。

## V0.9 电子示意与机械试按套件的区别

两个电子场景都保留 9 个塑料外形/活动件及 5 个开关位置示例，移除了五组 TRAY、五组 RETAINER 和 DETENT_LEAF，共 11 个机械试验专用件。这些空间将由最终 PCB、开关支撑和编码器连接结构取代；本轮没有设计其正式安装件。**不要把电子场景的删件配置当作可以直接组装的成品。** 20 件完整机械试按套件仍单独交付。

侧键随侧壳曲面成形，整体外凸名义 0.35 mm，边缘 R0.3 mm；主键名义 23×27 mm，主键从外壳母曲面直接分割，前端框架上沿退至 Z=7.6 mm。尺寸、电子包络、打印间隙仍是试验初值。

V0.9侧键托架采用两处下方螺钉耳，螺钉数量不变；不要按旧版上、下各一孔的位置装托架。主键外侧支撑下降2 mm，滚轮轴Z13.0 mm、下横梁D26.9 mm、前后长4.2 mm。
