Quietmirror/github/reports/rebuild_r2/slicer_model_info.txt

Loading MESA OpenGL library: D:\Projects\Quietmirror\_support\tools\PrusaSlicer\PrusaSlicer-2.9.6\mesa\opengl32.dll
MESA OpenGL library was loaded sucessfully
[FENRIR_MINISE_R2_PLA_PRINT_PLATE.3mf]
size_x = 66.094757
size_y = 88.236000
size_z = 30.563663
min_x = -33.047379
min_y = -44.118000
min_z = -15.281832
max_x = 33.047379
max_y = 44.118000
max_z = 15.281832
number_of_facets = 121294
manifold = yes
number_of_parts =  1
volume = 13320.844727
[FENRIR_MINISE_R2_PLA_PRINT_PLATE.3mf]
size_x = 22.699997
size_y = 40.465019
size_z = 15.519611
min_x = -11.349998
min_y = -20.232510
min_z = -7.759806
max_x = 11.349998
max_y = 20.232510
max_z = 7.759806
number_of_facets = 4444
manifold = yes
number_of_parts =  1
volume = 1779.369873
[FENRIR_MINISE_R2_PLA_PRINT_PLATE.3mf]
size_x = 22.699997
size_y = 40.465019
size_z = 15.519611
min_x = -11.349998
min_y = -20.232510
min_z = -7.759806
max_x = 11.349998
max_y = 20.232510
max_z = 7.759806
number_of_facets = 5564
manifold = yes
number_of_parts =  1
volume = 1779.066772
[FENRIR_MINISE_R2_PLA_PRINT_PLATE.3mf]
size_x = 7.900009
size_y = 10.000000
size_z = 5.000000
min_x = -3.950005
min_y = -5.000000
min_z = -2.500000
max_x = 3.950005
max_y = 5.000000
max_z = 2.500000
number_of_facets = 7092
manifold = yes
number_of_parts =  1
volume = 194.176422
[FENRIR_MINISE_R2_PLA_PRINT_PLATE.3mf]
size_x = 9.000000
size_y = 14.400002
size_z = 1.599998
min_x = -4.500000
min_y = -7.200001
min_z = -0.799999
max_x = 4.500000
max_y = 7.200001
max_z = 0.799999
number_of_facets = 860
manifold = yes
number_of_parts =  1
volume = 192.892120
[FENRIR_MINISE_R2_PLA_PRINT_PLATE.3mf]
size_x = 7.899994
size_y = 10.000000
size_z = 5.000000
min_x = -3.949997
min_y = -5.000000
min_z = -2.500000
max_x = 3.949997
max_y = 5.000000
max_z = 2.500000
number_of_facets = 7092
manifold = yes
number_of_parts =  1
volume = 194.176208
[FENRIR_MINISE_R2_PLA_PRINT_PLATE.3mf]
size_x = 9.000000
size_y = 14.400002
size_z = 1.599998
min_x = -4.500000
min_y = -7.200001
min_z = -0.799999
max_x = 4.500000
max_y = 7.200001
max_z = 0.799999
number_of_facets = 860
manifold = yes
number_of_parts =  1
volume = 192.892151
[FENRIR_MINISE_R2_PLA_PRINT_PLATE.3mf]
size_x = 12.497200
size_y = 12.498604
size_z = 16.100000
min_x = -6.248600
min_y = -6.249302
min_z = -8.050000
max_x = 6.248600
max_y = 6.249302
max_z = 8.050000
number_of_facets = 860
manifold = yes
number_of_parts =  1
volume = 823.276428
[FENRIR_MINISE_R2_PLA_PRINT_PLATE.3mf]
size_x = 16.299797
size_y = 32.599510
size_z = 11.399687
min_x = -8.149899
min_y = -16.299755
min_z = -5.699843
max_x = 8.149899
max_y = 16.299755
max_z = 5.699843
number_of_facets = 9152
manifold = yes
number_of_parts =  1
volume = 551.424500
