Quietmirror/github/slicing/V0.5_PRINTING.md

# V0.5 打印说明

推荐 [FIT STL](../exports/v05/quietmirror_fingertip_V0.5_FIT.stl) 或 [3MF](../exports/v05/quietmirror_fingertip_V0.5_PRINT.3mf)。实际切片器尺寸 61.987×90.002×28.003 mm、一个连通部件；100%比例、按毫米导入。独立键帽已按内侧限位边贴床摆正。

五个脚贴面朝下、Z=0。0.4 mm 喷嘴、0.2 mm 层高、4周壁、20% gyroid、5层顶底、PLA 1.24 g/cm³。210°C 喷嘴/60°C 热床是估算值，按实际打印机和材料配置调整。

使用 **贴合支撑 snug，仅从热床生成**，45°阈值、Z间隙0.2、XY间隙0.35、3层支撑界面、4 mm 裙边。初始有机树状支撑出现分支生成警告，最终改用此配置并重新验证。内部顶壳、轮轴和斜撑、固定侧键限位边等需要支撑，从开放底部去除。细筋和底筋是永久结构，不要当作支撑剪掉。[实际刀路图](../views/v05/09_slice_layers.png)

| 文件 | 本体 g | 支撑 g | 裙边 g | 总耗材 g | 时间 |
|---|---:|---:|---:|---:|---|
| FIT | 22.190 | 15.198 | 0.173 | 37.56 | 4h 12m 7s |
| SHELL | 21.012 | 14.810 | 0.173 | 36.00 | 3h 59m 38s |
| front side cap | 0.579 | 0.000 | 0.043 | 0.62 | 8m 20s |
| rear side cap | 0.579 | 0.000 | 0.043 | 0.62 | 8m 20s |

以上分件各自独立切片，不能直接作为同板打印的联合估时。模型 140 层；含支撑中间层共 153 个挤出 Z 高度。PrusaSlicer 2.9.6。最终 3MF 不另加载 INI 重切片为 37.57 g /4h 12m 3s，16项设置一致，与 STL+INI 差 0.01 g /-4 秒。

3MF是通用估算配置。打开后选择实际打印机、喷嘴、热床范围和起止代码，再生成机用文件。仓库不提供可直接给未知机型执行的 G-code。

主键和滚轮固定，不要掰动；FIT侧键连接桥局部 1.2 mm，不是可反复弯折的铰链。清理 R1 孔口毛刺及下缘过渡，避免磨低五个脚贴基面。贴五个同厚 Ø7–7.5 mm 圆点脚贴后，放在平板检查晃动。独立键帽从底部送入再向外就位，临时用可移除胶带在内侧防掉；当前无回弹或真实开关机构。

没有实物打印、称重、变形或强度试验。[试握反馈表](../reports/v05/FIT_FEEDBACK.md) · [精简 INI](V0.5_PLA_0.4_0.20_ESTIMATE.ini) · [完整 INI](V0.5_PLA_0.4_0.20_FULL.ini) · [切片记录](../reports/v05/slice_summary.json) · [3MF 重切片](../reports/v05/3mf_roundtrip.json)
