Quietmirror/github/slicing/V0.2_PRINTING.md

# V0.2 打印与切片复现

使用PrusaSlicer2.9.6。推荐下载[3MF](../exports/v02/quietmirror_fingertip_V0.2_PRINT.3mf)，作为项目打开；选择自己的打印机配置后再切片。当前3MF是220×220平台、0.4 mm喷嘴的通用估算，不能保证与具体机器兼容。单位millimeter，缩放100%，五个脚贴安装面朝下，模型居中。

设置：PLA，丝径1.75，密度1.24 g/cm³；层高0.2；4道周壁；20%gyroid；5层顶底；普通线宽0.45。外壁25、周壁40、支撑35 mm/s。估算温度210/60°C。树状支撑只从热床生成，阈值45°，接触Z距离0.2、XY间距0.35、3层界面，外裙边4 mm。

支撑重点在内顶壳、固定滚轮/轴、侧键凸台和右侧托边下方。底部留空用于拆支撑。Ø2.8斜筋与2.6底框是本体，不要剪断。模型没有可动零件，勿掰动主键或滚轮。接触面和脚贴粘贴面只轻修毛刺，保留五脚同高。

| 估计项目 | STL + INI | 最终3MF直接重切片 |
|---|---|---|
| 总用料 | 44.41 g | 44.63 g |
| 时间 | 5h18m06s | 5h20m19s |
| 本体/支撑/裙边 | 25.851 / 18.383 / 0.173 g | 以3MF重切片总量为准 |
| 关键配置比对 | 基准 | 16项一致 |

0.22 g与133秒差异按实际输出保留；它们是估计，不是实物重量。[切片JSON](../reports/v02/slice_summary.json)、[3MF复测JSON](../reports/v02/3mf_roundtrip.json)、[刀路截面](../views/v02/09_slice_layers.png)。

在项目根目录运行，替换本机切片器路径：

```powershell
$prusa = 'C:\YOUR_PRUSA_SLICER\prusa-slicer-console.exe'
New-Item -ItemType Directory -Force .tools | Out-Null
& $prusa --info exports\v02\quietmirror_fingertip_V0.2.stl
& $prusa --load slicing\V0.2_PLA_0.4_0.20_ESTIMATE.ini --export-gcode --output .tools\V0.2_estimate_with_support.gcode exports\v02\quietmirror_fingertip_V0.2.stl
& $prusa --load slicing\V0.2_PLA_0.4_0.20_ESTIMATE.ini --save slicing\V0.2_PLA_0.4_0.20_FULL.ini
& $prusa --load slicing\V0.2_PLA_0.4_0.20_ESTIMATE.ini --center 110,110 --export-3mf --output exports\v02\quietmirror_fingertip_V0.2_PRINT.3mf exports\v02\quietmirror_fingertip_V0.2.stl
.\.venv\Scripts\python.exe cad\embed_3mf_profile.py --version 0.2
& $prusa --export-gcode --output .tools\V0.2_3mf_roundtrip.gcode exports\v02\quietmirror_fingertip_V0.2_PRINT.3mf
.\.venv\Scripts\python.exe cad\check_3mf_roundtrip.py --version 0.2
.\.venv\Scripts\python.exe cad\analyze_slice.py --version 0.2
```

3MF配置使用PrusaSlicer的`Metadata/Slic3r_PE.config`格式；[官方实现](https://github.com/prusa3d/PrusaSlicer/blob/version_2.9.6/src/libslic3r/Format/3mf.cpp)。原始通用G-code只保留在本机估算目录，没有上传为可直接生产的机器文件。
