Quietmirror/github/reports/v06/ASSEMBLY_CHECKS.md

# V0.6 · 装配检查结论

检查对象是模型内估计体，不是实际 ATK /PAW3950 板。模型尺寸表在 [电子参数 JSON](../../cad/electronics_v06.json)。

## ATK_A1_PLUS

独立电子示意体 23 件；壳体/侧键显著体积干涉 0 项；非预期组件干涉 0 项。阈值 0.01 mm³；小于此阈值不代表有生产装配公差。

天线估计净空与壳体相交 0.0000 mm³；与电子件相交：无。这不是射频实测。

允许接口：滚轮与轴、编码器与轴、电源开关滑块与本体、电池引线端点与电池。模型使用实体包络表示这些接口，仍须设计真实孔和接触面。电池服务净空包括电池、光学净空包括镜头、主键行程净空可能接近固定试握面，这些关系不能当作互不相交的独立物体。

## PAW3950_CUSTOM

独立电子示意体 25 件；壳体/侧键显著体积干涉 0 项；非预期组件干涉 0 项。阈值 0.01 mm³；小于此阈值不代表有生产装配公差。

天线估计净空与壳体相交 0.0000 mm³；与电子件相交：无。这不是射频实测。

允许接口：滚轮与轴、编码器与轴、电源开关滑块与本体、电池引线端点与电池。模型使用实体包络表示这些接口，仍须设计真实孔和接触面。电池服务净空包括电池、光学净空包括镜头、主键行程净空可能接近固定试握面，这些关系不能当作互不相交的独立物体。

## 为解决已发现干涉所做的布局调整

滚轮轴从 V0.5 的 Z17.5 降为 Z16.3 mm，固定试握件和两种电子示意同步调整。编码器改为 **4×6×7 mm 的可用空间目标**，尚未选到或验证真实编码器；若供体编码器更大，应改变滚轮/板/壳体布局。两主键开关沿 Y 向前 2 mm 以避开侧键板；充电区向内移动；供体 MCU 区域与天线区域分开；自定义板之间留出层间/平面间距。

下一轮仍需解决：真实板边界与孔位、安装托架、螺柱、上下盖闭合、主键弹性与行程、滚轮轴承/编码器支撑、侧键回位、USB 固定、线束固定和插拔路径。原板不能搬动的零件可能使这套布局不可行，需要改布局或壳体尺寸。

本轮没有完成连续装入路径、跌落/夹持强度、电池温升、固件、宏、RF/延迟或12小时续航测试。详见 [完整电子方案](ELECTRONICS.md)。
