Quietmirror/github/slicing/V0.4_PRINTING.md

# V0.4 打印说明

首轮推荐 [FIT一体STL](../exports/v04/quietmirror_fingertip_V0.4_FIT.stl) 或 [3MF项目](../exports/v04/quietmirror_fingertip_V0.4_PRINT.3mf)。模型按毫米、100%比例。切片器实际尺寸61.987×90.002×28.002，识别一个连通部分。

## 方向与配置

五个脚贴粘贴面朝下、Z=0；不要把外壳侧面贴床。0.4 mm喷嘴、0.20 mm层高、4周壁、20% gyroid、5层顶底；PLA密度1.24 g/cm³。210°C喷嘴/60°C热床只是当前估算配置值，按实际耗材和打印机调整。内侧限位边朝下的两个键帽已摆好方向。

有机支撑仅从热床生成、45°阈值，Z间隙0.2、XY间隙0.35、3层支撑界面、4 mm外裙边。需要支撑的位置包括内顶壳、固定轮轴/斜撑、侧键内限位边和低托边；切片器按实际模型生成支撑，见[刀路截面](../views/v04/09_slice_layers.png)。

3MF内含通用估算配置，不是某台打印机的生产配置。打开后选择自己的机型和喷嘴，检查热床范围、起止G-code和支撑，再生成实际机用文件。仓库不发布未知机型可直接执行的G-code。

## 实际切片估算

| 文件 | 本体 g | 支撑 g | 裙边 g | 总耗材 g | 时间 |
|---|---:|---:|---:|---:|---|
| FIT | 23.345 | 14.934 | 0.173 | 38.45 | 4h 50m 41s |
| SHELL | 22.168 | 14.994 | 0.173 | 37.34 | 4h 41m 34s |
| front side cap | 0.579 | 0.290 | 0.043 | 0.91 | 10m 38s |
| rear side cap | 0.579 | 0.290 | 0.043 | 0.91 | 10m 38s |

PrusaSlicer 2.9.6，140层。上表各分件独立切片，不等于全部零件放在同一热床的联合估时。最终3MF重切片：38.43 g /4h 51m 27s；与STL+INI估算差-0.02 g、46秒。没有实物称重。

## 去支撑与验收

从开放底部去除支撑，先区分有机支撑和永久底筋。勿剪五脚连接筋、传感器框或轮架根部；主键和滚轮不能掰动。清理后壳孔口、键面窄缝和底边过渡毛刺，避免打磨五个粘贴基面导致不共面。

侧键窗口和内限位边可能需轻修。独立键帽由底部进入内腔后向外就位，内侧可移除胶带临时防掉；不存在已验证的回弹机构。FIT局部固定桥1.2 mm，不要把它当可反复弯折的活铰链。

贴五个同批同厚Ø7–7.5 mm圆点脚贴后放平板检查晃动，再填写[试握反馈表](../reports/v04/FIT_FEEDBACK.md)。本件仅测试外形、触达和抬鼠稳定性，不用于评价点击力、回弹、滚轮阻尼、无线延迟或电子件重心。

配置：[精简INI](V0.4_PLA_0.4_0.20_ESTIMATE.ini) /[完整INI](V0.4_PLA_0.4_0.20_FULL.ini)；数据：[切片报告](../reports/v04/slice_summary.json) /[分件报告](../reports/v04/separate_parts_slice.json) /[3MF核对](../reports/v04/3mf_roundtrip.json)。
