Quietmirror/github/views/l2_revision/F1H/PRINT_PLATE.png

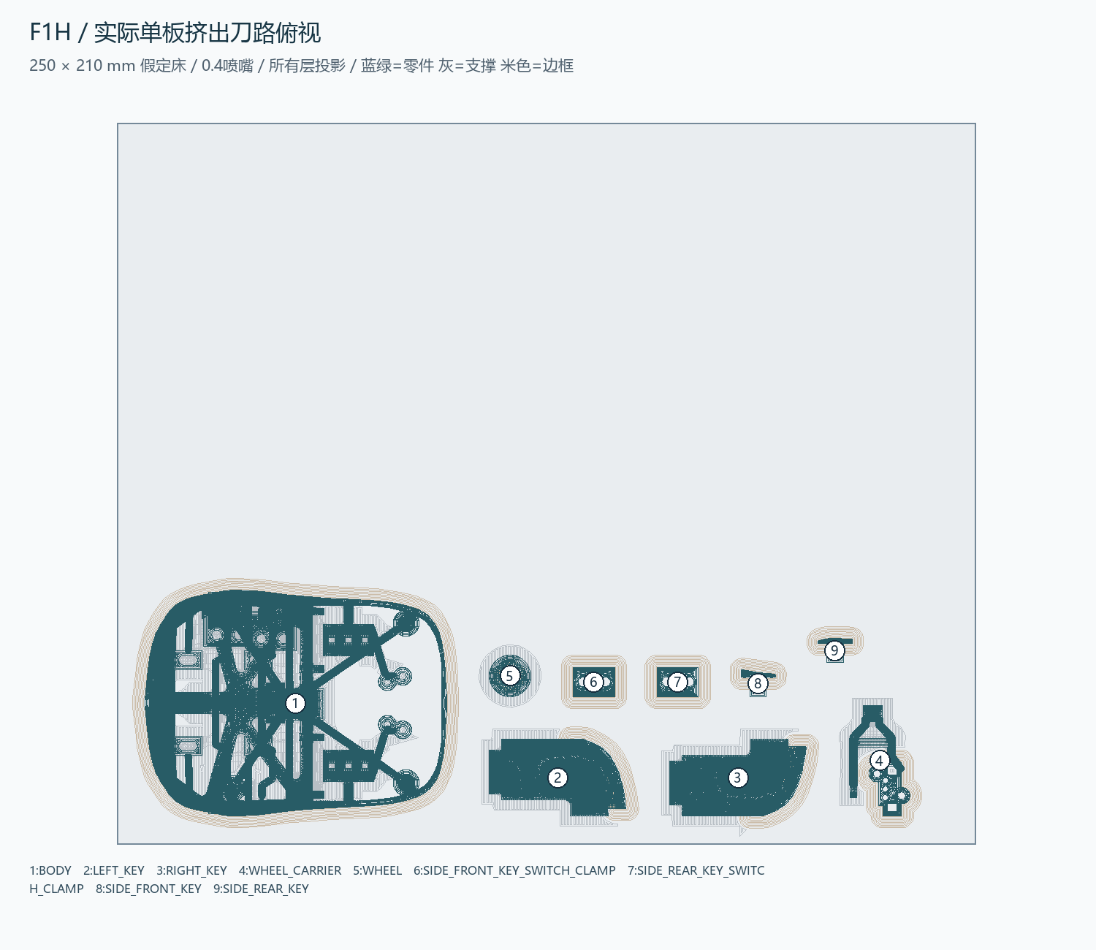
views/l2_revision/F1H/PRINT_PLATE.png
