Quietmirror/github/views/l2_revision/L2_D_EST/PRINT_PLATE.png

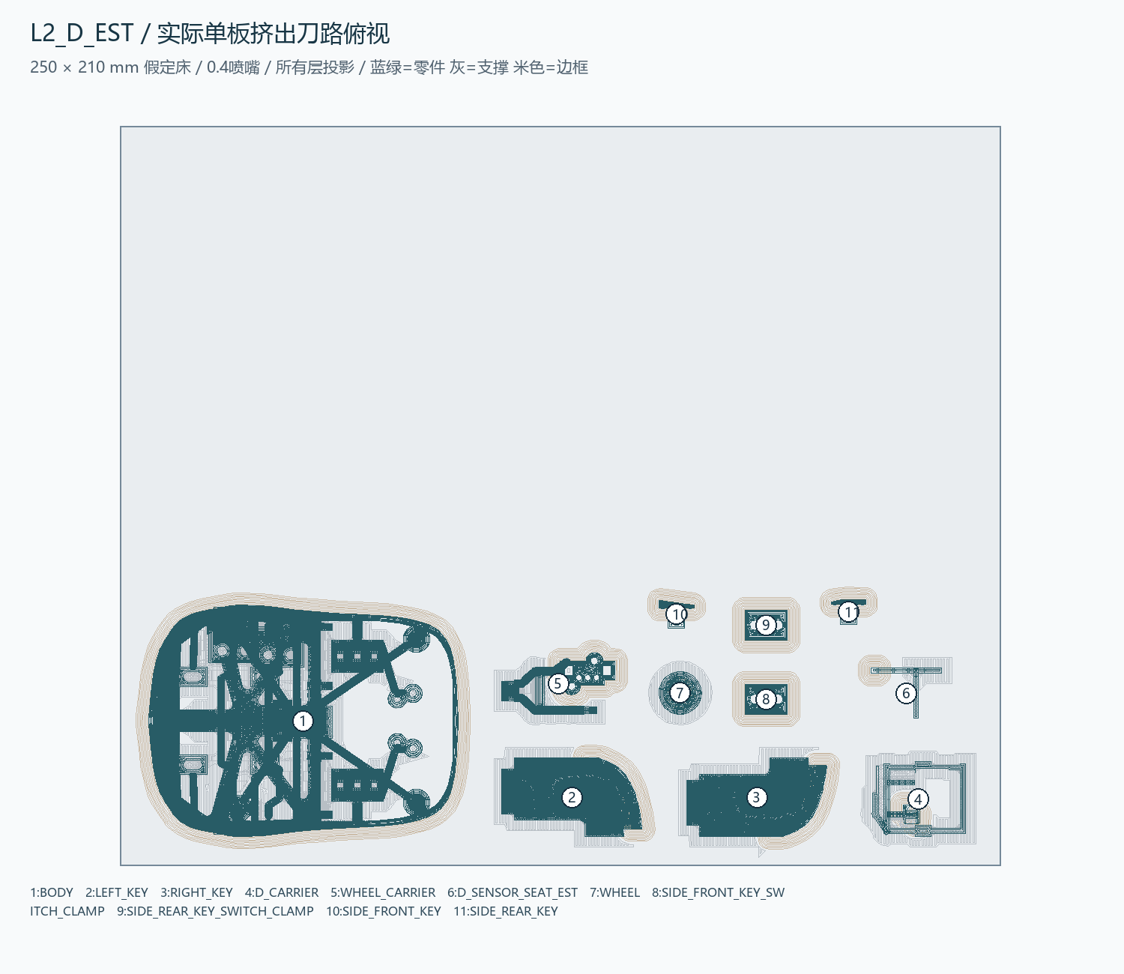
views/l2_revision/L2_D_EST/PRINT_PLATE.png
