Quietmirror/github/views/rebuild_r2/02_top.png

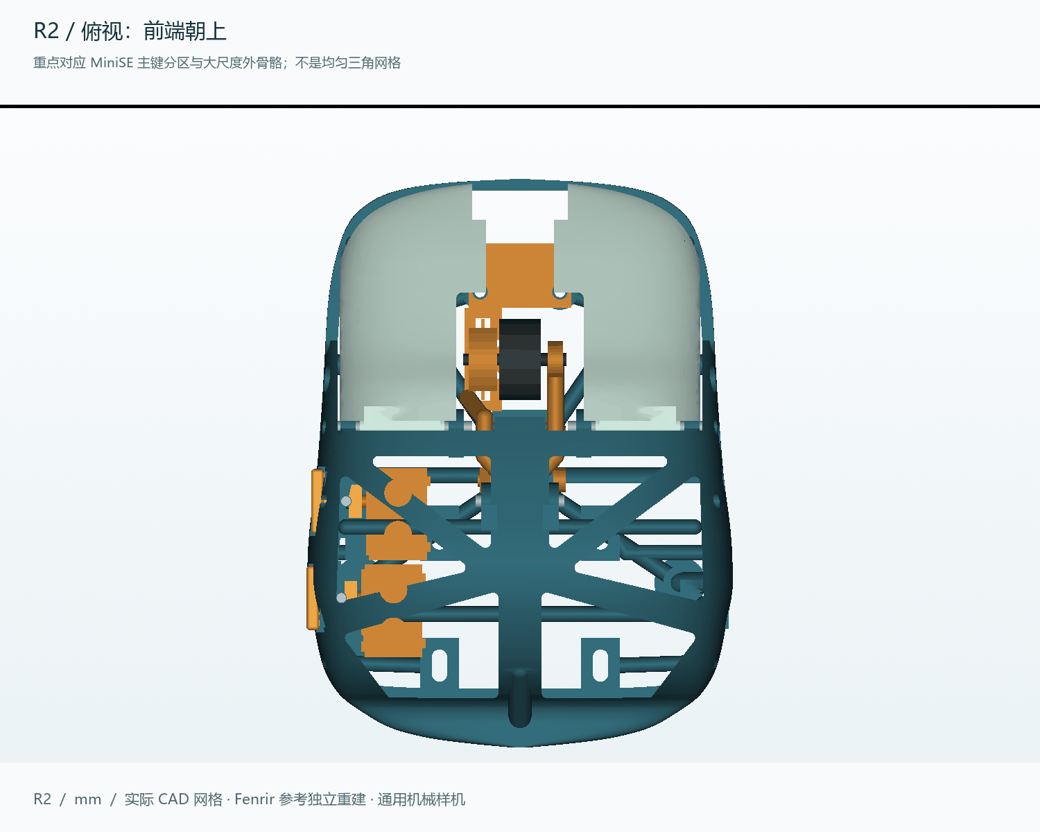
views/rebuild_r2/02_top.png
