Quietmirror/github/views/rebuild_r2/03_left_side.png

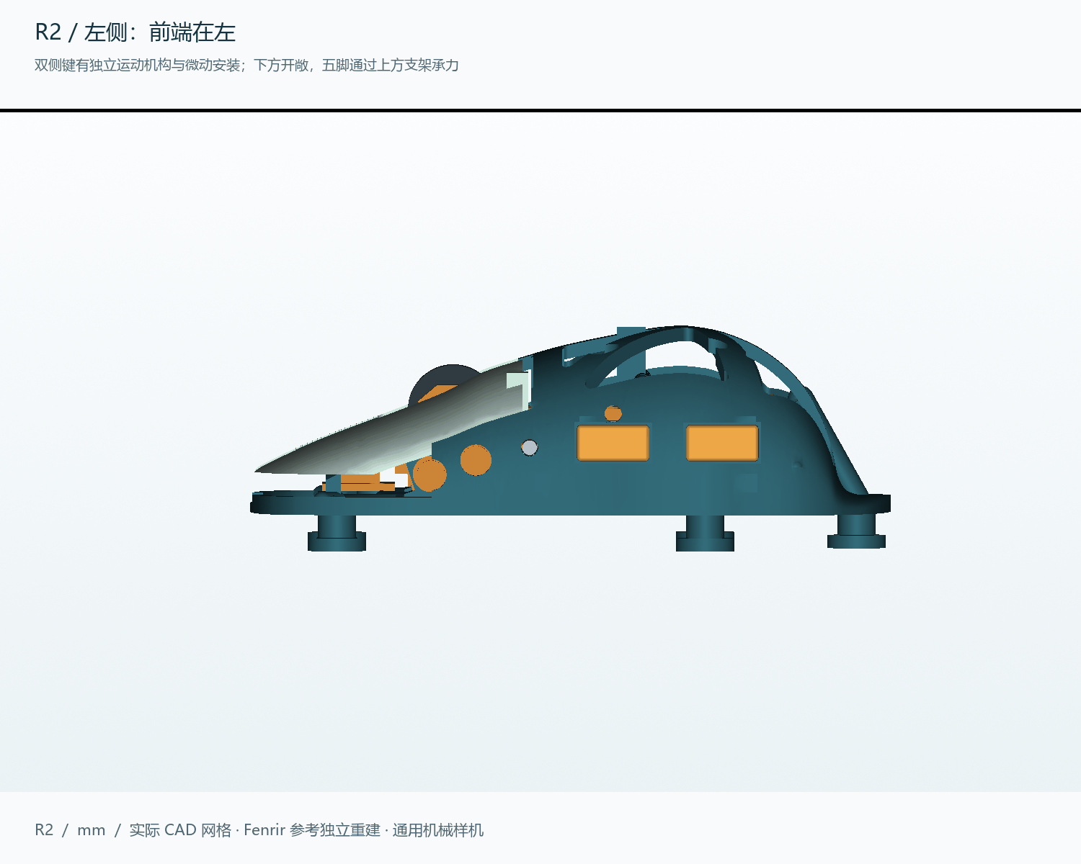
views/rebuild_r2/03_left_side.png
