Quietmirror/github/views/rebuild_r2/04_bottom.png

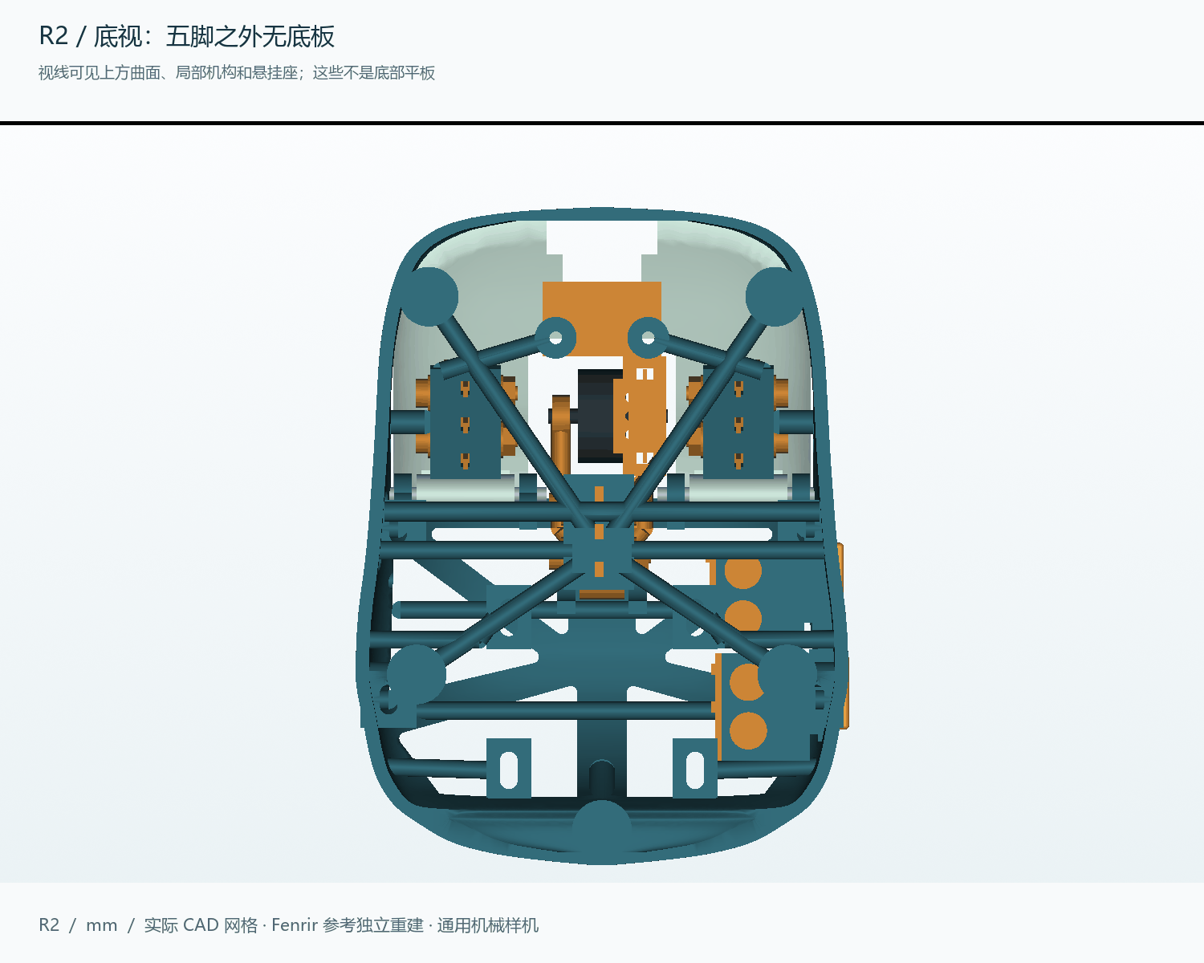
views/rebuild_r2/04_bottom.png
