Quietmirror/github/views/rebuild_r2/05_five_feet_band.png

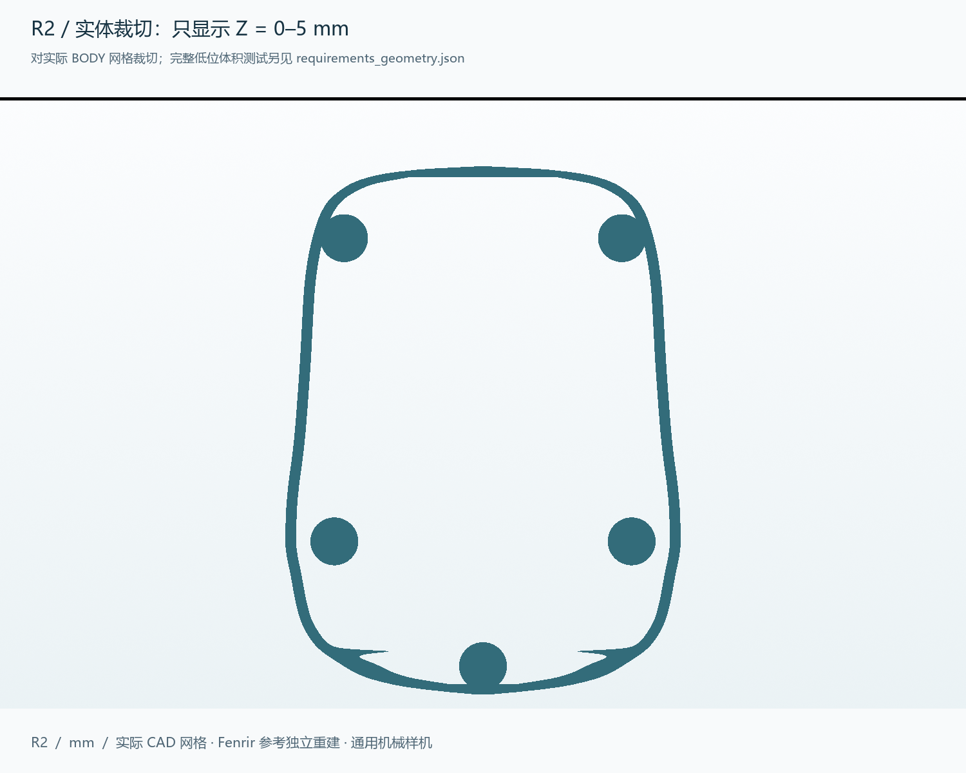
views/rebuild_r2/05_five_feet_band.png
