Quietmirror/github/views/rebuild_r2/06_exploded.png

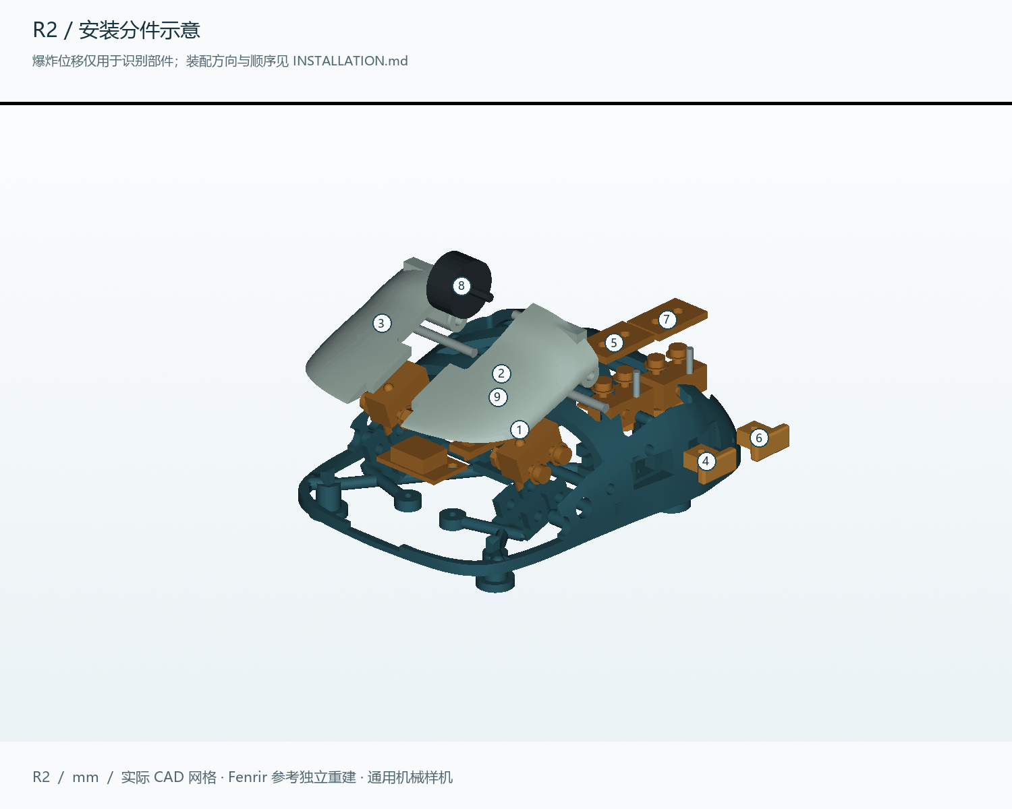
views/rebuild_r2/06_exploded.png
