Quietmirror/github/views/rebuild_r3_2/03_side.png

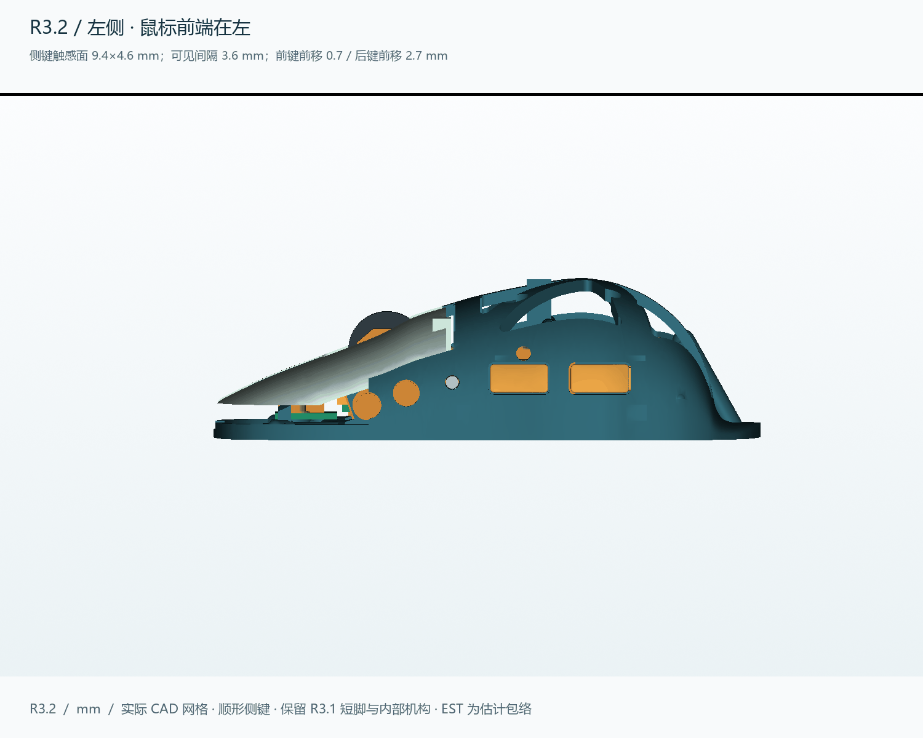
views/rebuild_r3_2/03_side.png
