Quietmirror/github/views/rebuild_r3_2/06_atk_blocked.png

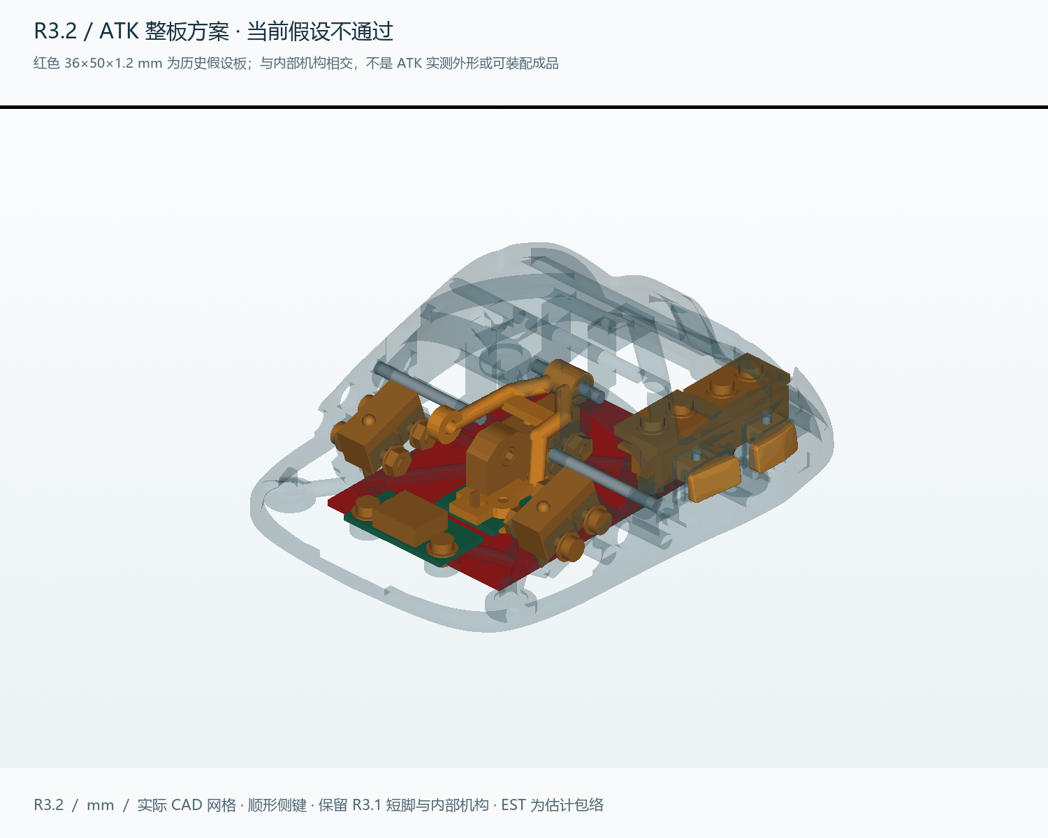
views/rebuild_r3_2/06_atk_blocked.png
