Quietmirror/github/views/rebuild_r3_2/07_encoder_mount.png

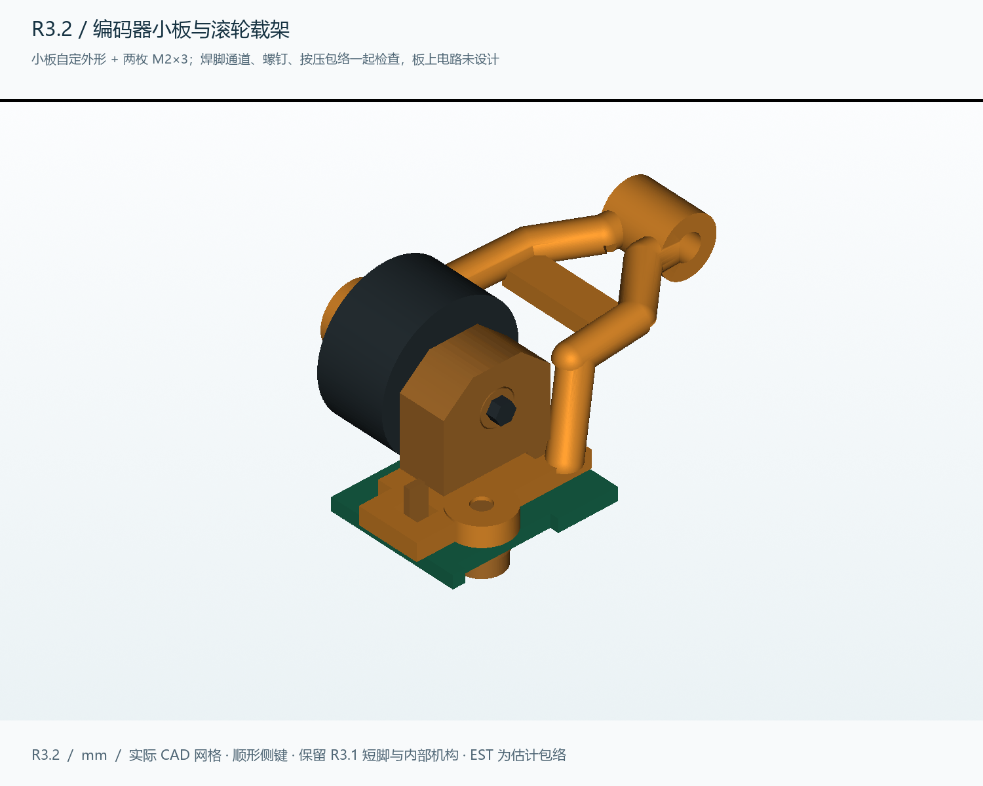
views/rebuild_r3_2/07_encoder_mount.png
