Quietmirror/github/views/rebuild_r3_2/08_internal_top.png

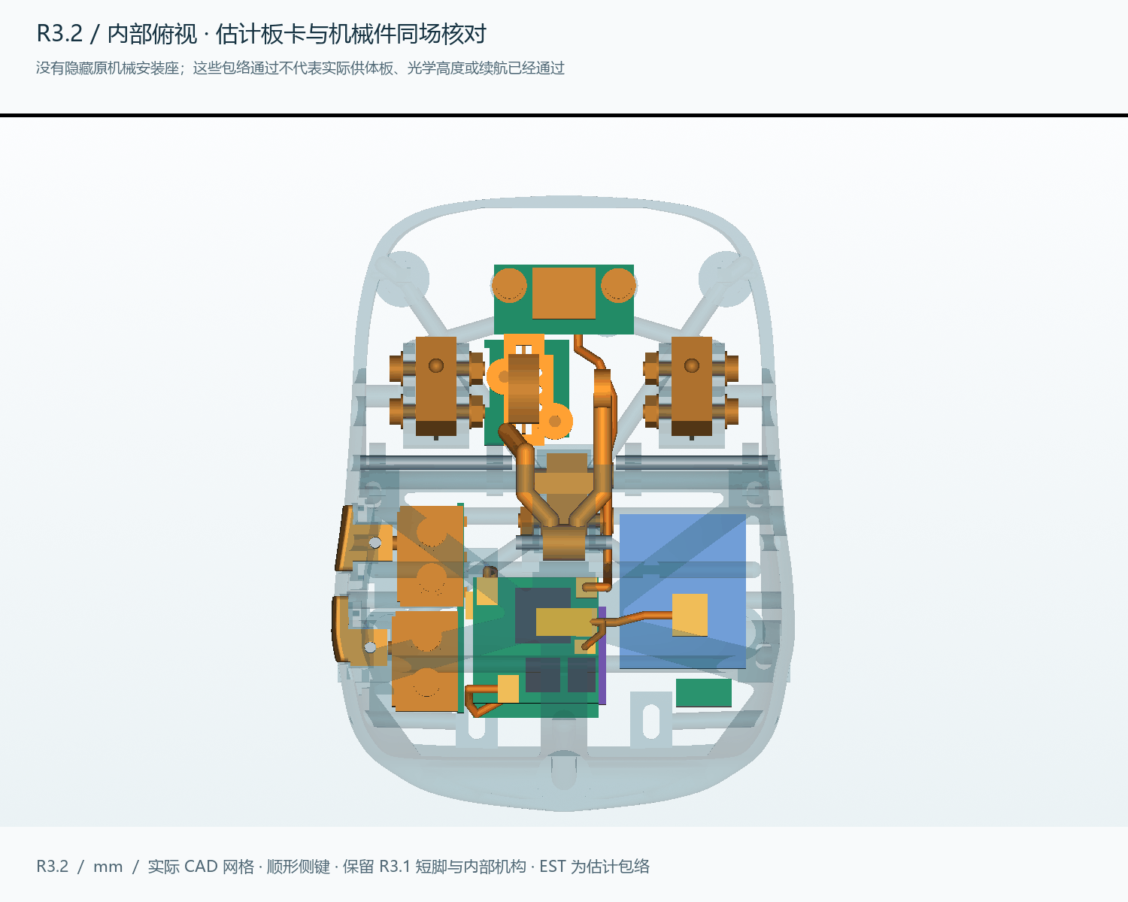
views/rebuild_r3_2/08_internal_top.png
