Quietmirror/github/views/rebuild_r3_2/10_side_detail.png

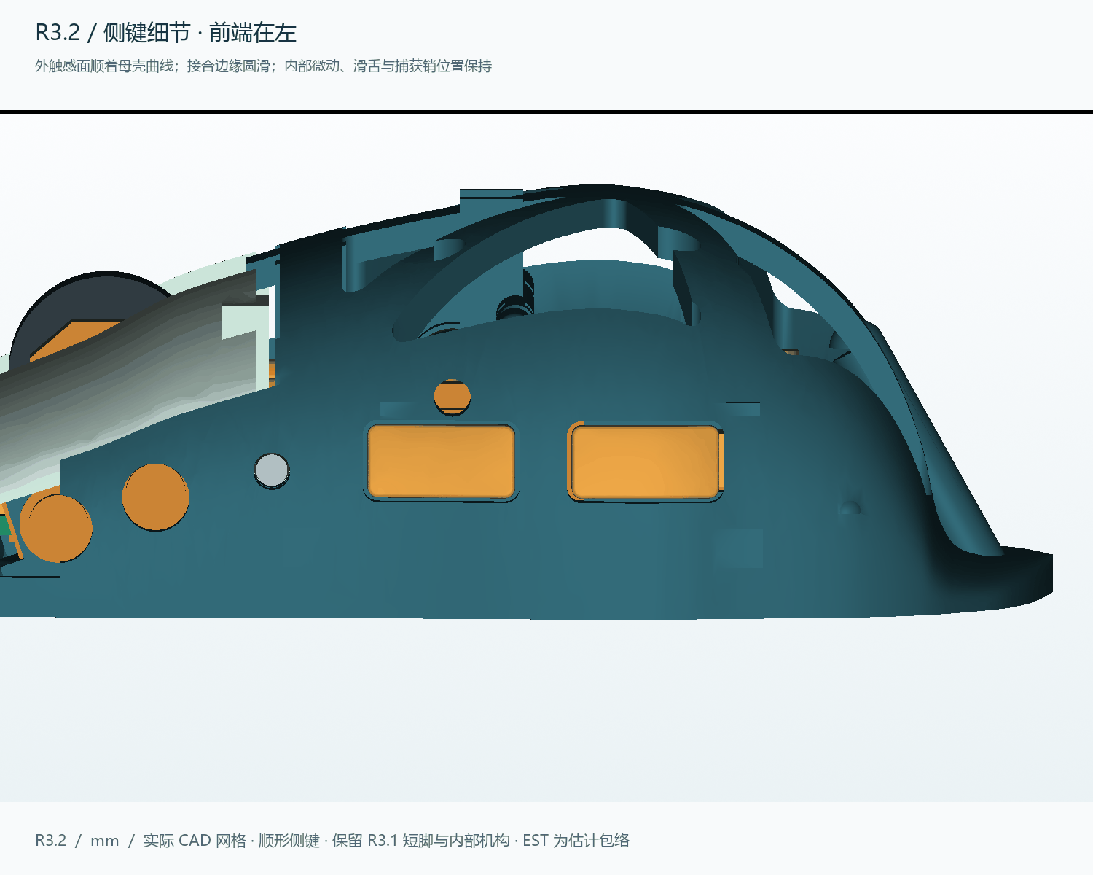
views/rebuild_r3_2/10_side_detail.png
