Quietmirror/github/views/rebuild_r3_3/R3_2_VS_R3_3.png

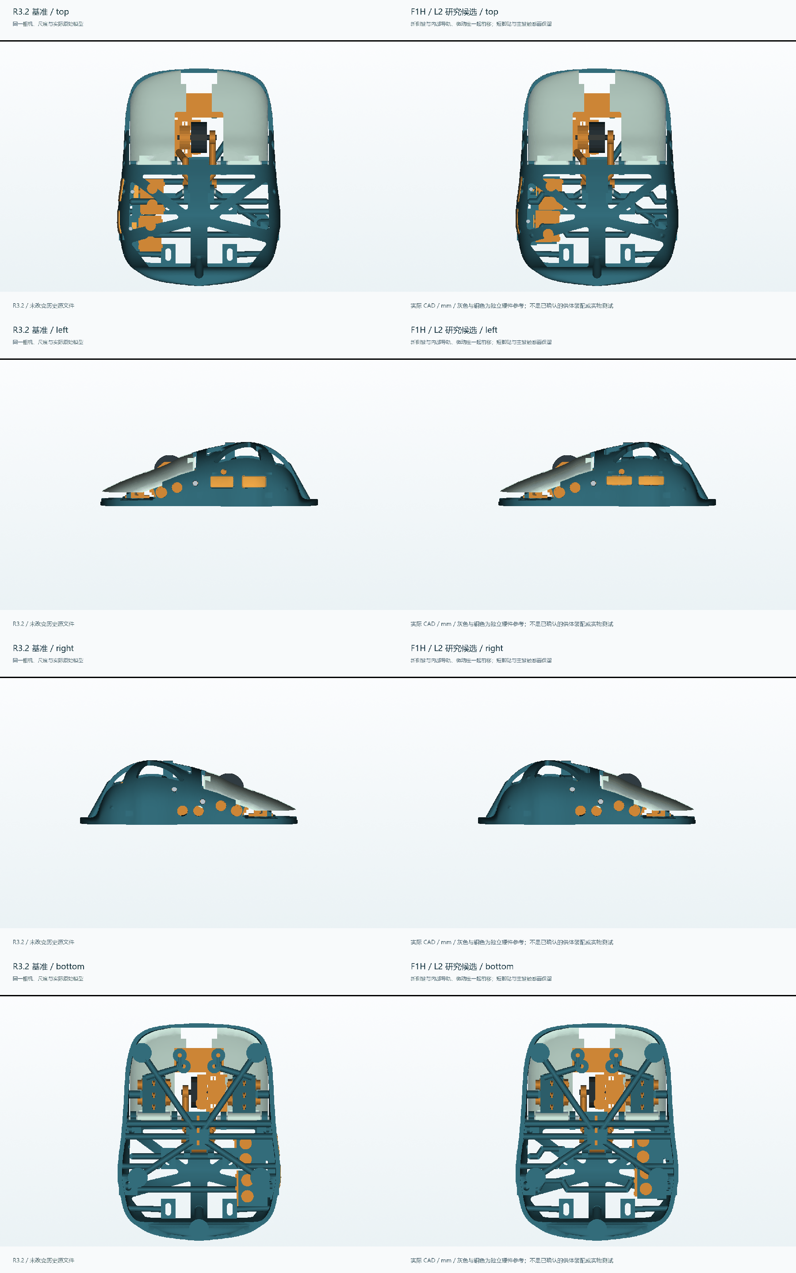
views/rebuild_r3_3/R3_2_VS_R3_3.png
