Quietmirror/github/reports/l2_revision/DONOR_A1PRO_MISSING_MEASUREMENTS.md

# ATK A1 Pro 待测尺寸

`DONOR_ID_UNVERIFIED / PCB_GEOMETRY_UNVERIFIED / FIT_NOT_CERTIFIED`。旧A1 Plus失败诊断不改名当作A1 Pro。当前36×50×1.2mm板仅是通用空间测量块，不是供体轮廓。

需要：底部铭牌及完整官方型号；PCB正反面带尺照片及外形DXF/STEP；板厚、每个孔坐标/孔径/禁布区；传感器真实型号与轴心；镜头基准面及推荐工作距离；最高元件与底部凸件；左右/侧微动型号、轴线、自由高/预行程/总行程；编码器轴高、六角尺寸、焊脚与中键位置；USB壳体、插头外包与拔插方向；电池容量、尺寸、质量、保护板、插头极性和线长；电源控制、天线净空、接收器和固件支持。

不能切PCB、剪天线、移除充电保护或私自取消原板零件来实现适配。真实板过大时，先考虑不同板型/分体方案；若必须改外壳，回到结构审核。
