Quietmirror/github/reports/l2_revision/PRINT_SLICING_VALIDATION.md

# 实际PLA单板切片

PrusaSlicer2.9.6；假定床250×210mm、0.4喷嘴、0.2层高、4墙、20%gyroid、210/60°C、4mm brim、snug支撑并允许模型上支撑。打印机型号未确认。所有塑料件独立、无缩放，.3mf自带完整配置，重新打开后不用外部--load再切片校验。

| 方案 | 件数 | PA12理论g | 净件PLA g | 支撑g | 边框g | 总PLA g | 估时 |
|---|---|---|---|---|---|---|---|
| F1H | 9 | 18.99951 | 23.69 | 13.70 | 0.61 | 37.99 | 4h 57m 55s |
| L2_H_EST | 11 | 19.74929 | 24.65 | 15.25 | 0.65 | 40.55 | 5h 17m 32s |
| L2_D_EST | 11 | 19.49544 | 24.32 | 14.26 | 0.65 | 39.24 | 5h 7m 29s |
| L2_BOTH_EST | 13 | 20.24522 | 25.28 | 15.84 | 0.70 | 41.82 | 5h 27m 56s |

耗材由真实G-code正挤出XY刀路按TYPE独立累加，与切片器页脚差小于0.15g；首个解析器曾漏读“.02919”这种省略整数位小数，已修正并重新统计。所有挤出中心线加半线宽在假定床内；一板通过只针对这个床与配置。

BODY保持正立、五脚朝下；五脚接触面比最低结构高0.2mm，已核对首层每个脚点下有支撑路径。主键顶面向上，侧键按导轨方向平放，滚轮轴竖直以减少六角轮廓失真。支撑主要在上壳、横梁、铰链/安装座、主键底部和适配托架。清除孔内支撑、测量后修孔；2.35mm轴孔、M2通孔、侧键导轨/触点、1.67mm六角都应先做公差小样测试，不能依靠0.02–0.06mm名义差直接装配。没有实际床型，不交付可直接上机的G-code；验证G-code留D盘缓存。H/D托架的直线装入检查未通过，当前3MF只证明能够一板切片，不代表整机可按图装成。
