Quietmirror/github/reports/rebuild_r2/FEM_BEAM_BENCHMARK.md

# FEM 求解器解析梁验证

实际运行 Gmsh 4.15.2 和 CalculiX 2.22；毫米、牛顿、MPa。40×4×4 mm 固支梁，E=1500 MPa、ν=0.35；端面面积积分施加 1 N 横向剪力及独立 10 N 轴向拉力。

| 网格 mm | 工况 | 计算位移 mm | 解析位移 mm | 误差 |
|---:|---|---:|---:|---:|
| 2 | cantilever_bending | 0.66320147 | 0.67206667 | 1.319% |
| 2 | axial_tension | 0.016583365 | 0.016666667 | 0.500% |
| 1.25 | cantilever_bending | 0.6645398 | 0.67206667 | 1.120% |
| 1.25 | axial_tension | 0.016589549 | 0.016666667 | 0.463% |

验收结果：**True**。细网格解析误差及两档位移变化 <5%；反力、力矩平衡相对误差 <0.01%。

解析式：轴向 FL/EA；横弯 FL³/(3EI)+FL/((5/6)GA)，G=E/(2(1+ν))。固支端局部三维约束与梁理论仍有小差异。

各次真实求解的输入、DAT 哈希、节点/单元数和具体平衡误差见 fem_beam_benchmark.json；原始作业位于 D 盘支持目录。
