Quietmirror/github/HISTORY_R3_2.md

# R3.2 history

Continues published R3.1 commit `6da50b486cf6549b28bb3457403a0967827825df`. Only the new revision directories and latest root README are added/updated. All prior CAD, exports, reports and releases are preserved, with the exact previous root page in README_R3_1.md.

The visible side caps follow the mother surface, become 9.4×4.6 mm, shift to Y49.3/Y62.3 and close their gap to 3.6 mm. BODY and both side caps are replaced together. Internal switch positions and the R3.1 short-foot datum are retained. See reports/rebuild_r3_2/README.md for finite validation scope and remaining physical-fit limits.
