Quietmirror/github/HISTORY_R3_1.md

# R3.1 history preservation

R3.1 adds new `cad`, `exports`, `reports`, `views` and `releases` paths. R3 and every earlier version remain unchanged. The old root README is preserved verbatim as `README_R3.md`; only the current root homepage changes. Only BODY geometry changes within five local foot regions.
