Quietmirror/github/HISTORY_R3.md

# R3 version preservation

R3 continues published R2 commit `c07ce1799f32c020c791f2cc08b835941a0c471f`. R2 source, generated releases, reports and views remain at their original paths. The exact R2 homepage is retained as `README_R2.md`. V0.1–V0.9 files, `README_V0.9.md`, the original history and the R1 unaccepted archive remain unchanged.

New work is isolated under `cad/rebuild_r3`, `reports/rebuild_r3`, `views/rebuild_r3`, `exports/rebuild_r3` and `releases/Fenrir-MiniSE-R3`. This is a mechanical/interference and estimated electronic-fit revision, not a new verified donor PCB or wireless product.
