Quietmirror/github/HISTORY_R3_3.md

# R3.3 / r3_3 — 2026-10-17

按用户指定名称，将此前公开的 L2 研究成果纳入 R3 系列并发布到默认分支 main。

- 新增 `cad/rebuild_r3_3`、`reports/rebuild_r3_3`、`exports/rebuild_r3_3`、`views/rebuild_r3_3` 和 `releases/Fenrir-MiniSE-R3.3`。
- 提供共用机械版、H 分体示意版、D 供体示意版与两套转接件合板；文件沿用既有几何和切片，不重新宣称验证通过。
- 源提交：`4bce8639f48f880ffa490caaed50b67829bd5343`。文件来源映射见发布目录 `R3_3_MANIFEST.json`。
- 仓库首页改为 R3.3；原 R3.2 首页保存为 `README_R3_2.md`。
- 既有 R3.2、此前历史及 L2 的 43 个候选归档继续保留。

原有未完成项目继续适用：减重目标、部分刚度工况、H 托架装入、D 实板核验、实物公差与电子功能测试。
