Quietmirror/github/reports/l2_revision/FEM_CONVERGENCE_AND_FAILURES.md

# 三维收敛、独立复核与失败记录

Gmsh4.15.2 / CalculiX2.22；C3D10，三个目标尺寸2.4/2.0/1.8mm。记录网格连通、积分点Jacobian、源STEP、输入deck和结果摘要。F1H最后两档刚度变化：顶部0.633%、夹持0.335%；P99变化0.945%和0.248%。顶刚度增幅约0.96%很小，处于网格差异量级，合理表述为基本保持；夹持约+6.84%是该夹具结果。

独立第二脚本直接在全部单元积分Bᵀσ和应变能，不依赖求解器显示的总反力，主要力/矩/能量相对误差约1e-8，门槛0.002。锚点交换与ν变化均另跑。次要LC5/LC7夹具若比基准降低，在SECOND_PASS_REVIEW中原样报告，不将全部工况概括为“提升”。

| 版本 | h | 工况 | k N/mm | 最大位移mm | P99 MPa | 峰值MPa |
|---|---|---|---|---|---|---|
| R32 | 2.4 | LC4_outer_back_press_5N | 121.02867 | 0.095287 | 0.58194 | 8.26546 |
| R32 | 2.4 | LC3_free_equilibrated_outer_grip_4N | 517.11378 | 0.020440 | 0.26802 | 1.51141 |
| R32 | 2.0 | LC4_outer_back_press_5N | 120.63980 | 0.095664 | 0.58924 | 4.46130 |
| R32 | 2.0 | LC3_free_equilibrated_outer_grip_4N | 514.13552 | 0.020258 | 0.26808 | 1.90340 |
| R32 | 1.8 | LC4_outer_back_press_5N | 120.42231 | 0.096120 | 0.59110 | 4.23693 |
| R32 | 1.8 | LC3_free_equilibrated_outer_grip_4N | 515.98197 | 0.020271 | 0.26720 | 2.03618 |
| F1H | 2.4 | LC4_outer_back_press_5N | 122.80505 | 0.086042 | 0.55700 | 5.80340 |
| F1H | 2.4 | LC3_free_equilibrated_outer_grip_4N | 551.11923 | 0.018164 | 0.26162 | 1.25838 |
| F1H | 2.0 | LC4_outer_back_press_5N | 122.34721 | 0.086851 | 0.55905 | 6.56436 |
| F1H | 2.0 | LC3_free_equilibrated_outer_grip_4N | 549.42035 | 0.017915 | 0.26229 | 1.56922 |
| F1H | 1.8 | LC4_outer_back_press_5N | 121.57804 | 0.087376 | 0.56438 | 4.58900 |
| F1H | 1.8 | LC3_free_equilibrated_outer_grip_4N | 551.26788 | 0.017968 | 0.26294 | 1.95402 |

历史失败包括：h1.3求解器访问冲突、早期细分多边形造成超大体网格、B2重合面、F1最初STL自交、横梁/螺栓干涉、旧装入路径碰撞。采用真实CAD修正、精确圆弧、必要的独立Gmsh表面剖分解决相应问题；未用补洞或删除分离体掩盖错误。压缩发布包保留候选差异，原始求解缓存留在D盘_support/work/l2。重新求解需要本地依赖及磁盘空间。
