Quietmirror/github/views/history_V0.1-V0.4.png

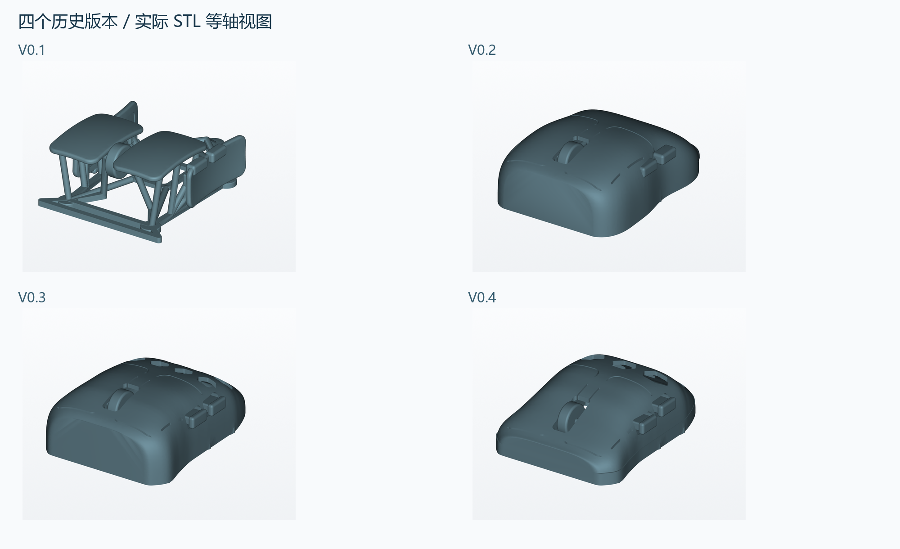
views/history_V0.1-V0.4.png
