Quietmirror/github/(commit log)

2026-10-14 Publish right-hand fingertip mouse V0.2 continuous-shell prototype
    Add printable STL, STEP, 3MF, parametric CadQuery sources, original CAD renders, design rationale, source/license review, electronic estimate envelopes and measured geometry/slicing reports. Preserve the V0.1 skeletal study for comparison.
    V0.2: nominal 90 x 62 x 31 mm, measured mid-grip 54.04 mm, one watertight connected mesh with zero detected self-intersections and five coplanar skate platforms. PLA body estimate 25.85 g; fit and electronics remain unverified physically.
    [electronic_envelopes_ESTIMATES.step, electronic_envelopes_V0.2_ESTIMATES.step, quietmirror_fingertip_V0.1.step, quietmirror_fingertip_V0.1.stl, quietmirror_fingertip_V0.1_PRINT.3mf, quietmirror_fingertip_V0.2.step, quietmirror_fingertip_V0.2.stl, quietmirror_fingertip_V0.2_PRINT.3mf]
2026-10-14 Add V0.3 flatter grip sides, vented rear shell and separate side caps
    Include verified STL/STEP/3MF models, parametric CadQuery source, actual renderings, assembly clearance checks and Chinese design/printing documentation. Preserve V0.1 and V0.2.
    [electronic_envelopes_V0.3_ESTIMATES.step, quietmirror_fingertip_V0.3_FIT.step, quietmirror_fingertip_V0.3_FIT.stl, quietmirror_fingertip_V0.3_PRINT.3mf, quietmirror_fingertip_V0.3_SHELL.step, quietmirror_fingertip_V0.3_SHELL.stl, side_button_1_V0.3_PRINT.step, side_button_1_V0.3_PRINT.stl]
2026-10-14 新增 Fenrir 参考 V0.4，保留 V0.3 底部并整理全部历史版本
    [electronic_envelopes_V0.4_ESTIMATES.step, quietmirror_fingertip_V0.4_FIT.step, quietmirror_fingertip_V0.4_FIT.stl, quietmirror_fingertip_V0.4_PRINT.3mf, quietmirror_fingertip_V0.4_SHELL.step, quietmirror_fingertip_V0.4_SHELL.stl, side_button_1_V0.4_PRINT.step, side_button_1_V0.4_PRINT.stl]
2026-10-14 V0.5：10 孔镜像布局与 2.2 mm 细筋，保留底部和全部历史版本
    [electronic_envelopes_V0.5_ESTIMATES.step, quietmirror_fingertip_V0.5_FIT.step, quietmirror_fingertip_V0.5_FIT.stl, quietmirror_fingertip_V0.5_PRINT.3mf, quietmirror_fingertip_V0.5_SHELL.step, quietmirror_fingertip_V0.5_SHELL.stl, side_button_1_V0.5_PRINT.step, side_button_1_V0.5_PRINT.stl]
2026-10-15 Add V0.6 symmetric mouse shell and two estimated electronics assemblies
    Rebuild the five-foot base without an external lip, fit twelve mirrored vents to the shell contour, add central charge and power-switch openings, and provide ATK A1 Plus and PAW3950 layout studies.
    Include editable CAD, validated STL/STEP/3MF, rendered views, print estimates, functional requirements and a conditional 12-hour power budget. Preserve V0.1 through V0.5 artifacts.
    [MCU_RF_EST.stl, RF_board_EST.stl, RF_harness_EST.stl, USB_C_EST.stl, USB_harness_EST.stl, USB_plug_insertion_EST.stl, antenna_keepout_EST.stl, battery_500mAh_TARGET.stl]
2026-10-15 Add V0.7 movable mouse test kit and electronics layout studies
    Shrink main buttons, add mirrored front vents and slim thumb keys. Deliver 20 printable mechanical parts, wheel detent and switch trays, with STEP/STL/3MF sources and validation. Preserve the V0.6 bottom and all earlier assets; document estimated electronics conflicts and FreeCAD workflow.
    [AXLE.step, AXLE.stl, AXLE_TEST.step, AXLE_TEST.stl, AXLE_WASHER.step, AXLE_WASHER.stl, BODY.step, BODY.stl]
2026-10-15 V0.8: open-front full-width keys, flush Fenrir-style side buttons and trimmed base
    Restore 23 x 27 mm main keys, move the side buttons 3 mm forward, recess their guide structure and trim only protruding lower framework. Add internal assembly reliefs and retain the five skate platforms and lower functional interfaces.
    Ship the 20-part mechanical test kit, two explicitly estimated electronic configurations, editable CAD, STEP/STL/3MF, rendered views, slicer estimates and assembly documentation. Validate saved mesh topology, static intersections, sampled button and insertion paths, wheel rotation, mirror symmetry and the retained base. Preserve V0.1-V0.7 assets.
    [AXLE.step, AXLE.stl, AXLE_TEST.step, AXLE_TEST.stl, AXLE_WASHER.step, AXLE_WASHER.stl, BODY.stl, CLEARANCE_COUPON.step]
2026-10-15 Add V0.9 flush front keys and triangular mouse shell
    Preserve 23 x 27 mm main-key footprints and the V0.8 bottom interfaces while lowering the shell and narrowing the triangular lattice. Include printable parts, editable CAD, three STEP assembly packages, drawings, clearance and motion checks, and slicer estimates. Keep V0.1-V0.8 history intact.
    [AXLE.step, AXLE.stl, AXLE_TEST.step, AXLE_TEST.stl, AXLE_WASHER.step, AXLE_WASHER.stl, BODY.stl, CLEARANCE_COUPON.step]
2026-10-16 Add Fenrir MiniSE R2 mechanical prototype and verified print artifacts
    Publish editable CAD, nine print parts, STEP/FreeCAD/3MF, assembly views and bounded geometry/motion checks. Include actual slicing and FEM results with the unconverged peak-stress gate stated explicitly. Preserve V0.1-V0.9 and archive the unaccepted upstream R1 snapshot.
    [FENRIR_MINISE_R2.FCStd, FENRIR_MINISE_R2_PLA_PRINT_PLATE.3mf]
2026-10-16 Add R3 mechanical interference fixes and bounded electronics fit audit
    Correct projected actuator travel, add encoder and USB mounting interfaces, and validate static, sampled motion and mechanical insertion clearance. Publish reproducible source, printable meshes, CAD scenes and detailed compatibility limits while preserving all historical versions.
    [BODY.stl, FENRIR_MINISE_R3.FCStd, FENRIR_MINISE_R3_PLA_PRINT_PLATE.3mf, LEFT_KEY.stl, RIGHT_KEY.stl, SIDE_FRONT_KEY.stl, SIDE_FRONT_KEY_SWITCH_CLAMP.stl, SIDE_REAR_KEY.stl]
2026-10-16 Shorten five skate supports to the lens reservation datum (R3.1)
    Raise the five 8 mm bonding lands by 5.2 mm to match the reserved lower plane while preserving the other 71 mechanical parts. Include checked CAD/STL, three STEP scenes, native FreeCAD, slicing and ground-clearance evidence, source and documentation. Preserve all historical versions.
    [BODY.stl, FENRIR_MINISE_R3_1.FCStd, FENRIR_MINISE_R3_1_PLA_PRINT_PLATE.3mf, LEFT_KEY.stl, RIGHT_KEY.stl, SIDE_FRONT_KEY.stl, SIDE_FRONT_KEY_SWITCH_CLAMP.stl, SIDE_REAR_KEY.stl]
2026-10-16 Release R3.2: contoured compact side keys with verified assembly paths
    Reduce visible side caps to 9.4 x 4.6 mm, move centers to Y49.3/Y62.3 and narrow their gap to 3.6 mm. Retain the R3.1 foot datum and switch interfaces. Include reproducible CAD, STL/STEP/FreeCAD/3MF, finite validation and installation notes. Preserve all earlier versions.
    [BODY.stl, FENRIR_MINISE_R3_2.FCStd, FENRIR_MINISE_R3_2_PLA_PRINT_PLATE.3mf, LEFT_KEY.stl, RIGHT_KEY.stl, SIDE_FRONT_KEY.stl, SIDE_FRONT_KEY_SWITCH_CLAMP.stl, SIDE_REAR_KEY.stl]
2026-10-17 Start L2 study with audited mass ledger and reproducible 3D comparisons
    Adopt the supplied master specification on an isolated branch. Preserve R3.2 and all historical files. Include new candidate generators, independent CAD partitioning, conforming 2D proxy, verified solver benchmark, three-level BODY and key comparisons, and explicit rejected-candidate records. This checkpoint is research in progress; no common-shell freeze, hardware fit or 14.89 g completion claim.
2026-10-17 Deliver L2 research CAD, H/D estimated layouts, slicing evidence and full candidate history
    Preserve R3.2/main. Record unmet 14.89 g target, secondary fixture stiffness losses, H carrier insertion blockers and unverified A1 Pro donor interference. Include reproducible sources, native assemblies, independent parts, actual single-plate slices and recoverable historical CAD.
    [A_B_C_D_VOLUME_BUDGET.csv, BOM.csv, BOTH_ADAPTER_KITS_SINGLE_PLATE.3mf, COMMON_ALL_PARTS_SINGLE_PLATE.3mf, D_ALL_PARTS_SINGLE_PLATE.3mf, FULL_ASSEMBLY_COMMON.FCStd, FULL_ASSEMBLY_D.FCStd, FULL_ASSEMBLY_H.FCStd]
2026-10-17 Publish r3_3 in the standard R3 version layout
    Promote the existing L2 research artifacts to R3.3 directories and the default repository home page. Keep original geometry, all engineering limitations, source provenance, R3.2 and earlier history. Add conventional CAD/STL/STEP/3MF downloads and version packaging checks.
    [BODY.stl, D_REMOVABLE_CARRIER_EST.stl, D_SENSOR_SEAT_EST.stl, FENRIR_MINISE_R3_3.FCStd, FENRIR_MINISE_R3_3_D_EST.FCStd, FENRIR_MINISE_R3_3_D_EST_PLA_PRINT_PLATE.3mf, FENRIR_MINISE_R3_3_H_EST.FCStd, FENRIR_MINISE_R3_3_H_EST_PLA_PRINT_PLATE.3mf]
